MattdewT/KE3/Grafik Abschätzung Gweichtskraft.jpg

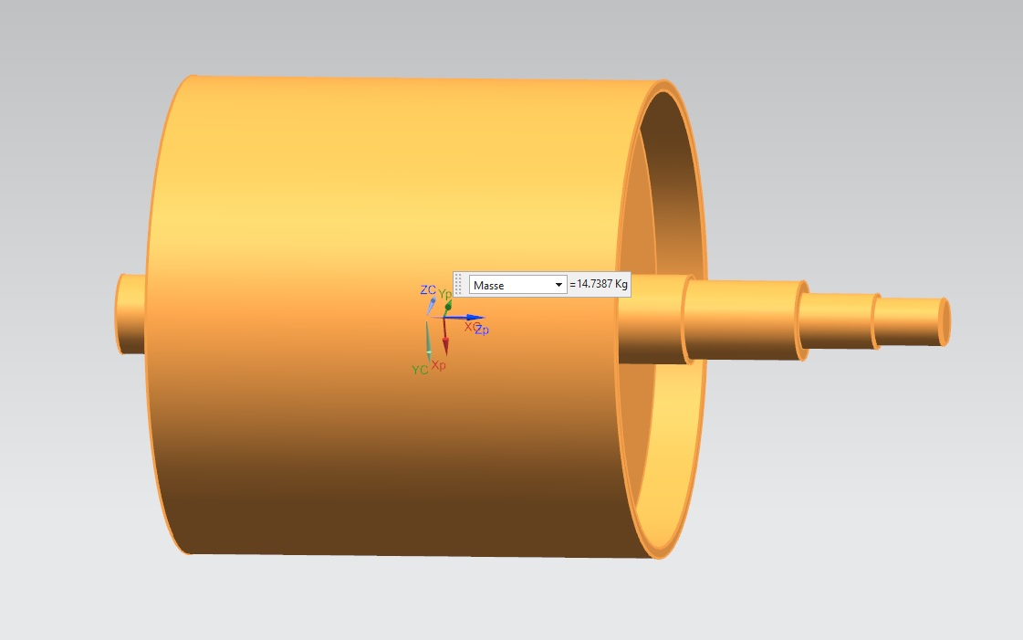
Grafik Abschätzung Gweichtskraft.jpg
