MattdewT/KE3/IMG_20191128_125835.jpg

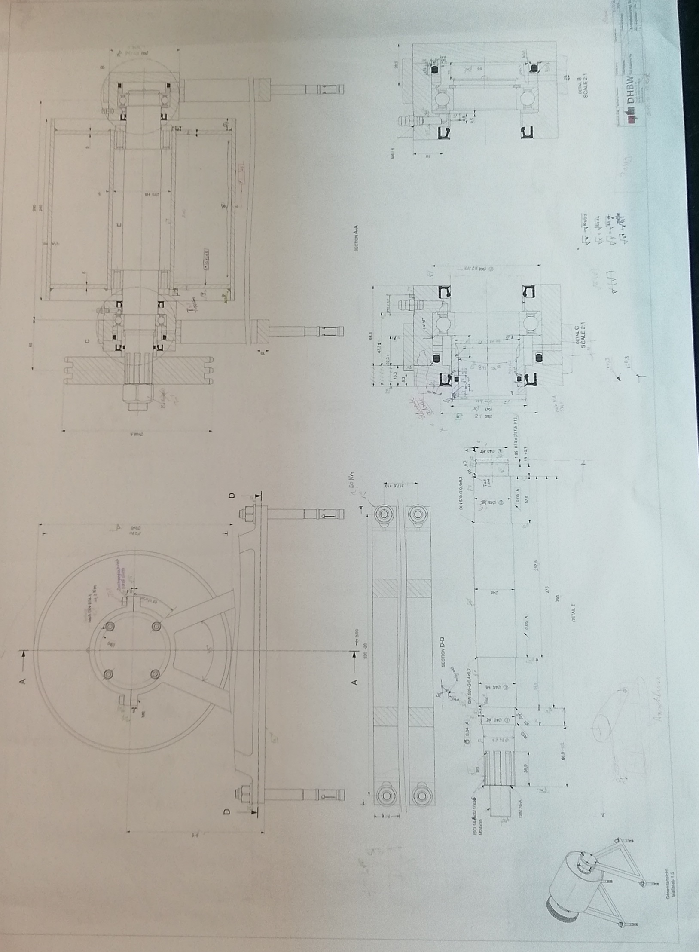
IMG_20191128_125835.jpg
