MattdewT/KE3/Datenblatt.docx

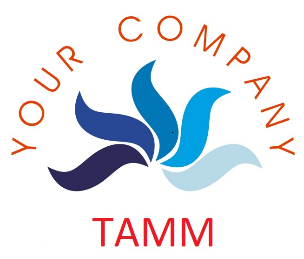
[picture p33: figure]

Antriebsrolle für Förderbänder

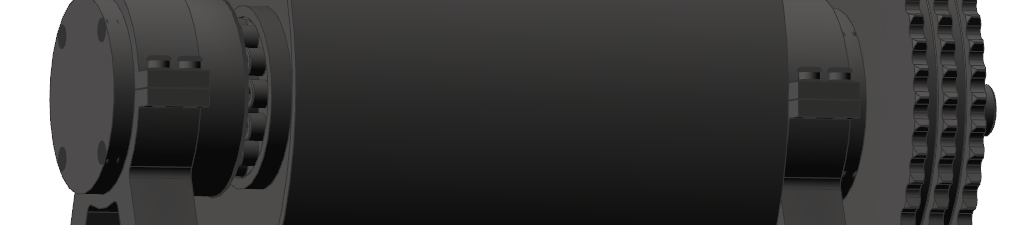
[picture p34: figure]

Kompakt. Leicht. Preiswert.

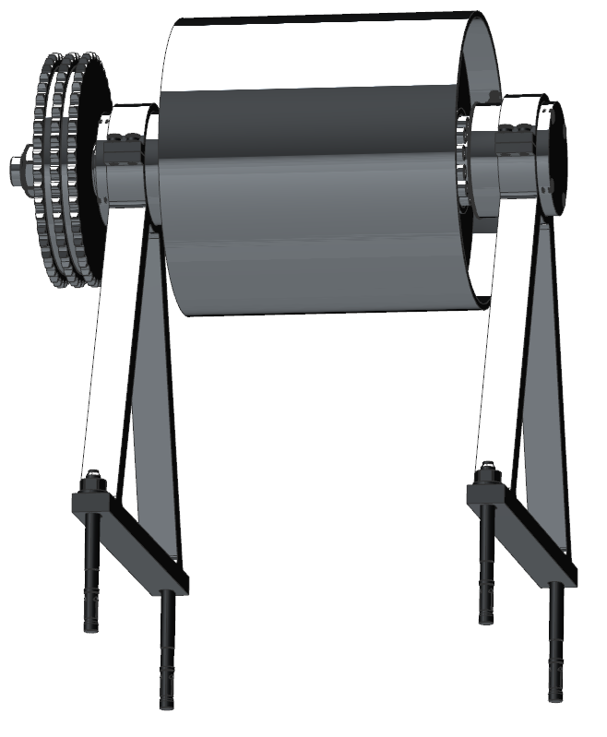
[picture p35: figure]

Antriebsrolle

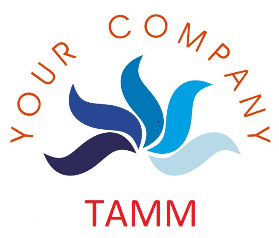
[picture p36: figure]

Eigenschaften

Die Antriebsrolle ist als Variante verfügbar, bei welcher die Verbindung zwischen Welle und Trommel geschweißt ist an und als Variante, bei der die Verbindung zwischen Welle und Trommel über einen Spannpressverband realisiert wird.

Der Antrieb erfolgt durch einen Getriebemotor und die Übersetzung auf die Antriebswelle erfolgt über einen Dreifach-Kettentrieb.

Explosionsansicht

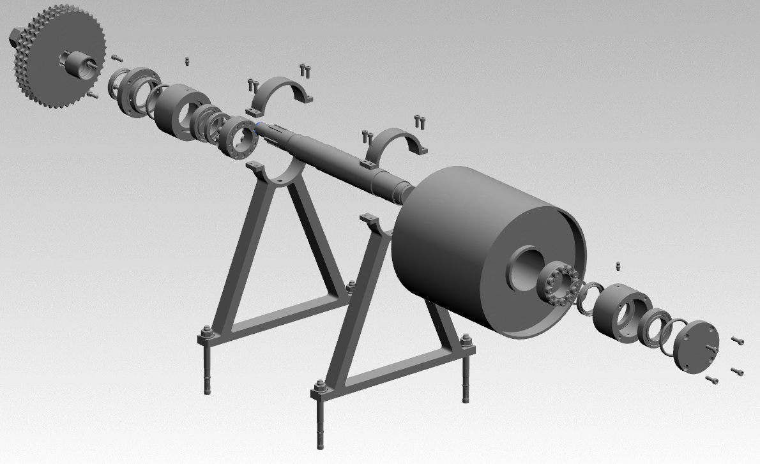
[picture p37: figure]

Technische Daten
Fördererbreite B | 240 mm
Höhe der Antriebstrommel | Mindestens 300mm
Antrieb | Drehstrom
| Drehzahl n=80 1/min
| Dreifach-Kettentrieb
Stromverbrauch | 4kWh | Netzbetrieb
Schmierung | Fett | Kompletter Fettwechsel möglich
Lebensdauer | Mind. 30000h
Motorausrichtung | 45°-Winkel zum Band | Standardmäßig außen, auf Wunsch auch innen
Produkt Gewicht | M = 37,736kg für Spannpressverband, M = 34,738kg für Schweißkonstruktion
Motor | Stufenloser Getriebemotor

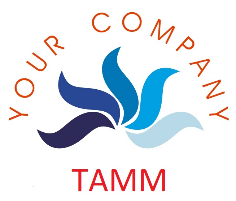
[picture p38: figure]

Marienstraße 20
89518 Heidenheim

www.TAMM-group.com

info@TAMM-group.com
