MattdewT/KE3/Grafiken.pptx

## Slide 2

LI=65

LII=160

LIII=65

LIV=65

FAY

FBY

FKY

y

x

FZUG1

FZUG2

## Slide 3

FS1

R = 120

FK

r = 92

z

y

FS2

## Slide 4

LI=65

LII=160

LIII=65

LIV=65

Z

x

FAZ

FG

FG

FBZ

FKZ

## Slide 5

LI=65

T1=0Nm

LII=160

T2=120Nm

LIII=65

LIV=65

T3=T4=
240Nm

## Slide 6

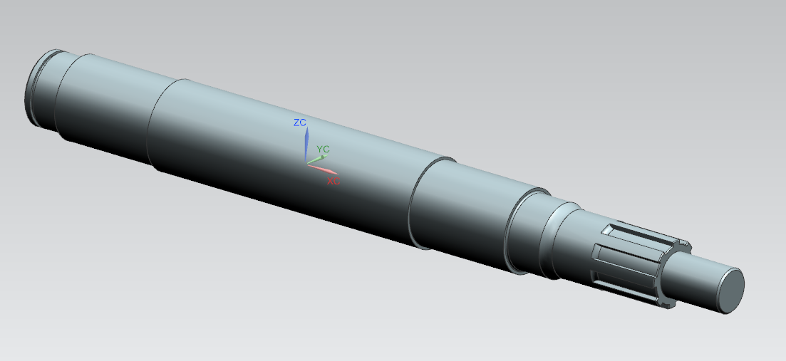
[picture p39: figure]

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
## Slide 7

80mm

φ

0,15mm

## Slide 8

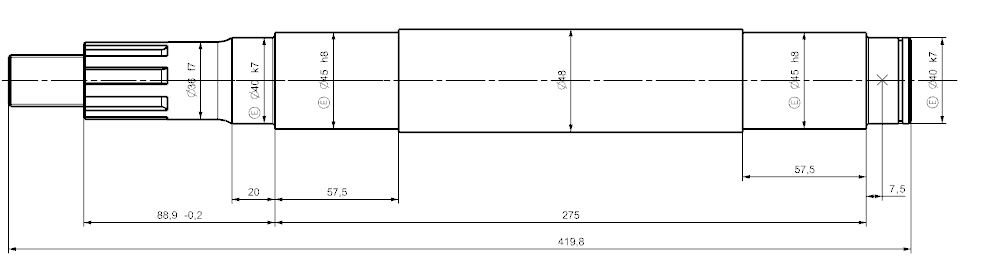
[picture p40: figure]

A

## Slide 9

LI=65

LII=160

LIII=65

LIV=65

III

IV

I

II

## Slide 10

LI=65

LII=160

LIII=65

LIV=65

I

II

III

IV

## Slide 11

Motorwelle
Passfeder
Motorkettenrad
Dreifachrollenkette
Wellenkettenrad
Keilwelle
Welle
Schweißverbindung
Spannpressverband
äußere Schweißnaht
Trommel
