MattdewT/KE3/Kerbzahlberechnung.docx

Kerbzahlberechnung

Kerbstelle 1 (links von A), Sicherungsringnut (DIN 471 - 40 x 1,75),

s=-7,5

d=37,5mm

D=40mm

s_(Sicherungsring) =1,75mm

t=(D-d)/2=1,25mm

ϱ≈0,1s=0,175mm

Formzahl α_(k,b) für Biegung nach Decker Tab. 15.3

α_(k,b) =1,14+1,08√((10t)/(s_(Sicherungsring)))=1,14+1,08√((10∙1,25mm)/(1,75mm))

α_(k,b) =4,03

Formzahl α_(k,t) für Torsion nach Decker Tab. 15.3

α_(k,t) =1,48+0,45√((10t)/(s_(Sicherungsring)))=1,48+0,45√((10∙1,25mm)/(1,75mm))

α_(k,t) =2,68

Bezogenes Spannungsgefälle in Strängen mit Biegebeanspruchung (Decker Formel 15.12)

Bei Scharfkantige Kerben wird χ=0,25 gewählt.

χ=4/(D+d)+2/ϱ

=4/(40+37,5)+2/(0,25)

χ=8,05

Stützziffer η_χ nach Siebel mit Re=650N/(mm^2) (Decker Bild 15.12)

⇒ η_(χBiegung) =1,24

Bezogenes Spannungsgefälle in Strängen mit Torsionsbeanspruchung (Decker Formel 15.13)

χ=4/(D+d)+1/ϱ

=4/(40+37,5)+1/(0,25)

χ= 4,05

Stützziffer η_χ nach Siebel mit Re=650N/(mm^2) (Decker Bild 15.12)

⇒ η_(χTorsion) = 1,19

Kerbwirkungszahl βk,b nach Decker Formel 15.14

β_(k,b) =(α_(k,b))/(η_(χBiegung))=(4,03)/(1,24)

β_(k,b) =3,25

Kerbwirkungszahl βk,t nach Decker Formel 15.14

β_(k,t) =(α_(k,t))/(η_(χTorsion))=(2,68)/(1,19)

β_(k,t) =2,25

Kerbstelle 2 (Übergang Lager A)

s=7,5mm

r=0,8

d=40mm

D=45mm

t=(D-d)/2=2,5mm

Formzahl α_(k,b) für Biegung nach Decker Tab. 1.13

α_(k,b) =(1+1)/(√(0,62r/t+11,6r/d(1+2r/d)^2 +0,2(r/t)^3 d/D))

α_(k,b) =(1+1)/(√(0,62(0,8)/(2,5)+11,6(0,8)/40(1+2(0,8)/40)^2 +0,2((0,8)/(2,5))^3 40/45))

α_(k,b) = 2,96

Formzahl α_(k,t) für Biegung nach Decker Tab. 1.13

α_(k,t) =(1+1)/(√(3,4r/t+38r/d(1+2r/d)^2 +1,0(r/t)^2 d/D))

α_(k,t) =(1+1)/(√(3,4(0,8)/(2,5)+38(0,8)/40(1+2(0,8)/40)^2 +1,0((0,8)/(2,5))^2 40/45))

α_(k,t) = 1,89

Bezogenes Spannungsgefälle in Strängen mit Biegebeanspruchung (Decker Formel 15.12)

χ=4/(D+d)+2/ϱ

=4/(45+40)+2/(0,8)

χ=2,55

Stützziffer η_χ nach Siebel mit Re=650N/(mm^2) (Decker Bild 15.12)

⇒ η_(χBiegung) =1,15

Bezogenes Spannungsgefälle in Strängen mit Torsionsbeanspruchung (Decker Formel 15.13)

χ=4/(D+d)+2/ϱ

=4/(45+40)+1/(0,8)

χ=1,30

Stützziffer η_χ nach Siebel mit Re=650N/(mm^2) (Decker Bild 15.12)

⇒ η_(χTorsion) =1,10

Kerbwirkungszahl βk,b nach Decker Formel 15.14

β_(k,b) =(α_(k,b))/(η_(χBiegung))=(2,96)/(1,15)

β_(k,b) =2,57

Kerbwirkungszahl βk,t nach Decker Formel 15.14

β_(k,t) =(α_(k,t))/(η_(χTorsion))=(1,89)/(1,30)

β_(k,t) =1,45

Kritischer Querschnitt 3 (Absatz als Anlagefläche der Seitenwand ) Freistich

Wegen Spannsatz wird Freistichform G gewählt.

r = 0,4

f = 0,9

d=45mm

D=48mm

s=65mm

Formzahlen aus Decker Tab.15.3 Nr.7

α_(kb) =1,7

α_(kt) =1,4

Bezogenes Spannungsgefälle in Strängen mit Biegebeanspruchung (Decker Formel 15.12)

χ=4/(D+d)+2/ϱ

=4/(48+45)+2/(0,4)

χ=5,04

Stützziffer η_χ nach Siebel mit Re=650N/(mm^2) (Decker Bild 15.12)

⇒ η_(χBiegung) =1,21

Bezogenes Spannungsgefälle in Strängen mit Torsionsbeanspruchung (Decker Formel 15.13)

χ=4/(D+d)+2/ϱ

=4/(48+45)+1/(0,4)

χ=2,54

Stützziffer η_χ nach Siebel mit Re=650N/(mm^2) (Decker Bild 15.12)

⇒ η_(χTorsion) =1,15

Kerbwirkungszahl βk,b nach Decker Formel 15.14

β_(k,b) =(α_(k,b))/(η_(χBiegung))=(1,7)/(1,21)

β_(k,b) =1,40

Kerbwirkungszahl βk,t nach Decker Formel 15.14

β_(k,t) =(α_(k,t))/(η_(χTorsion))=(1,4)/(1,15)

β_(k,t) =1,21

Kritischer Querschnitt 4 (Mitte zwischen den beiden Lagern)

s=145mm

d=48mm

Keine Kerbwirkung, da glatte Welle

α_(k,b) =α_(k,t) =β_(k,b) =β_(k,t) =1

Kritischer Querschnitt 5 (Absatz als Anlagefläche der Seitenwand)

s=225mm

d=45mm

Kerbzahlen entsprechen denen des Kritischen Querschnitt 3, da dieselbe Geometrie vorliegt

α_(k,b) =1,7

α_(k,t) =1,4

β_(k,b) =1,40

β_(k,t) =1,21

Kritischer Querschnitt 6 (Übergang Lager B)

s=282,5mm

Kerbzahlen entsprechen denen des Kritischen Querschnitt 2, da dieselbe Geometrie vorliegt

α_(k,b) =2,96

α_(k,t) =1,89

β_(k,b) =2,57

β_(k,t) =1,45

Kritischer Querschnitt 7 (Übergang Keilwelle)

s=302,5mm

d=34mm

D=40mm

ϱ=3mm

t=(D-d)/2=3mm

Formzahl α_(k,b) für Biegung nach Decker Tab. 1.13

α_(k,b) =(1+1)/(√(0,62r/t+11,6r/d(1+2r/d)^2 +0,2(r/t)^3 d/D))

α_(k,b) =(1+1)/(√(0,623/3+11,63/34(1+23/34)^2 +0,2(3/3)^3 34/40))

α_(k,b) = 1,35

Formzahl α_(k,t) für Biegung nach Decker Tab. 1.13

α_(k,t) =(1+1)/(√(3,4r/t+38r/d(1+2r/d)^2 +1,0(r/t)^2 d/D))

α_(k,t) =(1+1)/(√(3,43/3+383/34(1+23/34)^2 +1,0(3/3)^2 34/40))

α_(k,t) =0,67

Bezogenes Spannungsgefälle in Strängen mit Biegebeanspruchung (Decker Formel 15.12)

χ=4/(D+d)+2/ϱ

=4/(40mm+34mm)+2/(12mm)

χ=0,22

Stützziffer η_χ nach Siebel mit Re=650N/(mm^2) (Decker Bild 15.12)

⇒ η_(χBiegung) =1,05

Bezogenes Spannungsgefälle in Strängen mit Torsionsbeanspruchung (Decker Formel 15.13)

χ=4/(D+d)+1/ϱ

=4/(40mm+34mm)+1/(12mm)

χ= 0,14

Stützziffer η_χ nach Siebel mit Re=650N/(mm^2) (Decker Bild 15.12)

⇒ η_(χTorsion) =1,02

Kerbwirkungszahl βk,b nach Decker Formel 15.14

β_(k,b) =(α_(k,b))/(η_(χBiegung))=(1,35)/(1,05)

β_(k,b) =4

Kerbwirkungszahl βk,t nach Decker Formel 15.14

β_(k,t) =(α_(k,t))/(η_(χTorsion))=()/(1,02)

β_(k,t) =3,53

Kritischer Querschnitt 8 (Keilwellen Beginn)

Nach Decker, Tab. 15.3 gelten für eine Keilwelle folgende Formzahlen:

s=322,5mm

α_(k,b) =4,2

α_(k,t) =3,6

d=28mm

D=34mm

ϱ=0,25mm

Bezogenes Spannungsgefälle in Strängen mit Biegebeanspruchung (Decker Formel 15.12)

χ=4/(D+d)+2/ϱ

=4/(34mm+28mm)+2/(0,25mm)

χ=8,06

Stützziffer η_χ nach Siebel mit Re=650N/(mm^2) (Decker Bild 15.12)

⇒ η_(χBiegung) =1,24

Bezogenes Spannungsgefälle in Strängen mit Torsionsbeanspruchung (Decker Formel 15.13)

χ=4/(D+d)+1/ϱ

=4/(34mm+28mm)+1/(0,25mm)

χ= 4,06

Stützziffer η_χ nach Siebel mit Re=650N/(mm^2) (Decker Bild 15.12)

⇒ η_(χTorsion) =1,19

Kerbwirkungszahl βk,b nach Decker Formel 15.14

β_(k,b) =(α_(k,b))/(η_(χBiegung))=(4,2)/(1,24)

β_(k,b) =3,39

Kerbwirkungszahl βk,t nach Decker Formel 15.14

β_(k,t) =(α_(k,t))/(η_(χTorsion))=(3,6)/(1,19)

β_(k,t) =3,03

→Wahl einer anderen Keilwelle mit größerem tragendem Querschnitt!!!

DIN ISO 14 Leichte Reihe, 8x32x36, Wahl eines anderen Werkstoffes mit höherer Festigkeit, Beginn des Keilwellenabschnitts weiter von Lager A entfernt

Nach Decker, Tab. 15.3 gelten für eine Keilwelle folgende Formzahlen:

s=332,5mm

α_(k,b) =4,2

α_(k,t) =3,6

d=32mm

D=36mm

ϱ=0,25mm

Bezogenes Spannungsgefälle in Strängen mit Biegebeanspruchung (Decker Formel 15.12)

χ=4/(D+d)+2/ϱ

=4/(36mm+32mm)+2/(0,25mm)

χ=8,06

Stützziffer η_χ nach Siebel mit Re=960N/(mm^2) (Decker Bild 15.12)

⇒ η_(χBiegung) =1,09

Bezogenes Spannungsgefälle in Strängen mit Torsionsbeanspruchung (Decker Formel 15.13)

χ=4/(D+d)+1/ϱ

=4/(36mm+32mm)+1/(0,25mm)

χ= 4,06

Stützziffer η_χ nach Siebel mit Re=960N/(mm^2) (Decker Bild 15.12)

⇒ η_(χTorsion) =1,08

Kerbwirkungszahl βk,b nach Decker Formel 15.14

β_(k,b) =(α_(k,b))/(η_(χBiegung))=(4,2)/(1,09)

β_(k,b) =3,85

Kerbwirkungszahl βk,t nach Decker Formel 15.14

β_(k,t) =(α_(k,t))/(η_(χTorsion))=(3,6)/(1,08)

β_(k,t) =3,33

Kerbstelle 9 (Keilwelle-Gewinde)

Keine Torsion und keine Biegung vorhanden. Deshalb wird Kerbstelle 8 nicht berücksichtigt.
