MattdewT/KE3/Wellen Berechnung.docx

## Wellen Berechnung

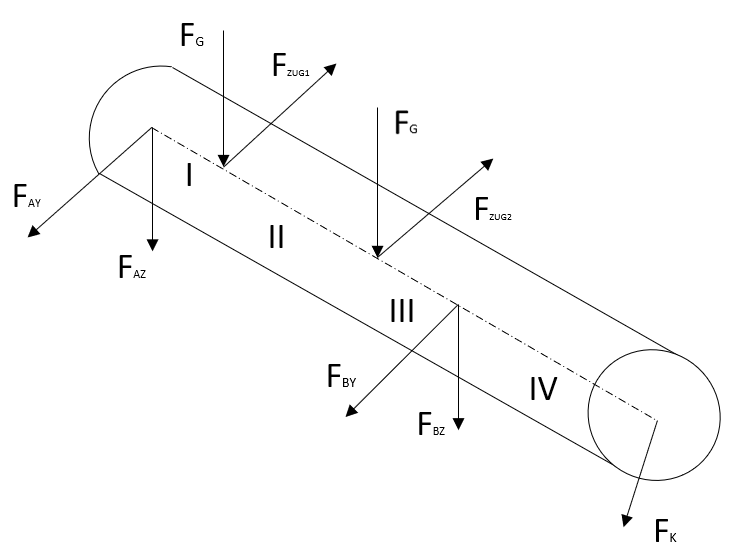
[picture p41: figure]

Berechnung der Kräfte von der Trommel:

F_(ZUG1/2) =(F_(S1) -F_(S2))/2

F_(ZUG1/2) =(3500N-1500N)/2=2500N

Berechnung der Kettenkräfte in Y- und Z-Richtung:

F_(KY) =sinα*F_K

F_(KY) =sin45°*2608,7N=1844,6N

Da α=45° ist, ist F_(KY) =F_(KZ) =1844,6N .

Berechnungen in der X-Y-Ebene

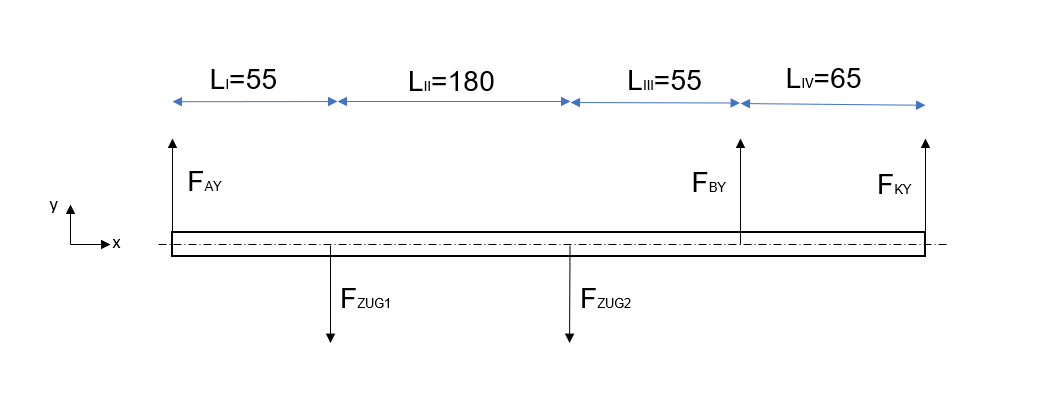
[picture p42: figure]

Berechnung von F_(BY) über Momenten Gleichung:

∑ M=0

Es wird nach links um das Lager A gedreht:

A: F_(ZUG1) *l_I +F_(ZUG2) *l_(I+II) -(F_(BY) *l_(I+II+III) )-(F_(KY) *l_(I+II+III+IV) )=0

F_(BY) =(F_(ZUG1) *55mm+F_(ZUG2) *230mm-(F_(KY) *355))/(290mm)

F_(BY) =(2500N*55mm+2500N*235mm-(1844,6N*355mm))/(290mm)

F_(BY) =242N

Berechnung von F_(AY) über Kräfte Gleichgewicht:

∑ F_Y =0

Kräftegleichgewicht soll nach oben (nach Skizze) wirken:

↑: -F_(AY) +F_(ZUG1) +F_(ZUG2) -F_(BY) -F_K =0

F_(AY) =F_(ZUG1) +F_(ZUG2) -F_(BY) -F_(KY)

F_(AY) =2500N+2500N-242N-1844,6N

F_(AY) =2913,4N

Biegemomente in der x-y-Ebene

Bereich I: 0 ≤ s1 ≤ 55mm

M_(b1) =F_(AY) ∙s_1

M_(b1) (0)=0Nm

M_(b1) (55mm)=2913,4N∙55mm=160,24Nm

Bereich II: 0 ≤ s2 ≤ 180mm

M_(b2) =F_(AY) ∙(l_I +s_2 )-F_(ZUG1) ∙s_2

M_(b2) (0)=2913,4N∙(55mm+0mm)=160,24Nm

M_(b2) (180mm)=2913,4N∙(55mm+180mm)-2500N∙180mm=234,65N

Bereich III (von rechts): 0 ≤ s3 ≤ 65mm

M_(b3) =-F_(KY) ∙s_3

M_(b3) (65mm)=-1844,6N∙65mm=-119,9Nm

Bereich IV: 0 ≤ s4 ≤ 55mm

M_(b4) =-F_(BY) ∙s-F_(KY) ∙(l_(IV) +s_4 )

M_(b4) (0)=0Nm

M_(b4) (55mm)=-242N∙120mm-1844,6N∙(65mm+120mm)=-234,7Nm

# Torsion

Das durch das Kettenrad eingeleitete Torsionsmoment von 240Nm wird an den Berührungsstellen zwischen Welle und Seitenwänden der Trommel jeweils zu gleichen Teilen wieder abgeleitet. Das auftretende Torisonsmoment ist somit im Bereich IV mit dem vollen Betrag des eingeleiteten Torisonsmomentes anzunehmen (T3=T4=240Nm). Im Bereich zwischen den beiden Seitenwänden beträgt das Torsionsmoment nur noch T3/2=T2=120Nm. Der Bereich zwischen Lager A und der Seitenwand ist torsionsfrei (T1=0).

Torsionsmomentenverlauf:

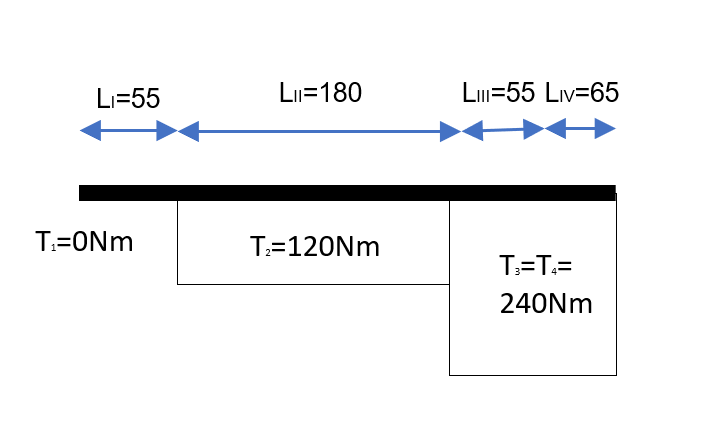
[picture p43: figure]

M_(bmax) =427N M_T =240Nm

Kerbstellen in x-y-Richtung → größte Beanspruchung bei Lager B

M_(bXY) =F_(BY) *10mm+F_(KY) *(l_(IV) +10mm)

M_(bXY) =242N*10mm+1844,6N*(65mm+10mm)=140,8Nm

M_(bXZ) =F_(BZ) *10mm-F_(KZ) *(l_(IV) +10mm)

M_(bXZ) =2258N-1844,6N*(65mm+10mm)

M_(bXZ) =-115,8Nm

M_(bges) =√(M_(bXY)^2 +M_(bXZ)^2)

M_(bges) =√((140,8Nm)^2 +(115,8Nm)^2)=182,23Nm

Vergleichsspannung:

M_V =√(M_(bges)^2 +1/2*M_t) M_t =T∙k_A aus Tabelle

M_V =√((182,2Nm)^2 +1/2*(240Nm∙1,25)^2)=249,01Nm

Festigkeitsnachweis der Kerbwirkung am Lager:

α=1,6 ηK=1,6 σzul=100N/mm² d=40

σ_(max) ≤σ_(zul)

(M_V *32)/(π*d^3)*[(α_K -1)*η_k +1]≤σ_(zul)

77,7N/(mm^2)≤100N/(mm^2)
