MattdewT/KE3/Berechnungen-Anika.docx

Kraft- und Momentenberechnung

( F_(s1) - F_(s2) )∙120mm= F_K ∙92mm

F_K = ((3500N-1500N)∙120mm)/(92mm)

F_K ≈2608,7N

F_(Ky) = F_(Kz) =(F_K)/(√2)=(2608,7N)/(√2)

F_(Ky) = F_(Kz) ≈1844,6 N

M_T =(F_(s1) - F_(s2) )∙120mm= F_K ∙92mm

M_T ≈240,0Nm

Lagerkräfte ohne Berücksichtigung der Gewichtskraft

x-y-Ebene

Moment um Lager A im Uhrzeigersinn: (F_(s1) + F_(s2) )∙145mm- F_(By) ∙290mm-F_(Ky) ∙355mm=0

5000N∙145mm- F_(By) ∙290mm-1844,6N∙355mm=0

F_(By) ≈242,0N

↑ F_(Ay) +F_(By) +F_(Ky) -F_(s1) -F_(s2) =0

F_(Ay) +242,0N+1844,6N-3500N-1500N=0

F_(Ay) ≈2913,4N

x-z-Ebene

Moment um Lager A im Uhrzeigersinn: F_(Bz) ∙290mm-F_(Kz) ∙355mm=0

F_(Bz) ∙290mm-1844,6N∙355mm=0

F_(Bz) ≈ -2258,0N

↑ F_(Az) +F_(Bz) +F_(Kz) =0

F_(Az) +2258,0N+1844,6N=0

F_(Az) ≈413,4N

Zusammenfassung der Lagerkräfte

F_A = √(F_(Ay) ^2 +F_(Az) ^2)=√((2913,4N)^2 +(413,4N)^2)

F_A ≈2942,6N

F_B = √(F_(By) ^2 +F_(Bz) ^2)=√((242,0N)^2 +(-2258,0N)^2)

F_B ≈2270,9N

Schnittgrößen mit Kisssoft

M_(bmax) ≈428Nm

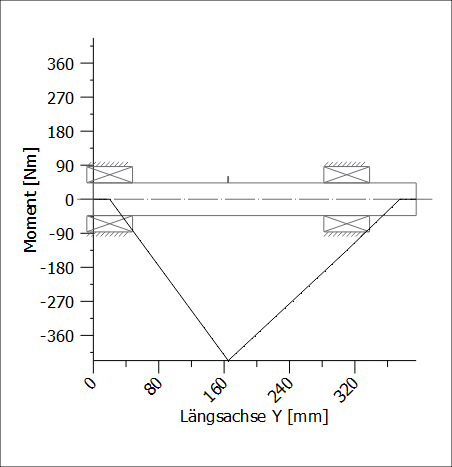
[picture p44: figure]

Keilwellenberechnung

Die Keilwellenberechnung wird nach Decker, Formel 12.3, berechnet.

p…Flankenpressung

F_u …Umfangskraft an der Welle

T…Torsionsmoment

i…Anzahl der Keile am Umfang

h…Keilhöhe

l_T …Traglänge der Verbindung

k…Tragfaktor

Gewählt: DIN ISO 14, mittlere Reihe, 6x28x34, Innenzentrierung, Traglänge 25mm

Flankenpressung

p=(F_u)/(h ∙l_T ∙i ∙k) (Decker, Formel 12.3)

Mit F_u =T/(0,25 (d_1 +d_2 ))=(240Nm)/(0,25 (28mm+34mm))=15,48kN

Mit h=0,5 (d_1 -d_2 )=0,5(34mm-28mm)=3mm

p=(15,48kN)/(3mm ∙25mm ∙6 ∙0,75)

p≈45,9N/(mm^2)

Bei einseitigen starken Stößen und Stahl als Wellenwerkstoff (nach Decker Tab. 12.1):

p_(zul) =0,6p_0 =0,6 ∙150N/(mm^2)=90N/(mm^2)

S=(p_(zul))/p≈2
