MattdewT/KE3/Durchmesser_Berechnung.docx

# Vorauswahl Wellenberechnung

a) Nur Drehmoment/Torsion:

d≥³√(16/π*(T*K_A)/(τ_(tzul)))=31,3mm

b) Mit Biegung

σ_v =√(σ_(bmax)^2 +2*τ_(bmax)^2) mit σ_b =(32*M_b)/(π*d^3)

d≥³√(32/π*(M_V)/(σ_(Vzul))) mit M_V =√(M_(bmax)^2 +0,5*T_(max)^2)

d≥29,95mm

→Anfangswelle Ø40mm Sicherheit ̴ 2
