MattdewT/KE3/Finale/CD/0Projektbericht.pdf

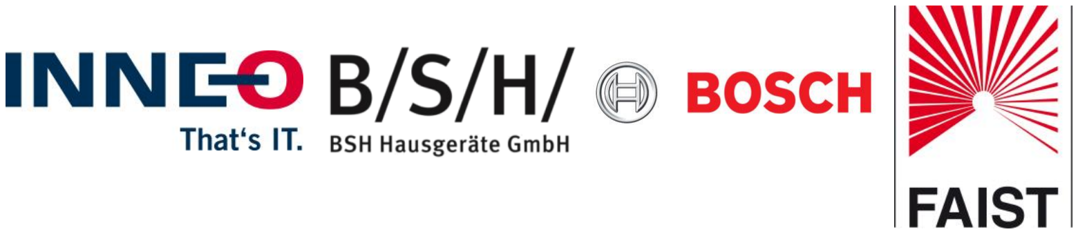
[picture p45: figure]

## Antriebstrommellagerung eines Bandförderers

Konstruktionsentwurf im Fach Konstruktionslehre 3

des Studienganges Maschinenbau

an der Dualen Hochschule Baden-Württemberg Heidenheim an der Brenz

von

Hofmann, Tanja

Hopf, Marie

Langohr, Anika

Tiroch, Matthias

Abgabe: 28. November 2019

Bearbeitungszeitraum | 9 Wochen
Matrikelnummern | 5620331, 3225750, 1790705, 9269794
Kurs | TM 2018 KM
Ausbildungsfirma | INNEO Solutions, BSH, Bosch AS,
| Faist Anlagenbau

Studienbereich Technik
Studiengang Maschinenbau

Name, Vorname
Hofmann, Tanja

Name, Vorname
Hopf, Marie

Name, Vorname
Langohr, Anika

Name, Vorname
Tiroch, Matthias

### Erklärung

gemäß § 5 (3) der „Studien- und Prüfungsordnung DHBW Technik“ vom 01.10.2015.

Ich habe die vorliegende Arbeit selbstständig verfasst und keine anderen als die angegebenen Quellen und Hilfsmittel verwendet.

Ort, Datum | Unterschrift
Ort, Datum | Unterschrift
Ort, Datum | Unterschrift
Ort, Datum | Unterschrift

## Inhaltsverzeichnis

5.4 Nachrechnung der Passfederverbindung zwischen Kettenrad und Motorwelle.......69

## Anhang

1. Aufgabenstellung
2. Handzeichnungen und Skizzen auf Millimeterpapier
3. Projektzeitplan
4. Checkliste
5. Datenblatt
6. Stückliste
7. Gesamtzeichnung
8. Kaufteildokumentation

8.1 cog - Das O-Ring 1x1

8.2 fischer - Betonanker

8.3 Mädler - Kettenrad

8.4 Mädler - Spannsatz

8.5 Mädler - Tropföler

8.6 NORD - Motor

8.7 norelem - Schmiernippel

8.8 Würth - Gewindestift

8.9 Würth - Sicherheitsmutter

9. Schnittgrößenberechnung mit Excel

10.Ergebnisse der Wellenberechnung mit Excel

11.Smith-Diagramme für 42CrMo4, 16NiCrS4 und E295

12.Wellendurchbiegung mit Decker-Programm

## 1 Einleitung

Bandförderer, umgangssprachlich auch Förderbänder genannt, übernehmen in

Produktionsprozessen eine wichtige Rolle. Stetigförderer sorgen dafür, dass Roh- oder

Fertigteile auch über weite Distanzen und in hoher Stückzahl zum nächsten

Bearbeitungsschritt transportiert werden können. Eine zentrale Rolle nimmt die

Antriebstrommel ein. Deshalb soll in der folgenden Arbeit eine Antriebstrommel mit

Lagerung entwickelt werden, die speziell an die vorgegebenen Bedürfnisse angepasst

ist (siehe Anforderungsliste).

Die Antriebstrommellagerung des Bandförderers wird auf der Basis exakter

Auslegungsrechnungen konstruiert und mit gängigen Referenzwerten auf die

Haltbarkeit | bei | dynamischer | Belastung | geprüft. | Die | Visualisierung | der

Antriebstrommellagerung ist einer ausführlichen CAD-Datei mit passender Stückliste

zu entnehmen.

Im Anhang sind außerdem die ausgedruckten Excel-Berechnungen zu finden. Die auf

der CD gespeicherten Excel-Dateien sind interaktiv angelegt und können vom

kritischen Betrachter nochmals mithilfe der Buttons durchgerechnet werden.

### 1.1 Anforderungsliste

In der folgenden Anforderungsliste werden alle Forderungen und Wünsche an die

Antriebstrommel aufgeführt. Diese Zusammenstellung dient dazu, eine übersichtliche

Darstellung der geforderten Randbedingungen zu bekommen.

Hauptmerkmal | Anforderung / Spezifikation
(Zahlen, Daten, Fakten) | von wem | Klassifizierung
Trommelaußendurchmesser | DT=240mm | Frau Hopf | Forderung
Lagerabstände | l1=l2=145mm, l3=65mm | Frau Hopf | Forderung
Winkel des Kettentriebes | α=45° | Frau Langohr | Forderung
Höhe der Antriebstrommel über dem Boden | mindestens 300mm zwischen Boden und Untertrum | Frau Hofmann | Forderung
Position des Motors | in einer Flucht mit der Bandrichtung, nicht höher als Bandhöhe | Herr Tiroch | Forderung
Kompaktheit | Kettenlänge <1000mm | Frau Langohr | Wunsch
Antriebsenergiequelle | Drehstrom | Frau Langohr | Forderung
Drehzahl der Antriebstrommel | n=80 1/min | Frau Hofmann | Forderung
Kettentrieb | Dreifach-Kettentrieb | Frau Langohr | Forderung
Lagerart | ideal: Magnetlager; sonst Wälzlager, sollen Fluchtungs- und Montagefehler ausgleichen; keine überdimesionierte Lebensdauer (nicht > 60000h) | Frau Hopf | Wunsch/Forderung
Lagerböcke | Ausbrennteile | Herr Tiroch | Forderung
Schmierung der Lager | keine Lebenszeitschmierung, aber Abdichtung der Lagergehäuse | Herr Tiroch | Forderung
Motor | maximal 10kg | Frau Langohr | Wunsch
Antriebstrommel + Welle | maximal 5kg | Frau Hopf | Wunsch
Fett | gleicher Typ wie in allen Anlagen von diesem Hersteller, die bisher ausgeliefert wurden | Herr Tiroch | Forderung
Kompletter Fettwechsel möglich | kein Fettsammelraum auf Lebenszeit | Frau Hopf | Forderung
Geringer Stromverbrauch | <4kWh | Frau Langohr | Wunsch

Lagerung der Welle

Gewicht

Geometrie

Antrieb

Betriebsmittel

Staubige Umgebung | Keine Behinderung der Ketten oder sonstiger Teile durch Staub in der Umgebungsluft | Frau Hopf | Forderung
Keine Tropfenbildung durch Schmierfett | | Frau Hopf | Forderung
Geräuscharm | <70dB | Frau Hofmann | Wunsch
Rostfrei | durch entsprechenden Werkstoff oder Beschichtung | | Wunsch
Außenbetrieb möglich | | Frau Hofmann | Wunsch
Netzbetrieb des Motors | ohne Trafo | Frau Langohr | Wunsch
Temperaturbereich | -10°C bis +40°C | Frau Hofmann | Wunsch
möglichst viele gleichartige Teile verwenden | | Frau Hopf | Wunsch
Aufstellen ohne Wartezeit | kein Einbetonieren der Stützen | Frau Hofmann | Wunsch
Flexibilität | Anlage soll räumlich umbaubar sein, falls nötig | Frau Hopf | Forderung
Transportmaße | max. 800mmx800mmx800mm ohne Motor | Frau Langohr | Wunsch
ohne Motor | maximal 300€ | Frau Hopf | Wunsch
Motor | maximal 800€ | Frau Langohr | Wunsch
nominelle Lebensdauer | L10h=30000h | Herr Tiroch | Forderung
keine extreme Überschreitung der Lebensdauer | L10h>100000h nicht zulässig | Herr Tiroch | Wunsch
Sicherung gegen herunterfallende Teile | Frau Hopf | Forderung
Selbstzentrierendes Band | Herr Tiroch | Wunsch
Sicherung gegen Hineinziehen von Gliedmaßen oder Gegenständen | Frau Hofmann | Forderung

Sicherheit

Lebensdauer

Kosten

Montage

Umgebung und Betriebsbedingungen

### 1.2 Morphologischer Kasten

Da | es | eine | Vielzahl | an | einzelnen | Teilfunktionen | und | anschließenden

Gesamtlösungsprinzipien gibt, wurde ein morphologischer Kasten erstellt. Ziel der

Gegenüberstellung ist, die optimale Kombination der verschiedenen Varianten zu

finden. Die ausgewählte Variante wurde gelb markiert.

Einschalten mit Einhandschalter | Frau Langohr | Forderung
Nothalt mit Fußpedal | Herr Tiroch | Wunsch
Vorstellung erster Entwürfe und Berechnungen | 22.10.2019 | alle | Forderung
Vorstellung der vollständigen Berechnungen und CAD-Zeichnungen | 12.11.2019 | alle | Forderung
Abgabe der vollständigen Dokumentation in Papierform und auf CD | 28.11.2019 | alle | Forderung

Termine

Bedienung

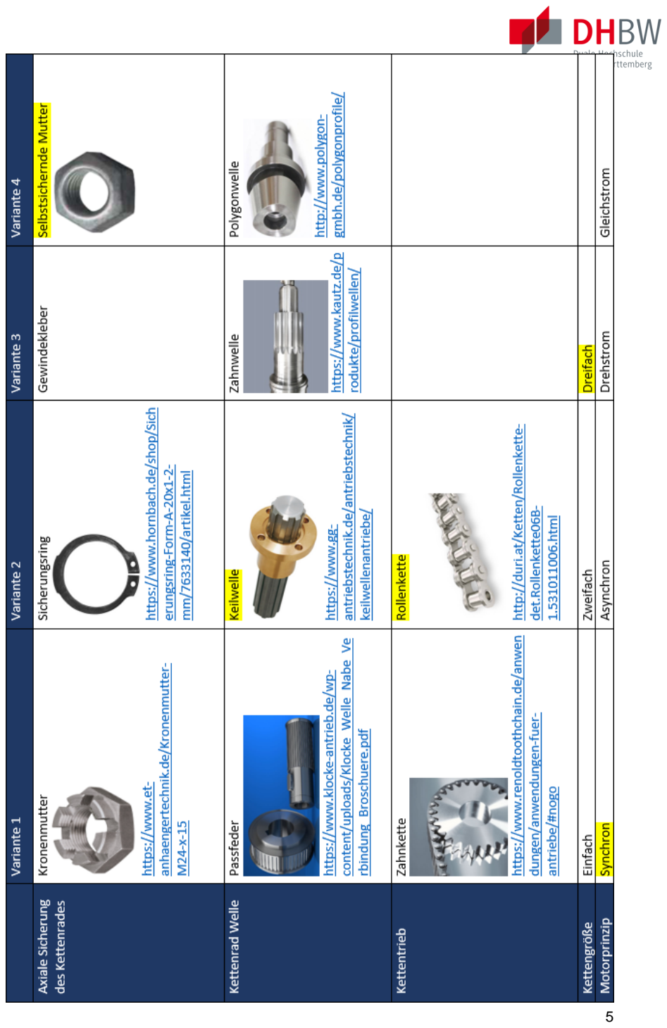
[picture p46: page 9]
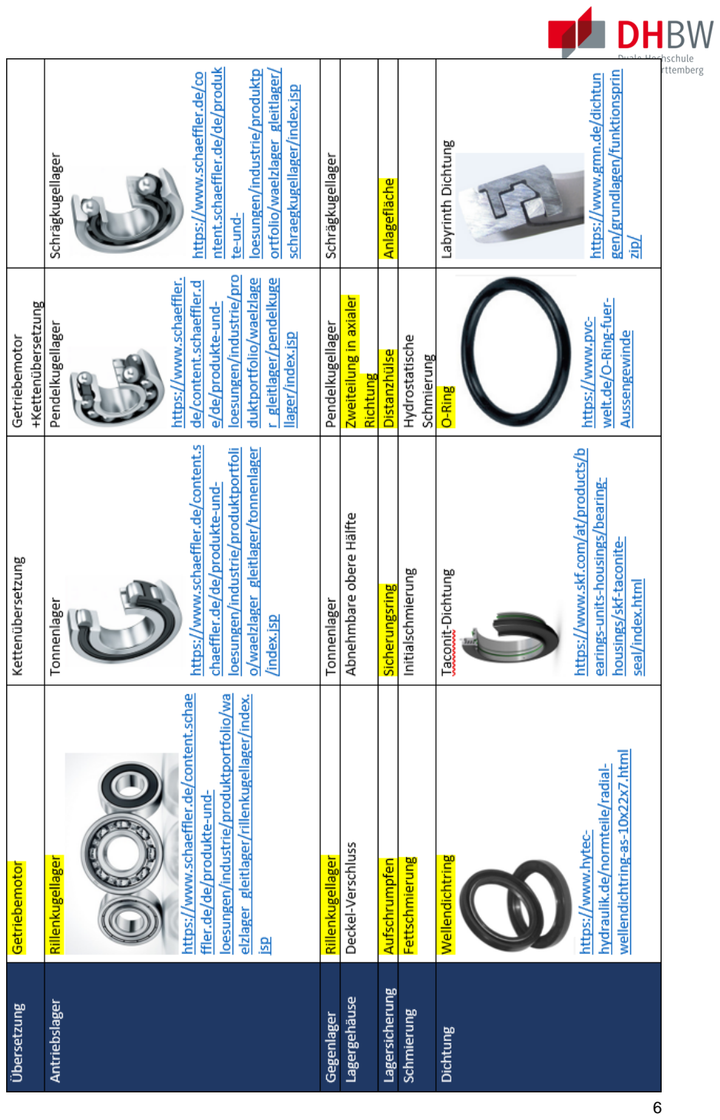
[picture p47: page 10]
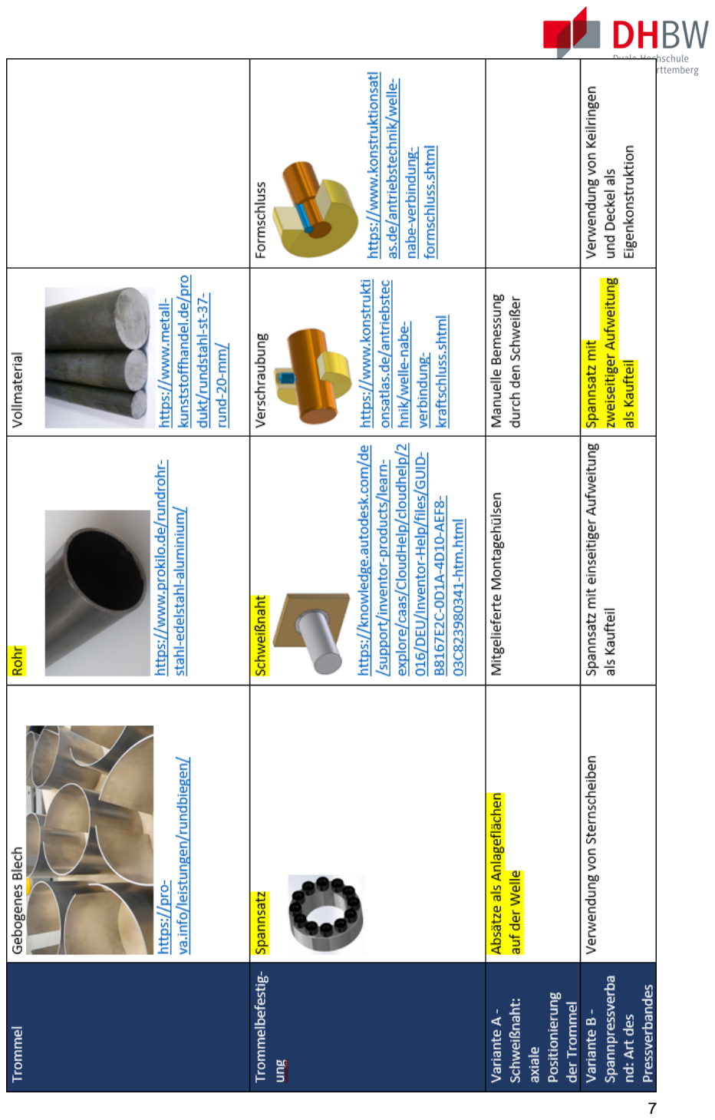
[picture p48: page 11]

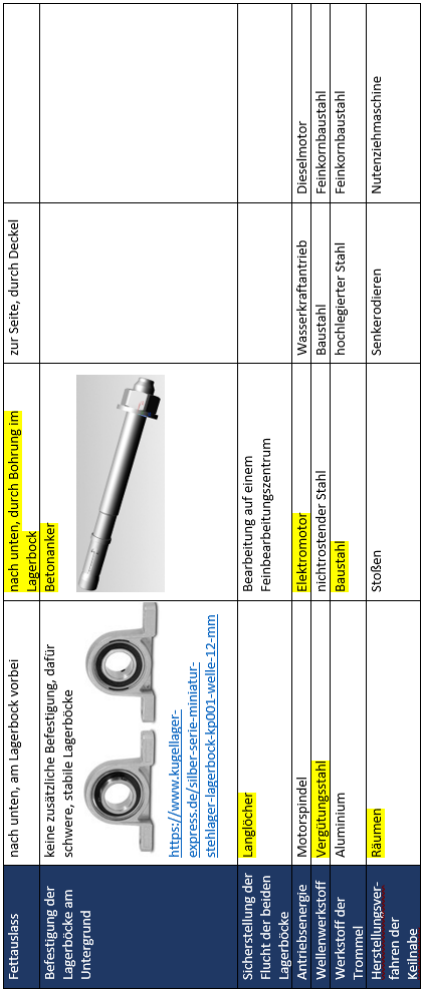
[picture p49: figure]

## 2 Welle

Aus Planungs-, Fertigungs- und Berechnungsgründen sind die Wellen für Variante A und

Variante B geometrisch identisch. Sie sind auch identischen äußeren Kräften ausgesetzt, es

unterscheidet sich lediglich die Stelle, an der der Spannsatz bzw. die Schweißnaht sitzt, durch

die Art der Krafteinleitung.

Die theoretischen Kräfte und die Schnittgrößen der Welle werden von Hand berechnet. Als

Kontrolle dient die in VBA programmierte Exceldatei, welche auf den Formeln nach Decker [2]

basiert.

### 2.1 Kräfte und Momente auf die Welle

Die Kettenkraft kann ermittelt werden durch die Aufstellung eines Momentengleichgewichts in

der Y-Z-Ebene:

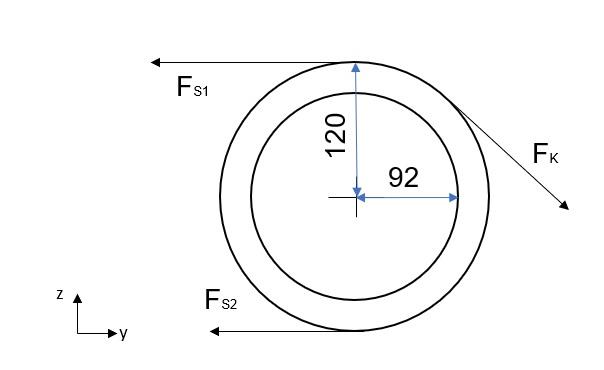
[picture p50: figure]

(Fs1 − Fs2) ∙ 120mm = FK ∙ 92mm

FK =

(3500N − 1500N) ∙ 120mm
92mm

FK ≈ 2608,7N

Das idealisierte Drehmoment beträgt:

MT = (Fs1 − Fs2

) ∙ 120mm = FK ∙ 92mm

MT ≈ 240,0Nm

Mit dem Kettenwinkel von 45° ergibt sich mit dem Satz des Pythagoras:

FKy = FKz =

FK
√2

=

2608,7N
√2
FKy | = | FKz | ≈ 1844,6 N

Die Zugkraft der Kette wird als Punktlast auf die Welle an den beiden Stellen der Seitenwände

angenommen. Dabei addieren sich FS1 und FS2, da sie in die gleiche Richtung zeigen.

FZUG1 = FZUG2 =

FS1 + FS2
2

=

3500N + 1500N
2
FZUG1 | = FZUG2 | = 2500N

Die Gewichtskraft wurde nach der Grobkonstruktion der Welle mit der aufgesetzten Trommel

und den Seitenwänden im CAD-Programm abgeschätzt, indem mit der Analyse-Funktion das

Gesamtgewicht dieser Unterbaugruppe bestimmt wurde. Dies gilt zwar nur für die

Schweißbaugruppe, ist aber eine gute Näherung. Man liegt damit näher an den realen

Bedingungen als mit vollständiger Vernachlässigung der Gewichtskraft.

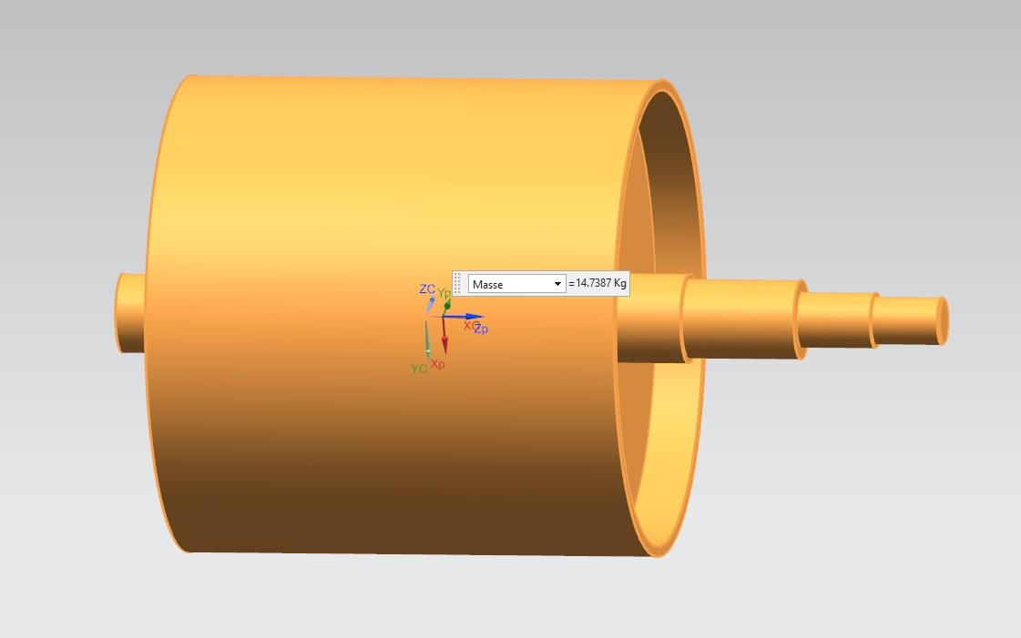
[picture p51: figure]

Daraus ergibt sich eine Gewichtskraft von

FGges = m ∙ g = 14,7387kg ∙ 9,81

m
s

2 = 144,59N

FGges ≈ 146N (wegen der Scℎweißnaℎt, die nocℎ dazukommt)

Die Gewichtskraft teilt sich auf die zwei Angriffspunkte gleichmäßig auf.

FG1 | = FG2 | =

FGges
2

= FG = 73N

### 2.2 Lageplan und Schnittgrößenverlauf der Kräfte

Das Biegemoment wurde von Hand gerechnet und mit dem in VBA programmierten Excel-

Programm überprüft. Der Schnittmomentenverlauf stammt aus diesem Programm. Die

vollständigen Ergebnisse der Excel-Berechnung sind im Anhang zu finden und stimmen mit

den Ergebnissen in den nachfolgenden Abschnitten überein.

### 2.2.1 Querkraftverlauf

Die Lagerkräfte beziehen sich auf die Rechnungen aus 4.1. Die Gewichtskraft wurde im

vorherigen Punkt ermittelt.

x-y-Ebene

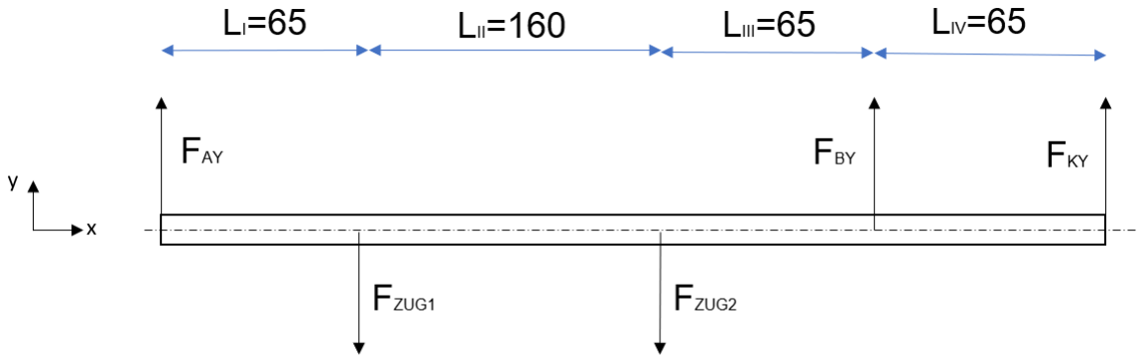
[picture p52: figure]

Bereich I: 0 ≤ s1 ≤ 65mm

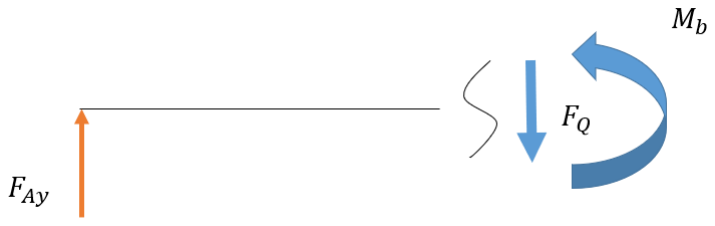
[picture p53: figure]

FQI = FAy

FQI = 2913,4N

Bereich II: 0 ≤ s2 ≤ 160mm


FQII = FAy − Fzug1

FQII = 2913,5N − 2500N

FQII = 413N

Bereich IV: 0 ≤ s4 ≤ 65mm

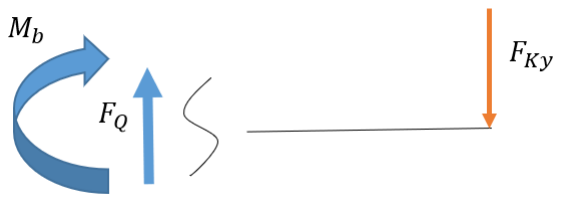
[picture p54: figure]

FQIV = −FKy

FQIV = −1844,6N

Bereich III: 0 ≤ s2 ≤ 65mm


FQIII = FKy + FBy

FQIII = −1844,63N − 242,0N

FQIII = −2086,63N

Der Querkraftverlauf sieht folgendermaßen aus:


z-x-Ebene

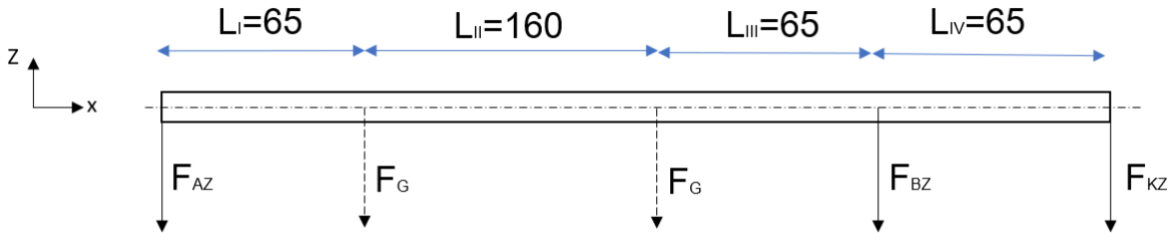
[picture p55: figure]

Bereich I: 0 ≤ s1 ≤ 65mm

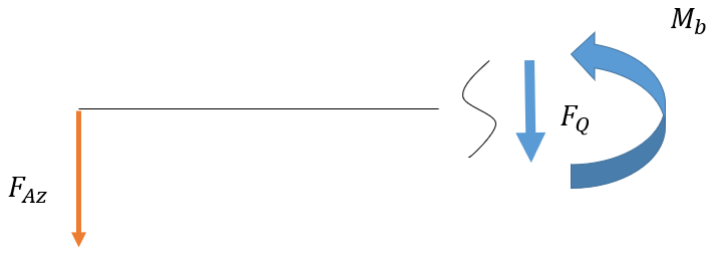
[picture p56: figure]

FQI = −FAz

FQI = −340,4N

Bereich II: 0 ≤ s2 ≤ 160mm

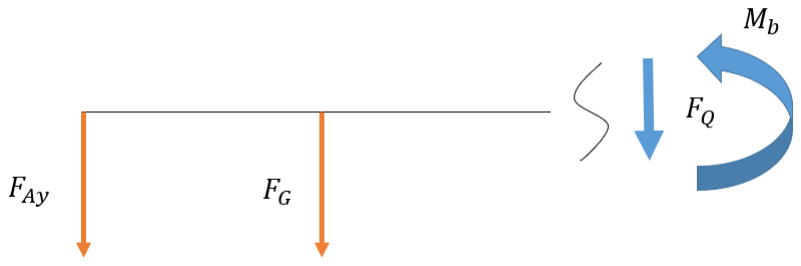
[picture p57: figure]

FQII = −FAz − FG

FQII = −340,4N − 73N

FQII = −413,4N

Bereich IV (von rechts): 0 ≤ s3 ≤ 65mm

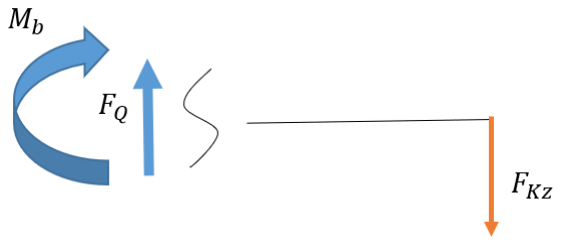
[picture p58: figure]

FQIV = FKz

FQIV = 1844,6N

Bereich III: 0 ≤ s4 ≤ 65mm

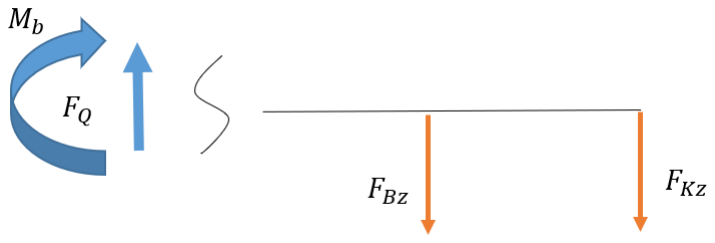
[picture p59: figure]

FQIII = FBz + FKz

FQIII = −2231,0N + 1844,6N

FQIII = −386,4N

Der Querkraftverlauf sieht folgendermaßen aus:

### 2.2.2 Momentenverlauf


Der Momentenverlauf ermittelt den Verlauf der Biegemomente in den einzelnen Abschnitten

und somit an den in 2.3 betrachteten Kerbstellen.

x-y-Ebene

Bereich I: 0 ≤ s1 ≤ 65mm

## Mb1 = FAY ∙ s1

Mb1

(0) = 0Nm

Mb1

## (55mm) = 2913,4N ∙ 65mm = 189,4Nm

Bereich II: 0 ≤ s2 ≤ 160mm

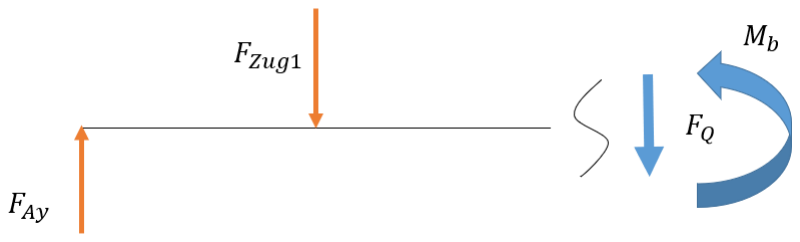
[picture p60: figure]

## Mb2 = FAY ∙ (lI + s2

) − FZUG1 ∙ s2

Mb2

## (0) = 2913,4N ∙ (55mm + 0mm) = 160,24Nm

Mb2

## (180mm) = 2913,4N ∙ (55mm + 160mm) − 2500N ∙ 180mm

= 176,4N

Bereich IV (von rechts): 0 ≤ s3 ≤ 65mm


## Mb3 = −FKY ∙ s3

Mb3

## (65mm) = −1844,6N ∙ 65mm = −119,9Nm

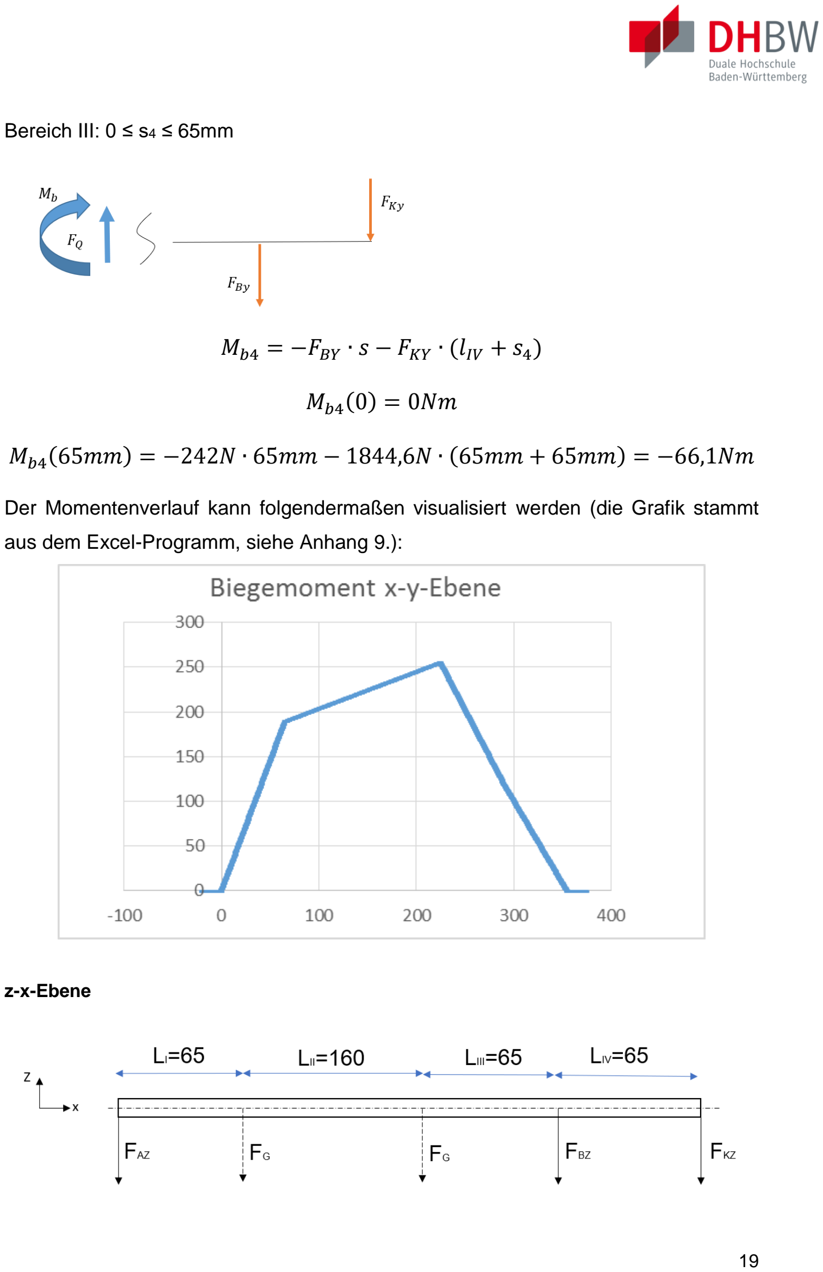
[picture p61: page 23]

Bereich III: 0 ≤ s4 ≤ 65mm

## Mb4 = −FBY ∙ s − FKY ∙ (lIV + s4)

Mb4

(0) = 0Nm

Mb4

## (65mm) = −242N ∙ 65mm − 1844,6N ∙ (65mm + 65mm) = −66,1Nm

Der Momentenverlauf kann folgendermaßen visualisiert werden (die Grafik stammt

aus dem Excel-Programm, siehe Anhang 9.):

z-x-Ebene

Bereich I: 0 ≤ s1 ≤ 65mm

## Mb1 = −FAz ∙ s1

## Mb1 = −340,4N ∙ s1

Mb1

(0) = 0Nm

Mb1

## (65mm) = −22,1Nm

Bereich II: 0 ≤ s2 ≤ 160mm

## Mb2 = −FG ∙ s2 + FAz ∙ (lI + s2

)

Mb2

## (0) = −340,4N ∙ (65mm + 0mm) = −22,1Nm

Mb2

## (160mm) = −73N ∙ 160mm − 315,3N ∙ (65mm + 160mm)

= −82,6Nm

Bereich IV: 0 ≤ s4 ≤ 65mm

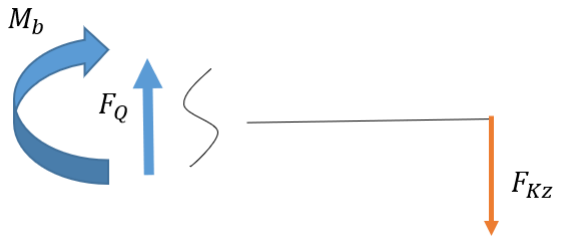
[picture p62: figure]

## Mb4 = −FKz ∙ s4

## Mb4(0) = 0Nm

Mb4

## (65mm) = −1844,6Nm ∙ 65mm = −119,9Nm

Bereich III: 0 ≤ s3 ≤ 65mm

## Mb3 = −FBz ∙ s3 − FKz ∙ (s3 + 65mm)

Mb3

## (o) = −119,9Nm

Mb3

## (55mm) = −94,5Nm

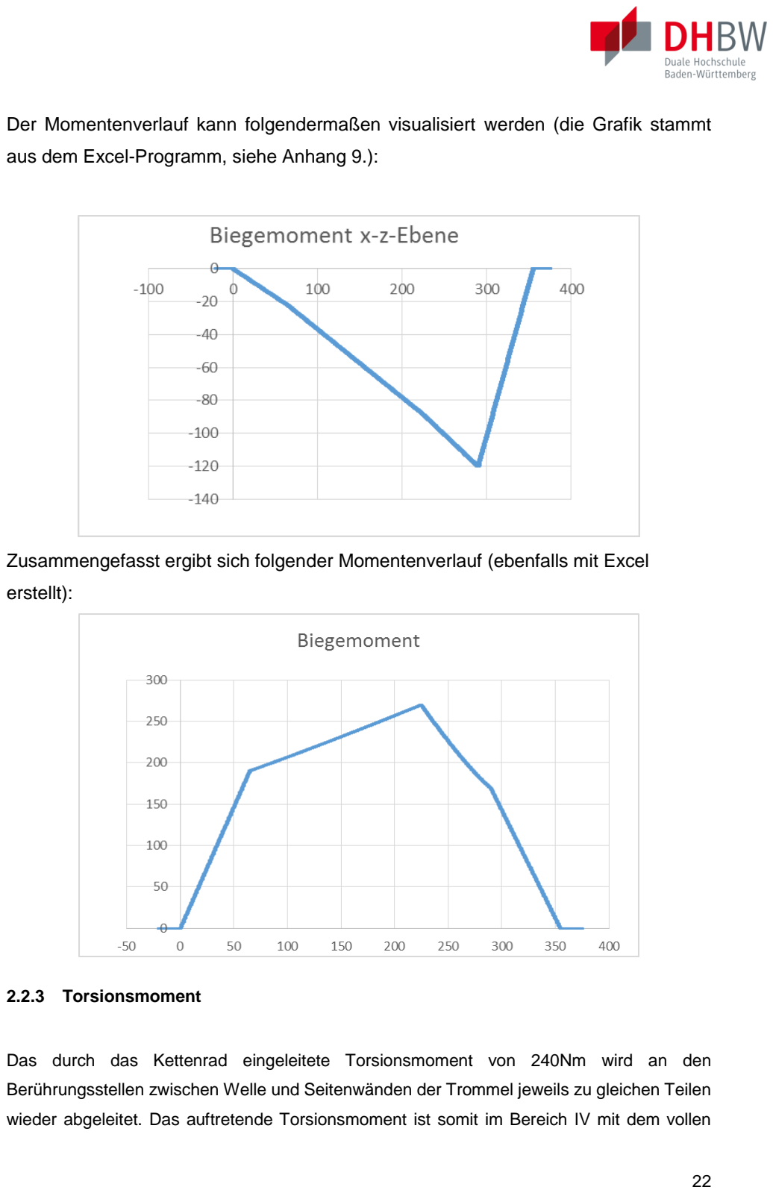
[picture p63: page 26]

Der Momentenverlauf kann folgendermaßen visualisiert werden (die Grafik stammt

aus dem Excel-Programm, siehe Anhang 9.):

Zusammengefasst ergibt sich folgender Momentenverlauf (ebenfalls mit Excel

erstellt):

### 2.2.3 Torsionsmoment

Das durch das Kettenrad eingeleitete Torsionsmoment von 240Nm wird an den

Berührungsstellen zwischen Welle und Seitenwänden der Trommel jeweils zu gleichen Teilen

wieder abgeleitet. Das auftretende Torsionsmoment ist somit im Bereich IV mit dem vollen

Betrag des eingeleiteten Torsionsmomentes anzunehmen (T3=T4=240Nm). Im Bereich

zwischen den beiden Seitenwänden beträgt das Torsionsmoment nur noch T3/2=T2=120Nm.

Der Bereich zwischen Lager A und der Seitenwand ist torsionsfrei (T1=0).

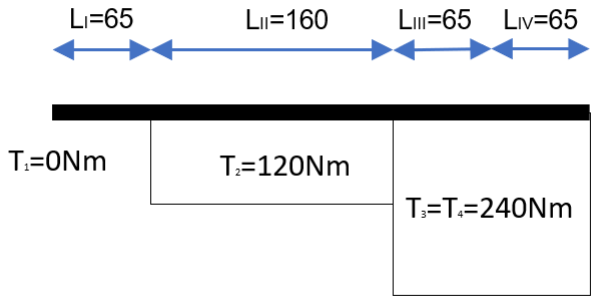
[picture p64: figure]

### 2.3 Überschlagsberechnung und Auswahl des Werkstoffes

Um einen Anhaltspunkt für weitere Berechnungen zu haben, wird der ungefähre Durchmesser der Welle durch Überschlagsrechnung ermittelt. Verwendet wurden die Formeln nach

Steinhilper [5] 4.3 und 4.6. Als Anwendungsfaktor KA ist der Wert 1,25 gewählt, der eigentlich

für Maschinen mit leichten Stößen ausgelegt ist und der deshalb zusätzliche Sicherheit bringt.

Da vorauszusehen ist, dass der vorgeschlagene Werkstoff E295 den Belastungen nicht

standhalten wird, erfolgt die Auslegung sofort mit einem anderen Stahl. Gewählt wird zunächst

ein typischer Wellenwerkstoff, 42CrMo4. Da dieser nicht (oder nur sehr schwer) schweißbar

ist, muss für Variante A auf einen anderen Werkstoff zurückgegriffen werden. Dieser ist

16NiCrS4. Er weist sogar geringfügig höhere Festigkeitswerte auf als 42CrMo4. Es wird die

Variante mit Schwefel gewählt, da sie eine bessere Zerspanbarkeit aufweist. Die

Werkstoffdaten von 16NiCrS4 stammen aus [1], die Wechselfestigkeit wurde mit der

Faustregel σW = 0,45 ∙ Rm berechnet.

Durch das Brünieren der Werkstoffe wird eine schwache Korrosionsbeständigkeit

bereitgestellt. Man kann diese durch darauffolgendes Beölen erhöhen. Durch dieses Verfahren

wird eine hohe Maßhaltigkeit bereitgestellt, da das Brünieren erst nach dem Zusammenbau

erfolgt.

Der Werkstoff ist 42CrMo4, die Werkstoffdaten dafür stammen aus Decker Tabelle 1.8 [3].

a) Nur Drehmoment/Torsion

d ≥ √
16
π

∙

T ∙ KA

τtzul

3
mit τtzul =

τtW
10 =

315
10

N
mm² = 31,5

N
mm²

d ≥ √
16
π

∙

240Nm ∙ 1,25

31,5

N
mm²

3

derf ≥ 36,4mm

b) Mit Biegung

σv = √σbmax
2 | + 2 ∙ τbmax
2 | mit σb =

32∙Mbmax
π∙d³ mit τt =

16 T
π ∙d³

d ≥ √
32
π

∙

MV

σVzul

3

mit MV = √Mbmax
2 | + 0,5 ∙ Tmax
2 | = √(427Nm)
2 + 0,5 ∙ (240Nm)

2 = 459,5Nm

mit σVzul =

σbW
4

=

525
4

N
mm² = 131,25

N
mm²

d ≥ √
32
π

∙

459,5Nm
131,25 N
mm²

3

derf ≥ 32,92mm

→Anfangswelle Ø40mm

### 2.4 Berechnung der kritischen Wellenquerschnitte

Das verwendete Verfahren ist ein vereinfachtes Verfahren nach Decker [2], das aber laut

Beschreibung für die Praxis hinreichend genau ist.

Die Vergleichsspannungen und Sicherheiten wurden mithilfe einer in VBA programmierten

Excel-Tabelle berechnet. Im Folgenden werden die benötigten Form- und Kerbwirkungszahlen

an den Querschnitten 1 bis 9 ermittelt:

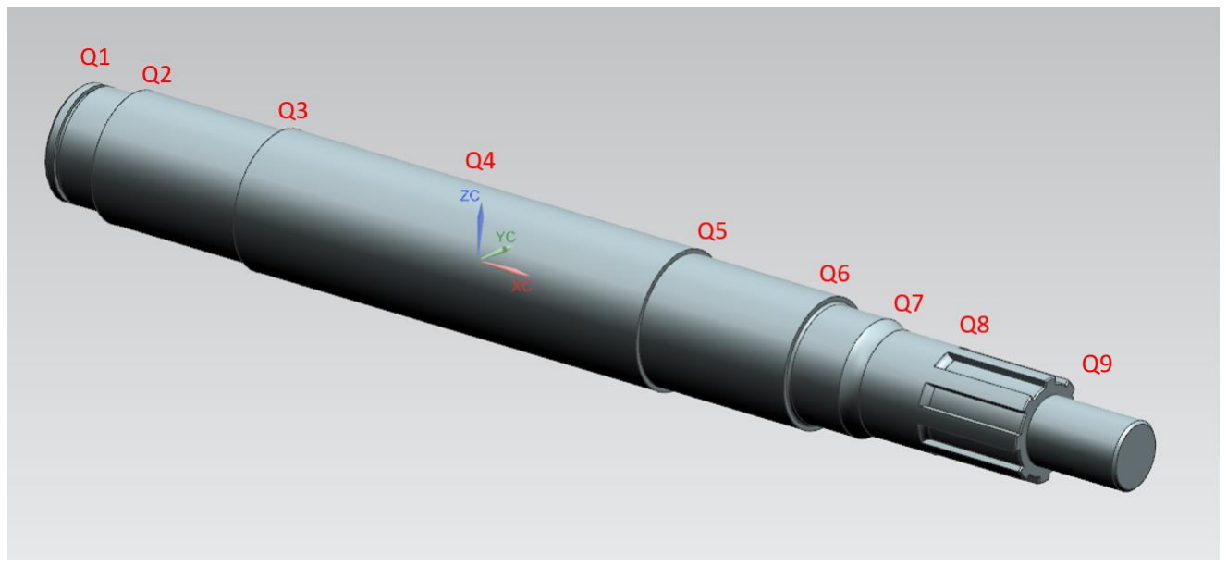
[picture p65: figure]

s bezeichnet jeweils den Abstand der Kerbstelle vom Mittelpunkt des Lagers A nach rechts

laut obiger Ausrichtung.

### 2.4.1 Kerbzahlberechnung nach Decker [2], [3], [4]

χ in [

1
mm

]

Kerbstelle Querschnitt 1 (links von A), Sicherungsringnut (DIN 471 - 40 x 1,75)

Kerbstelle 1 ist als Nut für einen Sicherungsring vorgesehen. Der Sicherungsring drückt von außen auf das Lager und sichert es dadurch.

s = −7,5mm

d = 37,5mm

D = 40mm

sSicℎerungsring = 1,75mm

t =

D − d
2

= 1,25mm

ρ ≈ 0,1s = 0,175mm

Formzahl αk,b für Biegung nach Decker Tab. 15.3

αk,b = 1,14 + 1,08√
10t

sSicℎerungsring

= 1,14 + 1,08√
10 ∙ 1,25mm
1,75mm

αk,b = 4,03

Formzahl αk,t
für Torsion nach Decker Tab. 15.3

αk,t = 1,48 + 0,45√
10t

sSicℎerungsring

= 1,48 + 0,45√
10 ∙ 1,25mm
1,75mm

αk,t = 2,68

Bezogenes Spannungsgefälle in Strängen mit Biegebeanspruchung (Decker Formel 15.12)

Bei scharfkantigen Kerben wird laut Tabelle χ = 0,25 gewählt.

χ = | 4 D + d +

2
ρ
= | 4
40 + 37,5

+

2
0,25

χ = 8,05

Stützziffer ηχ nach Siebel mit Re = 650 N
mm²

für 42CrMo4, Re = 735 N
mm²

für 16NiCrS4 und

Re = 275 N
| mm²

für E295 (Decker Bild 15.12), Kerbwirkungszahl βkB nach Decker Formel 15.14

42CrMo4 ⇒ ηχBiegung = 1,24 ⇒ βk,b =

αk,b

ηχBiegung

=

4,03
1,24

= 3,25

16NiCrS4 ⇒ ηχBiegung = 1,18 ⇒ βk,b =

αk,b

ηχBiegung

=

4,03
1,18

= 3,42

E295 ⇒ ηχBiegung = 1,55 ⇒ βk,b =

αk,b

ηχBiegung

=

4,03
1,55

= 2,60

Bezogenes Spannungsgefälle in Strängen mit Torsionsbeanspruchung (Decker Formel 15.13)

χ =

4
D + d

+

1
ρ

=

4
40 + 37,5

+

1
0,25

χ =4,05

Stützziffer ηχ nach Siebel mit Re = 650 N
mm²

für 42CrMo4, Re = 735 N
mm²

für 16NiCrS4 und

Re = 275 N
mm²

für E295 (Decker Bild 15.12), Kerbwirkungszahl βk,t nach Decker Formel 15.14

42CrMo4 ⇒ ηχTorsion =1,19 ⇒ βk,t =

αk,t

ηχTorsion

=

2,68
1,19

= 2,25

16NiCrS4 ⇒ ηχTorsion = 1,15 ⇒ βk,t =

αk,t

ηχTorsion

=

2,68
1,15

= 2,33

E295 ⇒ ηχTorsion = 1,40 ⇒ βk,t =

αk,t

ηχTorsion

=

2,68
1,40

= 1,91

Kerbstelle Querschnitt 2 (Übergang Lager A)

Der maximal zulässige Radius für die Kugellager laut Hersteller beträgt 1mm. Mit der Toleranz

-0,2mm ergibt sich ein minimaler Radius von 0,8mm. Da dies den schlechtesten Fall für die

Kerbwirkung der Welle darstellt, wird mit ihm gerechnet.

s = 7,5mm

ρ = 0,8mm

d = 40mm

D = 45mm

t =

D − d
2

= 2,5mm

Formzahl αk,b für Biegung nach Decker Tab. 15.4 a)

d
D

=

40
45 ≈ 0,89

ρ
t

=

0,8
2,5

= 0,32

αk,b = 2,65

Formzahl αk,t
für Biegung nach Decker Tab. 15.4 b)

αk,t = 2,2

Bezogenes Spannungsgefälle in Strängen mit Biegebeanspruchung (Decker Formel 15.12)

χ =

4
D + d

+

2
ρ

=

4
45 + 40 +

2
0,8

χ = 2,55

Stützziffer ηχ nach Siebel mit Re = 650 N
mm²

für 42CrMo4, Re = 735 N
mm²

für 16NiCrS4 und

Re = 275 N
mm²

für E295 (Decker Bild 15.12), Kerbwirkungszahl βk,b nach Decker Formel 15.14

42CrMo4 ⇒ ηχBiegung = 1,15 ⇒ βk,b =

αk,b

ηχBiegung

=

2,65
1,15

= 2,30

16NiCrS4 ⇒ ηχBiegung = 1,13 ⇒ βk,b =

αk,b

ηχBiegung

=

2,65
1,13

= 2,35

E295 ⇒ ηχBiegung = 1,31 ⇒ βk,b =

αk,b

ηχBiegung

=

2,65
1,31

= 2,02

Bezogenes Spannungsgefälle in Strängen mit Torsionsbeanspruchung (Decker Formel 15.13)

χ =

4
D + d

+

2
ρ

=

4
45 + 40 +

1
0,8

χ = 1,30

Stützziffer ηχ nach Siebel mit Re = 650 N
mm²

für 42CrMo4, Re = 735 N
mm²

für 16NiCrS5 und

Re = 275 N
mm²

für E295 (Decker Bild 15.12), Kerbwirkungszahl βk,t nach Decker Formel 15.14

42CrMo4 ⇒ ηχTorsion = 1,10 ⇒ βk,t =

αk,t

ηχTorsion

=

2,2
1,10

= 2,20

16NiCrS4 ⇒ ηχTorsion = 1,08 ⇒ βk,t =

αk,t

ηχTorsion

=

2,2
1,08

= 2,04

E295 ⇒ ηχTorsion = 1,24 ⇒ βk,t =

αk,t

ηχTorsion

=

2,2
1,24

= 1,77

Kritischer Querschnitt 3 (Freistich am Absatz als Anlagefläche der Seitenwand)

An Querschnitt 3 liegt der Spannsatz an. Wegen der Pressfläche des Spannsatzes wird

Freistichform G gewählt.

s = 65mm

r = 0,4mm

f = 0,9mm

d = 45mm

D = 48mm

t =

D − d
2

= 1,5mm

Formzahl für Biegung αkb aus Decker Tab.15.4 a) für Freistiche

d
D

=

45
48 ≈ 0,94

ρ
t

=

0,4
1,5

= 0,27

αkb = 3,6

Formzahl für Torsion αkt aus Decker Tab.15.4 b) für Freistiche

αkt = 2,25

Bezogenes Spannungsgefälle in Strängen mit Biegebeanspruchung (Decker Formel 15.12)

χ = | 4 D + d
+

2
ρ
= | 4
48 + 45 +

2
0,4

χ = 5,04

Stützziffer ηχ nach Siebel mit Re = 650 N
mm²

für 42CrMo4, Re = 735 N
mm²

für 16NiCrS5 und

Re = 275 N
| mm²

für E295 (Decker Bild 15.12), Kerbwirkungszahl βk,b nach Decker Formel 15.14

42CrMo4 ⇒ ηχBiegung = 1,21 ⇒ βk,b =

αk,b

ηχBiegung

=

3,6
1,21

= 2,98

16NiCrS4 ⇒ ηχBiegung = 1,15 ⇒ βk,b =

αk,b

ηχBiegung

=

3,6
1,15

= 3,13

E295 ⇒ ηχBiegung = 1,44 ⇒ βk,b =

αk,b

ηχBiegung

=

3,6
1,44

= 2,50

Bezogenes Spannungsgefälle in Strängen mit Torsionsbeanspruchung (Decker Formel 15.13)

χ =

4
D + d

+

2
ρ

=

4
48 + 45 +

1
0,4

χ = 2,54

Stützziffer ηχ nach Siebel mit Re = 650 N
mm²

für 42CrMo4, Re = 735 N
mm²

für 16NiCrS4 und

Re = 275 N
mm²

für E295 (Decker Bild 15.12), Kerbwirkungszahl βk,t nach Decker Formel 15.14

42CrMo4 ⇒ ηχTorsion = 1,15 ⇒ βk,t =

αk,t

ηχTorsion

=

2,25
1,15

= 1,96

16NiCrS4 ⇒ ηχTorsion = 1,12 ⇒ βk,t =

αk,t

ηχTorsion

=

2,25
1,12 = 2,01

E295 ⇒ ηχTorsion = 1,32 ⇒ βk,t =

αk,t

ηχTorsion

=

2,25
1,32

= 1,70

Kritischer Querschnitt 4 (Mitte zwischen den beiden Lagern)

s = 145mm

d = 48mm

Keine Kerbwirkung, da die Welle an dieser Stelle glatt ist.

αk,b | = αk,t | = βk,b | = βk,t | = 1

Kritischer Querschnitt 5 (Freistich am Absatz als Anlagefläche der Seitenwand)

Bei der Schweißkonstruktion liegt bei Querschnitt 5 die Seitenwand an.
s = 225mm

d = 45mm

D = 48mm

Kerbzahlen entsprechen denen des Kritischen Querschnitt 3, da dieselbe Geometrie vorliegt.

αk,b | = 3,6
αk,t | = 2,25
42CrMo4 | ⇒ βk,b | = 2,98
16NiCrS4⇒ βk,b | = 3,13
E295 ⇒ βk,b | = 2,50
42CrMo4 | ⇒ βk,t | = 1,96
16NiCrS4 | ⇒ βk,t | = 2,01
E295 ⇒ βk,t | = 1,70

Kritischer Querschnitt 6 (Übergang Lager B)

Die Kerbzahlen entsprechen denen des Kritischen Querschnitt 2, da dieselbe Geometrie

vorliegt.

αk,b | = 2,65
αk,t | = 2,2
42CrMo4 ⇒ βk,b | = 2,3
16NiCrS4 | ⇒ βk,b | = 2,35
E295 ⇒ βk,b | = 2,02
42CrMo4 | βk,t | = 2,20
16NiCrS4 | ⇒ βk,t | = 2,04
E295 ⇒ βk,t | = 1,77

Kritischer Querschnitt 7 (Übergang Lager-Keilwelle)

Der Übergang soll einen möglichst großen Radius haben, um einen möglichst gleichmäßigen

Kraftfluss zu gewährleisten. Gerechnet wird jedoch mit dem Radius 4mm=2t, da dies der

größte Radius mit vorliegenden Kerbwerten ist. Noch besser als ein großer Radius wäre die

Verwendung mehrerer überlappender Radien (vgl. Claus Mattheck). Für die Einzelteilfertigung ist ein solcher Übergang jedoch schwierig zu realisieren und wird deshalb nicht gewählt.

s = 302,5mm

d = 36m

D = 40mm

ρ = 4mm

t =

D − d
2

= 2mm

Formzahl αk,b für Biegung nach Decker Tab. 15.4 a)

d
D

=

36
40 = 0,9

ρ
t

=

4
2

= 2

αk,b = 1,55

Formzahl αk,t
für Biegung nach Decker Tab. 1.13

αk,t = 1,1

Bezogenes Spannungsgefälle in Strängen mit Biegebeanspruchung (Decker Formel 15.12)

χ = | 4 D + d +

2
ρ
= | 4
40mm + 36mm

+

2
4mm

χ = 0,55

Stützziffer ηχ nach Siebel mit Re = 650 N
mm²

für 42CrMo4, Re = 735 N
mm²

für 16NiCrS5 und

Re = 275 N
| mm²

für E295 (Decker Bild 15.12), Kerbwirkungszahl βk,b nach Decker Formel 15.14

42CrMo4 ⇒ ηχBiegung = 1,06 ⇒ βk,b =

αk,b

ηχBiegung

=

1,55
1,06

= 1,46

16NiCrS4 ⇒ ηχBiegung = 1,04 ⇒ βk,b =

αk,b

ηχBiegung

=

1,55
1,04

= 1,49

E295 ⇒ ηχBiegung = 1,12 ⇒ βk,b =

αk,b

ηχBiegung

=

1,55
1,12

= 1,38

Bezogenes Spannungsgefälle in Strängen mit Torsionsbeanspruchung (Decker Formel 15.13)

χ =

4
D + d

+

1
ρ

=

4
40mm + 36mm

+

1
4mm

χ = 0,30

1
mm

Stützziffer ηχ nach Siebel mit Re = 650 N
mm²

für 42CrMo4, Re = 735 N
mm²

für 16NiCrS4und

Re = 275 N
mm²

für E295 (Decker Bild 15.12), Kerbwirkungszahl βk,t nach Decker Formel 15.14

42CrMo4 ⇒ ηχTorsion = 1,05 ⇒ βk,t =

αk,t

ηχTorsion

=

1,1
1,05

= 1,05

16NiCrS4 ⇒ ηχTorsion = 1,04 ⇒ βk,t =

αk,t

ηχTorsion

=

1,1
1,04

= 1,06

E295 ⇒ ηχTorsion = 1,09 ⇒ βk,t =

αk,t

ηχTorsion

=

1,1
1,09

= 1,01

Kritischer Querschnitt 8 (Keilwellenbeginn)

Nach Decker, Tab. 15.3 gelten für eine Keilwelle folgende Formzahlen:

s = 322,5mm

αk,b = 4,2

αk,t = 3,6

d = 28mm

D = 34mm

ρ = 0,25mm

Bezogenes Spannungsgefälle in Strängen mit Biegebeanspruchung (Decker Formel 15.12)

χ =

4
D + d

+

2
ρ

=

4
34mm + 28mm

+

2
0,25mm

χ = 8,06

Stützziffer ηχ nach Siebel mit Re = 650 N
mm²

für 42CrMo4, Re = 735 N
mm²

für 16NiCrS4und

Re = 275 N
mm²

für E295 (Decker Bild 15.12), Kerbwirkungszahl βk,b nach Decker Formel 15.14

42CrMo4 ⇒ ηχBiegung = 1,24 ⇒ βk,b =

αk,b

ηχBiegung

=

4,2
1,24 = 3,39

16NiCrS4 ⇒ ηχBiegung = 1,18 ⇒ βk,b =

αk,b

ηχBiegung

=

4,2
1,18 = 3,56

E295 ⇒ ηχBiegung = 1,54 ⇒ βk,b =

αk,b

ηχBiegung

=

4,2
1,54 = 2,73

Bezogenes Spannungsgefälle in Strängen mit Torsionsbeanspruchung (Decker Formel 15.13)

χ =

4
D + d

+

1
ρ

=

4
34mm + 28mm

+

1
0,25mm

χ =4,06

Stützziffer ηχ nach Siebel mit Re = 650 N
mm²

für 42CrMo4, Re = 735 N
mm²

für 16NiCrS5 und

Re = 275 N
mm²

für E295 (Decker Bild 15.12), Kerbwirkungszahl βk,t nach Decker Formel 15.14

42CrMo4 ⇒ ηχTorsion = 1,19 ⇒ βk,t =

αk,t

ηχTorsion

=

3,6
1,19 = 3,03

16NiCrS4 ⇒ ηχTorsion = 1,15 ⇒ βk,t =

αk,t

ηχTorsion

=

3,6
1,15 = 3,13

E295 ⇒ ηχTorsion = 1,39 ⇒ βk,t =

αk,t

ηχTorsion

=

3,6
1,39 = 2,59

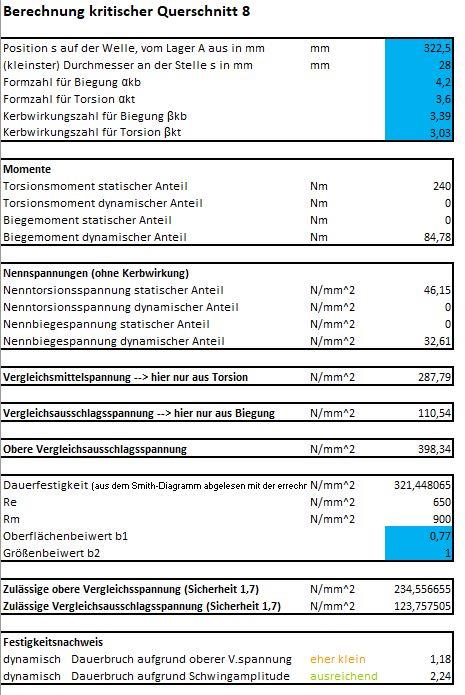
[picture p66: figure]

→Wahl einer anderen Keilwelle mit größerem tragendem Querschnitt

(DIN ISO 14 Leichte Reihe, 8x32x36),

Beginn des Keilwellenabschnitts weiter von Lager A entfernt, da dort das Biegemoment

abnimmt

Oberflächenangabe von Rz16 auf Rz4

Iteratives Vorgehen:

Nach Decker, Tab. 15.3 gelten für eine Keilwelle folgende Formzahlen:

s = 332,5mm

αk,b | = 4,2
αk,t | = 3,6

d = 32mm

D = 36mm

ρ = 0,25mm

Bezogenes Spannungsgefälle in Strängen mit Biegebeanspruchung (Decker Formel 15.12)

χ = | 4 D + d
+

2
ρ
= | 4
36mm + 32mm

+

2
0,25mm

χ = 8,06

Stützziffer ηχ nach Siebel mit Re = 650 N
mm²

für 42CrMo4, Re = 735 N
mm²

für 16NiCrS4und

Re = 275 N
| mm²

für E295 (Decker Bild 15.12), Kerbwirkungszahl βk,b nach Decker Formel 15.14

42CrMo4 ⇒ ηχBiegung = 1,24 ⇒ βk,b =

αk,b

ηχBiegung

=

4,2
1,24 = 3,39

16NiCrS4 ⇒ ηχBiegung = 1,18 ⇒ βk,b =

αk,b

ηχBiegung

=

4,2
1,18 = 3,56

E295 ⇒ ηχBiegung = 1,54 ⇒ βk,b =

αk,b

ηχBiegung

=

4,2
1,54 = 2,72

Bezogenes Spannungsgefälle in Strängen mit Torsionsbeanspruchung (Decker Formel 15.13)

χ =

4
D + d

+

1
ρ

=

4
36mm + 32mm

+

1
0,25mm

χ =4,06

Stützziffer ηχ nach Siebel mit Re = 650 N
mm²

für 42CrMo4, Re = 735 N
mm²

für 16NiCrS4 und

Re = 275 N
mm²

für E295 (Decker Bild 15.12), Kerbwirkungszahl βk,t nach Decker Formel 15.14

42CrMo4 ⇒ ηχTorsion = 1,19 ⇒ βk,t =

αk,t

ηχTorsion

=

3,6
1,19 = 3,03

16NiCrS4 ⇒ ηχTorsion = 1,15 ⇒ βk,t =

αk,t

ηχTorsion

=

3,6
1,15 = 3,13

E295 ⇒ ηχTorsion = 1,39 ⇒ βk,t =

αk,t

ηχTorsion

=

3,6
1,39 = 2,59

Kerbstelle 9 (Keilwelle-Gewinde)

Keine Torsion und keine Biegung vorhanden. Deshalb wird Kerbstelle 9 nicht berücksichtigt.

### 2.4.2 Berechnung der kritischen Querschnitte mit Excel

Das in VBA programmierte Excel-Programm wendet die Formeln zur Wellenberechnung nach

Decker [2] 15.5 bis 15.19 an. Die Grundlage bildet die Schnittgrößenberechnung in 0,5mm-

Schritten auf die gesamte Wellenlänge hinweg. Für diese müssen die wirkenden Kräfte und

Momente sowie die Abstände dieser bekannt sein.

Für jeden einzelnen zu berechnenden Querschnitt wird ein Auswertungsblatt erstellt.

Eingabegrößen sind für jeden Querschnitt der Ort auf der Welle vom Lager A aus (siehe

Skizze), bezeichnet mit s.

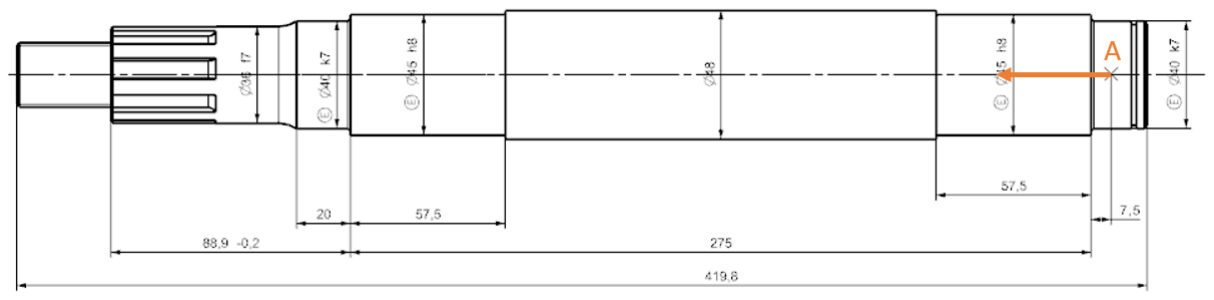
[picture p67: figure]

Daraus wird das jeweilige Vergleichsmoment an dieser Stelle berechnet.

Außerdem wird der kleinste Durchmesser an der Stelle s zur Berechnung der Nennspannung

benötigt. Mit den in 2.4.1 berechneten Kerbzahlen ergibt sich ein Vergleichsmoment und eine

obere Vergleichsausschlagsspannung.

Aus den hergeleiteten Formeln für das Smith-Diagramm werden mithilfe der vorher

eingegebenen Stoffwerte des gewählten Stahls die zulässige Schwingungsamplitude und die

zulässige obere Vergleichsausschlagsspannung berechnet, alternativ könnten sie aus dem

Smith-Diagramm abgelesen werden, was jedoch Ungenauigkeiten mit sich bringen würde.

Aus den zulässigen Werten und den vorhandenen Spannungen erhält man nach Eingabe

eines Oberflächenbeiwertes b1 und eines Größenbeiwertes b2, falls im Smith-Diagramm noch

nicht die Werte für den passenden Durchmesser verwendet wurden, die vorhanden

Sicherheiten. Die geforderte Sicherheit beträgt 1,7.

Das Programm zur Erstellung der Smith-Diagramme sowie zur Wellenberechnung befindet

sich auf der beiliegenden CD. Die Ergebnisse für die einzelnen Querschnitte sind im Anhang

10 zu finden. Alle erfüllen die Sicherheit von 1,7 gegen Dauerbruch.

### 2.5 Wellendurchbiegung und Biegewinkel in den Lagerstellen

Die Wellendurchbiegung und damit auch der Biegewinkel wird unter Vernachlässigung der

Versteifungswirkung der Trommel, aber unter Einbeziehung der verschiedenen Wellenabsätze

berechnet. Als Berechnungswerkzeug dient das Excel-Berechnungsprogramm von Decker zur

Berechnung von Durchbiegungen und Biegewinkeln.

Die Ergebnisse sind im Folgenden aufgeführt, die Eingabedateien können auf beiliegender CD

eingesehen werden (Anhang 11)

Für die gewählten Rillenkugellager sind laut Lagerhersteller Schaeffler folgende Biegewinkel

zulässig:

Gesamtneigungswinkel im Lager A | bLA (10⁻³ rad) | 0,6180
Gesamtneigungswinkel im Lager B | bLB (10⁻³ rad) | 0,9378
Gesamtdurchbiegung | f (10⁻³ cm) | 6,32
| f (mm) | 63,2

Der Gesamtneigungswinkel des Zapfens im Lager A ist zulässig.

Der Gesamtneigungswinkel des Zapfens im Lager B ist zulässig.

Die Gesamtdurchbiegung der Welle bleibt unterhalb des zulässigen Wertes.

Bei niedriger Belastung: 2‘ bis 6‘ und

bei hoher Belastung: 5‘ bis 10‘.

Bei einem Bandförderer handelt es sich um eine niedrige Belastung. Die oben errechneten

Gesamtneigungswinkel betragen für Lager A 2‘ 7‘‘ und für Lager B 3‘ 13‘‘. Damit liegen sie im

Toleranzbereich des Herstellers.

Die Gesamtdurchbiegung von 63,2 Mikrometer ist ebenfalls in der gängigen zulässigen

Größenordnung.

## 3 Trommel

### 3.1 Auslegung der Verbindung Welle – Trommel

Der Anspruch ist, dass die Welle für beide Konstruktionen so weit als möglich identisch bleibt,

um in der Auslieferung der verschiedenen Varianten flexibel zu sein.

Soll eine Selbstzentrierung des Bandes sichergestellt werden, so ist eine konkave Wölbung

der Trommel vorzusehen.

### 3.1.1 Variante A – Schweißkonstruktion

Die Trommel besteht bei Variante A (Schweißkonstruktion) aus einem Trommelrohr und zwei

Seitenwänden.

Die Seitenwände werden dabei in einem Abstand von 160 mm an die Welle geschweißt und

das Trommelrohr anschließend an die Seitenwände. Das Trommelrohr hat einen

Außendurchmesser von 240 mm. Die Dicke des Rohres ist 5 mm und die Länge 240 mm. Die

Seitenwände haben ebenso eine Dicke von 5 mm. Außendurchmesser der Seitenwände ist

230 mm. Die Bohrung in der Mitte der Seitenwände hat einen Durchmesser von 45 mm.

Damit die Seitenwände einfacher auf die Welle geschweißt werden können und der Abstand

von 160 mm besser eingehalten werden kann, hat die Welle an diesen Stellen einen Absatz

1,5 mm.

Berechnung der vorliegenden Spannungen (=reine Torsion)

Zur Berechnung der vorhandenen Torsionsspannung wurde die untenstehende Formel aus

dem Manuskript „Konstruktionslehre II“ von Prof. Dr.-Ing. Hansgeorg Binz (Stuttgart, 2010)

entnommen. Die Formeln finden sich auf den Seiten 8-13 und 8-15.

τvorℎ =

MT
WT

=

MT
π
16 ∙

(da + 2 ∙ a)

4 − da

4
da + 2 ∙ a

=

240000Nmm
π
16 ∙

(45mm + 2 ∙ 5mm)

4 − (45mm)

4
45mm + 2 ∙ 5mm

τvorℎ ≈ 13,31

N
mm²

Um einen Wert für die zulässige Torsionsspannung zu erhalten wurde die Tabelle 4.4 aus

„Maschinenelemente Decker“ [2] herangezogen. Um den „worst case“ anzunehmen, wurde

als Werkstoff S235 gewählt und die Bewertungsgruppe D.

τzul = 60

N
mm²

Verwendet wird der Werkstoff 42CrMo4. Für ihn sind noch höhere Spannungen zulässig. Dies

wird beim Vergleich der beiden Streckgrenzen deutlich:

S235: Re = 215

N
mm²

42CrMo4: Re = 650

N
mm²

Spannungsnachweis

τvorℎ ≤ τzul

13,31

N
mm² ≤ 60

N
mm²

→ Die Schweißverbindung hält den vorhandenen Belastungen stand.

Die außenliegende Schweißnaht wird nicht separat berechnet. Die Spannungen sind dort ein

Bruchteil der ohnehin kleinen Spannungen der inneren Naht. Dies liegt an der größeren Fläche

der Naht bei gleichem Durchmesser.

### 3.1.2 Variante B – Spannpressverband

Bei Variante B (Spannpressverband) besteht die Trommel aus demselben Trommelrohr, zwei

veränderten Seitenwänden und einem weiteren Rohr, das die Verbindung zwischen

Seitenwänden und Spannpressverband darstellt.

Ein Spannpressverband ist eine lösbare Verbindung, mithilfe der ein Torsionsmoment

reibschlüssig übertragen wird. In Frage kommen Spannschrauben, Sternscheiben,

Keilverbindungen oder Spannsätze. Aufgrund der relativ einfachen Montage wurde ein

Spannsatz der Firma Mädler gewählt, der sich beim Anziehen der Schrauben nach innen und außen konzentrisch aufweitet (zwei Spannsätze COM-4 von der Firma Mädler (Artikel-Nr.: 615

545 00)).

Damit sich der Druck der Spannsätze gleichmäßig verteilt und die Montage der Trommel

vereinfacht wird, ist beim Spannpressverband zusätzlich ein Rohr vorgesehen, das zwischen

dem Spannsatz und der Seitenwand angebracht ist und durch die gesamte Trommel reicht.

Die Verbindung zwischen diesem Rohr und den Seitenwänden erfolgt mithilfe einer weiteren

Schweißnaht. Diese Schweißnaht muss nicht gesondert berechnet werden, da auf sie das

gleiche Torsionsmoment wie bei Variante A wirkt, allerdings eine größere Schweißnahtfläche

vorliegt.

Die Seitenwände werden von beiden Seiten mit einem Abstand von 180 mm auf die Welle

gesteckt und das Zusatzrohr darüber gestülpt. Anschließend wird der Spannsatz durch

Anziehen der Schrauben gespannt. Auf das Zusatzrohr werden die Seitenwände im Abstand

von 180 mm geschweißt. Am Ende kommt das Trommelrohr über die Konstruktion und mit den

Seitenwänden verschweißt.

Die Seitenwände haben wie bei Variante A einen Außendurchmesser von 230 mm und eine

Dicke von 5 mm. Die Bohrung in der Mitte dieser Scheibe ist hier größer, nämlich 85 mm.

Die Welle und das Trommelrohr sind bei Variante A und B dieselben. Dies hat den Vorteil,

dass die Produktion günstiger, schneller und einfacher ist.

Beim Trommelrohr sollte darauf geachtet werden, dass die Außenfläche eine ausreichende

Rauheit vorweist, da so das Förderband besser haftet.

Der Innendurchmesser des Spannsatzes ist durch die Welle auf 45mm festgelegt. Der

gewählte Spannsatz hat die folgenden geometrischen Daten:

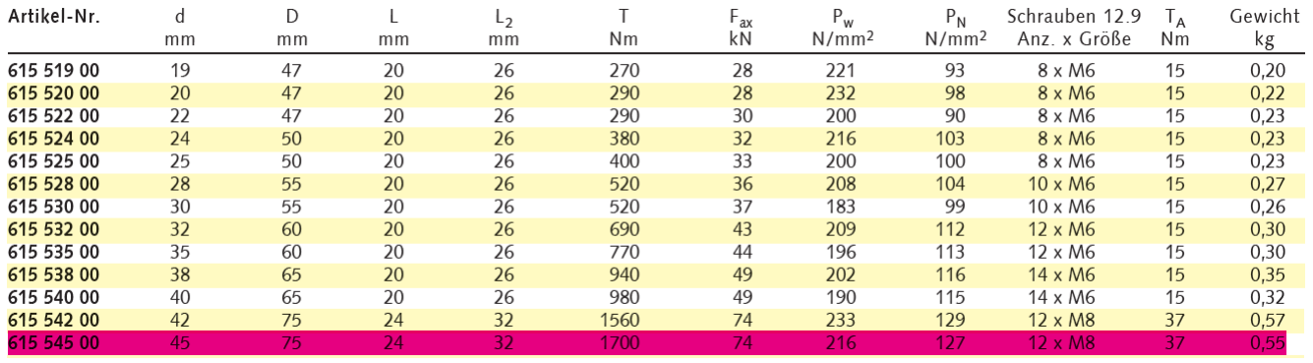
[picture p68: figure]

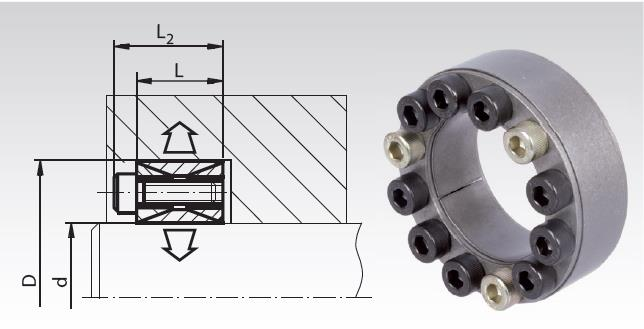
[picture p69: figure]

## 4 Lager

Die Lagerkonstruktion hängt stark von dem Verwendungszweck und Belastungsfall ab. Der

erste Gedanke stützt sich darauf, in welche Richtungen die äußeren Kräfte ansetzen. Da bei

der Antriebstrommel die Kräfte nicht axial wirken, werden keine speziellen Kugellager, die die

Axialkraft auffangen könnten, benötigt. Als nächster Schritt ist die Einbaurichtlinie der zwei

Lager als Fest- und als Loslager ausgewählt worden.

### 4.1 Berechnung der Lagerkräfte

Die Lagerkräfte werden mit einer Gewichtskraft von insgesamt 146N nach der Abschätzung

aus Abschnitt 2.1 berechnet, um einen ungefähren Richtwert für die Lagerberechnung zu

haben.

x-y-Ebene

Moment um Lager A im Uhrzeigersinn:

FZUG1 ∙ 65mm + FZUG2 ∙ 225mm − FBy ∙ 290mm − FKy ∙ 355mm = 0

2500N ∙ 65mm + 2500N ∙ 225mm − FBy ∙ 290mm − 1844,6N ∙ 355mm = 0

FBy ≈ 242,0N

Kräftegleichgewicht nach unten:

−FAy − FBy − FKy + FZUG1 + FZUG2 = 0

−FAy − 242,0N − 1844,6N + 2500N + 2500N = 0

FAy ≈ 2913,4N

x-z-Ebene

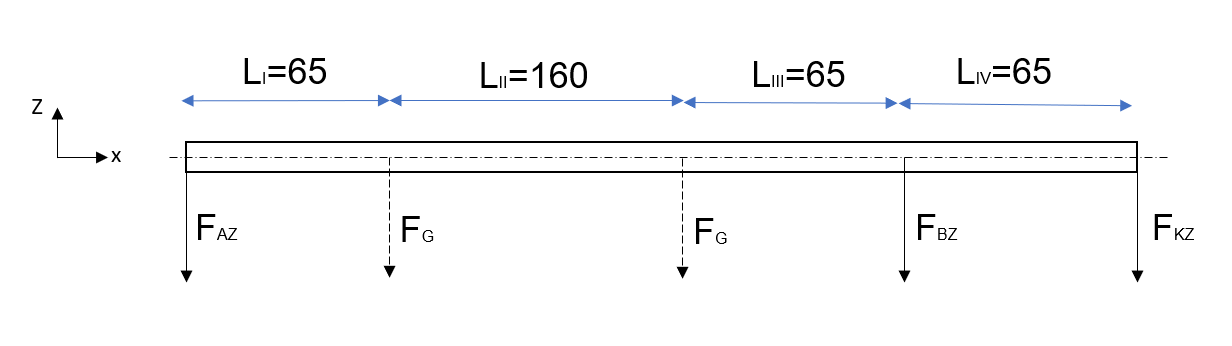
[picture p70: figure]

Moment um Lager A im Uhrzeigersinn:

FG1 ∙ 65mm + FG2 ∙ 225mm + FBz ∙ 290mm + FKz ∙ 355mm = 0

73N ∙ 65mm + 73N ∙ 225mm + FBz ∙ 290mm + 1844,6N ∙ 355mm = 0

FBz | ≈ | −2231,0N

Kräftegleichgewicht nach unten (nach Skizze):

FAz + FG1 + FG2 + FBz + FKz = 0

FAz + 73N + 73N − 2231,0N + 1844,6N = 0

FAz ≈ 340,4N

Zusammenfassung der Lagerkräfte:

FA = √FAy
2 + FAz

2 = √(2913,4N)
2 + (340,4N)

2

FA ≈ 2933,2N

FB = √FBy
2 + FBz

2 = √(242,0N)
2 + (−2331,0N)

2

FB ≈ 2343,5N

Das selbst programmierte Excel-Programm (Anhang 9) liefert dieselben Ergebnisse.

### 4.2 Auswahl der Lager

Die Lagerdimensionierung wurde vor allem durch den benötigten Wellenquerschnitt

beeinflusst. So ist als erste fixe Größe der Innendurchmesser der Lager mit d=40mm

festgelegt. Alle weiteren Größen sind abhängig von der Lebensdauer und Bauart des Lagers.

Grundlegend für die Lagerbauart ist der benötigte Winkelausgleich der Lager. Für hohe

Winkelfehler sind Pendellager empfohlen, die bis zu 4° tolerieren können, und für geringe

Winkelfehler normale Rillenkugellager, die eine Kostenersparnis bedeuten. Da die Lagerböcke

Lagefehler in gewissem Maße durch ihre Konstruktion ausgleichen, ergeben sich kaum

Winkelfehler. Deswegen kann auf Pendelkugellager verzichtet werden.

Da Tonnenlager eine zu hohe, stark überdimensionierte Lebensdauer für den vorliegenden

Anwendungsfall haben, sind Rillenkugellager ausgewählt worden. Hier ergab sich dann durch

die Tragzahl des Lagers ein Außendurchmesser von d=68 mm und eine Breite von b=15 mm.

### 4.3 Dynamische Tragzahlen und Lagerlebensdauer

Die theoretische dynamische Tragzahl und die zugehörigen Lagerlebensdauern werden von

Hand berechnet. Der Anwendungsfaktor KA kann hier im Gegensatz zur Wellenberechnung

vernachlässigt werden.

Mithilfe der Formeln 18.2 und 18.3 nach Decker kann die notwendige dynamische Tragzahl

Cdyn für die geforderte Lagerlebensdauer von 30000h berechnet werden. Als Ausgangswerte

dienen die maximal auftretende Lagerkraft, in vorliegendem Fall in Lager A (FA=2942,6N) und

die Soll-Drehzahl von 80 1/min. Dadurch wird für das geringer belastete Lager B natürlich eine

höhere Lebensdauer erreicht. Aus Symmetrie- und Montagegründen werden jedoch trotzdem

2 identische Lager verwendet.

Nominelle Lebensdauer (Formel 18.2)

L10 = (

C
P

)

p
- 10⁶

Nominelle Lebensdauer (Formel 18.3)

L10ℎ =

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
Mit p=3 für die Verwendung von Kugellagern, n = 80 1/min und P = FA = 2933,2N

Umstellen nach C=Cdyn:
C = √
FA

3
- n
10⁶

3
- L10ℎ,erf

Cerf ≥

√
(2933,2N)

3 ∙ 80 60
ℎ
10⁶

∙

3
30000ℎ

Cerf ≥ 15,4kN

Die nächstgrößere dynamische Tragzahl für ein Kugellager mit dem Innendurchmesser 40mm,

wie er von der Welle vorgegeben wird, beträgt 17kN (Rillenkugellager DIN 625-6008, nach

Decker). Damit ergeben sich für die beiden Lager folgende nominelle Lebensdauern:

LA,10ℎ =

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
17kN
2343,6N

)

3
∙

10⁶
80 ∙ 60 1
ℎ

LA,10ℎ ≈ 79516ℎ

LB,10ℎ =

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
17kN
2933,26N

)

3
∙

10⁶
80 ∙ 60 1
ℎ

LB,10ℎ ≈ 40556ℎ

Beide Lebensdauern liegen deutlich über der geforderten Lebensdauer von 30000h, allerdings

noch unter der in der Anforderungsliste definierten Grenze von 100000h. Da bisher noch keine endgültigen Gewichtskräfte eingerechnet werden und die finale Drehzahl durch den

verwendeten Motor leicht abweichen kann, ergeben sich in der Endrechnung geringere Werte.

Unter der Bedingung, dass zwei gleiche Lager verwendet werden sollen, ist die Wahl eines

Rillenkugellagers mit einer geringeren dynamischen Tragzahl aufgrund des Marktangebots

nicht möglich.

### 4.4 Schmierung der Lager und Abdichtung

Die Rillenkugellager benötigen eine Fettschmierung, um übermäßigen Verschleiß zu

vermeiden. Hierfür wird ein Schmierfett nach Klasse KP empfohlen, das den Verschleiß im

Mischreibungsgebiet herabsetzt und die Belastbarkeit erhöht [2].

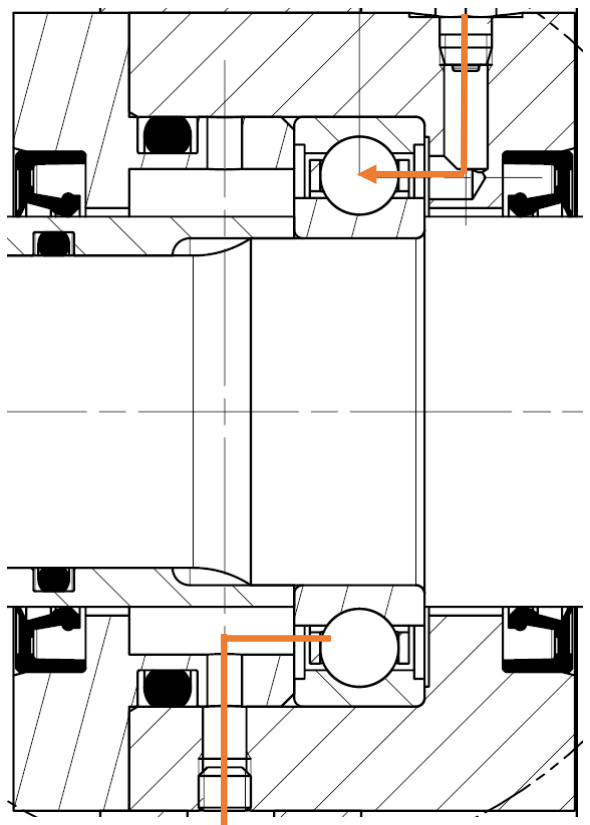
[picture p71: figure]

In orange ist der Weg des Schmierfettes eingezeichnet. Durch die Beschaffenheit des

Fetteinlasses wird das Fett direkt in den das Kugellager eingespeist. Alles überflüssige Fett

wird in den Hohlraum um die Distanzhülse geleitet und kann von dort über das Auslassloch

abgenommen werden.

Zur Abdichtung werden Radialwellendichtringe verwendet, die das Fett im Gehäuse halten und

verhindern, dass Schmutzpartikel in das Lagergehäuse eindringen. Aus diesem Grund wurde

Form AS statt form A gewählt. Damit das Fett nicht zwischen den gepressten Flächen, wie zum Beispiel zwischen der Distanzhülse und der Welle, nach außen dringen kann, wurden

zusätzlich O-Ringe als statische Dichtung eingefügt.

### 4.5 Deckel

Allgemein gilt hier, dass so viele Teile wie möglich identisch gestaltet werden sollen. Da aber

eines der Lager ein Fest- und eines ein Loslager sein muss, ist eine komplette Identität nicht

möglich. Die einzige Möglichkeit wäre, bei zwei gleichen Deckeln einen Distanzring

einzusetzen, der eine Klemmung des einen Kugellagerrings gewährleisten würde. Solche

Ringe gibt es aber nicht als Normteile, weswegen eine Eigenfertigung erforderlich wäre. So

lange solche Teile nicht standardmäßig im Produktportfolio zu finden sind, wie es hier bei einer

Einzelteilfertigung so gut wie nie der Fall ist, ist es wirtschaftlicher, weniger Einzelteile zu

fertigen. Anstatt zwei gleichen Deckeln und einem Distanzring werden zwei geringfügig

unterschiedliche Deckel vorgesehen. Insgesamt werden drei Deckel mit Durchgangsloch und

ein Deckel ohne Durchgangsloch benötigt.

Der Deckel mit Durchgangsbohrung muss das Lager klemmen, dazu ist eine

Mindestklemmlänge h nach [1] erforderlich. Für Rillenkugellager 6008 gilt hmin=2,3mm, dieses

ist mit hreal=2,5mm erfüllt.

### 4.5.1 Schraubenberechnung des Deckels

Als Schraubenausgangsgröße wurde M6 gewählt, da auch der Schmiernippel ein M6-Gewinde

erfordert. Damit wird nur ein Werkzeug zum Schneiden dieser Gewinde benötigt, was

fertigungstechnisch günstiger ist. Die Schrauben müssen nicht gesondert berechnet werden,

da sie, einmal angezogen, keinen Einfluss mehr auf die Abdichtung des Gehäuses haben. Es

wird nur das Anzugsmoment MA aus [3] Tab. 10.8 abgelesen. Es beträgt MAzul= 11,2 Nm.

Der O-Ring zur statischen Abdichtung befindet sich nicht „in“ der Pressfläche, sondern axial zur Welle und damit auch zur Einführrichtung des Deckels. Allein durch ihr Übermaß und die

daraus resultierende Verpressung wird eine Dichtwirkung erreicht.

Die Bohrungen vor der statischen Dichtung ermöglichen einen Fettauslauf. Damit

Montageaufwand gespart werden kann, sind die Auslauflöcher in allen möglichen

montierbaren Positionen angebracht werden, sodass der Fettablauf immer garantiert ist. Die

nicht benötigten Löcher werden durch das Gehäuse verschlossen und durch den O-Ring

abgedichtet.

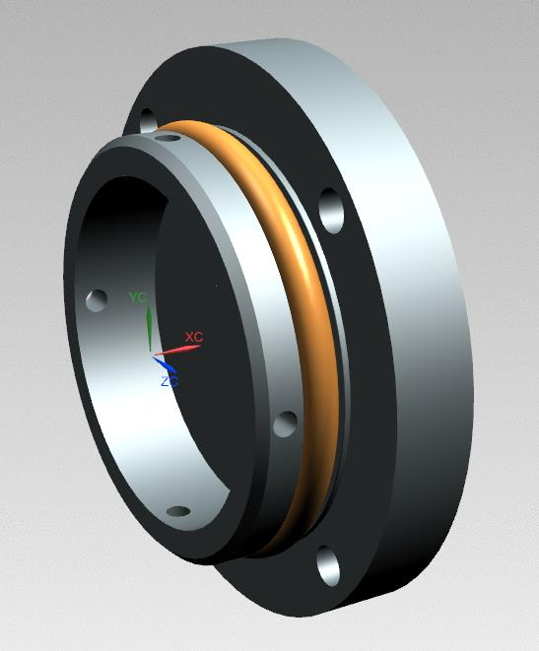
[picture p72: figure]

Einschraubtiefen
Die Einschraubtiefe für 8.8-Schrauben in Werkstoffe mit Rm = 400 … 600 N
mm²

beträgt nach [1]

1,2d = 7,2mm. Der Gewindeüberstand x ist der dreifache Wert der Gewindesteigung, hier also

3mm. Der Gewindeüberstand beträgt nach DIN 76 5,1 mm. Die theoretische Gewindetiefe

ergibt sich damit zu 10,2mm, die Gesamtlochtiefe 15,3mm. Der Deckel ist 13,3mm hoch und

erhält für eine M6-Zylinderkopf-Innensechskant-Schraube eine Senkung von | ∅6,6x6,4 (nach
DIN 974-1). Die gewählte Schraube ist 20mm lang. Von dieser Länge müssen | 13,3mm −
6,4mm = 6,9mm | abgezogen werden, die nicht als Einschraubtiefe zur Verfügung stehen. Die

verbleibende Schraubenlänge beträgt 13,1mm, damit muss auch die Gewindetiefe angepasst

werden: | Neue | Gewindetiefe | = 13,1mm + 3mm = 16,1mm. | Die | neue | Lochtiefe

beträgt 16,1mm + 5,1mm = 21,2mm.

Die Toleranz der Winkel der Deckelbohrungen und der zugehörigen Bohrungen im Gehäuse

wurde wie folgt ermittelt:

dScℎraube = 6mm

DDurcℎgangslocℎ = 6,6mm

∆d = 0,6mm

Das bedeutet, dass die Schraube im Idealfall zu jeder Seite 0,3mm Luft hat. Diese 0,3mm

können im schlechtesten Fall auf 0mm sinken, ohne dass ein Klemmen entsteht. Für Gewinde

wie Durchgangsbohrung steht ein Toleranzrahmen von +- 0,15mm zur Verfügung, der sich im

schlechtesten Fall zu den oben erläuterten 0,3mm addiert. Der Lochkreis hat einen

Durchmesser von 80mm.

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

0,15mm = φ ∙ 40mm

φ =

3
800 ≈ 0,215°

Dies entspricht 12‘ 53‘‘. Die Winkel dürfen zur 45°-Line also gerundet jeweils um ±10‘

abweichen.

### 4.6 Lagerböcke


Die Lagerböcke bilden die Schnittstelle zwischen der Antriebstrommel und der

Anschlusskonsole oder dem Boden. Zu den Aufgaben gehören die Kraftaufnahme, das

Anheben des Fließbandes vom Boden und das Ausgleichen von Unebenheits- sowie

Positionsfehlern in der Anschlussstelle.

Um eine Ausrichtung der beiden Lager ermöglichen zu können, müssen die Lagerböcke in

drei Achsen einstellbar sein. Dies ist umsetzbar durch Langlöcher an der Anschlussstelle (y-

Richtung), Unterbauung mit Beilegscheiben (z-Richtung) und Reibverbindung der

Lagergehäuse mit dem Lagerbock (x-Richtung). Durch letzteres kann das Gehäuse noch

seitlich verschoben werden, um genügend Lagerluft zu ermöglichen.

Als Fertigungsverfahren empfiehlt sich eine Schweißbaugruppe oder ein Ausbrennteil.

Anschließend werden die Kontaktflächen der Reibverbindung sowie die Kontaktflächen zur

Anschlussstelle spanend nachbearbeitet. Danach werden die Bohrungen für Gewinde und

Langlöcher gebohrt und die Gewinde zum Festspannen der Lagergehäuse geschnitten.

### 4.6.1 Auslegung der Betonanker

Die Antriebstrommel wird später mithilfe von Bolzenankern im Hallenboden oder auf einer

vorgefertigte Konsole aus Beton befestigt. Durch die Montagehöhe des Fließbandes wirken

große Hebel auf die Verankerungen im Boden.

Um die Bolzenabstände zu bestimmen, wurde ein statisches Gleichgewicht aufgestellt. Als

Lagerkräfte wurden dann die Maximalwerte der Bolzenanker aus dem Datenblatt

angenommen [6]. Damit kann ein Momentengleichgewicht um Lagerpunkt A aufgestellt

werden und nach den Mindestabstand c aufgelöst werden. Dieser stellt dann den minimalen

Abstand der Bolzenanker bezüglich des Achsmittelpunkts, bei denen die Verbindung gerade

noch hält, dar.


Fy ∙ 315mm + Fz

- c − Bz
- c = 0

Bz = Fzug−max = 9,5kN

Fy = 3kN

Fz = 2,5kN

→ |cmin| = 112,5 mm

## 5 Antrieb

Die zu erzielende Bewegung ist zunächst ein Umlauf des Förderbandes. Diese wird erzeugt

über eine Drehbewegung der zu konstruierenden Antriebstrommel. Da es sich um eine

kontinuierliche rotatorische Bewegung handelt, ist ein elektrischer Antrieb die erste Wahl.

Dabei wären zwei Varianten denkbar: entweder ein externer Elektro- oder Getriebemotor, der

direkt oder über eine Antriebskette die Welle antreibt, oder aber ein Direktantrieb mithilfe einer

Art Motorspindel. Da letztere Variante aber zu einer völlig anderen Konstruktion führen würde,

wird sie hier nur erwähnt, in der restlichen Konstruktion aber nicht berücksichtigt. In der

Anforderungsliste ist außerdem definiert, dass ein Dreifachkettentrieb verwendet werden soll.

Die Momentenübertragung vom Motor bis zur Trommel erfolgt über folgenden Weg:

Entsprechend müssen diese identifizierten Verbindungen kritisch hinterfragt und eventuell

berechnet werden. In diesem Kapitel soll es um die Auswahl des Elektromotors und die direkt

damit | einhergehenden | Auslegungsrechnungen | des | Kettentriebes | und | der

Keilwellenverbindung gehen.

### 5.1 Auswahl des Elektromotors

Beim Antrieb besteht die Möglichkeit, direkt einen Getriebemotor zu verwenden, oder alternativ die Übersetzung selbst zu konstruieren. Der Vorteil eines Getriebemotors ist die

Zuverlässigkeit und Störungsfreiheit, mit der die gewünschte Drehzahl geliefert wird. Alle Übersetzungsvorgänge finden hinter geschlossenem Gehäuse statt. Allerdings spricht der

Motorwelle | Passfeder | Motorkettenrad | Dreifachrollenkette
Welle | Keilwelle | Wellenkettenrad Schweißverbindung
Spannpressverband
äußere Schweißnaht | Trommel

geringere Preis (Drehstrommotor ohne Übersetzung ca. 300-500€, mit Übersetzung ca. 700€)

für die Verwendung einer selbst konstruierten Übersetzung. Die Herausforderung dabei ist die

Übersetzung von der minimalen Drehzahl eines nicht getriebeübersetzten Elektromotors

(750U/min) über nur eine einzige Übersetzungsstufe auf 80 U/min. Geht man von einer

minimalen Zähnezahl von 16 Zähnen aus, um ein Rundlaufen des Kettentriebs zu

gewährleisten, müsste das komplementäre Zahnrad
750 U/min
80 U/min
- 16 Zäℎne = 150 Zäℎne

haben. Diese Zähnezahl ist für ein Dreifachkettenrad jedoch nicht auf dem Markt erhältlich. Die Entscheidung fiel aufgrund der unnötigen Verkomplizierung durch eine Übersetzung über

zwei Stufen auf den Getriebemotor von NORD Getriebebau, 85 U/min, 247Nm. Die

geringfügige Abweichung der Drehzahl zur gewünschten Betriebsdrehzahl von 80 U/min ist

jedoch laut Anforderungsliste zulässig.

### 5.2 Auslegung des Dreifach-Kettentriebes

Im Folgenden werden drei Optionen dargestellt. Der geforderte Teilkreisdurchmesser von ca.

184 mm führt zu dem Schluss, dass eine 08B- oder 10B-Kette verwendet werden soll, da nur

für diese Kettenräder mit ähnlichen Teilkreisdurchmessern erhältlich sind. Den großen

Sicherheiten nach zu schließen wäre aber auch eine 06B-Kette denkbar.

Option 1 übersetzt die etwas zu hohe Drehzahl eines Getriebemotors auf die geforderte

Drehzahl und das geforderte Drehmoment. Option 2 verwendet einen Motor mit fast exakt der geforderten Drehzahl und hat daher keine Übersetzung nötig. Option 3 geht von einer 10B-

Kette aus. Nach Berechnung der drei Möglichkeiten werden Vor- und Nachteile dargelegt, die

die Entscheidungsgrundlage für eine Option bilden.

Option 1 - mit Übersetzung mit 08B-Kette

Motor von SEW, 89 U/min, 230Nm

Kettengröße nach DIN 8187: 08B

Berechnung nach Decker Gleichungen 25.13 bis 25.26 [2]

Übersetzung

i =

na
nb

=

zb
za

=

89 1/min
80 1/min

= 1,1125

i =

45
40 = 1,125

→z1=40, z2=45 Mit dem Index „1“ wird das kleinere Rad gekennzeichnet, in diesem Fall das treibende Rad auf der Motorenwelle. Die Übersetzung wird nicht exakt die Drehzahl n=80

1/min an der Welle liefern. Die Drehzahl ist laut Anforderungsliste leicht variierbar.

n2 real =

n1
i

=

89 1/min
1,125
n2 | = 79, 1̅ 1/min | →hinreichend nahe an der gewünschten Drehzahl von 80 1/min

(Abweichung 1,1%)

Auswahl der Dreifach-Kettenräder

Antriebskettenrad: z1 = 40 ; d1 = 166,7mm

Abtriebskettenrad: z2 = 45 ; d2 = 188,6mm

Korrigierte Leistung

Mit f1 … Betriebsfaktor zur Berücksichtigung ungleichförmigen Betriebes nach Tab. 25.4,

gewählt: f1=1,0, da gleichförmig stoßfreier Lauf für treibende und angetriebene Maschine

gegeben ist

Mit f2 | … Zähnezahlfaktor, der die Auswirkungen der Zähnezahl z1 | des Kleinrades

berücksichtigt nach Tab. 25.7, gewählt: f2=0,45 da z1=40
PC = P ∙ f1 ∙ f2

= 2,2kW ∙ 1,0 ∙ 0,45

PC | = | 0,99kW

Kettengeschwindigkeit
v = z1 ∙ p ∙ n1

= 40 ∙ 12,7mm ∙ 89

1
min

v ≈ 0,85

m
s

Gliederzahlfaktor

f3 = (
| |z2 − z1
2π

)

2

= (
|45 − 40|
2π

)

2

f3 ≈ 0,633

Gliederzahl

Mit a0 …vorläufig gewählter Achsabstand, gewählt: a0=500mm

X0 = 2

a0
p

+

z1 + z2
2

+

f3 ∙ p
a0

= 2

500mm
12,7mm

+

40 + 45
2

+

0,633 ∙ 12,7mm
500mm
X0 = 121,26 → X = 121

Übersetzungsfaktor

fÜ = |

X − z1
z2 − z1

= |

121 − 40
45 − 40 |

fÜ = 1,8

Achsabstand

Mit f4 … Achsabstandsfaktor nach Tabelle 25.8, gewählt: f4=0,24222 da fÜ=1,8 a = f4 ∙ p ∙ [2X − (z1 + z2

)]

= 0,24222 ∙ 12,7mm ∙ [2 ∙ 121 − (40 + 45)]

a = 482,96mm ≈ 483mm

Günstige Achsabstände erfüllen die Gleichung a = (30 … 50)p. Bei vorliegenden Bedingungen

ergibt sich: a = (38)p, entsprechend ist diese Vorgabe erfüllt.

Tragfähigkeitsberechnung der Kette

Statische Zugkraft in der Kette

F =

P
v

=

2,2kW
0,85 m
s
F = 2,588kN

Dynamische Zugkraft in der Kette

Für Auswahl von f1 siehe Berechnung der korrigierten Leistung. Fd = F ∙ f1

= F ∙ 1,0

Fd = 2,588kN

Fliehkraftzug

Mit q … Längengewicht der Kette nach Tabelle 25.2, für Dreifachketten 08B ergibt sich q=2,0

kg/m
Ft = q ∙ v

2

= 2,0

kg
m
- (0,85

m
s

)

2

Ft = 1,445N → vernacℎlässigbar klein

Gesamtzugkraft
Fg = Fd + Ft

= 2588N + 1,445N
Fg ≈ 2590N

Statische Bruchsicherheit

Mit FB … Bruchraft der Kette nach Tabelle 25.2, für Dreifach-Rollenkette 08B: FB=47,5kN

SB =

FB
F

≥ 7

=

47,5kN
2,588kN
SB | ≈ 18,3 | ≥ 7 → ausreicℎende Sicℎerℎeit

Dynamische Bruchsicherheit

SB =

FB
Fg

≥ 5

=

47,5kN
2,590kN
SB ≈ 18,3 ≥ 5 → ausreicℎende Sicℎerℎeit

Gelenkpressung
Mit A … gepresste Gelenkfläche nach Tabelle 25.2, A = 1,51cm² für Dreifachkette 08B

pg =

Fg
A

=

2590N
1,51cm²

pg ≈ 1715,2

N
cm²

Zulässige Gelenkpressung nach Tabelle 25.9

Wert gilt für v=0,8 m/s, i=1, X=100, Dreifach-Kette. Für die exakten Abmaße des Kettentriebs

gelten leicht höhere Werte.

pzul ≥ 2007,4

N
cm²

Lebensdauernachweis

pzul
pg

=

2007,4
1715,2

= 1,17

Für pzul
pg

= 1,0 gilt Lℎ ≈ 15000ℎ, für pzul
pg

= 1,2 gilt bereits Lℎ ≈ 50000ℎ. Da der berechnete Wert

mit 1,17 näher an 1,2 liegt, ist davon auszugehen, dass die Lebensdauer die erforderliche

Lebensdauer von 30000h des Gesamtsystems in jedem Fall überschreiten wird.

Option 2 - ohne Übersetzung mit 08B-Kette

Motor von NORD Getriebebau, 85 U/min, 247Nm

Kettengröße nach DIN 8187: 08B

Berechnung nach Decker Gleichungen 25.13 bis 25.26 [1]

Übersetzung

i =

na
nb

=

zb
za

=

85 1/min
85 1/min

= 1

i =

45
45 = 1

→z1=45, z2=45

Die Drehzahl wird nicht genau n=80 1/min an der Welle betragen, ist allerdings laut

Anforderungsliste leicht variierbar. Abweichung: 6,25%

Auswahl der Dreifach-Kettenräder

Antriebskettenrad: z1 = 45 ; d1 = 188,6mm

Abtriebskettenrad: z2 = 45 ; d2 = 188,6mm

Korrigierte Leistung

Mit f1 … Betriebsfaktor zur Berücksichtigung ungleichförmigen Betriebes nach Tab. 25.4,

gewählt: f1=1,0, da gleichförmig stoßfreier Lauf für treibende und angetriebene Maschine

gegeben ist

Mit f2 | … Zähnezahlfaktor, der die Auswirkungen der Zähnezahl z1 | des Kleinrades

berücksichtigt nach Tab. 25.7, gewählt: f2=0,39 da z1=45
PC = P ∙ f1 ∙ f2

= 2,2kW ∙ 1,0 ∙ 0,39

PC | = | 0,858kW

Kettengeschwindigkeit
v = z1 ∙ p ∙ n1

= 45 ∙ 12,7mm ∙ 85

1
min

v ≈ 0,81

m
s
Gliederzahlfaktor

f3 = (
| |z2 − z1
2π

)

2

f3 = 0

Gliederzahl

Mit a0 …vorläufig gewählter Achsabstand, gewählt: a0=500mm

X0 = 2

a0
p

+

z1 + z2
2

+

f3 ∙ p
a0

= 2

500mm
12,7mm

+

45 + 45
2

+

0 ∙ 12,7mm
500mm
X0 = 123,74 → X = 124

Achsabstand

a = p ∙ (

X − z
2

)

= 12,7mm ∙ (

124 − 45
2

)

a = 501,65mm ≈ 502mm

Günstige Achsabstände erfüllen die Gleichung a = (30 … 50)p. Bei vorliegenden Bedingungen

ergibt sich: a = (39,5)p, entsprechend ist diese Vorgabe erfüllt.

Tragfähigkeitsberechnung der Kette

Statische Zugkraft in der Kette

F =

P
v

=

2,2kW
0,81 m
s
F = 2,716kN

Dynamische Zugkraft in der Kette

Für Auswahl von f1 siehe Berechnung der korrigierten Leistung. Fd = F ∙ f1

= F ∙ 1,0

Fd = 2,716kN

Fliehkraftzug

Mit q … Längengewicht der Kette nach Tabelle 25.2, für Dreifachketten 10B ergibt sich q=2,8

kg/m
Ft = q ∙ v

2

= 2,0

kg
m
- (0,81

m
s

)

2

Ft = 1,312N → vernacℎlässigbar klein

Gesamtzugkraft
Fg = Fd + Ft

= 2716N + 1,312N
Fg ≈ 2717N

Statische Bruchsicherheit

Mit FB … Bruchraft der Kette nach Tabelle 25.2, für Dreifach-Rollenkette 08B: FB=47,5kN

SB =

FB
F

≥ 7

=

47,5kN
2,716kN
SB | ≈ 18 | ≥ 7 → ausreicℎende Sicℎerℎeit

Dynamische Bruchsicherheit

SB =

FB
Fg

≥ 5

=

47,5kN
2,717kN
SB ≈ 18 ≥ 5 → ausreicℎende Sicℎerℎeit

Gelenkpressung
Mit A … gepresste Gelenkfläche nach Tabelle 25.2, A = 1,51cm² für Dreifachkette 08B

pg =

Fg
A

=

2717N
1,51cm²

pg ≈ 1799,3

N
cm²

Zulässige Gelenkpressung nach Tabelle 25.9

Wert gilt für v=0,8 m/s, i=1, X=100, Dreifach-Kette. Für die exakten Abmaße des Kettentriebs

gelten leicht höhere Werte.

pzul ≥ 2007,4

N
cm²

Lebensdauernachweis

pzul
pg

=

2007,4
1799,3

= 1,11

Für pzul
pg

= 1,0 gilt Lℎ ≈ 15000ℎ, für pzul
pg

= 1,2 gilt bereits Lℎ ≈ 50000ℎ. Genauere Angaben sind

in der gewählten Literatur nicht auffindbar.

Option 3 - ohne Übersetzung mit 10B-Kette

Motor von NORD Getriebebau, 85 U/min, 247Nm

Kettengröße nach DIN 8187: 10B

Berechnung nach Decker Gleichungen 25.13 bis 25.26 [1]

Übersetzung

i =

na
nb

=

zb
za

=

85 1/min
85 1/min

= 1

i =

35
35 = 1

→z1=35, z2=35

Die Drehzahl wird nicht genau n=80 1/min an der Welle betragen, ist allerdings laut

Anforderungsliste leicht variierbar. Abweichung: 6,25%

Auswahl der Dreifach-Kettenräder

Antriebskettenrad: z1 = 35 ; d1 = 184mm

Abtriebskettenrad: z2 = 35 ; d2 = 184mm

Korrigierte Leistung

Mit f1 … Betriebsfaktor zur Berücksichtigung ungleichförmigen Betriebes nach Tab. 25.4,

gewählt: f1=1,0, da gleichförmig stoßfreier Lauf für treibende und angetriebene Maschine

gegeben ist

Mit f2 | … Zähnezahlfaktor, der die Auswirkungen der Zähnezahl z1 | des Kleinrades

berücksichtigt nach Tab. 25.7, gewählt: f2=0,52 da z1=35
PC = P ∙ f1 ∙ f2

= 2,2kW ∙ 1,0 ∙ 0,52

PC | = | 1,144kW

Kettengeschwindigkeit
v = z1 ∙ p ∙ n1

= 35 ∙ 15,875mm ∙ 85

1
min

v ≈ 0,787

m
s

Gliederzahlfaktor

f3 = (
| |z2 − z1
| 2π

)

2

f3 = 0

Gliederzahl

Mit a0 …vorläufig gewählter Achsabstand, gewählt: a0=500mm

X0 = 2

a0
p

+

z1 + z2
2

+

f3 ∙ p
a0

= 2

500mm
15,875mm

+

35 + 35
2

+

0 ∙ 15,875mm
500mm
X0 = 97,99 → X = 98

Achsabstand

a = p ∙ (

X − z
2

)

= 15,875mm ∙ (

98 − 35
2

)

a = 500,0625mm ≈ 500mm

Günstige Achsabstände erfüllen die Gleichung a = (30 … 50)p. Bei vorliegenden Bedingungen

ergibt sich: a = (31,5)p, entsprechend ist diese Vorgabe erfüllt.

Tragfähigkeitsberechnung der Kette

Statische Zugkraft in der Kette

F =

P
v

=

2,2kW
0,787 m
s
F = 2,795kN

Dynamische Zugkraft in der Kette

Für Auswahl von f1 siehe Berechnung der korrigierten Leistung. Fd = F ∙ f1

= F ∙ 1,0

Fd = 2,795kN

Fliehkraftzug

Mit q … Längengewicht der Kette nach Tabelle 25.2, für Dreifachketten 10B ergibt sich q=2,8

kg/m
Ft = q ∙ v

2

= 2,8

kg
m
- (0,787

m
s

)

2

Ft = 1,734N → vernacℎlässigbar klein

Gesamtzugkraft
Fg = Fd + Ft

= 2795N + 1,734N
Fg ≈ 2797N

Statische Bruchsicherheit

Mit FB … Bruchraft der Kette nach Tabelle 25.2, für Dreifach-Rollenkette 10B: FB=66,7kN

SB =

FB
F

≥ 7

=

66,7kN
2,795kN
SB | ≈ 24 | ≥ 7 → ausreicℎende Sicℎerℎeit

Dynamische Bruchsicherheit

SB =

FB
Fg

≥ 5

=

66,7kN
2,797kN
SB ≈ 24 ≥ 5 → ausreicℎende Sicℎerℎeit

Gelenkpressung
Mit A … gepresste Gelenkfläche nach Tabelle 25.2, A = 2,02cm² für Dreifachkette 10B

pg =

Fg
A

=

2797N
2,02cm²

pg ≈ 1384,6

N
cm²

Zulässige Gelenkpressung nach Tabelle 25.9

Wert gilt für v=0,8 m/s, i=1, X=50, Dreifach-Kette. Für die exakten Abmaße des Kettentriebs

gelten leicht höhere Werte.

pzul ≥ 1713,6

N
cm²

Lebensdauernachweis

pzul
pg

=

1713,6
1384,6

= 1,24

Für pzul
pg

= 1,0 gilt Lℎ ≈ 15000ℎ, für pzul
pg

= 1,2 gilt bereits Lℎ ≈ 50000ℎ. Da der berechnete Wert

mit 1,24 über 1,2 liegt, wird die geforderte Lebensdauer von 30000h sogar überschritten.

### Vergleich der drei Optionen

Die Abtriebskettenräder mit ihren Zähnezahlen mussten aufgrund ihres Durchmessers von ca.

184mm laut Anforderungsliste gewählt werden. Ist dieser Durchmesser einbautechnisch bedingt, ist die Wahl von Option 3 (ohne Übersetzung und mit 10B-Kette) mit d1=184mm

unumgänglich. Andererseits ist die relativ grobe 10B-Kette überdimensioniert und deshalb rein

kräftetechnisch nicht notwendig. Spielt die Drehzahlabweichung um 6,25% vom gewünschten Wert 80 1/min keine Rolle, so kann Option 2 (ohne Übersetzung mit 08B-Kette) angewendet

werden. Ein Vorteil ist auch, dass durch zwei gleiche Kettenräder eine Zukaufteilvariante

weniger bestellt werden muss. Aus Montagegründen ist dies zu befürworten. Option 1 mit Übersetzung verkompliziert den Einkauf nur unnötig, sie wäre lediglich im Falle eines

signifikanten Preisunterschiedes zwischen den beiden Getriebemotoren erwägenswert.
Für die Konstruktion des Bandförderers wird wegen den oben ausgeführten Überlegungen

Option 2 gewählt.

Wahl der Schmierung

Die angegebene Lebensdauer der Kette kann nur im Falle ausreichender Schmierung

gewährleistet werden. Ausfälle der Kette würden lange Stillstandszeiten verursachen, die mit

erheblichem Kostenaufwand verbunden wären. In Frage kommen eine manuelle Schmierung mit Pinsel oder Ölkanne, Tropfschmierung oder Tauchschmierung. Nach Decker [3],

Diagramm 25.3, wird für Ketten des Typs 08 bei einer Kettengeschwindigkeit über 0,6 m/s eine

Tropfschmierung empfohlen. Der Tropföler ist ein Zukaufteil, das dem Kunden empfohlen wird

(siehe Ausschnitt unten und Datenblatt im Anhang).
Die Menge des Öls ergibt sich nach [2] aus der Formel Tropfen
min =

v
p

mit v=

Kettengeschwindigkeit in m/s und p=Kettenteilung in cm.

Tropfen
min =

0,81
1,27

= 0,64 = 38 Tropfen
Stunde

. 20 Tropfen entsprechen 1ml. Es kann mit einer ungefähren

Ölmenge von 2ml/Betriebsstunde gerechnet werden. Mit einem Tropföler von 200ml Inhalt

müsste alle 100 Betriebsstunden nachgefüllt werden, was durchaus realisierbar ist. Da der

Tropföler jedoch mit weiterem Kostenaufwand verbunden ist, kann andernfalls auch mit Pinsel und Ölkanne geschmiert werden.

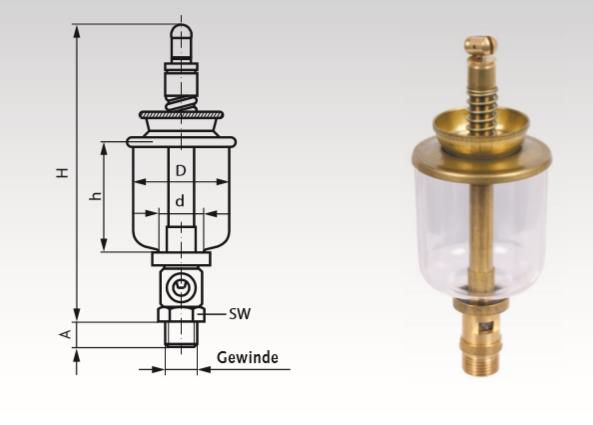
[picture p73: figure]
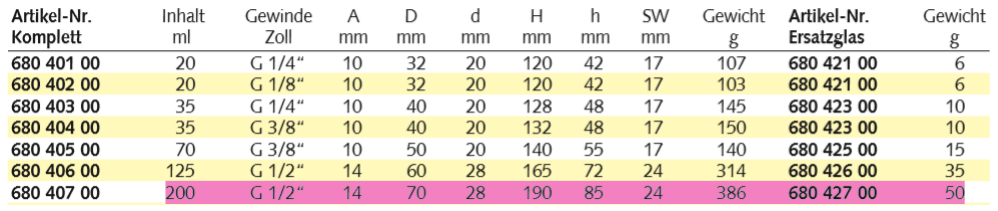
[picture p74: figure]

### 5.3 Auslegung der Keilwellenverbindung zwischen Welle und Kettenrad

Die Keilwelle wird nach Decker [2], Formel 12.3, berechnet.

p … Flankenpressung

Fu … Umfangskraft an der Welle

T … Torsionsmoment

i … Anzaℎl der Keile am Umfang

ℎ … Keilℎöℎe
lT … Traglänge der Verbindung

k … Tragfaktor

Gewählt: DIN ISO 14, mittlere Reihe, 6x28x34, Innenzentrierung, Traglänge 25mm

Flankenpressung

p =

Fu
ℎ ∙ lT ∙ i ∙ k

(Decker, Formel 12.3)

Mit Fu =

T
0,25 (d1+d2)

=

240Nm
0,25 (28mm+34mm)

= 15,48kN

Mit ℎ = 0,5 (d1 − d2

) = 0,5(34mm − 28mm) = 3mm

p =

15,48kN
3mm ∙ 25mm ∙ 6 ∙ 0,75

p ≈ 45,9

N
mm²

Bei einseitigen starken Stößen und Stahl als Wellenwerkstoff (nach Decker Tab. 12.1):

pzul = 0,6p0 = 0,6 ∙ 150

N
mm² = 90

N
mm²

S =

pzul
p

≈ 2

Das Dreifach-Kettenrad ist 34,9mm breit, das heißt, seine Traglänge ist größer als 25mm und

die Sicherheit somit auch noch höher.

Iteratives Vorgehen:

Mit dieser Keilwelle ist die Kerbspannung zu hoch, die Welle würde der Dauerbelastung an

der Kerbstelle nicht standhalten (siehe Abschnitt 2.3). Es wird ein größerer Nenndurchmesser

benötigt, der Außendurchmesser der Keilwelle darf allerdings nicht über 39mm ansteigen,

damit die Kugellager noch aufgepresst werden können. Neue Wahl:

DIN ISO 14, leichte Reihe, 8x32x36, Innenzentrierung, Traglänge 25mm

Flankenpressung

p =

Fu
ℎ ∙ lT ∙ i ∙ k

(Decker, Formel 12.3)

Mit Fu =

T
0,25 (d1+d2)

=

240Nm
0,25 (32mm+36mm)

= 14,12kN

Mit ℎ = 0,5 (d1 − d2

) = 0,5(36mm − 32mm) = 2mm

p =

14,12kN
2mm ∙ 25mm ∙ 8 ∙ 0,75

p ≈ 47,07

N
mm²

Bei einseitigen starken Stößen und Stahl als Wellenwerkstoff (nach Decker Tab. 12.1):

pzul = 0,6p0 = 0,6 ∙ 150

N
mm² = 90

N
mm²

47,07

N
mm² = p < pzul = 90

N
mm²

→ die Keilwellenverbindung kann das Drehmoment sicher übertragen

Das Dreifach-Kettenrad ist 34,9mm breit, das heißt, seine Traglänge ist größer als 25mm und

die Sicherheit somit auch noch höher.

Das Kettenrad ist ab Werk mit einer Nabenbohrung von 25mm vorgebohrt. Die Keilverzahnung

wird durch Räumen oder Stoßen hergestellt.

### 5.4 Nachrechnung der Passfederverbindung zwischen Kettenrad und

### Motorwelle

Die Passfeder auf der Motorwelle ist vom Hersteller vorgegeben. Im Folgenden soll

nachgerechnet werden, dass die dabei auftretende Flächenpressung zu keinerlei plastischen

Verformungen führt.

Die Berechnung erfolge nach Decker [2], [3], [4].

Passfeder DIN 6885 - A - 10 x 8 x 60
p … Flankenpressung

Fu … Umfangskraft an der Welle

T … Torsionsmoment
i … Anzaℎl der Passfedern am Umfang

ℎ … Keilℎöℎe
lT … Traglänge der Verbindung

Flankenpressung

p =

Fu
(ℎ − t1) ∙ lT ∙ i

(Decker, Formel 12.2)

mit Fu =

2T
d

=

2 ∙ 240Nm
35mm

= 13,71kN

p =

13,71kN
(8mm − 5mm) ∙ 60mm ∙ 1

p ≈ 76,19

N
mm²

Bei einseitigen starken Stößen und Stahl als Wellenwerkstoff (nach Decker Tab. 12.1):

pzul = 0,6p0 = 0,6 ∙ 150

N
mm² = 90

N
mm²

76,19

N
mm² = p < pzul = 90

N
mm²

→ die Passfederverbindung kann das Drehmoment sicher übertragen

Das Kettenrad ist ab Werk mit einer Nabenbohrung von 25mm vorgebohrt. Die Passfedernut

wird durch Räumen oder Stoßen hergestellt.

### 5.5 Axiale Fixierung des Kettenrades

Die axiale Fixierung des Kettenrades erfolgt mit einer Sicherungsmutter. Sicherungsmuttern

sind im Gewinde polygonförmig, sodass beim Anziehen plastische Verformung auftritt und die

Mutter somit vor Verlieren gesichert ist. Die Sicherungsmutter ist ein Einwegteil, kann also bei

einer Demontage nicht wiederverwendet werden. Da es sich jedoch um ein Standardteil

handelt, stellt dies kein Problem dar. Die Alternative wäre eine Kronenmutter. Der Nachteil

dieser ist jedoch, dass die zur Fixierung notwendige Querbohrung exakt so ausgerichtet sein

muss, dass die optimale Klemmwirkung erreicht wird und die Mutter dann auch in dieser

Position bleibt. Aufgrund dieser Flexibilität fiel die Wahl auf die Sicherungsmuttern.

Der Werkstoff 42CrMo4 mit einer Streckgrenze von Re=650N/mm^2 entspricht in etwa einer

Schraube mit der Festigkeitsklasse 8.8, die nach [1] eine Streckgrenze von 640N/mm^2

besitzt. Somit kann das Gewinde am Wellenende mit einer 8.8-Schraube verglichen werden.

Ebenfalls nach [1] sind für 8.8-Schrauben Muttern der Festigkeitsklassen 8 bis 12 zulässig.

Aus Kostengründen und weil die Mutter keine Klemmwirkung, sondern nur eine

Fixierungswirkung hat, wird eine Mutter der Festigkeitsklasse 8 gewählt.
Das Anzugsmoment ergibt sich aus folgenden Überlegungen: Nach Decker [3] Tab. 10.8 mit

einem Reibwert von 0,16 ist das Anziehmoment MAzul = 800Nm. Dadurch kommt eine hohe

Belastung auf die Distanzhülse. Die Belastungsfälle sind Knicken und Flächenpressung.

Knicken kann aufgrund der Versteifung durch die innenliegende Welle ausgeschlossen

werden. Für die Flächenpressung auf die Distanzhülse ergibt sich:

p =

F
A

=

FMzul
A

=

161000N
π
4

(45² − 40²)mm²

= 482,3

N
mm²

pzul = 900

N
mm²

nacℎ Decker [3] Tab. 10.12 für 42CrMo4

Die Sicherheit beträgt somit 1,9 und ist ausreichend.

## 6 Alternative Bauform mit gedrehtem Antrieb

Es soll eine alternative Bauform mit um 90° gedrehtem Antrieb angeboten werden. Der Motor

befände sich damit unterhalb des Bands. Daraus ergeben sich geänderte Lagerkräfte, die eventuell eine Änderung in der Lagerauswahl erfordern. Außerdem muss gewährleistet sein,

dass der Motor unter dem Band Platz findet. Der Aufbau kann folgendermaßen visualisiert

werden:

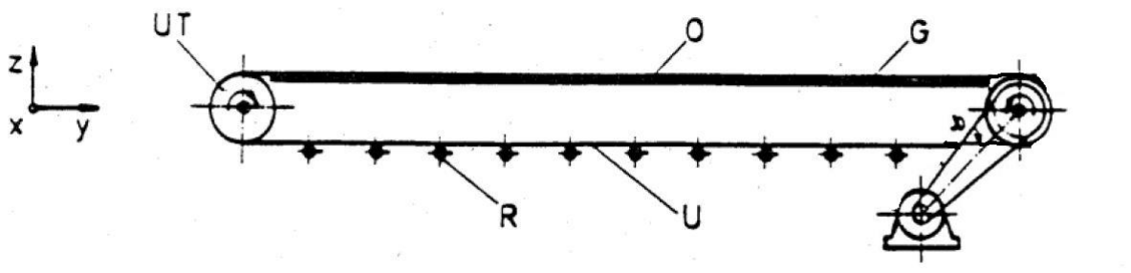
[picture p75: figure]

### 6.1 Berechnung der Lagerkräfte

Die Lagerkräfte in der X-Z-Ebene bleiben identisch zur Version mit Antrieb in die andere

Richtung (vgl. Abschnitt 4.1 Berechnung der Lagerkräfte).

FBz | ≈ | −2231,0N
FAz | ≈ 340,4N

In der X-Y-Ebene wird die Richtung der Kettenkraft invertiert, die restlichen Kräfte behalten

ihre Richtung bei.

Moment um Lager A im Uhrzeigersinn:

FZUG1 ∙ 65mm + FZUG2 ∙ 225mm − FBy ∙ 290mm + FKy ∙ 355mm = 0

2500N ∙ 65mm + 2500N ∙ 225mm − FBy ∙ 290mm + 1844,6N ∙ 355mm = 0

FBy ≈ 4759,1N

Kräftegleichgewicht nach unten:

−FAy − FBy + FKy + FZUG1 + FZUG2 = 0

−FAy − 3896,0N + 1844,6N + 2500N + 2500N = 0

FAy ≈ 2086,6N

Zusammenfassung der Lagerkräfte:

FA = √FAy
2 + FAz

2 = √(2086,6N)
2 + (340,4N)

2

FA ≈ 2114,2N

FB = √FBy
2 + FBz

2 = √(4759,1N)
2 + (−2331,0N)

2

FB ≈ 5298,4N

### 6.2 Änderungen bzgl. der Lagerauswahl

Die Lagerlebensdauern mit den für die erste Bauform gewählten Lagern werden mit den neuen

Lagerkräften überprüft:

LA,10ℎ,gedreℎt,6008 =

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
17kN
2114,2N

)

3
∙

10⁶
80 ∙ 60 1
ℎ

LA,10ℎ,gedreℎt,6008 ≈ 108309ℎ

LB,10ℎ,gedreℎt,6008 =

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
17kN
5298,4N

)

3
∙

10⁶
80 ∙ 60 1
ℎ

LB,10ℎ,gedreℎt,6008 ≈ 6881ℎ

Am Lager B würde die geforderte Lebensdauer von 30000h deutlich unterschritten werden.

Das Lager mit der nächstgrößeren dynamischen Tragzahl Cdyn wird gewählt, der

Innendurchmesser d=40mm wird beibehalten. Nach Decker Tab 18.3 ist dies das

Rillenkugellager nach DIN 625 6208 mit Cdyn=29kN. Es ist geringfügig breiter (B=18mm statt

B=15mm) und hat einen größeren Außendurchmesser (D=80mm statt D=68mm). Damit würden konstruktive Änderungen am Lagergehäuse und an der Welle nötig, auf die an dieser

Stelle nicht weiter eingegangen werden soll.

Die neuen Lebensdauern der Lager betragen:

LA,10ℎ,gedreℎt,6208 =

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
29kN
2114,2N

)

3
∙

10⁶
80 ∙ 60 1
ℎ

LA,10ℎ,gedreℎt,6208 ≈ 537668ℎ

LB,10ℎ,gedreℎt,6208 =

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
29kN
5298,4N

)

3
∙

10⁶
80 ∙ 60 1
ℎ

LB,10ℎ,gedreℎt,6208 ≈ 34160ℎ

### 6.3 Auswirkungen auf die Welle

Aufgrund der breiteren Lager müssten die Längen der Wellenabsätze angepasst

werden. Die Lagersitze müssten verbreitert werden. Um den Lagermittenabstand

konstant zu halten, würden andere Wellenabschnitte verkürzt. Die Welle würde den

Spannungen trotz der höheren Lagerkräfte standhalten. Das maximale Biegemoment

würde auf weniger als 170Nm fallen. Die genaue Querschnittsberechnung, allerdings ohne konstruktive Änderungen der Welle, sind im Anhang zu finden.

## 7 Montage- und Demontageanleitung

### 7.1 Montageanleitung- Variante B (Spannpressverband)

1. Überprüfen Sie den Lieferumfang mit Hilfe der Stückliste. 2. Schweißen Sie mit einer umlaufenden Kehlnaht (einseitig, von außen, a = 5 mm) die beiden Seitenwände auf das Rohr mit Außendurchmesser 85 mm. Die äußeren Kanten der Seitenwände sollen einen Abstand von 190 mm haben. Es ist auf die Rechtwinkligkeit von Rohr und Seitenwänden zu achten.

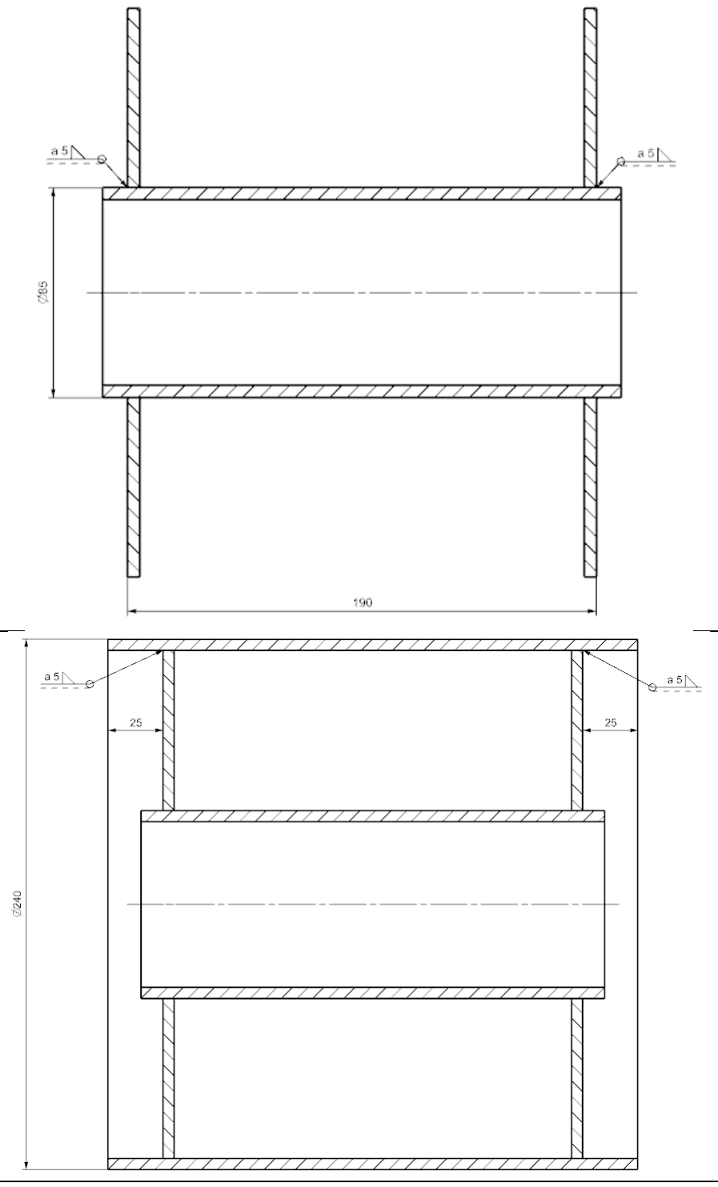
[picture p76: figure]

3. Verschweißen Sie das Rohr mit Außendurchmesser 240 mm mit den in der in Schritt 2 hergestellten Baugruppe. Dabei ist darauf zu achten, dass auf beiden Seiten der gleiche Abstand 25 mm von Rohrende zu Seitenwand eingehalten wird. Anschließend brünieren sie die Welle und die komplette Schweißbaugruppe.
4. Stecken Sie die Spannpressverbände auf beiden Seiten auf die Welle und schieben Sie sie bis zum Anschlag. Anschließend führen Sie das eben verschweißten Teil über die Spannpressverbände und richten es mittig aus.

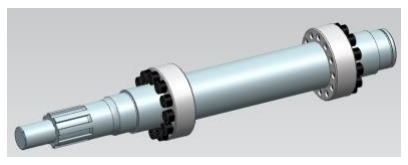
[picture p77: figure]

5. Ziehen Sie die Schrauben der Spannsätze mit 37 Nm an.

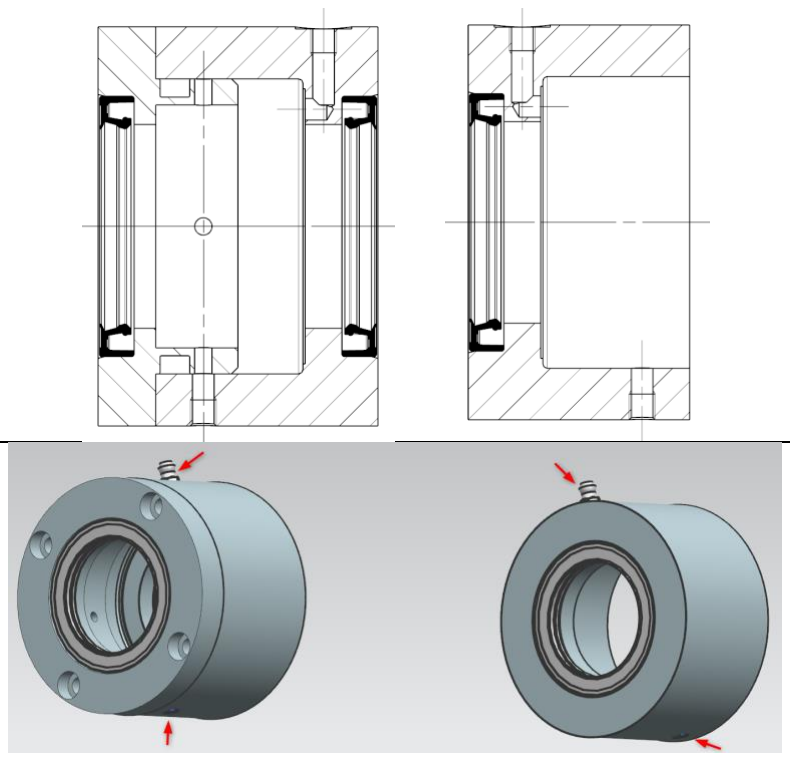
[picture p78: figure]

6. Montieren Sie die Radialwellendichtringe in die beiden Gehäuse und in den Deckel mit Durchgangsloch. Achten Sie darauf, die Ringe nicht zu beschädigen. Für die richtige Orientierung beachten Sie das nebenstehende Bild.
7. Schrauben Sie in beide Gehäuse den Schmiernippel in die dafür vorgesehenen Bohrungen. Montieren Sie auf der gegenüberliegenden Seite in die beiden Gehäuse die Stopfen.

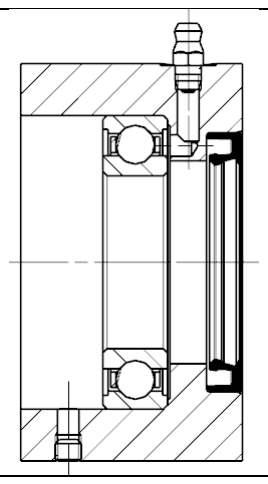
[picture p79: figure]
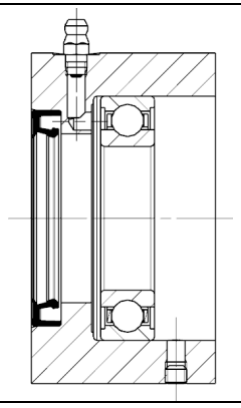
[picture p80: figure]

8. Platzieren Sie die beiden Kugellager mit Hilfe einer geeigneten Vorrichtung in den Gehäusen.

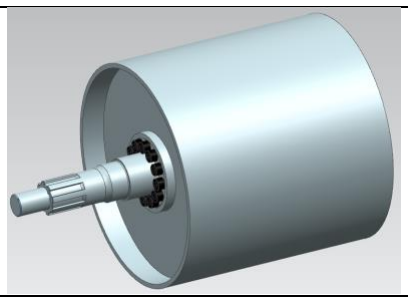
[picture p81: figure]

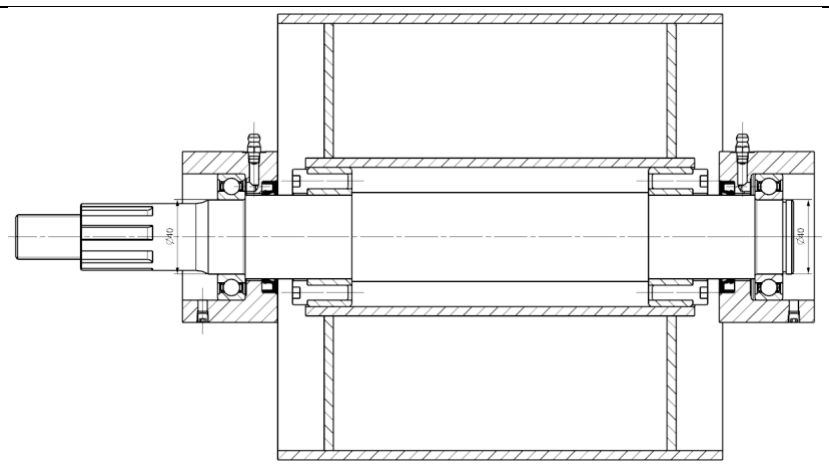
[picture p82: figure]

9. Stecken Sie die beiden Gehäuse mit Radialwellendichtring, Schmiernippel, Stopfen und Kugellager auf beide Seiten der Welle. Pressen Sie dabei das Kugellager auf den Wellendurchmesser 40 mm.

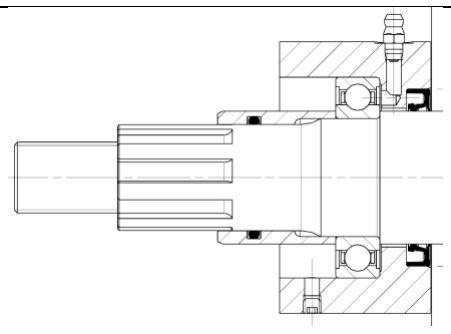
[picture p83: figure]

10. Führen Sie die Distanzhülse mit dem O -Ring (Ø 33,1 x 3,53) auf das Wellenende mit der Keilwelle mit der Seite des größeren Innendurchmessers zuerst.
11. Montieren Sie die großen O-Ringe (Ø 62,9 x 5,33) in die Deckelnuten.

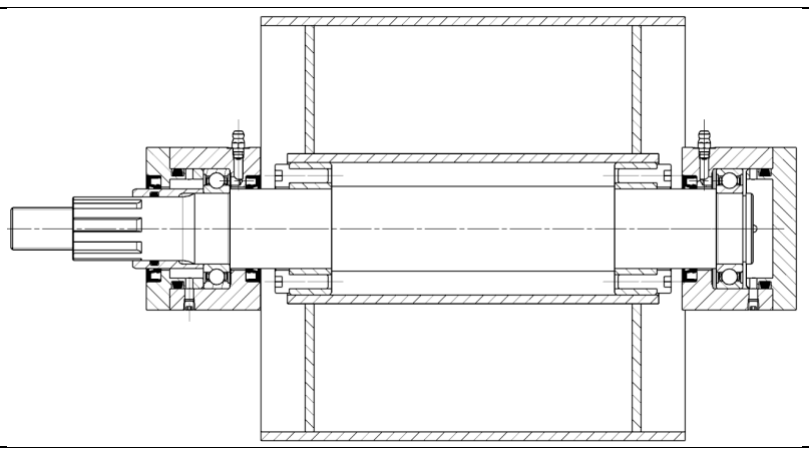
[picture p84: figure]

12. Stecken Sie die Deckel auf die beiden Enden der Welle und schrauben Sie diesen mit einem Anziehmoment von 11,2 Nm fest.

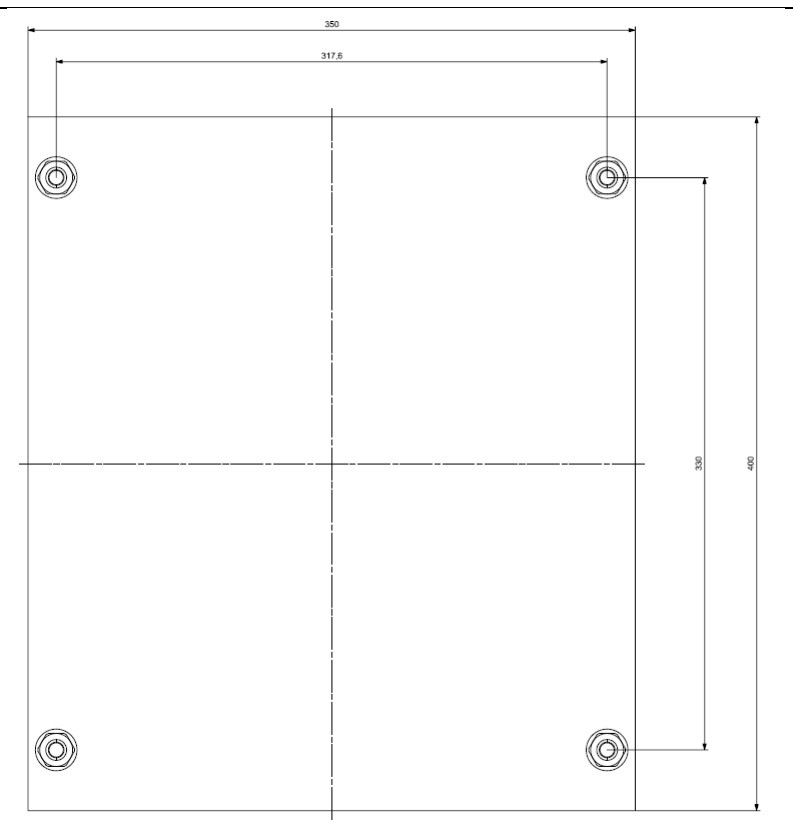
[picture p85: figure]

13. Bohren Sie in den
Betonklotz vier Löcher (Ø
12 mm, Tiefe: 105 mm)
für die Bolzenanker nach
nebenstehender Skizze.
14. Reinigen Sie die
Bohrlöcher.

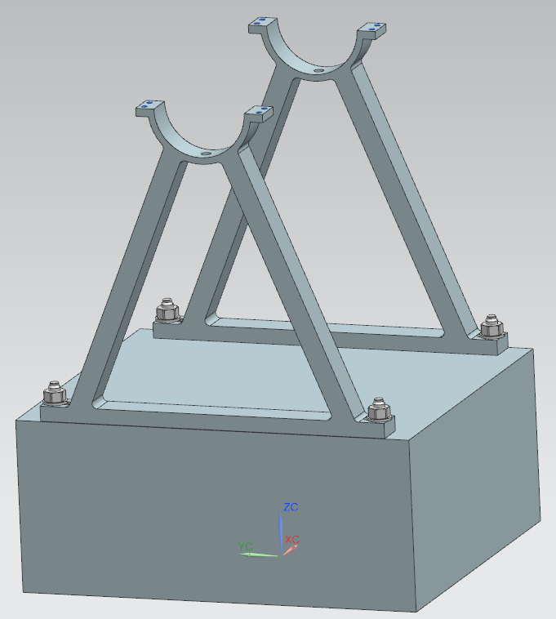
[picture p86: figure]

15. Positionieren Sie die
Unterteile der Lagerböcke
wie im nebenstehenden
Bild auf dem Betonklotz.
16. Nehmen Sie die
Bolzenanker und
schlagen Sie die Anker
mit Hilfe eines Hammers
in die Löcher ein.
17. Ziehen Sie die
Bolzenanker so fest an,
sodass die Lagerböcke im
Bereich der Langlöcher
noch verschoben werden
können.
18. Achten Sie auf die
Parallelität der
Lagerböcke.

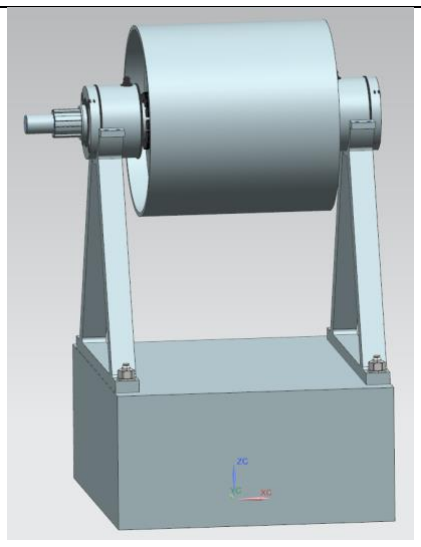
[picture p87: figure]

19. Legen Sie die vormontierte Wellen-Baugruppe in die Lagerböcke. Achten Sie darauf, dass die axiale Ausrichtung zu keinerlei Kollisionen führt.

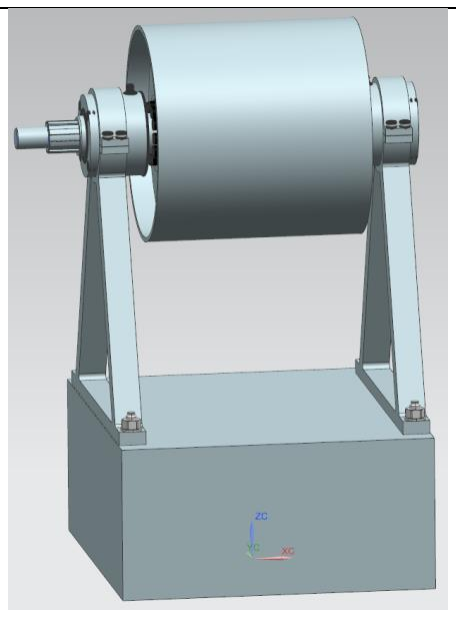
[picture p88: figure]

20. Setzen Sie die Oberteile der Lagerböcke auf die Lager. 21. Verschrauben Sie die Oberteile der Lagerböcke mit den Unterteilen der Lagerböcke mit acht Innensechskantschrauben (M6 x 16) 22. Ziehen Sie die Schrauben mit einem Anziehmoment von T=11,2Nm an.
23. Ziehen Sie die Bolzenanker nach genauem Ausrichten der Baugruppe mit einem Anziehmoment von 60 Nm an.

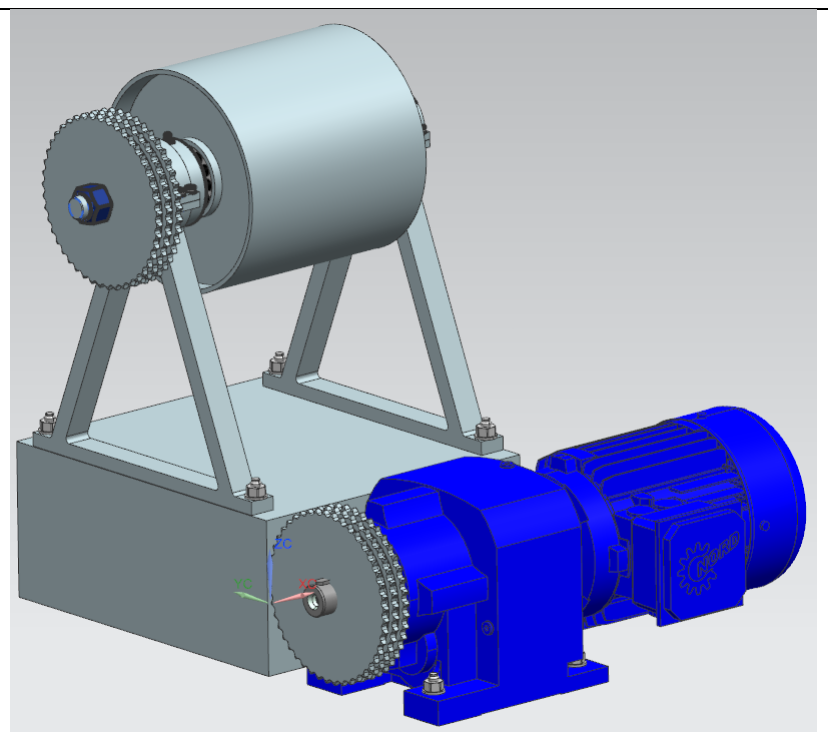
[picture p89: figure]

24. Stecken Sie das
Kettenrad mit
Keilfedernabe auf den
Wellenabschnitt mit der
Keilwelle.
25. Positionieren Sie den
Motor wie im
nebenstehenden Bild und
befestigen Sie ihn ebenso
mit vier Betonankern.
26. Stecken Sie das
Kettenrad mit
Passfedernabe auf die
Antriebswelle des Motors.

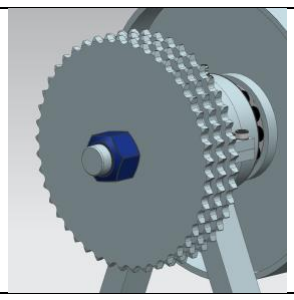
[picture p90: figure]

27. Montieren Sie Sechskantmutter mit Klemmteil (M24) auf die Welle der Antriebstrommel und ziehen Sie diese mit einem Anziehmoment von 800 Nm fest.
28. Montieren Sie die Dreifachrollenkette auf die beiden Kettenräder und schließen Sie diese mit dem Verschlussglied.

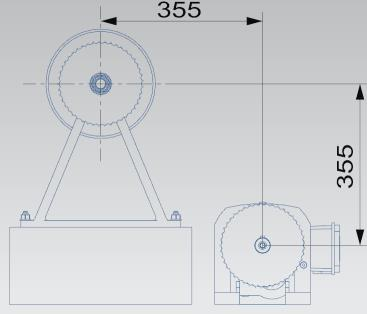
[picture p91: figure]

### 7.2 Montageanleitung- Variante A (Schweißkonstruktion)

Die Montageanleitung für die Variante A weicht von der der Variante B nur in wenigen Punkten ab, die nachfolgend erläutert werden.

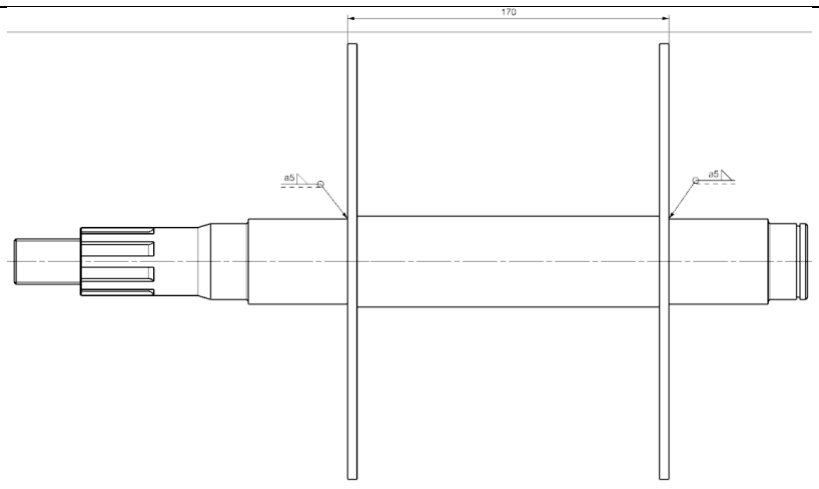
[picture p92: figure]

1. Überprüfen Sie den Lieferumfang mit Hilfe der Stückliste. 2. Schweißen Sie mit einer umlaufenden Kehlnaht (einseitig, von außen, a = 5 mm) die beiden Seitenwände auf die Welle. Die äußeren Kanten der Seitenwände sollen einen Abstand von 170 mm haben. Es ist auf die Rechtwinkligkeit von Welle und Seitenwänden zu achten.
3. Schieben Sie die Trommel über die Seitenwände. 4. Schweißen Sie mit einer umlaufenden Kehlnaht (einseitig, von außen, a = 5 mm) die Trommel auf die Seitenwände. Es ist auf die Rechtwinkligkeit von Seitenwänden und Trommel zu achten.

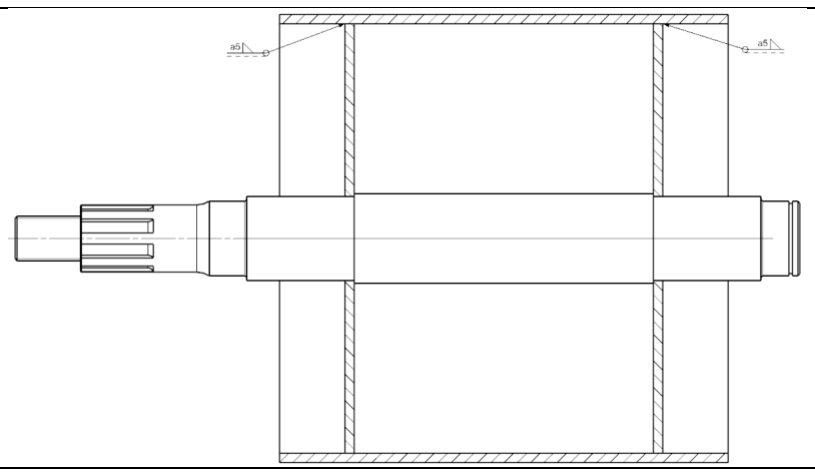
[picture p93: figure]

Die weitere Montage erfolgt wie bei der Spannpressverband-Variante (ab Punkt 6).

### 7.3 Demontage

Die Demontage erfolgt in umgekehrter Reihenfolge zur Montageanleitung. Verwenden

Sie zur Demontage der Kugellager eine geeignete Demontagevorrichtung.

## 8 Visualisierung

### 8.1 Gesamtansicht

Die Antriebstrommel wurde mithilfe eines CAD- Systems wie folgt visualisiert.

Im nachfolgenden Bild sieht man die Antriebstrommel der Variante B (Spann-

pressverband) in einer trimetrischen Ansicht, ohne den Betonklotz, ohne Kette und

ohne Motor. Es werden einige Bauteile transparent angezeigt, um das Innenleben

besser sichtbar zu machen.

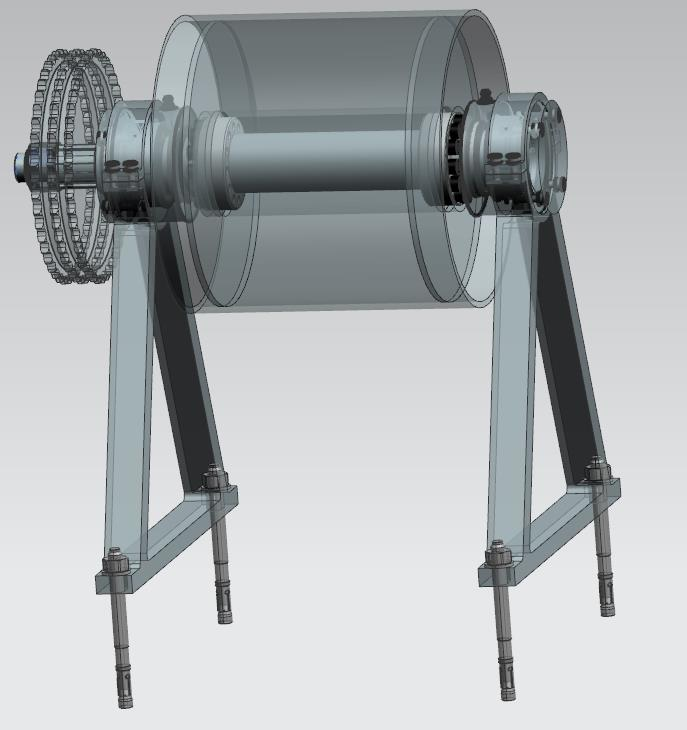
[picture p94: figure]

Dieses Bild zeigt die Antriebstrommel von der Seite.


### 8.2 Explosionsansicht

In der Explosionsansicht sind alle Komponenten zu sehen. Auch hier handelt es sich

um die Variante B (Spannpressverband).

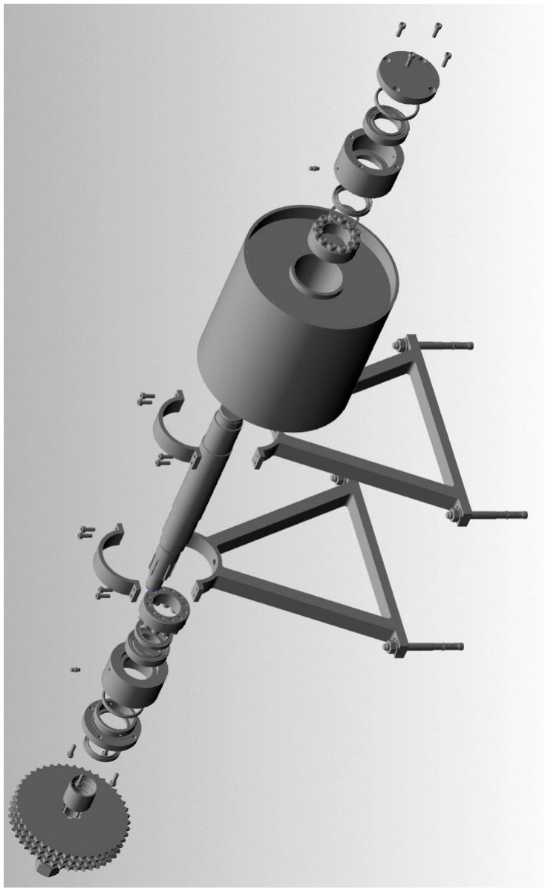
[picture p95: figure]

## 9 Literaturverzeichnis

[1] Gomeringer, Roland u. a.: Tabellenbuch Metall, 47. Auflage, Haan-Gruiten

2017

[2] Decker, Karl-Heinz: Decker Maschinenelemente: Funktion, Gestaltung und

Berechnung, 20. Auflage, München 2018

[3] Decker, Karl-Heinz: Tabellen und Diagramme, 19. Auflage, München, 2014
[4] Decker, Karl-Heinz: Formeln, 7. Auflage, München, 2014
[5] Steinhilper, Waldemar u.a.: Maschinen- und Konstruktionselemente 1,

4.Auflage, Berlin 1994

[6] SFS unimarket AG: fischer Bolzenanker FAZ II, Heerbrugg 2017
