MattdewT/KE3/Projektbericht-mögliche-Gliederung.docx

Antriebstrommellagerung eines Bandförderers

Konstruktionsentwurf im Fach Konstruktionslehre 3

des Studienganges Maschinenbau

an der Dualen Hochschule Baden-Württemberg Heidenheim an der Brenz

von

Hofmann, Tanja

Hopf, Marie

Langohr, Anika

Tiroch, Matthias

Abgabe: 28. November 2019

Bearbeitungszeitraum 9 Wochen

Matrikelnummern 3662013, 1790705, 3225750

Kurs TM 2018 KM

Ausbildungsfirma BSH, Bosch AS,

Anhang

1. Norelem, Technischer Hinweis für O-Ringe, S.5
2. COG, Das O-Ring 1x1 - Alles rund um die O-Ring-Dichtung S.13-25
3. COG, Elastomerdichtungen für höchste Anforderungen, S. 20
4. igus, Der Allround-Klassiker - Iglidur® G, S. 1-6
5. Kaiser & Waltermann, Rohrabschnitte, S.1-2
6. Spannkraftverlauf 5 bar
7. Prinzipskizze
8. Zusammenbauzeichnung
9. Einzelteilzeichnungen (Kolbenstange, Deckel, Finger, Führungsstange, Gehäuse, Gelenkteil, Kolben)
10. Stückliste
11. Montage- und Demontageanleitung
12. Datenblatt
13. Projektzeitplan
14. Aufgabenstellung
15. Team- Checkliste
16. Eigenständigkeitserklärung

# 1 Einleitung

Bandförderer, umgangssprachlich auch Förderbänder genannt, übernehmen in Produktionsprozessen eine wichtige Rolle. Stetigförderer sorgen dafür, dass Roh- oder Fertigteile auch über weite Distanzen und in hoher Stückzahl zum nächsten Bearbeitungsschritt transportiert werden können. Eine zentrale Rolle nimmt die Antriebstrommel ein. Deshalb soll in der folgenden Arbeit eine Antriebstrommel mit Lagerung entwickelt werden, die speziell an die vorgegebenen Bedürfnisse angepasst ist.

Die Antriebstrommellagerung des Bandförderers wird auf der Basis exakter Auslegungsrechnungen konstruiert und mit gängigen Referenzwerten auf die Haltbarkeit bei dynamischer Belastung geprüft. Die Visualisierung der Antriebstrommellagerung ist einer ausführlichen CAD- Datei mit passender Stückliste zu entnehmen.

## 1.1 Vorgehen

Nach dem folgenden Schema wurden die notwendigen Berechnungen sortiert und organisiert.

## 1.2 Terminplan

## 1.3 Anforderungsliste

In der folgenden Anforderungsliste werden alle Forderungen und Wünsche an den Parallelgreifer zusammengestellt. Diese Zusammenstellung dient dazu, eine übersichtliche Darstellung der geforderten Randbedingungen zu bekommen.

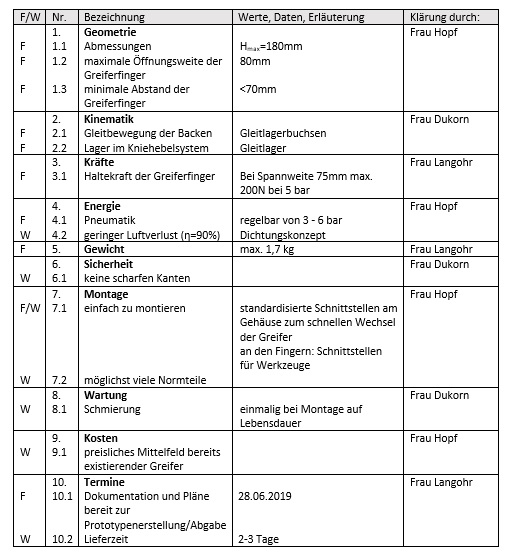
[picture p102: figure]

## 1.4 Morphologischer Kasten

Da es eine Vielzahl an einzelnen Teilfunktionen und anschließenden Gesamtlösungsprinzipien gibt, wurde ein morphologischer Kasten erstellt. Ziel der Gegenüberstellung ist, die optimale Kombination der verschiedenen Varianten zu finden.

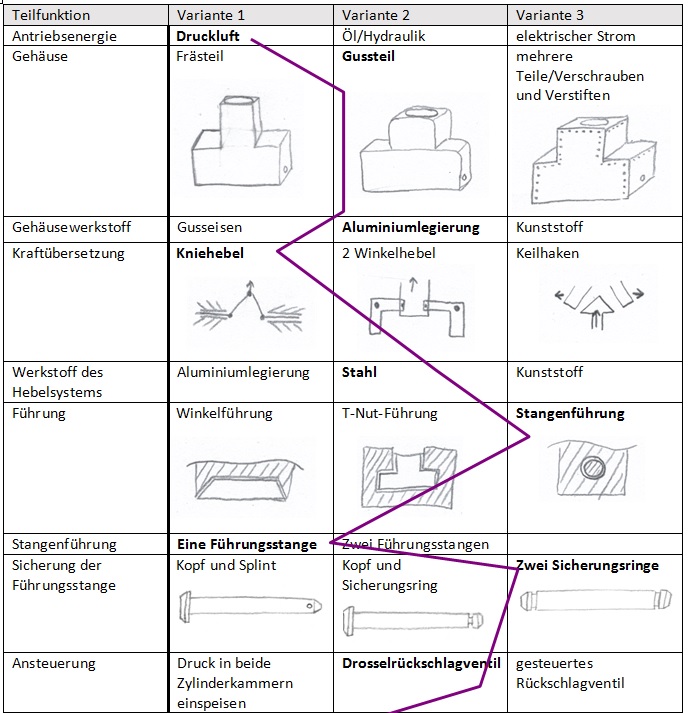
[picture p103: figure]
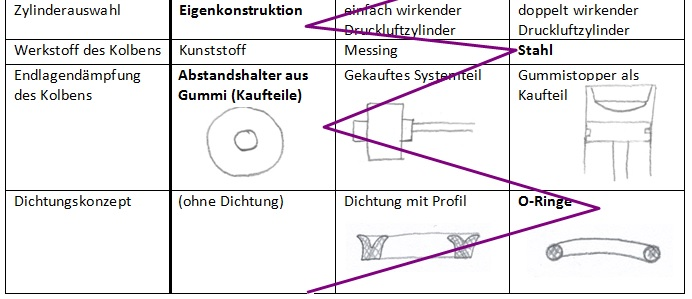
[picture p104: figure]
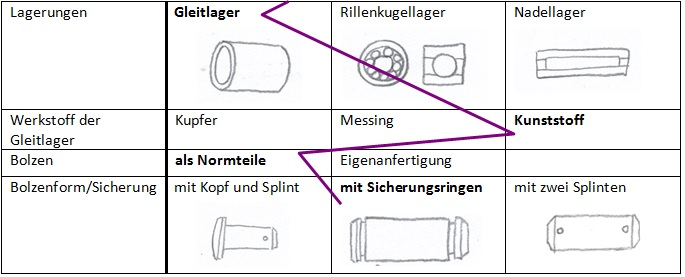
[picture p105: figure]

# 2 Welle

## 2.1 Lageplan und Schnittgrößenverlauf der Kräfte

## 2.2 Berechnung der Wellenquerschnitte und Auswahl des Werkstoffes

### 2.2.1 Variante A - Schweißkonstruktion

### 2.2.2 Variante B - Spannpressverband

## 2.3 Wellendurchbiegung und Biegewinkel in den Lagerstellen

## 2.4 Bewertung der Haltbarkeit unter statischer Belastung

## 2.5 Bewertung der Haltbarkeit unter dynamischer Belastung

Smith-Diagramm

### 2.5.1 Variante A - Schweißkonstruktion

### 2.5.2 Variante B - Spannpressverband

# 3 Trommel

## 3.1 Auslegung der Verbindung Welle - Trommel

### 3.1.1 Variante A - Schweißkonstruktion

### 3.1.2 Variante B – Spannpressverband

## 3.2 Abgewickelte Länge der Trommel

# 4 Lager

## 4.1 Berechnung der Lagerkräfte

## 4.2 Auswahl der Lager

## 4.3 Dynamische Tragzahlen und Lagerlebensdauer

## 4.4 Schmierung der Lager und Abdichtung

## 4.5 Kaufteildokumentation der Lager

## 4.6 Schraubenberechnung des Deckels

## 4.7 Lagerböcke

### 4.7.1 Schraubenberechnung

# 5 Antrieb

## 5.1 Auswahl des Elektromotors

## 5.2 Auslegung des Dreifach-Kettentriebes

## 5.3 Auslegung der Keilwellenverbindung zwischen Welle und Kettenrad

## 5.4 Axiale Fixierung des Kettenrades

# 6 Alternative Bauform mit gedrehtem Antrieb

## 6.1 Berechnung der Lagerkräfte

## 6.2 Änderungen bzgl. der Lagerauswahl

# 7 Montage- und Demontageanleitung

# 8 Visualisierung

## 8.1 Gesamtansicht

Der Parallelgreifer wurde mithilfe eines CAD- Systems wie folgt animiert:

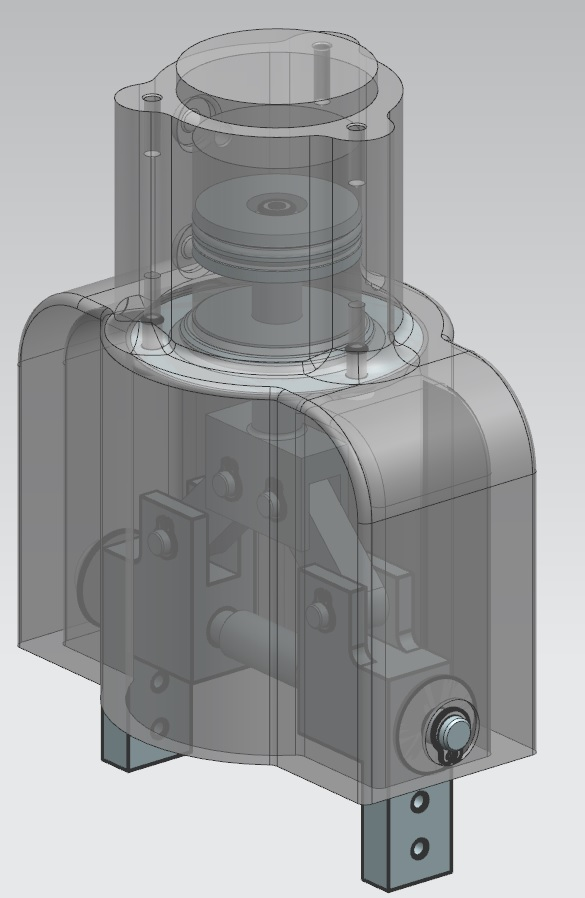
[picture p106: figure]

## 8.2 Explosionsansicht

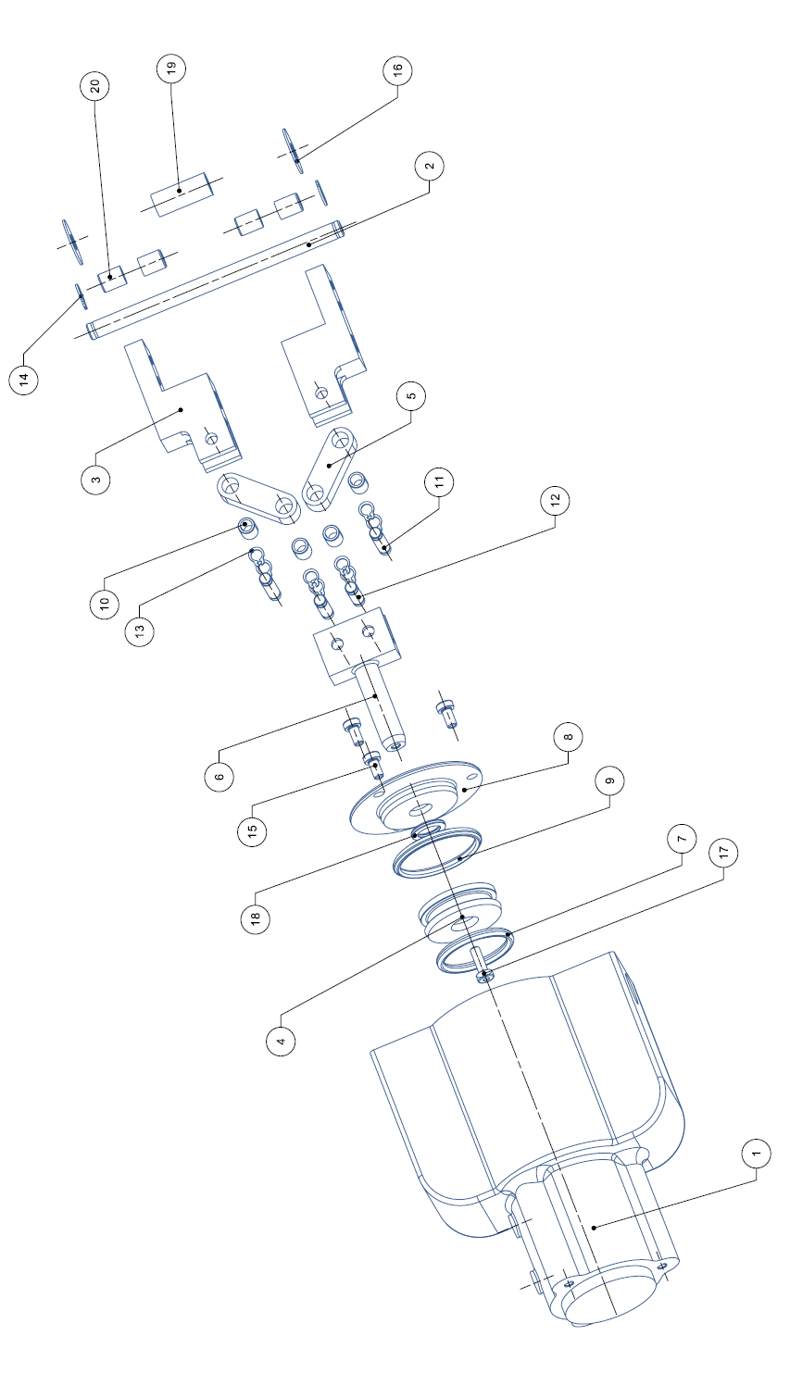
[picture p107: figure]

# 10 Literaturverzeichnis

Ggf. Logo der Ausbildungs- firma
