MattdewT/KE3/RB-Blessing/Pareto-Diagramm.docx

Risikobewertung, TM2018KM, Matrikelnummern 5620331, 3225750, 1790705, 9269794
