MattdewT/KE3/RB-Blessing/Warnsymbole.docx

# Maßnahmen: Warn-, Gebots- und Verbotszeichen und Gefahrensymbole verwenden

Zuordnung zu den FFU-Ketten in der FMEA-Tabelle

Nr. 14: Warnzeichen „Warnung vor elektrischer Spannung“

Nr. 15: Warnzeichen „Warnung vor elektrischer Spannung“

Nr. 16: Warnzeichen „Warnung vor elektrischer Spannung“

Nr. 17: Warnzeichen „Warnung vor elektrischer Spannung“

Nr. 34: Gebotszeichen „Gehörschutz benutzen“

Nr. 39: Warnzeichen „Warnung vor herabfallenden Gegenständen“

Warnzeichen „Warnung vor Hindernissen am Boden“

Nr. 43: Verbotszeichen „Benutzen von Handschuhen verboten“

Verbotszeichen „Hineinfassen verboten“

Verbotszeichen „Zutritt für Unbefugte verboten“

Warnzeichen „Warnung vor automatischen Anlauf“

Warnzeichen „Warnung vor Handverletzungen“

Nr. 51: Warnzeichen „Warnung vor herabfallenden Gegenständen“

Nr. 58: Gefahrensymbol „Umweltgefährlich“

Warnzeichen „Warnung vor feuergefährlichen Stoffen“

Nr. 59: Gefahrensymbol „Umweltgefährlich“

Warnzeichen „Warnung vor feuergefährlichen Stoffen“

Nr. 61: Gefahrensymbol „Umweltgefährlich“

Warnzeichen „Warnung vor feuergefährlichen Stoffen“

## Zusätzliche, sinnvolle Verbotszeichen:

- Verbotszeichen: „Sitzen verboten“
- Verbotszeichen: „Aufsteigen verboten“
- Verbotszeichen: „Betreten der Fläche verboten“

## Zusammenfassung:

Warnzeichen:

- Warnung vor elektrischer Spannung
- Warnung vor herabfallenden Gegenständen
- Warnung vor Hindernissen am Boden
- Warnung vor automatischen Anlauf
- Warnung vor Handverletzungen
- Warnung vor feuergefährlichen Stoffen

Gebotszeichen:

- Gehörschutz benutzen

Verbotszeichen:

- Benutzen von Handschuhen verboten
- Hineinfassen verboten
- Zutritt für Unbefugte verboten
- (Sitzen verboten)
- (Aufsteigen verboten)
- (Betreten der Fläche verboten)

Gefahrensymbol:

- Umweltgefährlich

Risikobewertung, TM2018KM, Matrikelnummern 5620331, 3225750, 1790705, 9269794
