MattdewT/KE3/RB-Blessing/Drucken/Strukturanalyse.docx

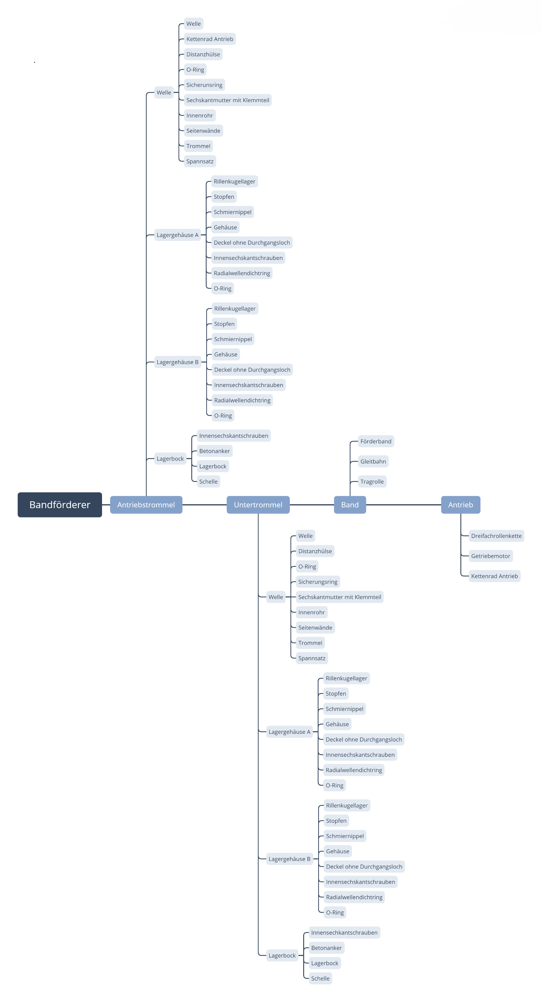
[picture p134: figure]

Strukturanalyse

Struktur-, Funktions- und Fehleranalyse

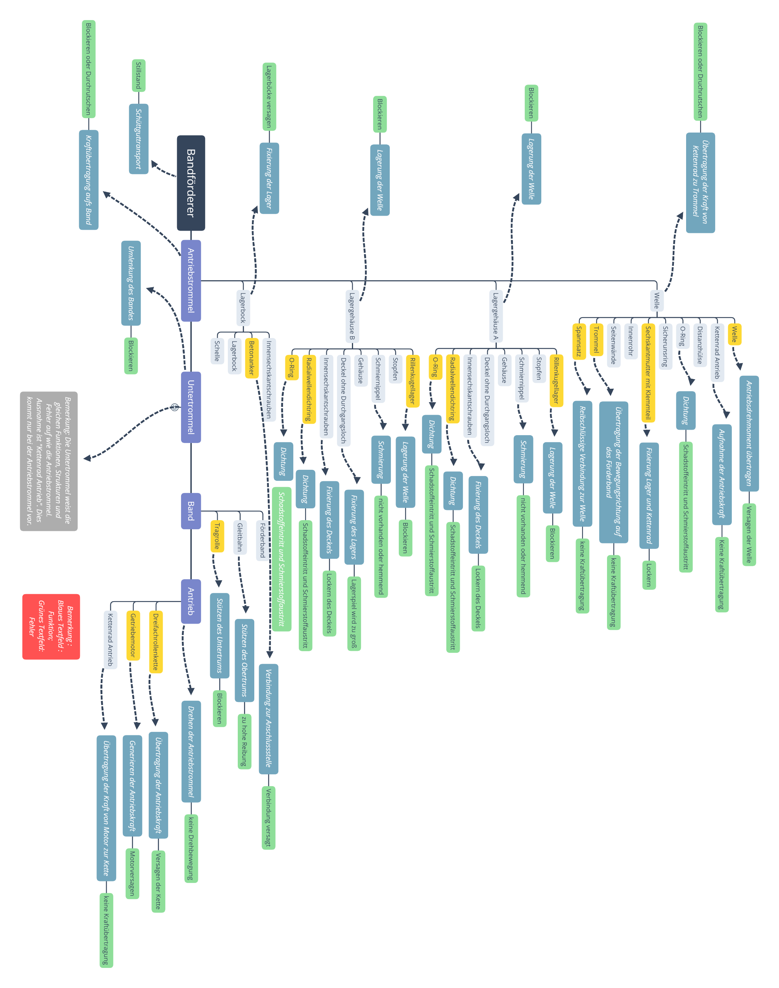
[picture p135: figure]
