MattdewT/KE3/KissSoft-Wellenberechnung-2.pdf

KISSsoft Release 2019 A

KISSsoft Hochschullizenz Duale Hochschule Baden-Wuerttemberg Heidenheim Datei

Name | : | Welle-Test
Geändert von: | langohra.tmb18am: 22.10.2019 | um: 09:52:43

Wichtiger Hinweis: Bei der Berechnung sind Warnungen aufgetreten: 1-> Welle 'Welle 1': Die Summe der Drehmomente ist ungleich null. ΔT = 239.936 Nm Berechnung von Wellen, Achsen und Trägern

Eingabedaten Koordinatensystem Welle: | siehe Bild W-002
Bezeichnung | | Welle 1

Zeichnung
Startposition (mm) | 0.000
Länge (mm) | 395.000
Drehzahl (1/min) | 80.00
Drehrichtung: | im Uhrzeigersinn Werkstoff | 42 CrMo 4 (1)
Elastizitätsmodul (N/mm²) | 206000.000
Poissonzahl nu | 0.300
Dichte (kg/m³) | 7830.000
Wärmeausdehnungskoeffizient (10^-6/K) | 11.500
Temperatur (°C) | 20.000
Gewicht der Welle (kg) | 3.887
Hinweis: Gewicht gilt für die Welle ohne Berücksichtigung der Zahnräder Gewicht der Welle, inklusive Zusatzmassen (kg) | 3.887
Massenträgheitsmoment (kg*mm²) | 777.318
Schwungmoment GD2 (Nm²) | 0.031

Die Gewichtskraft wird nicht berücksichtigt
Zahnräder mit Steifigkeit nach ISO

Schubverformungen werden berücksichtigt

Schubkorrekturfaktor | 1.100

Der Druckwinkel von Wälzlagern wird berücksichtigt

Toleranzlage: | Mittelwert
Referenztemperatur (°C) | 20.000

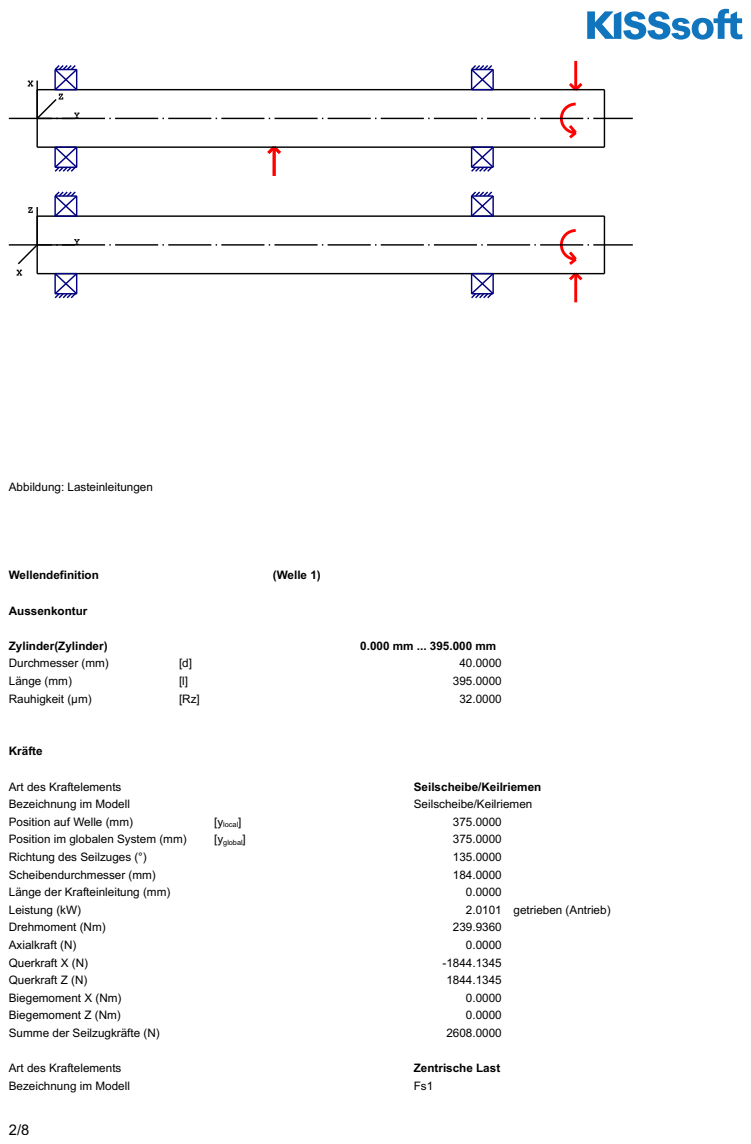
[picture p136: page 2]
Abbildung: Lasteinleitungen Wellendefinition; (Welle 1); Aussenkontur Zylinder(Zylinder); Durchmesser (mm); Länge (mm); Rauhigkeit (µm); Kräfte Art des Kraftelements; Seilscheibe/Keilriemen Bezeichnung im Modell; Seilscheibe/Keilriemen Position auf Welle (mm); [ylocal]; Position im globalen System (mm); [yglobal]; Richtung des Seilzuges (°); Scheibendurchmesser (mm); Länge der Krafteinleitung (mm); Leistung (kW); 2.0101 getrieben (Antrieb); Drehmoment (Nm); Axialkraft (N); Querkraft X (N)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

Position auf Welle (mm) | [ylocal] | 165.0000
Position im globalen System (mm) | [yglobal] | 165.0000
Länge der Krafteinleitung (mm) | | 0.0000
Leistung (kW) | | 0.0000
Drehmoment (Nm) | | -0.0000
Axialkraft (N) | | 0.0000
Querkraft X (N) | | 3500.0000
Querkraft Z (N) | | 0.0000
Biegemoment X (Nm) | | 0.0000
Biegemoment Z (Nm) | | 0.0000
Art des Kraftelements | | Zentrische Last
Bezeichnung im Modell | Fs2
Position auf Welle (mm) | [ylocal] | 165.0000
Position im globalen System (mm) | [yglobal] | 165.0000
Länge der Krafteinleitung (mm) | | 0.0000
Leistung (kW) | | 0.0000
Drehmoment (Nm) | | -0.0000
Axialkraft (N) | | 0.0000
Querkraft X (N) | | 1500.0000
Querkraft Z (N) | | 0.0000
Biegemoment X (Nm) | | 0.0000
Biegemoment Z (Nm) | | 0.0000

Lager

---------------------------------------------------------------------------------------------------------------------------- Bezeichnung im Modell | WälzlagerA
Lager Typ | FAG 6008-2Z
Lager Bauform | | Rillenkugellager (einreihig)
Lager Position (mm) | [ylokal] | 20.000
Lager Position (mm) | [yglobal] | 20.000
Befestigung Aussenring | Loslager
Innendurchmesser (mm) | [d] | 40.000
Aussendurchmesser (mm) | [D] | 68.000
Breite (mm) | [b] | 15.000
Eckradius (mm) | [r] | 0.000
Statische Tragzahl (kN) | [C0] | 11.500
Dynamische Tragzahl (kN) | [C] | 17.800
Tragzahl Ermüdung (kN) | [Cu] | 0.580
Werte für die approximierte Geometrie: Dynamische Tragzahl (kN) | [Ctheo] | 0.000
Statische Tragzahl (kN) | [C0theo] | 0.000
Korrekturfaktor Dynamische Tragzahl | [fC] | 1.000
Korrekturfaktor Statische Tragzahl | [fC0] | 1.000
---------------------------------------------------------------------------------------------------------------------------- Bezeichnung im Modell | WälzlagerB
Lager Typ | FAG 6008-2Z
Lager Bauform | | Rillenkugellager (einreihig)
Lager Position (mm) | [ylokal] | 310.000
Lager Position (mm) | [yglobal] | 310.000
Befestigung Aussenring | Loslager
Innendurchmesser (mm) | [d] | 40.000
Aussendurchmesser (mm) | [D] | 68.000
Breite (mm) | [b] | 15.000

Eckradius (mm) | [r] | 0.000
Statische Tragzahl (kN) | [C0] | 11.500
Dynamische Tragzahl (kN) | [C] | 17.800
Tragzahl Ermüdung (kN) | [Cu] | 0.580
Werte für die approximierte Geometrie: Dynamische Tragzahl (kN) | [Ctheo] | 0.000
Statische Tragzahl (kN) | [C0theo] | 0.000
Korrekturfaktor Dynamische Tragzahl | [fC] | 1.000
Korrekturfaktor Statische Tragzahl | [fC0] | 1.000
Resultate Welle Maximale Durchbiegung (μm) | 152.703
Position des Maximums (mm) | 395.000
Massenschwerpunkt (mm) | 197.500
Summe der axialen Belastung (N) | 0.000
Verdrehung unter Drehmoment (°) | 0.259
Lager Ausfallwahrscheinlichkeit | [n] | 10.00 | %
Axialspiel | [uA] | 10.00 | µm
Schmierstoff | Öl: ISO-VG 220
Schmierstoff - Betriebstemperatur | [TB] | 20.00 | °C

Wälzlager klassisch (Druckwinkel berücksichtigen)

Welle 'Welle 1' Wälzlager 'WälzlagerA' Position (Y-Koordinate) | [y] | 20.00 | mm
Dynamisch äquivalente Belastung | [P] | 2.94 | kN
Äquivalente Belastung | [P0] | 2.94 | kN
Faktor für Ausfallwahrscheinlichkeit | [a1] | 1.000
Ergebnisse nach ISO 281: Lastverhältnis | [C/P] | 6.049
Betriebsviskosität | [ν] | 912.866 | mm²/s Bezugsviskosität | [ν1] | 0.000 | mm²/s Viskositätsverhältnis | [κ] | 0.000
Verunreinigungsbeiwert | [eC] | 0.500
Nominelle Lagerlebensdauer | [Lnh] | 46121.62 | h
Statischer Sicherheitsfaktor | [S0] | 3.91
Lagerreaktionskraft | [Fx] | -2.913 | kN
Lagerreaktionskraft | [Fy] | 0.000 | kN
Lagerreaktionskraft | [Fz] | 0.413 | kN
Lagerreaktionskraft | [Fr] | 2.942 | kN (171.92°)
Ölstand | [H] | 0.000 | mm
Rollreibungsmoment | [Mrr] | 0.059 | Nm
Gleitreibungsmoment | [Msl] | 0.040 | Nm
Reibungsmoment Dichtungen | [Mseal] | 0.000 | Nm

Reibungsmoment Dichtungen nach SKF-Hauptkatalog 17000/1 EN:2018 bestimmt

Reibungsmoment Strömungsverluste | [Mdrag] | 0.000 | Nm
Reibungsmoment | [Mloss] | 0.099 | Nm
Verlustleistung | [Ploss] | 0.831 | W
Das Reibungsmoment wird nach Angaben aus dem SKF-Katalog 2018 berechnet. Es wird immer mit einem Beiwert für Zusätze im Schmierstoff μbl=0.15 gerechnet. Lagerverschiebung | [ux] | 11.862 | µm
Lagerverschiebung | [uy] | 0.000 | µm
Lagerverschiebung | [uz] | -1.816 | µm
Lagerverschiebung | [ur] | 12.000 | µm (-8.71°)
Lagerneigung | [rx] | -0.172 | mrad (-0.59')
Lagerneigung | [ry] | 0.241 | mrad (0.83')
Lagerneigung | [rz] | -1.196 | mrad (-4.11')
Lagerneigung | [rr] | 1.208 | mrad (4.15')
Welle 'Welle 1' Wälzlager 'WälzlagerB' Position (Y-Koordinate) | [y] | 310.00 | mm
Dynamisch äquivalente Belastung | [P] | 2.27 | kN
Äquivalente Belastung | [P0] | 2.27 | kN
Faktor für Ausfallwahrscheinlichkeit | [a1] | 1.000
Ergebnisse nach ISO 281: Lastverhältnis | [C/P] | 7.840
Betriebsviskosität | [ν] | 912.866 | mm²/s Bezugsviskosität | [ν1] | 0.000 | mm²/s Viskositätsverhältnis | [κ] | 0.000
Verunreinigungsbeiwert | [eC] | 0.500
Nominelle Lagerlebensdauer | [Lnh] | 100386.23 | h
Statischer Sicherheitsfaktor | [S0] | 5.07
Lagerreaktionskraft | [Fx] | -0.242 | kN
Lagerreaktionskraft | [Fy] | 0.000 | kN
Lagerreaktionskraft | [Fz] | -2.257 | kN
Lagerreaktionskraft | [Fr] | 2.270 | kN (-96.13°)
Ölstand | [H] | 0.000 | mm
Rollreibungsmoment | [Mrr] | 0.051 | Nm
Gleitreibungsmoment | [Msl] | 0.026 | Nm
Reibungsmoment Dichtungen | [Mseal] | 0.000 | Nm

Reibungsmoment Dichtungen nach SKF-Hauptkatalog 17000/1 EN:2018 bestimmt

Reibungsmoment Strömungsverluste | [Mdrag] | 0.000 | Nm
Reibungsmoment | [Mloss] | 0.077 | Nm
Verlustleistung | [Ploss] | 0.649 | W
Das Reibungsmoment wird nach Angaben aus dem SKF-Katalog 2018 berechnet. Es wird immer mit einem Beiwert für Zusätze im Schmierstoff μbl=0.15 gerechnet. Lagerverschiebung | [ux] | 0.793 | µm
Lagerverschiebung | [uy] | -0.000 | µm
Lagerverschiebung | [uz] | 11.974 | µm
Lagerverschiebung | [ur] | 12.000 | µm (86.21°)
Lagerneigung | [rx] | 0.500 | mrad (1.72')
Lagerneigung | [ry] | 3.735 | mrad (12.84')
Lagerneigung | [rz] | 1.506 | mrad (5.18')
Lagerneigung | [rr] | 1.586 | mrad (5.45')
Schädigung (%), bezogen auf die Soll-Lebensdauer | [Lreq] ( 20000.000 | )
Lastfall | B1 | B2
1 | 43.36 | 19.92

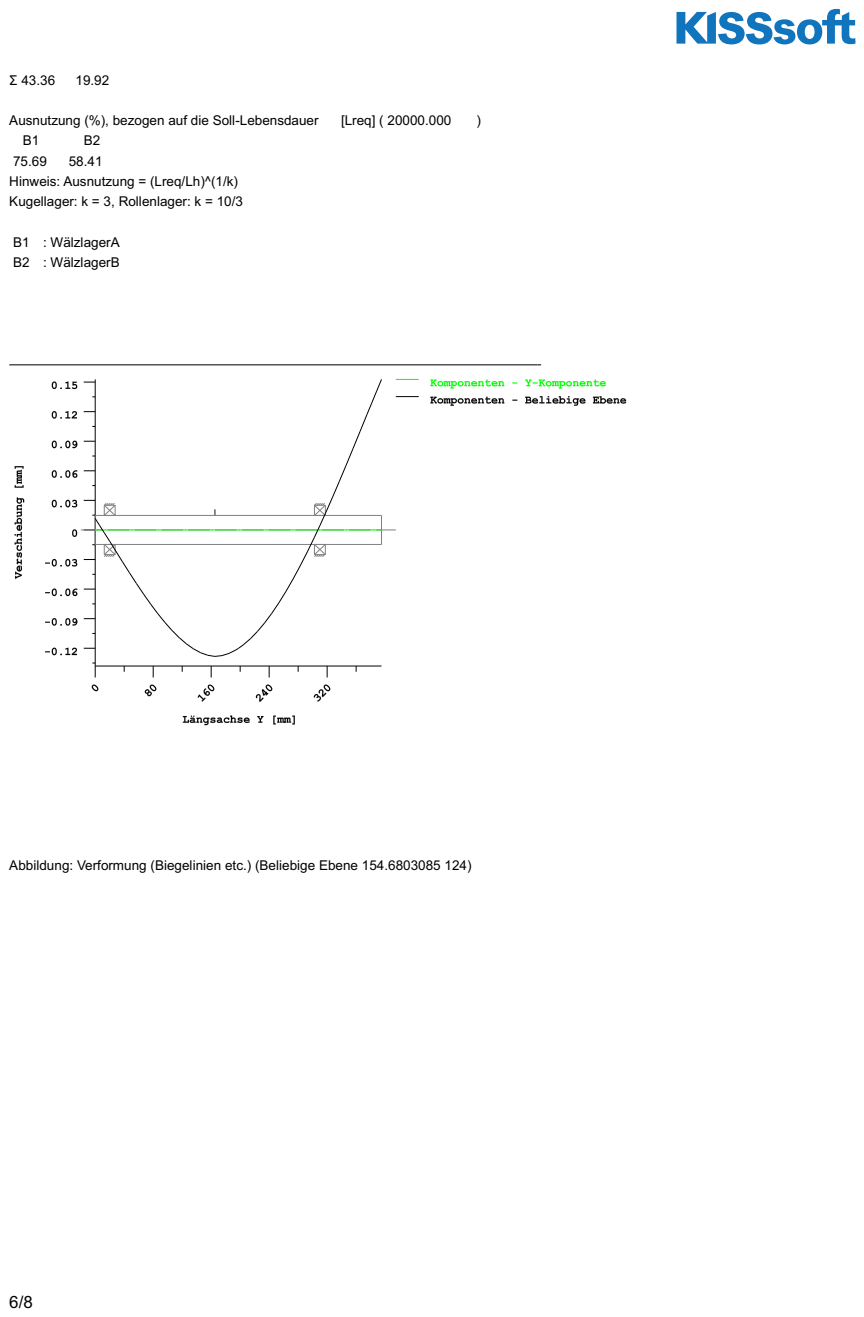
[picture p137: page 6]
Ausnutzung (%), bezogen auf die Soll-Lebensdauer; [Lreq] ( 20000.000; B1 : WälzlagerA; B2 : WälzlagerB

Hinweis: Ausnutzung = (Lreq/Lh)^(1/k)
Kugellager: k = 3, Rollenlager: k = 10/3

Abbildung: Verformung (Biegelinien etc.) (Beliebige Ebene 154.6803085 124)

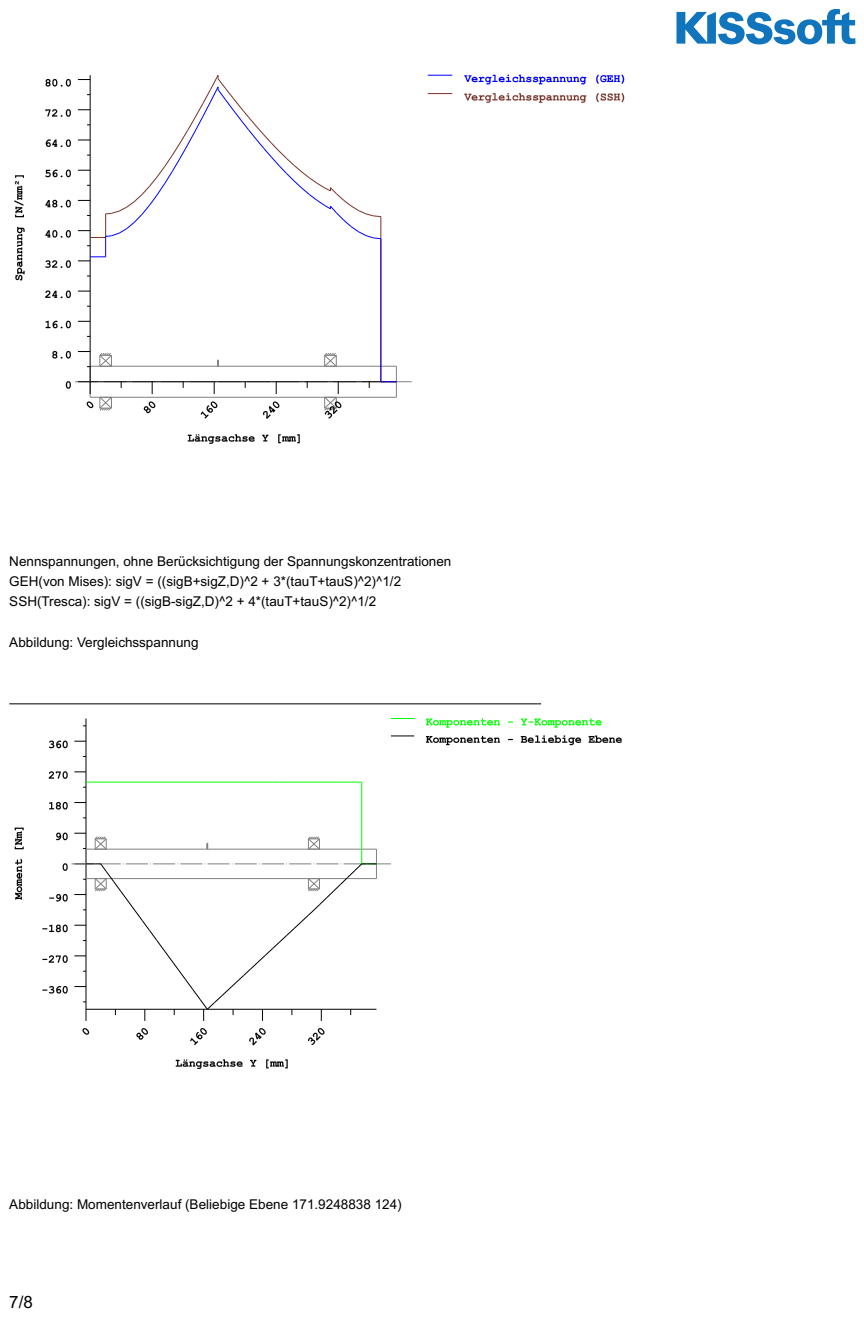
[picture p138: page 7]
Abbildung: Vergleichsspannung

Nennspannungen, ohne Berücksichtigung der Spannungskonzentrationen GEH(von Mises): sigV = ((sigB+sigZ,D)^2 + 3*(tauT+tauS)^2)^1/2

SSH(Tresca): sigV = ((sigB-sigZ,D)^2 + 4*(tauT+tauS)^2)^1/2

Abbildung: Momentenverlauf (Beliebige Ebene 171.9248838 124)

Ende Protokoll | Zeilen: | 273
