MattdewT/KE3/RB-Blessing/CE-Beurteilung-Aufgaben und Tätigkeiten.pdf

# Aufgaben in der Lebensphase

Lfd. Nr.Lebensphase | Aufgaben
1 | Produktion / Montage (beim Hersteller, innerbetrieblich) | Fertigen einzelner Bauteile
2 | | Transport von Kaufteilen zum Hersteller
3 | | Zusammenbau zu einzelnen Baugruppen
4 | Transport (innerbetrieblich) | Transportieren der Bauteile von Maschine / Lager zur Montage
5 | | Transportieren von zusammengebauten Baugruppen ins Lager
6 | Transport (zum Kunde) | Transportieren vom Lager zur Verpackungsstation
7 | | Verpacken der Bauteile / Baugruppe
8 | | Transportieren
9 | | Entladen beim Kunde
10 | | Auspacken
11 | Transport (beim Kunde | Transportieren der Bauteile / Baugruppen zur Montagestation
12 | Inbetriebnahme (Zusammenbau, | Vorbereitungen für die Installation (Anschlussstelle für Betonanker vorbereiten; Fundament)
13 | | Zusammenbau der Maschine nach der Montageanleitung
14 | | Einstellungen an der Maschine und deren Bauteile (axiale Ausrichtung)
15 | | Anschluss an die Stromversorgung für den Elektromotor
16 | | Einbringen von Hilfsflüssigkeiten (Schmierstoff)
17 | | Anbringen von Schutzeinrichtung
18 | | Vorführung / Betrieb der Maschine ohne Last
19 | | Prüfung
20 | | Versuche unter Höchstlast (Gesamtgewicht aller Teile auf dem Band max. 300 kg)
21 | Einrichten | Einstellen und Einrichten bzw. Überprüfen der funktionalen Parameter der Maschine (Geschwindigkeit, Abstand zwischen Untertommel und Antriebstrommel, Höhe gegenüber dem Boden)
22 | | Funktionsprüfung / Versuche
23 | | Funktionsprüfung des Motors (Nothalt)
24 | Betrieb | Antreiben der Maschine
25 | | Befördern der Stückgüter
26 | | Beladen / Entladen des Bandförderers
27 | | Geringfügige Einstellungs- und Einrichtungsvorgänge bei den Funktionsparamteren der Maschine
28 | | Überwachen (Regelmäßiges Nachziehen der Betonanker, Schmierung)
29 | | Geringfügige Eingriffe während des Betriebs (z.B. Beseitigung von Blockierungen, lokale Reinigung)
30 | | Neustarten der Maschine nach Stillsetzen / Unterbrechung
31 | Reinigung | Demontage / Ausbau von Teilen, Bauteilen, Einrichtungen der Maschine
32 | | Energietrennung
33 | | Schmieren
34 | Instandhaltung / Wartung | Nachstellen funktionaler Parameter der Maschine (Geschwindigkeit, Abstand zwischen Untertommel und Antriebstrommel, Höhe gegenüber dem Boden)
35 | | Austausch von Verschleißteilen
36 | | Demontage / Ausbau von Teilen, Bauteilen, Einrichtungen der Maschine
37 | | Energietrennung
38 | | Überprüfen / Erneuern von Hilfsflüssigkeiten (Schmierstoff)
39 | | Überprüfen von Teilen und Bauteilen der Maschine
40 | Fehlerfall | Demontage / Ausbau von Teilen, Bauteilen, Einrichtungen der Maschine
41 | | Fehlersuche
42 | | Energietrennung
43 | | Wiederanlauf nach Ausfall der Steuerungseinrichtungen und Schutzeinrichtungen
44 | | Wiederanlauf nach Blockierung
45 | | Reparaturen
46 | | Ersatz von Teilen, Bauteilen und Einrichtungen der Maschine

### Risikobewertung, TM2018KM, Matrikelnummern 5620331, 3225750, 1790705, 9269794 CE-Beurteilung, Lebensphasen S.1

Lfd. Nr.Lebensphase | Aufgaben
47 | | Erneutes Einrichten
48 | | Überprüfen von Teilen und Bauteilen der Maschine
49 | Außbetriebnahme / | Abtrennen von der Energieversorgung
50 | | Demontage nach der Demontageanleitung
51 | | Verpacken der Bauteile / Baugruppe
52 | | Tranportieren
53 | | Entladen beim Kunde
54 | | Entsorgung

### Risikobewertung, TM2018KM, Matrikelnummern 5620331, 3225750, 1790705, 9269794 CE-Beurteilung, Lebensphasen S.2
