MattdewT/KE3/RB-Blessing/CE-Beurteilung-Grenzen der Maschine.pdf

Lebensphasen*
Produktion / Montage (beim Hersteller, innerbetrieblich) | x
Transport (innerbetrieblich) | x | x
Transport (zum Kunden) | x
Transport (beim Kunden innerbetrieblich) | x
Inbetriebnahme (Zusammenbau, Installation) | x
Einrichten | x
Betrieb | x
Reinigung | x
Instandhaltung / Wartung | x | x
Fehlerfall | x | x | x
Außerbetriebnahme / Demontage | x | x

### Räumliche Grenzen (Wandabstand)

Die Höhe der Antriebstrommel über dem Boden beläuft sich auf mindestens 300mm bzgl. des Untertrums. Für den Elektromotor sollte sich ein ein Netzanschluss in nächster Nähe befinden.

### Personenkreise, die mit der Maschine / dem Produkt in Berührung kommen

Personenkreise

MA = Mitarbeiter
* s. Tabellenblatt Lebensphasen

Wartungspersonal

Kundendienst-MA

Schrotthändler + MA

MA der
Logisitk

MA Fertigung/
Montage

MA Lager/
Materialfluss | Händler + MA | Kunde

Im Standardbetrieb läuft das Band kontinuierlich mit einer Geschwindigkeit von ca. 2 m/s um.

Der Bandförderer kann sowohl in einer Halle als auch draußen genutzt werden. Dafür ist eine Überdachung über die gesamte Bandlänge zwingend erforderlich. Der Elektromotor darf nicht dauerhaft der Witterung ausgesetzt sein, sondern benötigt dann eine Abschirmung.
Mit einer Bandbreite von 240 mm kann eine Vielzahl von Gütern transportiert werden.

### Einsatzbereich:

Durch die stufenlose Regelung der Geschwindigkeit und den damit verbundenen leistungsstarken Elektromotor kann das Förderband auch individuell an den Betrieb angepasst werden.

Zur Einrichtung und zum Aufziehen des Bandes kann ein langsamer Betriebsmodus ausgewählt werden.

Im Falle einer Störung kann das Band in langsamer Geschwindigkeit invertiert betrieben werden. Diese Betriebsstufe darf nur kurzfristig gewählt werden.

## Grenzen eines Bandförderers

### Bestimmungsgemäße Nutzung

Der Bandförderer dient dem Transport von leichten bis mittelschweren Stückgütern (Gesamtgewicht aller Teile auf dem Band max. 300 kg) auf waagerechtem oder leicht steigendem Untergrund. Die Güter werden auf das sich bewegende Band gelegt und vom Bandanfang bis Bandende transportiert. Das Band wird von einer Antriebsrolle angetrieben und von einer Gegenrolle umgelenkt. Die Bandrolle wird von einem Elektromotor angetrieben.

### Betriebsarten:

CE-Beurteilung, Grenzen der Maschine, S.1 | Risikobewertung, TM2018KM, Matrikelnummern 5620331, 3225750, 1790705, 9269794

Steigung bis zu 3%
Bandbreite 240mm

Die Lebensdauer beträgt 30000h, bedingt vor allem durch die Kugellager.

Verwendungstemperaturen: -10°C bis 40°C

### Zeitliche Grenzen

### Weitere Grenzen

Sollte das Förderband durch den Betrieb verschmutzt worden sein, sollten keine chemikalischen Reinigungsmittel verwendet werden, da das Material des Förderbandes, der Elekromotor oder andere Teile des Bandförderers dadurch beschädigt werden könnten. Bei der Reinigung mit Wasser ist zu beachten, dass keine Wasserrücktände in den Ritzen verbleiben sollten. Sollte bei der Reinigung der Anlage eine Demontage einzelner Bestandteile notwendig sein, ist die Demontage- und anschließend die Montageanleitung zu beachten. Bei Nichtbeachten kann die Funktion der Maschine nicht mehr gewährleistet werden.
Bei der Instandhaltung und Wartung ist darauf zu achten, dass dies durch qualifiziertes Personal erfolgt.
Tritt ein Fehlerfall ein, bei dem ein Austausch von Teilen notwendig ist, ist darauf zu achten, dass Ersatzteile verwendet werden, die den Vorgaben des Herstellers entsprechen.
Wird das Produkt außer Betrieb genommen oder demontiert, muss die Demontageanleitung beachtet werden.

Während der ersten Lebensphase, der Produktion / Montage des Bandförderers, sind Mitarbeiter der Fertigung und Montage in direktem Kontakt mit dem Produkt. Eigenangefertige Teile können fehlerhaft produziert werden. Zukaufteile können ebenso fehlerhaft produziert, bestellt oder beim Transport beschädigt worden sein. Die Richtigkeit der Teile ist deshalb zu überprüfen.

Definition (vernünftigerweise vorhersehbare Fehlanwendungen):
Tätigkeiten die mit der Maschine / dem Produkt innerhalb der gesamten Lebensdauer durch den in der Lebensphase jeweils definierten Personenkreis (z.B. Nutzer, Bedien- oder Fachpersonal) fälschlicherweise, vorsätzlich oder fahrlässig außerhalb der Grenzen der Maschine / des Produktes durchgeführt werden.

Auch Mitarbeiter des Lagers und der Logistik können die Produkte beim Transport beschädigen.

Der Kunde kann beim Einrichten des Produktes durch einen falschen Netzanschluss den Elektromotor beschädigen.
Während des Betriebes ist vom Kunden darauf zu achten, dass die Umgebungstemperaturen die angegebenen Extremwerte von -10°C bis +40°C nicht über- bzw. unterschreiten. Außerdem sollte der Bandförderer nur von befugtem Personal betrieben werden.

Bei der Inbetriebnahme des Bandförderers kann die Montageanleitung nicht ausreichend genau gelesen werden und dadurch das Produkt fehlerhaft zusammengebaut werden.

### Vernünftigerweise vorhersehbare Fehlanwendungen:

Ebenso der Transport zum Kunden stellt ein hohes Risiko für Transportschäden dar. Das Produkt kann unter Umständen nicht fristgerecht geliefert werden oder Bestandteile davon könnten

Das Personal sollte neben den grundsätzlichen Verhaltensweisen an Förderanlagen vor allem mit folgenden Hinweisen vertraut gemacht werden: Weite Kleidung oder offene Hare dürfen sich nicht im Einzugbereich der Trommel, der Welle oder des Bandes befinden. Das Band ist nicht als Personentransport oder zum Transport anderer Teile als denen des Stückgutes vorgesehen. Das Band sollte im laufenden Betrieb nicht mit der bloßen Hand berührt werden.

CE-Beurteilung, Grenzen der Maschine, S.2 | Risikobewertung, TM2018KM, Matrikelnummern 5620331, 3225750, 1790705, 9269794
