MattdewT/KE3/RB-Blessing/Datenblatt_MMEngenieering.pdf

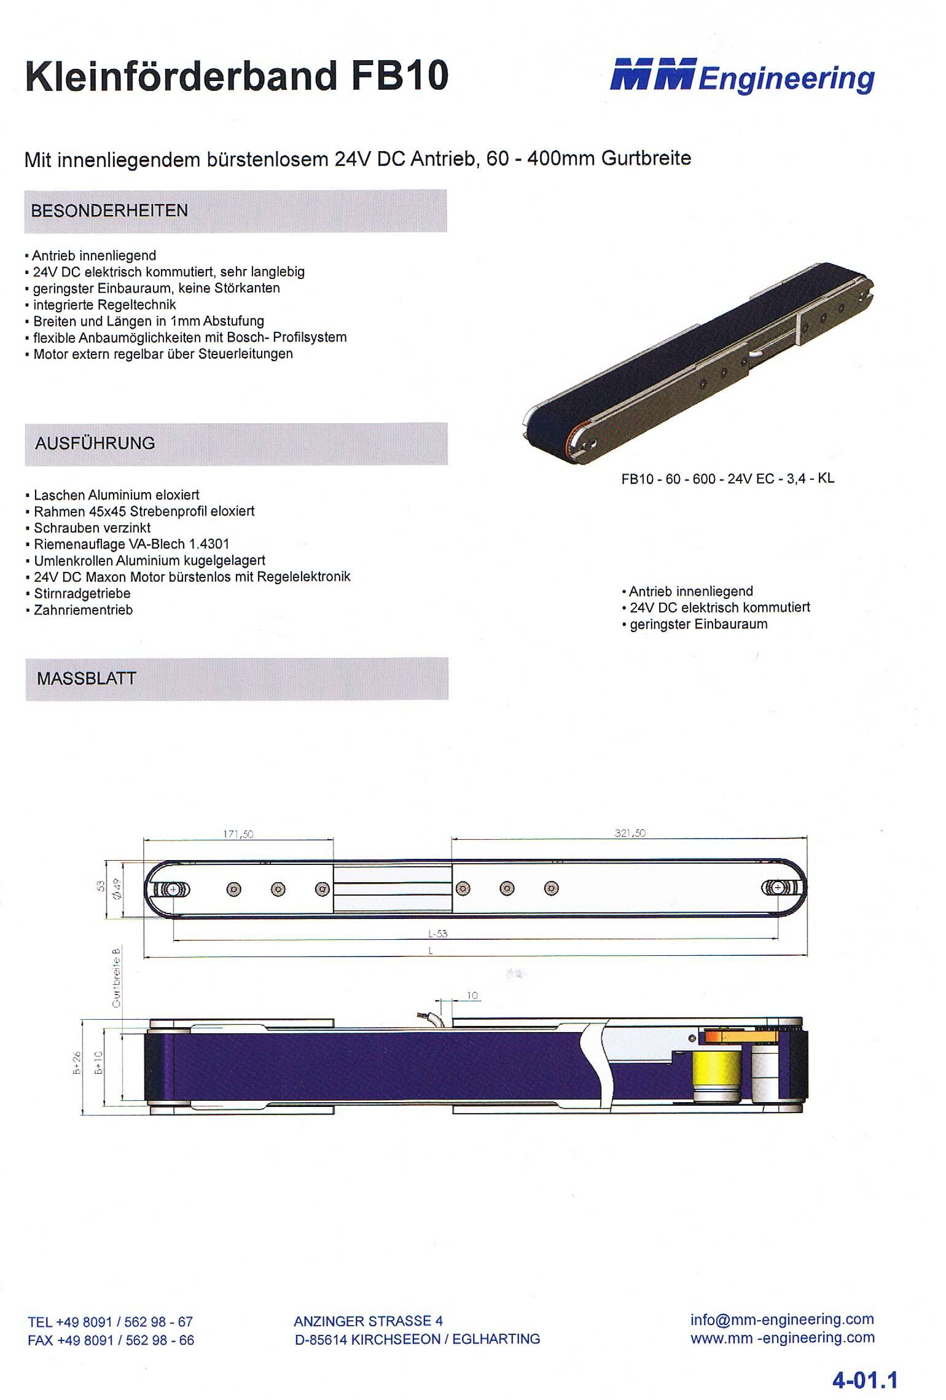
[picture p142: page 1]
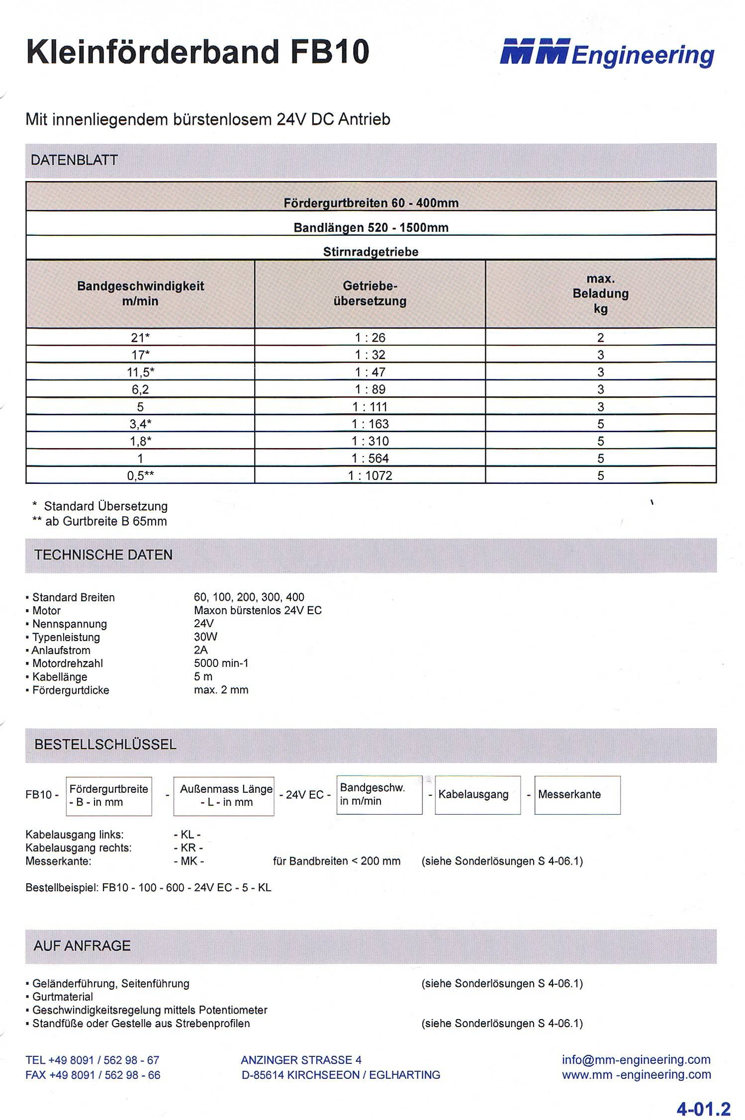
[picture p143: page 2]
