MattdewT/KE3/RB-Blessing/Drucken/Strukturanalysedrucken.pdf

Strukturanalyse

Struktur-, Funktions- und Fehleranalyse

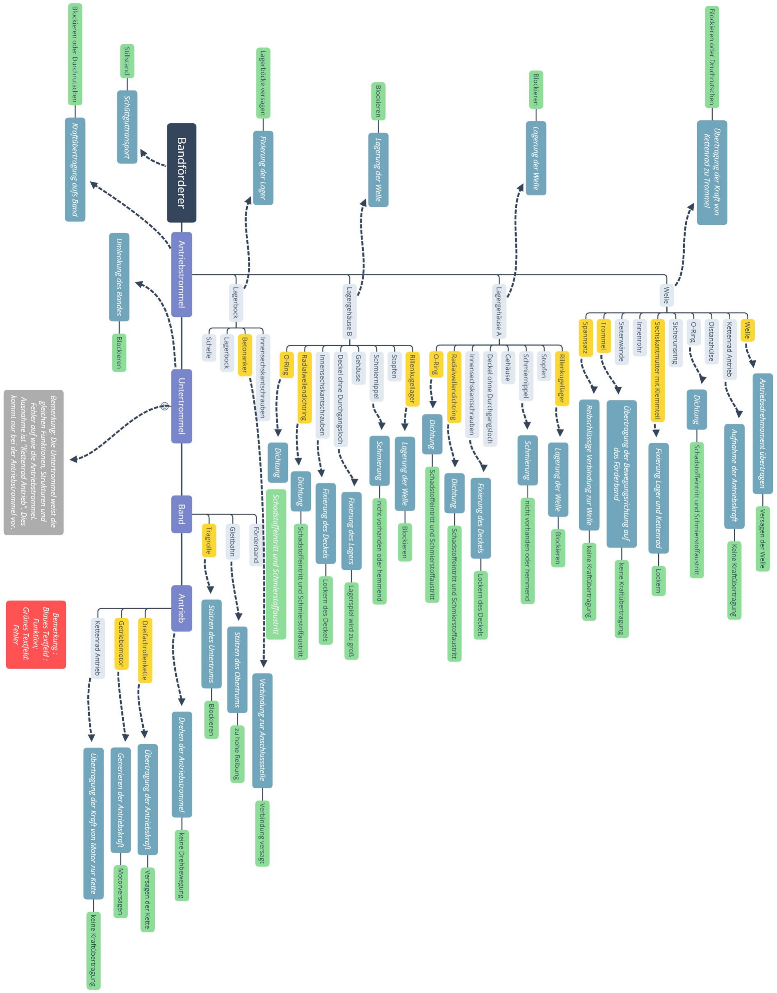
[picture p144: figure]
