MattdewT/KE3/Explusion.png

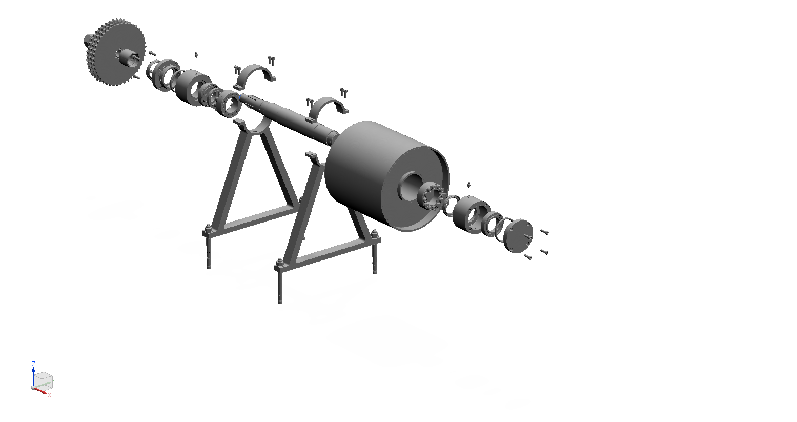
Explusion.png
