MattdewT/KE3/Kantenbruch_ohne_zahlen.png

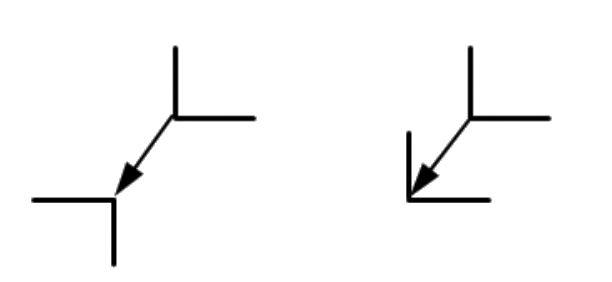
Kantenbruch_ohne_zahlen.png
