MattdewT/KE3/Trommel-Welle_BGR_Variante B (neu).png

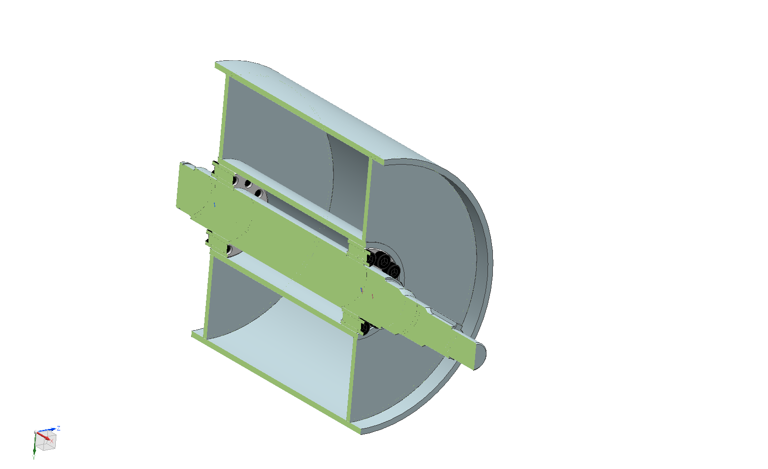
Trommel-Welle_BGR_Variante B (neu).png
