MattdewT/KE3/Finale/CD/12Durchbiegung mit Decker-Blatt.xlsm

Sheet: Welle 60
INFO |  | Datum: | 2019-11-17
Quelle: | Decker, Maschinenelemente, 20. Auflage
Kapitel: | 15 - Achsen und Wellen
Thema: | Durchbiegung
Problem: | Neigungswinkel und Durchbiegung
gegeben: | zulässiger Gesamtneigungswinkel der Zapfen | bLAzul (10-3 rad) | 2
 | in den Lagern | bLBzul (10-3 rad) | 2
 | zulässige Gesamtdurchbiegung | fzul (mm) | 120
 | Elastizitätsmodul | E (105 N/mm2) | 2.1
gesucht: | Neigungswinkel der Zapfen in den Lagern und
 | Durchbiegung der Welle
Lösung:
 | Bitte betätigen Sie die Start-Taste, um vorherige
 | Werte der Kräfte zu löschen.
 | Wichtiger Hinweis:
 | Auswahl der Belastungsfälle
 | - Lagerseite A, Y-Ebene
 | Belastungsfälle :
 | - Lagerseite B, Y-Ebene
 | Belastungsfälle :
 | -Lagerseite A, X-Ebene
 | Belastungsfälle :
 | - Lagerseite B, X-Ebene
 | Belastungsfälle :
 | Lagerseite A, Y- Ebene
Belastungs- | Neigungswinkel | bAAy (10-3 rad) | 0.5832
fall 1 | Durchbiegung | fAAy (10-3 cm) | 5.4532
Belastungs- | Neigungswinkel | bAiy (10-3 rad) | -0.1435
fall 2 | Durchbiegung | fAiy (10-3 cm) | -1.6984
Belastungs- | Neigungswinkel | bAiy (10-3 rad) | 0.0000
fall 3 | Durchbiegung | fAiy (10-3 cm) | 0.0000
Belastungs- | Neigungswinkel | bAiy (10-3 rad) | 0.0000
fall 4 | Durchbiegung | fAiy (10-3 cm) | 0.0000
Belastungs- | Neigungswinkel | bAiy (10-3 rad) | 0.0000
fall 5 | Durchbiegung | fAiy (10-3 cm) | 0.0000
 | Zusammenfassung Fall 1 bis 5
 | Neigungswinkel der Lagerseite A, Y -Ebene | bAy (10-3 rad) | 0.4396
 | Durchbiegung der Lagerseite A, Y- Ebene | fAy (10-3 cm) | 3.7548
 | Lagerseite B, Y- Ebene
Belastungs- | Neigungswinkel | bBBy (10-3 rad) | 0.4843
fall 1 | Durchbiegung | fBBy (10-3 cm) | 4.5289
Belastungs- | Neigungswinkel | bBiy (10-3 rad) | -0.1435
fall 2 | Durchbiegung | fBiy (10-3 cm) | -1.6984
Belastungs- | Neigungswinkel | bBiy (10-3 rad) | 0.7349
fall 3 | Durchbiegung | fBiy (10-3 cm) | 5.8525
Belastungs- | Neigungswinkel | bBiy (10-3 rad) | 0.0000
fall 4 | Durchbiegung | fBiy (10-3 cm) | 0.0000
Belastungs- | Neigungswinkel | bBiy (10-3 rad) | 0.0000
fall 5 | Durchbiegung | fBiy (10-3 cm) | 0.0000
 | Zusammenfassung Fall 1 bis 5
 | Neigungswinkel der Lagerseite B, Y -Ebene | bBy (10-3 rad) | 1.0757
 | Durchbiegung der Lagerseite B, Y- Ebene | fBy (10-3 cm) | 8.6830
 | Y-Ebene:
 | Neigungswinkel der Tangente | ay (10-3 rad) | -0.1699
 | Neigungswinkel des Zapfens im Lager A | bLAy (10-3 rad) | 0.6096
 | Neigungswinkel des Zapfens im Lager B | bLBy (10-3 rad) | 0.9057
 | Durchbiegung der Welle in der Y- Ebene | fy (10-3 cm) | 6.2189
 | Lagerseite A, X- Ebene
Belastungs- | Neigungswinkel | bAAx (10-3 rad) | -0.0681
fall 1 | Durchbiegung | fAAx (10-3 cm) | -0.6372
Belastungs- | Neigungswinkel | bAix (10-3 rad) | -0.0042
fall 2 | Durchbiegung | fAix (10-3 cm) | -0.0496
Belastungs- | Neigungswinkel | bAix (10-3 rad) | 0.0000
fall 3 | Durchbiegung | fAix (10-3 cm) | 0.0000
Belastungs- | Neigungswinkel | bAix (10-3 rad) | 0.0000
fall 4 | Durchbiegung | fAix (10-3 cm) | 0.0000
Belastungs- | Neigungswinkel | bAix (10-3 rad) | 0.0000
fall 5 | Durchbiegung | fAix (10-3 cm) | 0.0000
 | Zusammenfassung Fall 1 bis 5
 | Neigungswinkel der Lagerseite A, X -Ebene | bAx (10-3 rad) | -0.0723
 | Durchbiegung der Lagerseite A, X- Ebene | fAx (10-3 cm) | -0.6868
 | Lagerseite B, X- Ebene
Belastungs- | Neigungswinkel | bBBx (10-3 rad) | 0.4666
fall 1 | Durchbiegung | fBBx (10-3 cm) | 4.3631
Belastungs- | Neigungswinkel | bBix (10-3 rad) | -0.0042
fall 2 | Durchbiegung | fBix (10-3 cm) | -0.0496
Belastungs- | Neigungswinkel | bBix (10-3 rad) | -0.7349
fall 3 | Durchbiegung | fBix (10-3 cm) | -5.8525
Belastungs- | Neigungswinkel | bBix (10-3 rad) | 0.0000
fall 4 | Durchbiegung | fBix (10-3 cm) | 0.0000
Belastungs- | Neigungswinkel | bBix (10-3 rad) | 0.0000
fall 5 | Durchbiegung | fBix (10-3 cm) | 0.0000
 | Zusammenfassung Fall 1 bis 5
 | Neigungswinkel der Lagerseite B, X -Ebene | bBx (10-3 rad) | -0.2725
 | Durchbiegung der Lagerseite B, X- Ebene | fBx (10-3 cm) | -1.5390
 | X-Ebene:
 | Neigungswinkel der Tangente | ax (10-3 rad) | 0.0294
 | Neigungswinkel des Zapfens im Lager A | bLAx (10-3 rad) | -0.1017
 | Neigungswinkel des Zapfens im Lager B | bLBx (10-3 rad) | -0.2431
 | Durchbiegung der Welle in der X- Ebene | fx (10-3 cm) | -1.1129
 | Gesamtneigungswinkel im Lager A | bLA (10-3 rad) | 0.6180
 | Gesamtneigungswinkel im Lager B | bLB (10-3 rad) | 0.9378
 | Gesamtdurchbiegung | f (10-3 cm) | 6.32
 |  | f (mm) | 63.2
 | Der Gesamtneigungswinkel des Zapfens im Lager A ist zulässig.
 | Der Gesamtneigungswinkel des Zapfens im Lager B ist zulässig.
 | Die Gesamtdurchbiegung der Welle bleibt unterhalb des zulässigen Wertes.

Sheet: Y- Ebene
 | Belastungsfall 1, Lagerseite A, Y- Ebene
gegeben: | Längenmaße | l1 (mm) | 7.5
 | Wichtiger Hinweis: | l2 (mm) | 65
 |  | l3=lA (mm) | 145
 | Durchmesser | d1 (mm) | 40
 |  | d2 (mm) | 45
 |  | d3 (mm) | 48
 | Kraft | FA (kN) | 2.91344
 | Tritt ein weiterer Fall auf der Lagerseite A, Y- Ebene auf?
gegeben: | Belastungsfall 2, Lagerseite A, Y- Ebene
 | Längenmaße | l2 (mm) | 0
 |  | l3 (mm) | 80
 |  | li (mm) | 65
 |  | lA (mm) | 145
 | Durchmesser
 |  | d2 (mm) | 45
 |  | d3 (mm) | 48
 | Kraft | Fi (kN) | -2.5
 | Tritt ein weiterer Fall auf der Lagerseite A, Y- Ebene auf?
 | Belastungsfall 3, Lagerseite A, Y- Ebene
gegeben: | Längenmaße | l1 (mm) | 1
 |  | l2 (mm) | 2
 |  | l3 (mm) | 3
 |  | li (mm) | 4
 |  | lA (mm) | 145
 | Durchmesser | d1 (mm) | 1
 |  | d2 (mm) | 2
 |  | d3 (mm) | 3
 | Kraft | Fi (kN) | 0
 | Tritt ein weiterer Fall auf der Lagerseite A, Y- Ebene auf?
 | Belastungsfall 4, Lagerseite A, Y- Ebene
gegeben: | Längenmaße | l2 (mm) | 1
 |  | l3 (mm) | 2
 |  | li (mm) | 3
 |  | lA (mm) | 145
 | Radius | r (mm) | 1
 | Durchmesser
 |  | d2 (mm) | 1
 |  | d3 (mm) | 2
 | Kraft | Fi (kN) | 0
 | Tritt ein weiterer Fall auf der Lagerseite A, Y- Ebene auf?
 | Belastungsfall 5, Lagerseite A, Y- Ebene
gegeben: | Längenmaße | l1 (mm) | 1
 |  | l2 (mm) | 2
 |  | l3 (mm) | 3
 |  | li (mm) | 4
 |  | lA (mm) | 145
 | Radius | r (mm) | 1
 | Durchmesser | d1 (mm) | 2
 |  | d2 (mm) | 3
 |  | d3 (mm) | 4
 | Kraft | Fi (kN) | 0
 | Tritt ein weiterer Fall auf der Lagerseite A, Y- Ebene auf?
 | Belastungsfall 1, Lagerseite B, Y- Ebene
gegeben: | Längenmaße | l1 (mm) | 7.5
 | Wichtiger Hinweis: | l2 (mm) | 65
 |  | l3=lB (mm) | 145
 | Durchmesser | d1 (mm) | 40
 |  | d2 (mm) | 45
 |  | d3 (mm) | 48
 | Kraft | FB (kN) | 2.4196
 | Tritt ein weiterer Fall auf der Lagerseite B, Y- Ebene auf?
 |  |  | 0
gegeben: | Belastungsfall 2, Lagerseite B, Y- Ebene
 | Längenmaße | l2 (mm) | 0
 |  | l3 (mm) | 80
 |  | li (mm) | 65
 |  | lB (mm) | 145
 | Durchmesser
 |  | d2 (mm) | 45
 |  | d3 (mm) | 48
 | Kraft | Fi (kN) | -2.5
 | Tritt ein weiterer Fall auf der Lagerseite B, Y- Ebene auf?
 | Belastungsfall 3, Lagerseite B, Y- Ebene
gegeben: | Längenmaße | l1 (mm) | 72.5
 |  | l2 (mm) | 130
 |  | l3 (mm) | 210
 |  | li (mm) | 65
 |  | lB (mm) | 145
 | Durchmesser | d1 (mm) | 40
 |  | d2 (mm) | 45
 |  | d3 (mm) | 48
 | Kraft | Fi (kN) | 1.8446
 | Tritt ein weiterer Fall auf der Lagerseite B, Y- Ebene auf?
 | Belastungsfall 4, Lagerseite B, Y- Ebene
gegeben: | Längenmaße | l2 (mm) | 30
 |  | l3 (mm) | 290
 |  | li (mm) | 130
 |  | lB (mm) | 145
 | Radius | r (mm) | 335
 | Durchmesser
 |  | d2 (mm) | 60
 |  | d3 (mm) | 70
 | Kraft | Fi (kN) | 0
 | Tritt ein weiterer Fall auf der Lagerseite B, Y- Ebene auf?
 | Belastungsfall 5, Lagerseite B, Y- Ebene
gegeben: | Längenmaße | l1 (mm) | 60
 |  | l2 (mm) | 90
 |  | l3 (mm) | 90
 |  | li (mm) | 40
 |  | lB (mm) | 145
 | Radius | r (mm) | 100
 | Durchmesser | d1 (mm) | 45
 |  | d2 (mm) | 55
 |  | d3 (mm) | 60
 | Kraft | Fi (kN) | 0
 | Tritt ein weiterer Fall auf der Lagerseite B, Y- Ebene auf?

Sheet: X- Ebene
 | Belastungsfall 1, Lagerseite A, X- Ebene
gegeben: | Längenmaße | l1 (mm) | 7.5
 | Wichtiger Hinweis: | l2 (mm) | 65
 |  | l3=lA (mm) | 145
 | Durchmesser | d1 (mm) | 40
 |  | d2 (mm) | 45
 |  | d3 (mm) | 48
 | Kraft | FA (kN) | -0.34044
 | Tritt ein weiterer Fall auf der Lagerseite A, X- Ebene auf?
 | Belastungsfall 2, Lagerseite A, X- Ebene
gegeben: | Längenmaße | l2 (mm) | 0
 |  | l3 (mm) | 80
 |  | li (mm) | 65
 |  | lA (mm) | 145
 | Durchmesser
 |  | d2 (mm) | 45
 |  | d3 (mm) | 48
 | Kraft | Fi (kN) | -0.073
 | Tritt ein weiterer Fall auf der Lagerseite A, X- Ebene auf? |  | 0
 | Belastungsfall 3, Lagerseite A, X- Ebene
gegeben: | Längenmaße | l1 (mm) | 1
 |  | l2 (mm) | 2
 |  | l3 (mm) | 3
 |  | li (mm) | 4
 |  | lA (mm) | 145
 | Durchmesser | d1 (mm) | 1
 |  | d2 (mm) | 2
 |  | d3 (mm) | 3
 | Kraft | Fi (kN) | 0
 | Tritt ein weiterer Fall auf der Lagerseite A, X- Ebene auf?
 | Belastungsfall 4, Lagerseite A, X- Ebene
gegeben: | Längenmaße | l2 (mm) | 1
 |  | l3 (mm) | 2
 |  | li (mm) | 3
 |  | lA (mm) | 145
 | Radius | r (mm) | 1
 | Durchmesser
 |  | d2 (mm) | 2
 |  | d3 (mm) | 3
 | Kraft | Fi (kN) | 0
 | Tritt ein weiterer Fall auf der Lagerseite A, X- Ebene auf?
 | Belastungsfall 5, Lagerseite A, X- Ebene
gegeben: | Längenmaße | l1 (mm) | 1
 |  | l2 (mm) | 2
 |  | l3 (mm) | 3
 |  | li (mm) | 4
 |  | lA (mm) | 145
 | Radius | r (mm) | 1
 | Durchmesser | d1 (mm) | 2
 |  | d2 (mm) | 3
 |  | d3 (mm) | 4
 | Kraft | Fi (kN) | 0
 | Tritt ein weiterer Fall auf der Lagerseite A, X- Ebene auf?
 | Belastungsfall 1, Lagerseite B, X- Ebene
gegeben: | Längenmaße | l1 (mm) | 7.5
 | Wichtiger Hinweis: | l2 (mm) | 65
 |  | l3=lB (mm) | 145
 | Durchmesser | d1 (mm) | 40
 |  | d2 (mm) | 45
 |  | d3 (mm) | 48
 | Kraft | FB (kN) | 2.33104
 | Tritt ein weiterer Fall auf der Lagerseite B, X- Ebene auf?
 | Belastungsfall 2, Lagerseite B, X- Ebene
gegeben: | Längenmaße | l2 (mm) | 0
 |  | l3 (mm) | 80
 |  | li (mm) | 65
 |  | lB (mm) | 145
 | Durchmesser
 |  | d2 (mm) | 45
 |  | d3 (mm) | 48
 | Kraft | Fi (kN) | -0.073
 | Tritt ein weiterer Fall auf der Lagerseite B, X- Ebene auf?
 | Belastungsfall 3, Lagerseite B, X- Ebene
gegeben: | Längenmaße | l1 (mm) | 72.5
 |  | l2 (mm) | 130
 |  | l3 (mm) | 210
 |  | li (mm) | 65
 |  | lB (mm) | 145
 | Durchmesser | d1 (mm) | 40
 |  | d2 (mm) | 45
 |  | d3 (mm) | 48
 | Kraft | Fi (kN) | -1.8446
 | Tritt ein weiterer Fall auf der Lagerseite B, X- Ebene auf?
 | Belastungsfall 4, Lagerseite B, X- Ebene
gegeben: | Längenmaße | l2 (mm) | 1
 |  | l3 (mm) | 2
 |  | li (mm) | 3
 |  | lB (mm) | 145
 | Radius | r (mm) | 1
 | Durchmesser
 |  | d2 (mm) | 1
 |  | d3 (mm) | 2
 | Kraft | Fi (kN) | 0
 | Tritt ein weiterer Fall auf der Lagerseite B, X- Ebene auf?
 | Belastungsfall 5, Lagerseite B, X- Ebene
gegeben: | Längenmaße | l1 (mm) | 1
 |  | l2 (mm) | 2
 |  | l3 (mm) | 3
 |  | li (mm) | 4
 |  | lB (mm) | 145
 | Radius | r (mm) | 1
 | Durchmesser | d1 (mm) | 2
 |  | d2 (mm) | 3
 |  | d3 (mm) | 4
 | Kraft | Fi (kN) | 0
 | Tritt ein weiterer Fall auf der Lagerseite B, Y- Ebene auf?
