MattdewT/KE3/Finale/CD/6Stückliste Spannpressverband.pdf

1 | 2 | 3 | 4 | 5 | 6
Pos. | Menge | Einheit | Benennung | Sachnummer/Norm - Kurzbezeichnung | Bemerkung
1 | 1 | Stk. | Welle | Rund EN 20278 50 x 430 | 42CrMo4
2 | 2 | Stk. | Gehäuse | Rund EN 20278 100 x 80 | E295
3 | 1 | Stk. | Deckel mit Durchgangsloch | Rund EN 20278 100 x 45 | E295
4 | 1 | Stk. | Deckel ohne Durchgangsloch | Rund EN 20278 100 x 40 | E295
5 | 1 | Stk. | Trommel | DIN EN 10305-1 240 x 5 | E295
6 | 2 | Stk. | Seitenwände | Blech EN 10025 - 5,0 x 300 x 300 | E295
7 | 1 | Stk. | Innenrohr | DIN EN 10305-1 85 x 5 | E295
8 | 2 | Stk. | Lagerbock | Brennteil | E295
9 | 2 | Stk. | Schelle | Brennteil | E295
10 | 1 | Stk. | Distanzhülse | Rund EN 20278 48 x 55 | 42CrMo4
11 | 2 | Stk. | Rillenkugellager | DIN 625 - 6008
12 | 2 | Stk. | Spannsatz | COM-A, 45mm
13 | 1 | Stk. | Kettenrad Antrieb | ohne Nabe, ISO 08 B-3, mit Passfedernabe nach DIN 6885 - 10 x 8 x 34,9
14 | 1 | Stk. | Kettenrad Abtrieb | ohne Nabe, ISO 08 B-3, mit Keilwellennabe nach DIN ISO 14 - 8 x 32 x 36
15 | 1 | Stk. | Sechskantmutter mit Klemmteil | DIN EN ISO 7042 - M24 - 8.8
16 | 1 | Stk. | Sicherungsring | DIN 471 - 40 x 1,75
17 | 2 | Stk. | Radialwellendichtring | DIN 3760- AS45 x 60 x 8
18 | 2 | Stk. | O-Ring | 69,1 x 5,33
19 | 1 | Stk. | O-Ring | 42,3 x 3,53
20 | 2 | Stk. | Schmiernippel | M6 | von norelem
21 | 2 | Stk. | Stopfen | M6x5 | von Würth
22 | 8 | Stk. | Innensechskantschraube | M6 x 16
23 | 8 | Stk. | Innensechskantschraube | M6 x 20
24 | 1 | Stk. | Dreifachrollenkette | DIN ISO 606 - 08 B-3; 123 Glieder + 1 Verschlussglied
25 | 4 | Stk. | Betonanker | M12 x 81 | von Fischer
26 | 1 | Stk. | Getriebemotor | 2,2kW/ 85U/min/ 247Nm | von NORD

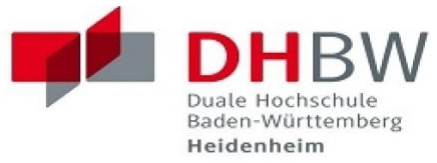
[picture p150: figure]

| Datum | Name
| | | | Bearb. | 14.11.2019 | Anika Langohr
| | | | Gepr. | 14.11.2019 | Marie Hopf
| | | | Norm. | 14.11.2019 | Tanja Hofmann
