MattdewT/KE3/RB-Blessing/Vorlagen_Uebungen/RAB/01_Vorlage_FMEA-Risikoanalyse.xlsx

Sheet: Requirements - criteria list
N° | main feature | requirement / specification (numbers, data, facts) | requested by (Rieter/Customer) | requested on | classification (W/D ; KANO: B; Q/P; E)
1
2
3
4
5
6
7
8
9
10
11

Sheet: Pairwise Comparison
 | Pairwise Comparison of (customer-) requirements
N° | 0 | 0 | 0 | 0 | 0 | 0 | 0 | 0 | 0 | 0 | 0 | 0 | 0 | 0 | 0 | 0 | sum | factor, integer, normalized to 10 | Percentage, normalized
1 |  |  |  |  |  |  |  |  |  |  |  |  |  |  |  |  | 0 | #DIV/0! | #DIV/0!
2 | 2 |  |  |  |  |  |  |  |  |  |  |  |  |  |  |  | 0 | #DIV/0! | #DIV/0!
3 | 2 | 2 |  |  |  |  |  |  |  |  |  |  |  |  |  |  | 0 | #DIV/0! | #DIV/0!
4 | 2 | 2 | 2 |  |  |  |  |  |  |  |  |  |  |  |  |  | 0 | #DIV/0! | #DIV/0!
5 | 2 | 2 | 2 | 2 |  |  |  |  |  |  |  |  |  |  |  |  | 0 | #DIV/0! | #DIV/0!
6 | 2 | 2 | 2 | 2 | 2 |  |  |  |  |  |  |  |  |  |  |  | 0 | #DIV/0! | #DIV/0!
7 | 2 | 2 | 2 | 2 | 2 | 2 |  |  |  |  |  |  |  |  |  |  | 0 | #DIV/0! | #DIV/0!
8 | 2 | 2 | 2 | 2 | 2 | 2 | 2 |  |  |  |  |  |  |  |  |  | 0 | #DIV/0! | #DIV/0!
9 | 2 | 2 | 2 | 2 | 2 | 2 | 2 | 2 |  |  |  |  |  |  |  |  | 0 | #DIV/0! | #DIV/0!
10 | 2 | 2 | 2 | 2 | 2 | 2 | 2 | 2 | 2 |  |  |  |  |  |  |  | 0 | #DIV/0! | #DIV/0!
11 | 2 | 2 | 2 | 2 | 2 | 2 | 2 | 2 | 2 | 2 |  |  |  |  |  |  | 0 | #DIV/0! | #DIV/0!
12 | 2 | 2 | 2 | 2 | 2 | 2 | 2 | 2 | 2 | 2 | 2 |  |  |  |  |  | 0 | #DIV/0! | #DIV/0!
13 | 2 | 2 | 2 | 2 | 2 | 2 | 2 | 2 | 2 | 2 | 2 | 2 |  |  |  |  | 0 | #DIV/0! | #DIV/0!
14 | 2 | 2 | 2 | 2 | 2 | 2 | 2 | 2 | 2 | 2 | 2 | 2 | 2 |  |  |  | 0 | #DIV/0! | #DIV/0!
15 | 2 | 2 | 2 | 2 | 2 | 2 | 2 | 2 | 2 | 2 | 2 | 2 | 2 | 2 |  |  | 0 | #DIV/0! | #DIV/0!
16 | 2 | 2 | 2 | 2 | 2 | 2 | 2 | 2 | 2 | 2 | 2 | 2 | 2 | 2 | 2 |  | 0 | #DIV/0! | #DIV/0!
 |  |  |  |  |  |  |  |  |  |  |  |  |  |  |  |  | 0 |  | #DIV/0!
 |  | 0 | Less important |  |  |  |  |  |  |  |  |  |  |  |  |  | 0 |  | #DIV/0!
 |  | 1 | same importance
 |  | 2 | more important

Sheet: KANO
KANO model
The professor Noriaki Kano classified 5 unique categories of customer requirements, 3 of which you want to end up in your offering, and the other 2 should be taken out. The 5 categories of customer requirements are classified depending on their ability to create customer satisfaction or cause dissatisfaction. Knowing what category customer requirements fall into and the importance of each requirement can help prioritize development activities and determine what to include in your offering and where to spend resources improving these requirements.
The model describes these 5 categories on a set of axis. The y-axis is degree of satisfaction of the requirement; the x-axis is the level of fulfillment or execution of the requirement by the company. All 5 categories of requirements can be mapped on the axis: Performance Simply stated, these are the requirements the customers are able to articulate and are at the top of their minds when evaluating options. They are the most visible of the model’s requirements and the better they are performed, the more satisfaction they bring, conversely, the worse they are performed, the more dissatisfaction they bring. The Professor originally called these “One-Dimensional” because the better you execute these the more satisfaction from the customer you get. Basic Simply stated, these are the requirements that the customers expect and are taken for granted. When done well, customers are just neutral, but when done poorly, customers are very dissatisfied. Kano originally called these “Must-be’s” because they are the requirements that must be included and are the price of entry into a market. Excitement Simply stated, these are the requirements that are unexpected and pleasant surprises or delights. These are the innovations you bring into your offering. They delight the customer when there, but do not cause any dissatisfaction when missing because the customer never expected them in the first place. Kano originally called these “Attractive or Delighters” because that’s exactly what they d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

Sheet: T-Table
 | specifications / requirements (VOC) |  |  |  |  |  |  |  |  |  |  |  |  |  | parts (3rd level from structural analysis)
 |  |  |  |  |  |  |  |  |  |  |  | functions / product features
weighting (from Pairwise Comparison) | 10 | 10 | 10 | 10 | 10 | 7 | 6 | 10 | 10 | 10 | 10 | weighted sum | normalized to 10 | name of function / product feature |  |  |  |  |  |  |  |  |  |  |  | sum
Interaction between specification and function [3=very strong, 2=strong, 1=weak; 0=no] |  |  |  |  |  |  |  |  |  |  |  | 0 | #DIV/0! |  |  |  |  |  |  |  |  |  |  |  |  | 0 | Interaction between function and work-package [3=very strong, 2=strong, 1=weak; 0=no]
 |  |  |  |  |  |  |  |  |  |  |  | 0 | #DIV/0! |  |  |  |  |  |  |  |  |  |  |  |  | 0
 |  |  |  |  |  |  |  |  |  |  |  | 0 | #DIV/0! |  |  |  |  |  |  |  |  |  |  |  |  | 0
 |  |  |  |  |  |  |  |  |  |  |  | 0 | #DIV/0! |  |  |  |  |  |  |  |  |  |  |  |  | 0
 |  |  |  |  |  |  |  |  |  |  |  | 0 | #DIV/0! |  |  |  |  |  |  |  |  |  |  |  |  | 0
 |  |  |  |  |  |  |  |  |  |  |  | 0 | #DIV/0! |  |  |  |  |  |  |  |  |  |  |  |  | 0
 |  |  |  |  |  |  |  |  |  |  |  | 0 | #DIV/0! |  |  |  |  |  |  |  |  |  |  |  |  | 0
 |  |  |  |  |  |  |  |  |  |  |  | 0 | #DIV/0! |  |  |  |  |  |  |  |  |  |  |  |  | 0
 |  |  |  |  |  |  |  |  |  |  |  | 0 | #DIV/0! |  |  |  |  |  |  |  |  |  |  |  |  | 0
 |  |  |  |  |  |  |  |  |  |  |  | 0 | #DIV/0! |  |  |  |  |  |  |  |  |  |  |  |  | 0
sum | 0 | 0 | 0 | 0 | 0 | 0 | 0 | 0 | 0 | 0 | 0 |  |  |  | 0 | 0 | 0 | 0 | 0 | 0 | 0 | 0 | 0 | 0 | 0 |  | sum

Sheet: Structural analysis
Step 2: Structural Analysis
Determine the structure of the product (derivation from part list if necessary), e.g. Product> Assembly> Sub-Assembly> Components
Remark: Complex structures can be broken down into several structures (work packages) or different levels (block diagrams) and analyzed separately for organizational reasons or for deeper insights
Visualisation of the scope of analysis, e.g. Structure tree, block/demarcation diagrams, 3D models, scatches, etc.
Analysis of relationships, interfaces and interactions between defined system elements
Pre-selection of requirements/ functions/ components, use e.g. KANO, Pairwise comparison, QFD,..
1st level | 2nd level | 3rd level | 4th level

Sheet: Functional analysis
Step 3: Function analysis
Assignment of functions to the relevant system elements
Overview of the functionality of the product
Description of the individual functions in detail
Assignment of requirements / characteristics to individual functions
Visualization of a functional network, a functional structure, a function tree or a function matrix, etc.
Break down the customer functions (external and internal) to the corresponding requirements for the intended use
The functional analysis serves as a basis to examine each system element later on the error sources and the associated risks.
For this purpose, extensive knowledge of the system, operating conditions and the environmental conditions affecting the system
are required, for example heat, cold, dust, splash, salt, ice, vibration, electrical faults, etc.

Sheet: Failure analysis
Step 4: Failure analysis
Assign malfunctions to the system structure
Build failure network / error chains (failure - effects - causes)

Sheet: Risk assessment - DFMEA
 |  |  | D-FMEA Name: |  | Team: | D-FMEA Design Failure Mode and Effects Analysis |  |  |  |  |  |  |  |  |  |  |  |  |  |  |  |  |  |  | 1 | H | Y | open
 |  |  |  |  |  |  |  |  |  |  |  |  |  |  |  |  |  |  |  |  |  |  |  |  | 2 | L | N | ongoing
 |  |  |  |  |  |  |  |  |  |  |  |  |  |  |  |  |  |  |  |  |  |  |  |  | 3 | M |  | done
 |  |  | Date: | 2019-10-29 |  |  |  |  |  |  |  |  |  |  |  |  |  |  |  |  |  |  |  |  | 4
 |  |  |  |  |  |  |  |  |  |  |  |  |  |  |  |  |  |  |  |  |  |  |  |  | 5
 |  |  |  |  |  |  |  |  |  |  |  |  |  |  |  |  |  |  |  |  |  |  |  |  | 6
 |  |  | Possible Effect (Function not fullfilled) | Potential Failure Mode(s)/ Potential risk What worries us? (item/subsystems failure contribution to effect/ 1st level cause) | Possible causes (root cause of failure) | Current detection measures P - standard preventive controls to lower occurrence probability C - standard checks/ inspection measures | Bedeutung | Auftrittswahrscheinlichkeit | Entdeckungswahrscheinlichkeit | Risk priority number | Task Priority | Additional measures | S new | O new | D new | RPN new | TP new | technical complexity | cost | time | Carry out Y/N | resp. person | due date | Status | 7
 |  |  |  |  |  |  | S | O | D | RPN SxOxD | TP |  |  |  |  |  |  |  |  |  |  |  |  |  | 8
Rank |  |  |  |  |  |  |  |  |  |  |  |  |  |  |  |  |  |  |  |  |  |  |  |  | 9
23 | 80 | 1 | Zu kalt, zu warmes persönliches Empfinden | Loch in der Decke | unstabiles Material | P: stabileres Material, Langzeitmaterialtests C: visuelle Kontrolle | 10 | 4 | 2 | 80 |  |  |  |  |  | 0 |  |  |  |  |  |  |  |  | 10
19 | 140 | 2 | Zu kalt, zu warmes persönliches Empfinden | Loch in der Decke | Spitze Unterlage | P: C: ***** | 10 | 7 | 2 | 140 |  |  |  |  |  | 0
18 | 140 | 3 | Zu kalt, zu warmes persönliches Empfinden | Loch in der Decke | Spitze Gegenstände im Rucksack | P: ***** C: ***** | 10 | 7 | 2 | 140 |  |  |  |  |  | 0
16 | 160 | 4 | Zu kalt, zu warmes persönliches Empfinden | Loch in der Decke | Bettdecke lag auf dem Boden | P: ***** C: ***** | 10 | 8 | 2 | 160 |  |  |  |  |  | 0
15 | 160 | 5 | Zu kalt, zu warmes persönliches Empfinden | Loch in der Decke | zu viel Belastung | P: C: ***** | 10 | 8 | 2 | 160 |  |  |  |  |  | 0
8 | 350 | 6 | Zu kalt, zu warmes persönliches Empfinden | Sommer/Winterdecke vertauscht | falsche/fehlende Informationen | P: farblich Kennzeichnen, beschriften C: - | 10 | 5 | 7 | 350 | H |  |  |  |  | 0
7 | 350 | 7 | Zu kalt, zu warmes persönliches Empfinden | Sommer/Winterdecke vertauscht | fehlende Kennzeichung | P: ***** C: ***** | 10 | 5 | 7 | 350 | H |  |  |  |  | 0
27 | 30.00000001 | 8 | Zu kalt, zu warmes persönliches Empfinden | zu kleine Decke | Eingelaufen beim Waschen-->Falsches Material | P: Materialwaschtest C: sich an die Reinigungsanleitung halten | 10 | 3 | 1 | 30 | L |  |  |  |  | 0
14 | 180 | 9 | Zu kalt, zu warmes persönliches Empfinden | kaputtes Klimamodul | zu starker Umwelteinfluss-->Elektronik fällt aus | P: Wetterfeste Kapselung (Lebenszeitfest) C: nur in vorgegebenen Umgebung benutzen | 10 | 2 | 9 | 180 |  |  |  |  |  | 0
1 | 900 | 10 | Zu kalt, zu warmes persönliches Empfinden | kaputtes Klimamodul | Kurzschluss-->ungenügende Abschirmung gegen Flüssigkeit-->Knickbelastung beim Falten | P: ***** C: ***** | 10 | 9 | 10 | 900 |  |  |  |  |  | 0
12 | 200 | 11 | Zu kalt, zu warmes persönliches Empfinden | kaputtes Klimamodul | ausfallende Energieversorgung-->zu lange Verwendung o. Kurzschluss (s.o.) | P: Dauertest der Elektronik C: Regelmässige Kontrolltermine | 10 | 2 | 10 | 200 |  |  |  |  |  | 0
22 | 100 | 12 | Zu kalt, zu warmes persönliches Empfinden | kaputtes Klimamodul | Versagen der Steuerung-->Alterung der Elektronik | P: ***** C: ***** | 10 | 1 | 10 | 100 | H |  |  |  |  | 0
26 | 40.00000001 | 13 | Zusammenfaltung in den Rucksack nicht möglich | Verkantung | Ungenügende Faltanleitung | P: genügend Toleranzen einplanen C: Faltanleitung beachten | 10 | 1 | 4 | 40 |  |  |  |  |  | 0
9 | 240 | 14 | Zusammenfaltung in den Rucksack nicht möglich | Verkantung | Thermische Schwankungen setzen dem Material zu | P: ***** C: ***** | 10 | 3 | 8 | 240 |  |  |  |  |  | 0
4 | 540 | 15 | Zusammenfaltung in den Rucksack nicht möglich | Verkantung | Unebener Untergrund | P: ***** C: ***** | 10 | 9 | 6 | 540 |  |  |  |  |  | 0
3 | 560 | 16 | Zusammenfaltung in den Rucksack nicht möglich | Verkantung | Zu starke Krafteinflüsse | P: ***** C: ***** | 10 | 8 | 7 | 560 |  |  |  |  |  | 0
2 | 800 | 17 | Zusammenfaltung in den Rucksack nicht möglich | Verkantung | Hektik, zu schnelles Abbauen-->zu komplexer Abbau | P: ***** C: ***** | 10 | 10 | 8 | 800 |  |  |  |  |  | 0
29 | 20.00000002 | 18 | Zusammenfaltung in den Rucksack nicht möglich | Komprimierbarkeit nicht vorhanden | Konstruktion fehlgeschlagen | P: Test unter Realbedingungen C: Faltanleitung beachten | 10 | 2 | 1 | 20 |  |  |  |  |  | 0
10 | 210 |  | Zusammenfaltung in den Rucksack nicht möglich | Komprimierbarkeit nicht vorhanden | Benutzer zu schwach | P: ***** C: ***** | 10 | 3 | 7 | 210 | H |  |  |  |  | 0
11 | 200 |  | Unerwünschte Geruchsentwicklung | Material nimmt zu viel Feuchtigkeit auf und gibt sie nicht mehr ab | falsches Material | P: Materialtest unter Realbedingungen C: Gebrauchsanweisung lesen | 10 | 4 | 5 | 200 |  |  |  |  |  | 0
6 | 480 |  | Unerwünschte Geruchsentwicklung | Material nimmt zu viel Feuchtigkeit auf und gibt sie nicht mehr ab | zu viel Feuchtigkeit bei zu geringer Austrocknungszeit | P: ***** C: ***** | 10 | 8 | 6 | 480 |  |  |  |  |  | 0
5 | 500 |  | Unerwünschte Geruchsentwicklung | Material nimmt zu viel Feuchtigkeit auf und gibt sie nicht mehr ab | menschliche Transpiration | P: ***** C: ***** | 10 | 10 | 5 | 500 | H |  |  |  |  | 0
24 | 60.00000002 |  | Unerwünschte Geruchsentwicklung | Eigengeruch des Materials | Billige Materialien verwendet | P: Materialeigengeruch unterdrücken C: regelmässig lüften | 10 | 2 | 3 | 60 |  |  |  |  |  | 0
17 | 150 |  | Unerwünschte Geruchsentwicklung | Eigengeruch des Materials | High-Tech-Material | P: ***** C: ***** | 10 | 5 | 3 | 150 | M |  |  |  |  | 0
13 | 180 |  | Schmuddeliges Aussehen | Schmutzanziehendes Material (z.B. fusselnd) | Faserbruch-->durch Waschen | P: Materialtest unter Realbedingungen C: visuelle Kontrolle | 10 | 6 | 3 | 180 |  |  |  |  |  | 0
28 | 20.00000003 |  | Schmuddeliges Aussehen | Elektrostatische Aufladung | Plastikartiges Material verwendet | P: Materialtest unter Realbedingungen C: statisch entladen | 10 | 1 | 2 | 20 |  |  |  |  |  | 0
21 | 100 |  | Nicht tragbar | zu schwer | falsche Materialen | P: Testen, leichte Materialien verwenden C: Probetragen | 10 | 5 | 2 | 100 |  |  |  |  |  | 0
20 | 100 |  | Nicht tragbar | zu schwer | falsche Konstruktion | P: ***** C: ***** | 10 | 5 | 2 | 100 |  |  |  |  |  | 0
25 | 50.00000003 |  | Nicht tragbar | zu unhandlich | zu große Konstruktion | P: Testen, Kompakte Konstruktion C: Probetragen | 10 | 5 | 1 | 50 | M |  |  |  |  | 0
 | 3e-08 |  |  |  |  | P: ***** C: ***** |  |  |  | 0 |  |  |  |  |  | 0
 | 3.1e-08 |  |  |  |  | P: ***** C: ***** |  |  |  | 0 |  |  |  |  |  | 0
 | 3.2e-08 |  |  |  |  | P: ***** C: ***** |  |  |  | 0 |  |  |  |  |  | 0
 | 3.3e-08 |  |  |  |  | P: ***** C: ***** |  |  |  | 0 |  |  |  |  |  | 0
 | 3.4e-08 |  |  |  |  | P: ***** C: ***** |  |  |  | 0 |  |  |  |  |  | 0
 | 3.5e-08 |  |  |  |  | P: ***** C: ***** |  |  |  | 0 |  |  |  |  |  | 0
 | 3.6e-08 |  |  |  |  | P: ***** C: ***** |  |  |  | 0 |  |  |  |  |  | 0
 | 3.7e-08 |  |  |  |  | P: ***** C: ***** |  |  |  | 0 |  |  |  |  |  | 0
 | 3.8e-08 |  |  |  |  | P: ***** C: ***** |  |  |  | 0 |  |  |  |  |  | 0
 | 3.9e-08 |  |  |  |  | P: ***** C: ***** |  |  |  | 0 |  |  |  |  |  | 0
 | 4e-08 |  |  |  |  | P: ***** C: ***** |  |  |  | 0 |  |  |  |  |  | 0
 | 4.1e-08 |  |  |  |  | P: ***** C: ***** |  |  |  | 0 |  |  |  |  |  | 0
 | 4.2e-08 |  |  |  |  | P: ***** C: ***** |  |  |  | 0 |  |  |  |  |  | 0
 | 4.3e-08 |  |  |  |  | P: ***** C: ***** |  |  |  | 0 |  |  |  |  |  | 0
 | 4.4e-08 |  |  |  |  | P: ***** C: ***** |  |  |  | 0 |  |  |  |  |  | 0
 | 4.5e-08 |  |  |  |  | P: ***** C: ***** |  |  |  | 0 |  |  |  |  |  | 0
 | 4.6e-08 |  |  |  |  | P: ***** C: ***** |  |  |  | 0 |  |  |  |  |  | 0
 | 4.7e-08 |  |  |  |  | P: ***** C: ***** |  |  |  | 0 |  |  |  |  |  | 0
 | 4.8e-08 |  |  |  |  | P: ***** C: ***** |  |  |  | 0 |  |  |  |  |  | 0
 | 4.9e-08 |  |  |  |  | P: ***** C: ***** |  |  |  | 0 |  |  |  |  |  | 0
 | 5e-08 |  |  |  |  | P: ***** C: ***** |  |  |  | 0 |  |  |  |  |  | 0
 | 5.1e-08 |  |  |  |  | P: ***** C: ***** |  |  |  | 0 |  |  |  |  |  | 0
 | 5.2e-08 |  |  |  |  | P: ***** C: ***** |  |  |  | 0 |  |  |  |  |  | 0
 | 5.3e-08 |  |  |  |  | P: ***** C: ***** |  |  |  | 0 |  |  |  |  |  | 0
 | 5.4e-08 |  |  |  |  | P: ***** C: ***** |  |  |  | 0 |  |  |  |  |  | 0
 | 5.5e-08 |  |  |  |  | P: ***** C: ***** |  |  |  | 0 |  |  |  |  |  | 0
 | 5.6e-08 |  |  |  |  | P: ***** C: ***** |  |  |  | 0 |  |  |  |  |  | 0
 | 5.7e-08 |  |  |  |  | P: ***** C: ***** |  |  |  | 0 |  |  |  |  |  | 0
 | 5.8e-08 |  |  |  |  | P: ***** C: ***** |  |  |  | 0 |  |  |  |  |  | 0
 | 5.9e-08 |  |  |  |  | P: ***** C: ***** |  |  |  | 0 |  |  |  |  |  | 0
 | 6e-08 |  |  |  |  | P: ***** C: ***** |  |  |  | 0 |  |  |  |  |  | 0
 | 6.1e-08 |  |  |  |  | P: ***** C: ***** |  |  |  | 0 |  |  |  |  |  | 0
 | 6.2e-08 |  |  |  |  | P: ***** C: ***** |  |  |  | 0 |  |  |  |  |  | 0
 | 6.3e-08 |  |  |  |  | P: ***** C: ***** |  |  |  | 0 |  |  |  |  |  | 0
 | 6.4e-08 |  |  |  |  | P: ***** C: ***** |  |  |  | 0 |  |  |  |  |  | 0
 | 6.5e-08 |  |  |  |  | P: ***** C: ***** |  |  |  | 0 |  |  |  |  |  | 0
 | 6.6e-08 |  |  |  |  | P: ***** C: ***** |  |  |  | 0 |  |  |  |  |  | 0
 | 6.7e-08 |  |  |  |  | P: ***** C: ***** |  |  |  | 0 |  |  |  |  |  | 0
 | 6.8e-08 |  |  |  |  | P: ***** C: ***** |  |  |  | 0 |  |  |  |  |  | 0
 | 6.9e-08 |  |  |  |  | P: ***** C: ***** |  |  |  | 0 |  |  |  |  |  | 0
 | 7e-08 |  |  |  |  | P: ***** C: ***** |  |  |  | 0 |  |  |  |  |  | 0
 | 7.1e-08 |  |  |  |  | P: ***** C: ***** |  |  |  | 0 |  |  |  |  |  | 0
 | 7.2e-08 |  |  |  |  | P: ***** C: ***** |  |  |  | 0 |  |  |  |  |  | 0
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
 | 1.51e-07 |  |  |  |  | P: ***** C: ***** |  |  |  | 0 |  |  |  |  |  | 0
 | 1.52e-07 |  |  |  |  | P: ***** C: ***** |  |  |  | 0 |  |  |  |  |  | 0
 | 1.53e-07 |  |  |  |  | P: ***** C: ***** |  |  |  | 0 |  |  |  |  |  | 0

Sheet: Pareto
 |  |  |  |  |  |  | 0
 |  |  |  |  |  | date | 2018-04-13
 |  |  |  |  |  |  | team
0 | Nr. | RPZ | RPZ kum | RPZ New | % | % kum
1 | 10 | 900 | 900 |  | 12.78409091% | 12.78409091%
2 | 17 | 800 | 1700 |  | 11.36363636% | 24.14772727%
3 | 16 | 560 | 2260 |  | 7.954545455% | 32.10227273%
4 | 15 | 540 | 2800 |  | 7.670454545% | 39.77272727%
5 |  | 500 | 3300 |  | 7.102272727% | 46.875%
6 |  | 480 | 3780 |  | 6.818181818% | 53.69318182%
7 | 7 | 350 | 4130 |  | 4.971590909% | 58.66477273%
8 | 6 | 350 | 4480 |  | 4.971590909% | 63.63636364%
9 | 14 | 240 | 4720 |  | 3.409090909% | 67.04545455%
10 |  | 210 | 4930 |  | 2.982954545% | 70.02840909%
11 |  | 200 | 5130 |  | 2.840909091% | 72.86931818%
12 | 11 | 200 | 5330 |  | 2.840909091% | 75.71022727%
13 |  | 180 | 5510 |  | 2.556818182% | 78.26704545%
14 | 9 | 180 | 5690 |  | 2.556818182% | 80.82386364%
15 | 5 | 160 | 5850 |  | 2.272727273% | 83.09659091%
16 | 4 | 160 | 6010 |  | 2.272727273% | 85.36931818%
17 |  | 150 | 6160 |  | 2.130681818% | 87.5%
18 | 3 | 140 | 6300 |  | 1.988636364% | 89.48863636%
19 | 2 | 140 | 6440 |  | 1.988636364% | 91.47727273%
20 |  | 100 | 6540 |  | 1.420454545% | 92.89772727%
21 |  | 100 | 6640 |  | 1.420454545% | 94.31818182%
22 | 12 | 100 | 6740 |  | 1.420454545% | 95.73863636%
23 | 1 | 80 | 6820 |  | 1.136363636% | 96.875%
24 |  | 60 | 6880 |  | 0.8522727273% | 97.72727273%
25 |  | 50 | 6930 |  | 0.7102272727% | 98.4375%
26 | 13 | 40 | 6970 |  | 0.5681818182% | 99.00568182%
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
922
923
924
925
926
927
928
929
930
931
932
933
934
935
936
937
938
939
940
941
942
943
944
945
946
947
948
949
950
951
952
953
954
955
956
957
958
959
960
961
962
963
964
965
966
967
968
969
970
971
972
973
974
975
976
977
978
979
980
981
982
983
984
985
986
987
988
989
990
991
992
993
994
995

Sheet: DFMEA Ranking
 | Severity (S)
Rating | Effect on customer | Characteristic: Effect of failure and its severity
1 | None | Insignificant failure. Function restriction is only recognizable by qualified personnel. Unimportant claim in comparison with the other claims.
3 | Minor | Annoyance or squeak and rattle; visual defects which do not affect function Failure to perform a function is not necessarily relevant to the success of the product.
5 | Discontent | Failure to perform this function may result in customer acceptance restrictions, which may limit the success of the product.
7 | Upset | Functionality of the product restricted; Necessary functions used by the customer are not fulfilled. Significant restrictions on customer acceptance are to be expected.
10 | Existential | Regulatory and / or Safety implications/ company risk Product is only limited for the intended use operational, the acceptance of the customers will suffer, the success of the product is severely limited.
 | Probability of Occurrence (O)
Rating | Probability of occurrence | Product experience (novelty of design, application or use cases) | Prevention measures
1 | Remote (Unlikely) | Identical, robust design. Same application, service life and conditions of use. Test or field experience under comparable environmental conditions. Long, error-free experience in series production under comparable conditions of use | Design has been proven to meet the standards and best practices of Lessons Learned, which effectively avoids the occurrence of the error. Analyzes are capable of detecting defects with high certainty, so that the error in the series production can not occur.
3 | Small (Isolated failure) | Small changes in detail with known design, same application, minor changes in application or New design with positive completed test results | Design is expected to conform to standards and experience, taking into account experience from previous designs. Analyzes are able to detect defects in the system / component related to the cause of the failure and predict the conformity of the production design.
5 | Moderate (Occasional failures) | Similar to previous design, using existing technologies and materials. Similar application with change in service life or conditions of use. Test results or field experience are available. | Design takes into account experience from predecessor design. Best practices have been re-evaluated for this design, but have not yet been proven. Analyzes are capable of detecting deficiencies in the system / component relative to the error sequence and reflect conditionally behavior.
7 | High (frequent failure) | New design based on similar technology or similar material. New application or change in service life or terms of use. Not validated yet | Standards and design specifications are present but insufficient to ensure that the error will not occur. Analyzes show a little ability to prevent the cause of the error.
10 | Very high (constant failure) | First use of the design with technical innovations or new material, First time application of a new technology with no application experience | Standards are not available and best practices have not yet been established or a few new standards and best practices exist, but not directly applicable to the new design or first use of new standards without experience
 | Detection (D)
Rating | Ability to detect the failure | Characteristic: Probability that we can still recognize the error with the cause AND CORRECT IT
10 | Unlikely | Detection controls have a weak detection capability (The error or cause is difficult to detect in the development phase and / or it is very difficult to implement a solution)
7 | Low | Low probability that currenct controls will detect failure (The error or the cause is recognized only AFTER DEVELOPMENT PHASE or solutions are DIFFICULT TO IMPLEMENT or EXPENSIVE.
5 | Moderate | Medium probability that current controls will detect failure (The error or the cause is only partially recognized and necessary solutions will probably be above the given budget)
3 | High | High probability that current controls will detect failure (It is likely that the error or cause will be detected in time and solutions will be found. The solution will be within budget)
1 | Almost certain | current controls are almost certain to detect this failure (If the error or the cause should appear, it will certainly be detected in the development phase and it can be found in any case, a cost-neutral solution)

Sheet: Task Priority (TP)
S | O | D | TP | DFMEA Task Priority (TP) Logic
9-10 | 6-10 | 1-10 | H | High priority due to safety relevance or legal / regulatory requirements, which has a high or very high occurrence rating
9-10 | 4-5 | 7-10 | H | High priority due to safety relevance or legal / regulatory requirements, which has a moderate occurrence rating and a high detection score
9-10 | 4-5 | 5-6 | H | High priority due to safety relevance or legal / regulatory requirements, which has a moderate occurrence score and a moderate detection score
9-10 | 4-5 | 1-4 | M | Medium priority due to safety relevance or legal / regulatory requirements, which has a moderate occurrence score and a low detection score
9-10 | 1-3 | 7-10 | H | High priority due to safety relevance or legal / regulatory requirements, which has a low occurrence score and a high detection score
9-10 | 1-3 | 5-6 | M | Medium priority due to safety relevance or legal / regulatory requirements, which has a low occurrence score and a moderate detection score
9-10 | 1-3 | 1-4 | L | Low priority due to safety relevance or legal / regulatory requirements, which has a low occurrence score and a low detection score
5-8 | 8-10 | 2-10 | H | High priority due to loss or degradation of the main or assistance function of the vehicle, which has a very high occurrence rating
5-8 | 6-7 | 7-10 | H | High priority due to loss or degradation of the vehicle's main or assistance function, which has a high occurrence score and a high detection score
5-8 | 6-7 | 5-6 | H | High priority due to loss or degradation of the vehicle's main or assistance function, which has a high occurrence score and a moderate detection score
5-8 | 6-7 | 1-4 | M | Medium priority due to loss or degradation of the vehicle's main or assistance function, which has a high occurrence score and a low detection score
5-8 | 4-5 | 7-10 | H | High priority due to loss or degradation of the vehicle's main or assistance function, which has a moderate occurrence score and a high detection score
5-8 | 4-5 | 5-6 | H | High priority due to loss or degradation of the vehicle's main or assistance function, which has a moderate occurrence score and a moderate detection score
5-8 | 4-5 | 1-4 | M | Medium priority due to loss or degradation of the main or assistive function of the vehicle, which has a moderate occurrence score and a low detection score
5-8 | 1-3 | 7-10 | M | Medium priority due to loss or degradation of the vehicle's main or assistance function, which has a low occurrence score and a high detection score
5-8 | 1-3 | 5-6 | M | Medium priority due to loss or degradation of the main or assistive function of the vehicle, which has a low occurrence score and a moderate detection score
5-8 | 1-3 | 1-4 | L | Low priority due to loss or degradation of the vehicle's main or assistance function, which has a low occurrence score and a low detection score
2-4 | 8-10 | 1-10 | H | High priority due to the perceived quality (appearance, sound, feel) with a very high appearance rating
2-4 | 6-7 | 7-10 | H | High priority due to the perceived quality (appearance, sound, feel) with a high occurrence rating and a high Discovery rating
2-4 | 6-7 | 5-6 | H | High priority due to the perceived quality (appearance, sound, feel) with a high occurrence rating and a moderate detection score
2-4 | 6-7 | 1-4 | M | Medium priority due to the perceived quality (appearance, sound, feel) with a high occurrence rating and a low detection score
2-4 | 4-5 | 7-10 | H | High priority due to the perceived quality (appearance, sound, feel) with a moderate occurrence rating and a high detection score
2-4 | 4-5 | 5-6 | M | Medium priority due to the perceived quality (appearance, sound, feel) with a moderate occurrence rating and a moderate detection score
2-4 | 4-5 | 1-4 | L | Low priority due to the perceived quality (appearance, sound, feel) with a moderate occurrence rating and a low detection score
2-4 | 1-3 | 7-10 | M | Medium priority due to the perceived quality (appearance, sound, feel) with a low occurrence rating and a high detection score
2-4 | 1-3 | 5-6 | L | Low priority due to the perceived quality (appearance, sound, feel) with a low occurrence score and a moderate detection score
2-4 | 1-3 | 1-4 | L | Low priority due to the perceived quality (appearance, sound, feel) with a low occurrence rating and a low detection score
1 | 1-10 | 1-10 | L | Low priority due to an imperceptible impact
