MattdewT/KE3/Lagerkraft und Biegemoment-Version2.xlsm

Sheet: Tabelle1
Berechnung des Biegemomentenverlaufes |  |  |  |  | für 4 Abschnitte
Eingabewerte: |  |  | Vorzeichenrichtig nach Skizze!!!
l0= | 20 | mm | Im Angriffspunkt A | FAy | 2913.44 | N | FAz | -340.44 | N
l1= | 65 | mm | Im Angriffspunkt B | FBy | 241.96 | N | FBz | 2331.04 | N
l2= | 160 | mm | Im Angriffspunkt C | 471.0483871 | -2500 | N | FZug1z bzw. FG1 | -73 | N
l3= | 65 | mm | Im Angriffspunkt D | 631.0483871 | -2500 | N | FZug1z bzw. FG2 | -73 | N
l4= | 65 | mm | Im Angriffspunkt E | FKy | 1844.6 | N | FKz | -1844.6 | N
l5= | 20 | mm | In E eingeleitetes Torsionsmoment |  | 240 | Nm
 |  |  |  | 0
 |  |  |  | 0
 |  |  |  | 0
 |  |  |  | 0
Ergebnisse:
Maximales Biegemoment |  |  |  | Mbmax | 270.34 | Nm
Lagerkraft in Lager A |  |  |  | FA | 2933.26 | N
Lagerkraft in Lager B |  |  |  | FB | 2343.56 | N

Sheet: Tabelle2
Biegemomente |  |  | DYNAMISCH | STATISCH | DYNAMISCH | STATISCH
s in mm von Lager A aus | Mb x-y-Ebene in Nm | Mb x-z-Ebene in Nm | Gesamt-Biegemoment in Nm | Gesamt-Biegemoment in Nm | Torsionsmoment in Nm | Torsionsmoment in Nm
-20 | 0 | 0 | 0 | 0 | 0 | 0
-19.5 | 0 | 0 | 0 | 0 | 0 | 0
-19 | 0 | 0 | 0 | 0 | 0 | 0
-18.5 | 0 | 0 | 0 | 0 | 0 | 0
-18 | 0 | 0 | 0 | 0 | 0 | 0
-17.5 | 0 | 0 | 0 | 0 | 0 | 0
-17 | 0 | 0 | 0 | 0 | 0 | 0
-16.5 | 0 | 0 | 0 | 0 | 0 | 0
-16 | 0 | 0 | 0 | 0 | 0 | 0
-15.5 | 0 | 0 | 0 | 0 | 0 | 0
-15 | 0 | 0 | 0 | 0 | 0 | 0
-14.5 | 0 | 0 | 0 | 0 | 0 | 0
-14 | 0 | 0 | 0 | 0 | 0 | 0
-13.5 | 0 | 0 | 0 | 0 | 0 | 0
-13 | 0 | 0 | 0 | 0 | 0 | 0
-12.5 | 0 | 0 | 0 | 0 | 0 | 0
-12 | 0 | 0 | 0 | 0 | 0 | 0
-11.5 | 0 | 0 | 0 | 0 | 0 | 0
-11 | 0 | 0 | 0 | 0 | 0 | 0
-10.5 | 0 | 0 | 0 | 0 | 0 | 0
-10 | 0 | 0 | 0 | 0 | 0 | 0
-9.5 | 0 | 0 | 0 | 0 | 0 | 0
-9 | 0 | 0 | 0 | 0 | 0 | 0
-8.5 | 0 | 0 | 0 | 0 | 0 | 0
-8 | 0 | 0 | 0 | 0 | 0 | 0
-7.5 | 0 | 0 | 0 | 0 | 0 | 0
-7 | 0 | 0 | 0 | 0 | 0 | 0
-6.5 | 0 | 0 | 0 | 0 | 0 | 0
-6 | 0 | 0 | 0 | 0 | 0 | 0
-5.5 | 0 | 0 | 0 | 0 | 0 | 0
-5 | 0 | 0 | 0 | 0 | 0 | 0
-4.5 | 0 | 0 | 0 | 0 | 0 | 0
-4 | 0 | 0 | 0 | 0 | 0 | 0
-3.5 | 0 | 0 | 0 | 0 | 0 | 0
-3 | 0 | 0 | 0 | 0 | 0 | 0
-2.5 | 0 | 0 | 0 | 0 | 0 | 0
-2 | 0 | 0 | 0 | 0 | 0 | 0
-1.5 | 0 | 0 | 0 | 0 | 0 | 0
-1 | 0 | 0 | 0 | 0 | 0 | 0
-0.5 | 0 | 0 | 0 | 0 | 0 | 0
0 | 0 | 0 | 0 | 0 | 0 | 0
0.5 | 1.45672 | -0.17022 | 1.47 | 0 | 0 | 0
1 | 2.91344 | -0.34044 | 2.93 | 0 | 0 | 0
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
1385 |  |  | 0 | 0 |  | 0
1385.5 |  |  | 0 | 0 |  | 0
1386 |  |  | 0 | 0 |  | 0
1386.5 |  |  | 0 | 0 |  | 0
1387 |  |  | 0 | 0 |  | 0
1387.5 |  |  | 0 | 0 |  | 0
1388 |  |  | 0 | 0 |  | 0
1388.5 |  |  | 0 | 0 |  | 0
1389 |  |  | 0 | 0 |  | 0
1389.5 |  |  | 0 | 0 |  | 0
1390 |  |  | 0 | 0 |  | 0
1390.5 |  |  | 0 | 0 |  | 0
1391 |  |  | 0 | 0 |  | 0
1391.5 |  |  | 0 | 0 |  | 0
1392 |  |  | 0 | 0 |  | 0
1392.5 |  |  | 0 | 0 |  | 0
1393 |  |  | 0 | 0 |  | 0
1393.5 |  |  | 0 | 0 |  | 0
1394 | 0 | 0 | 0 | 0 |  | 0
1394.5 | 0 | 0 | 0 | 0 |  | 0
1395 | 0 | 0 | 0 | 0 |  | 0

Sheet: Tabelle3
Berechnung kritischer Querschnitte
Position s auf der Welle, vom Lager A aus in mm |  | mm | 10
(kleinster) Durchmesser an der Stelle s in mm |  | mm | 40
Formzahl für Biegung αkb |  |  | 1.2
Formzahl für Torsion αkt |  |  | 1.2 | Zellen E3 bis E8 ausfüllen und auf "Spannungen berechnen" klicken
Kerbwirkungszahl für Biegung βkb |  |  | 1
Kerbwirkungszahl für Torsion βkt |  |  | 1
Momente
Torsionsmoment statischer Anteil |  | Nm | 0 | aus Tabelle 2
Torsionsmoment dynamischer Anteil |  | Nm | 0 | aus Tabelle 2
Biegemoment statischer Anteil |  | Nm |  | aus Tabelle 2
Biegemoment dynamischer Anteil |  | Nm | 29.33 | aus Tabelle 2
Nennspannungen (ohne Kerbwirkung)
Nenntorsionsspannung statischer Anteil |  | N/mm^2 | 0 | Formel Decker 15.7, mit Anwendungsfaktor KA=1,25
Nenntorsionsspannung dynamischer Anteil |  | N/mm^2 | 0 | Formel Decker 15.7, mit Anwendungsfaktor KA=1,25
Nennbiegespannung statischer Anteil |  | N/mm^2 | 0 | Formel Decker 15.5, mit Anwendungsfaktor KA=1,25
Nennbiegespannung dynamischer Anteil |  | N/mm^2 | 2.92 | Formel Decker 15.5, mit Anwendungsfaktor KA=1,25
Vergleichsmittelspannung --> hier nur aus Torsion |  | N/mm^2 | 0 | Formel Decker 15.16
Vergleichsausschlagsspannung --> hier nur aus Biegung |  | N/mm^2 | 2.92 | Formel Decker 15.16
Obere Vergleichsausschlagsspannung |  | N/mm^2 | 2.92 | Formel Decker 15.17
Dauerfestigkeit (aus dem Smith-Diagramm abgelesen mit der errechneten Vergleichsmittelspannung) |  | N/mm^2 | 300 | Zellen E28 bis E32 ausfüllen (b1 und b2 sind optional) und auf "Festigkeitsnachweis durchführen" klicken
Re |  | N/mm^2 | 650
Rm |  | N/mm^2 | 900
Oberflächenbeiwert b1 |  |  |  | aus Decker Bild 15.14
Größenbeiwert b2 |  |  |  | aus Decker Bild 15.15
Zulässige obere Vergleichsspannung |  | N/mm^2 | 150 | Formel Decker 15.18
Zulässige Vergleichsausschlagsspannung |  | N/mm^2 | 150 | Formel Decker 15.19
Festigkeitsnachweis |  |  |  | Felder bleiben rot, solange der Festigkeitswert nicht zu den obigen Spannungen passt, weil noch nicht aktualisiert wurde
dynamisch | Dauerbruch aufgrund oberer V.spannung | ausreichend | 102.739726 | Formel Decker 15.19, notwendige Sicherheiten nach Decker Kap.15
dynamisch | Dauerbruch aufgrund Schwingamplitude | ausreichend | 308.2191781 | Formel Decker 15.18, notwendige Sicherheiten nach Decker Kap.15

Sheet: Q1
Berechnung kritischer Querschnitt 1
Position s auf der Welle, vom Lager A aus in mm |  | mm | -7.5
(kleinster) Durchmesser an der Stelle s in mm |  | mm | 37.5
Formzahl für Biegung αkb |  |  | 4.03
Formzahl für Torsion αkt |  |  | 2.68 | Zellen E3 bis E8 ausfüllen und auf "Spannungen berechnen" klicken
Kerbwirkungszahl für Biegung βkb |  |  | 3.25
Kerbwirkungszahl für Torsion βkt |  |  | 2.25
Momente
Torsionsmoment statischer Anteil |  | Nm | 0 | aus Tabelle 2
Torsionsmoment dynamischer Anteil |  | Nm | 0 | aus Tabelle 2
Biegemoment statischer Anteil |  | Nm | 0 | aus Tabelle 2
Biegemoment dynamischer Anteil |  | Nm | 0 | aus Tabelle 2
Nennspannungen (ohne Kerbwirkung)
Nenntorsionsspannung statischer Anteil |  | N/mm^2 | 0 | Formel Decker 15.7, mit Anwendungsfaktor KA=1,25
Nenntorsionsspannung dynamischer Anteil |  | N/mm^2 | 0 | Formel Decker 15.7, mit Anwendungsfaktor KA=1,25
Nennbiegespannung statischer Anteil |  | N/mm^2 | 0 | Formel Decker 15.5, mit Anwendungsfaktor KA=1,25
Nennbiegespannung dynamischer Anteil |  | N/mm^2 | 0 | Formel Decker 15.5, mit Anwendungsfaktor KA=1,25
Vergleichsmittelspannung --> hier nur aus Torsion |  | N/mm^2 | 0 | Formel Decker 15.16
Vergleichsausschlagsspannung --> hier nur aus Biegung |  | N/mm^2 | 0 | Formel Decker 15.16
Obere Vergleichsausschlagsspannung |  | N/mm^2 | 0 | Formel Decker 15.17
Dauerfestigkeit (aus dem Smith-Diagramm abgelesen mit der errechneten Vergleichsmittelspannung) |  | N/mm^2 | 405 | Zellen E28 bis E32 ausfüllen (b1 und b2 sind optional) und auf "Festigkeitsnachweis durchführen" klicken
Re |  | N/mm^2 | 650
Rm |  | N/mm^2 | 900
Oberflächenbeiwert b1 |  |  | 0.77 | aus Decker Bild 15.14
Größenbeiwert b2 |  |  | 1 | aus Decker Bild 15.15
Zulässige obere Vergleichsspannung |  | N/mm^2 | 155.925 | Formel Decker 15.18
Zulässige Vergleichsausschlagsspannung |  | N/mm^2 | 155.925 | Formel Decker 15.19
Festigkeitsnachweis |  |  |  | Felder bleiben rot, solange der Festigkeitswert nicht zu den obigen Spannungen passt, weil noch nicht aktualisiert wurde
dynamisch | Dauerbruch aufgrund oberer V.spannung | ausreichend | Divison durch 0 nicht möglich | Formel Decker 15.19, notwendige Sicherheiten nach Decker Kap.15
dynamisch | Dauerbruch aufgrund Schwingamplitude | ausreichend | Division durch 0 nicht möglich | Formel Decker 15.18, notwendige Sicherheiten nach Decker Kap.15
Der Festigkeitsnachweis ist nicht nötig, da keine Kräfte oder Momente auf den Querschnitt wirken.

Sheet: Q2
Berechnung kritischer Querschnitt 2
Position s auf der Welle, vom Lager A aus in mm |  | mm | 7.5
(kleinster) Durchmesser an der Stelle s in mm |  | mm | 40
Formzahl für Biegung αkb |  |  | 2.96
Formzahl für Torsion αkt |  |  | 1.89 | Zellen E3 bis E8 ausfüllen und auf "Spannungen berechnen" klicken
Kerbwirkungszahl für Biegung βkb |  |  | 2.57
Kerbwirkungszahl für Torsion βkt |  |  | 1.45
Momente
Torsionsmoment statischer Anteil |  | Nm | 0 | aus Tabelle 2
Torsionsmoment dynamischer Anteil |  | Nm | 0 | aus Tabelle 2
Biegemoment statischer Anteil |  | Nm | 0 | aus Tabelle 2
Biegemoment dynamischer Anteil |  | Nm | 22 | aus Tabelle 2
Nennspannungen (ohne Kerbwirkung)
Nenntorsionsspannung statischer Anteil |  | N/mm^2 | 0 | Formel Decker 15.7, mit Anwendungsfaktor KA=1,25
Nenntorsionsspannung dynamischer Anteil |  | N/mm^2 | 0 | Formel Decker 15.7, mit Anwendungsfaktor KA=1,25
Nennbiegespannung statischer Anteil |  | N/mm^2 | 0 | Formel Decker 15.5, mit Anwendungsfaktor KA=1,25
Nennbiegespannung dynamischer Anteil |  | N/mm^2 | 4.38 | Formel Decker 15.5, mit Anwendungsfaktor KA=1,25
Vergleichsmittelspannung --> hier nur aus Torsion |  | N/mm^2 | 0 | Formel Decker 15.16
Vergleichsausschlagsspannung --> hier nur aus Biegung |  | N/mm^2 | 11.25 | Formel Decker 15.16
Obere Vergleichsausschlagsspannung |  | N/mm^2 | 11.25 | Formel Decker 15.17
Dauerfestigkeit (aus dem Smith-Diagramm abgelesen mit der errechneten Vergleichsmittelspannung) |  | N/mm^2 | 405 | Zellen E28 bis E32 ausfüllen (b1 und b2 sind optional) und auf "Festigkeitsnachweis durchführen" klicken
Re |  | N/mm^2 | 650
Rm |  | N/mm^2 | 900
Oberflächenbeiwert b1 |  |  | 0.77 | aus Decker Bild 15.14
Größenbeiwert b2 |  |  | 1 | aus Decker Bild 15.15
Zulässige obere Vergleichsspannung |  | N/mm^2 | 155.925 | Formel Decker 15.18
Zulässige Vergleichsausschlagsspannung |  | N/mm^2 | 155.925 | Formel Decker 15.19
Festigkeitsnachweis |  |  |  | Felder bleiben rot, solange der Festigkeitswert nicht zu den obigen Spannungen passt, weil noch nicht aktualisiert wurde
dynamisch | Dauerbruch aufgrund oberer V.spannung | ausreichend | 27.72 | Formel Decker 15.19, notwendige Sicherheiten nach Decker Kap.15
dynamisch | Dauerbruch aufgrund Schwingamplitude | ausreichend | 27.72 | Formel Decker 15.18, notwendige Sicherheiten nach Decker Kap.15

Sheet: Q3
Berechnung kritischer Querschnitt 3
Position s auf der Welle, vom Lager A aus in mm |  | mm | 65
(kleinster) Durchmesser an der Stelle s in mm |  | mm | 45
Formzahl für Biegung αkb |  |  | 1.7
Formzahl für Torsion αkt |  |  | 1.4 | Zellen E3 bis E8 ausfüllen und auf "Spannungen berechnen" klicken
Kerbwirkungszahl für Biegung βkb |  |  | 1.4
Kerbwirkungszahl für Torsion βkt |  |  | 1.21
Momente
Torsionsmoment statischer Anteil |  | Nm | 120 | aus Tabelle 2
Torsionsmoment dynamischer Anteil |  | Nm | 0 | aus Tabelle 2
Biegemoment statischer Anteil |  | Nm | 0 | aus Tabelle 2
Biegemoment dynamischer Anteil |  | Nm | 190.66 | aus Tabelle 2
Nennspannungen (ohne Kerbwirkung)
Nenntorsionsspannung statischer Anteil |  | N/mm^2 | 8.39 | Formel Decker 15.7, mit Anwendungsfaktor KA=1,25
Nenntorsionsspannung dynamischer Anteil |  | N/mm^2 | 0 | Formel Decker 15.7, mit Anwendungsfaktor KA=1,25
Nennbiegespannung statischer Anteil |  | N/mm^2 | 0 | Formel Decker 15.5, mit Anwendungsfaktor KA=1,25
Nennbiegespannung dynamischer Anteil |  | N/mm^2 | 26.65 | Formel Decker 15.5, mit Anwendungsfaktor KA=1,25
Vergleichsmittelspannung --> hier nur aus Torsion |  | N/mm^2 | 20.34 | Formel Decker 15.16
Vergleichsausschlagsspannung --> hier nur aus Biegung |  | N/mm^2 | 37.31 | Formel Decker 15.16
Obere Vergleichsausschlagsspannung |  | N/mm^2 | 57.65 | Formel Decker 15.17
Dauerfestigkeit (aus dem Smith-Diagramm abgelesen mit der errechneten Vergleichsmittelspannung) |  | N/mm^2 | 405 | Zellen E28 bis E32 ausfüllen (b1 und b2 sind optional) und auf "Festigkeitsnachweis durchführen" klicken
Re |  | N/mm^2 | 650
Rm |  | N/mm^2 | 900
Oberflächenbeiwert b1 |  |  | 0.77 | aus Decker Bild 15.14
Größenbeiwert b2 |  |  | 1 | aus Decker Bild 15.15
Zulässige obere Vergleichsspannung |  | N/mm^2 | 163.7559 | Formel Decker 15.18
Zulässige Vergleichsausschlagsspannung |  | N/mm^2 | 155.925 | Formel Decker 15.19
Festigkeitsnachweis |  |  |  | Felder bleiben rot, solange der Festigkeitswert nicht zu den obigen Spannungen passt, weil noch nicht aktualisiert wurde
dynamisch | Dauerbruch aufgrund oberer V.spannung | ausreichend | 5.68 | Formel Decker 15.19, notwendige Sicherheiten nach Decker Kap.15
dynamisch | Dauerbruch aufgrund Schwingamplitude | ausreichend | 8.36 | Formel Decker 15.18, notwendige Sicherheiten nach Decker Kap.15

Sheet: Q4
Berechnung kritischer Querschnitt 4
Position s auf der Welle, vom Lager A aus in mm |  | mm | 145
(kleinster) Durchmesser an der Stelle s in mm |  | mm | 48
Formzahl für Biegung αkb |  |  | 1
Formzahl für Torsion αkt |  |  | 1 | Zellen E3 bis E8 ausfüllen und auf "Spannungen berechnen" klicken
Kerbwirkungszahl für Biegung βkb |  |  | 1
Kerbwirkungszahl für Torsion βkt |  |  | 1
Momente
Torsionsmoment statischer Anteil |  | Nm | 120 | aus Tabelle 2
Torsionsmoment dynamischer Anteil |  | Nm | 0 | aus Tabelle 2
Biegemoment statischer Anteil |  | Nm | 0 | aus Tabelle 2
Biegemoment dynamischer Anteil |  | Nm | 229.2 | aus Tabelle 2
Nennspannungen (ohne Kerbwirkung)
Nenntorsionsspannung statischer Anteil |  | N/mm^2 | 6.91 | Formel Decker 15.7, mit Anwendungsfaktor KA=1,25
Nenntorsionsspannung dynamischer Anteil |  | N/mm^2 | 0 | Formel Decker 15.7, mit Anwendungsfaktor KA=1,25
Nennbiegespannung statischer Anteil |  | N/mm^2 | 0 | Formel Decker 15.5, mit Anwendungsfaktor KA=1,25
Nennbiegespannung dynamischer Anteil |  | N/mm^2 | 26.4 | Formel Decker 15.5, mit Anwendungsfaktor KA=1,25
Vergleichsmittelspannung --> hier nur aus Torsion |  | N/mm^2 | 11.97 | Formel Decker 15.16
Vergleichsausschlagsspannung --> hier nur aus Biegung |  | N/mm^2 | 26.4 | Formel Decker 15.16
Obere Vergleichsausschlagsspannung |  | N/mm^2 | 38.37 | Formel Decker 15.17
Dauerfestigkeit (aus dem Smith-Diagramm abgelesen mit der errechneten Vergleichsmittelspannung) |  | N/mm^2 | 405 | Zellen E28 bis E32 ausfüllen (b1 und b2 sind optional) und auf "Festigkeitsnachweis durchführen" klicken
Re |  | N/mm^2 | 650
Rm |  | N/mm^2 | 900
Oberflächenbeiwert b1 |  |  | 0.77 | aus Decker Bild 15.14
Größenbeiwert b2 |  |  | 1 | aus Decker Bild 15.15
Zulässige obere Vergleichsspannung |  | N/mm^2 | 160.53345 | Formel Decker 15.18
Zulässige Vergleichsausschlagsspannung |  | N/mm^2 | 155.925 | Formel Decker 15.19
Festigkeitsnachweis |  |  |  | Felder bleiben rot, solange der Festigkeitswert nicht zu den obigen Spannungen passt, weil noch nicht aktualisiert wurde
dynamisch | Dauerbruch aufgrund oberer V.spannung | ausreichend | 8.37 | Formel Decker 15.19, notwendige Sicherheiten nach Decker Kap.15
dynamisch | Dauerbruch aufgrund Schwingamplitude | ausreichend | 11.81 | Formel Decker 15.18, notwendige Sicherheiten nach Decker Kap.15

Sheet: Q5
Berechnung kritischer Querschnitt 5
Position s auf der Welle, vom Lager A aus in mm |  | mm | 225
(kleinster) Durchmesser an der Stelle s in mm |  | mm | 45
Formzahl für Biegung αkb |  |  | 1.7
Formzahl für Torsion αkt |  |  | 1.4 | Zellen E3 bis E8 ausfüllen und auf "Spannungen berechnen" klicken
Kerbwirkungszahl für Biegung βkb |  |  | 1.4
Kerbwirkungszahl für Torsion βkt |  |  | 1.21
Momente
Torsionsmoment statischer Anteil |  | Nm | 240 | aus Tabelle 2
Torsionsmoment dynamischer Anteil |  | Nm | 0 | aus Tabelle 2
Biegemoment statischer Anteil |  | Nm | 0 | aus Tabelle 2
Biegemoment dynamischer Anteil |  | Nm | 270.34 | aus Tabelle 2
Nennspannungen (ohne Kerbwirkung)
Nenntorsionsspannung statischer Anteil |  | N/mm^2 | 16.78 | Formel Decker 15.7, mit Anwendungsfaktor KA=1,25
Nenntorsionsspannung dynamischer Anteil |  | N/mm^2 | 0 | Formel Decker 15.7, mit Anwendungsfaktor KA=1,25
Nennbiegespannung statischer Anteil |  | N/mm^2 | 0 | Formel Decker 15.5, mit Anwendungsfaktor KA=1,25
Nennbiegespannung dynamischer Anteil |  | N/mm^2 | 37.79 | Formel Decker 15.5, mit Anwendungsfaktor KA=1,25
Vergleichsmittelspannung --> hier nur aus Torsion |  | N/mm^2 | 40.68 | Formel Decker 15.16
Vergleichsausschlagsspannung --> hier nur aus Biegung |  | N/mm^2 | 52.91 | Formel Decker 15.16
Obere Vergleichsausschlagsspannung |  | N/mm^2 | 93.59 | Formel Decker 15.17
Dauerfestigkeit (aus dem Smith-Diagramm abgelesen mit der errechneten Vergleichsmittelspannung) |  | N/mm^2 | 405 | Zellen E28 bis E32 ausfüllen (b1 und b2 sind optional) und auf "Festigkeitsnachweis durchführen" klicken
Re |  | N/mm^2 | 650
Rm |  | N/mm^2 | 900
Oberflächenbeiwert b1 |  |  | 0.77 | aus Decker Bild 15.14
Größenbeiwert b2 |  |  | 1 | aus Decker Bild 15.15
Zulässige obere Vergleichsspannung |  | N/mm^2 | 171.5868 | Formel Decker 15.18
Zulässige Vergleichsausschlagsspannung |  | N/mm^2 | 155.925 | Formel Decker 15.19
Festigkeitsnachweis |  |  |  | Felder bleiben rot, solange der Festigkeitswert nicht zu den obigen Spannungen passt, weil noch nicht aktualisiert wurde
dynamisch | Dauerbruch aufgrund oberer V.spannung | ausreichend | 3.67 | Formel Decker 15.19, notwendige Sicherheiten nach Decker Kap.15
dynamisch | Dauerbruch aufgrund Schwingamplitude | ausreichend | 5.89 | Formel Decker 15.18, notwendige Sicherheiten nach Decker Kap.15

Sheet: Q6
Berechnung kritischer Querschnitt 6
Position s auf der Welle, vom Lager A aus in mm |  | mm | 282.5
(kleinster) Durchmesser an der Stelle s in mm |  | mm | 40
Formzahl für Biegung αkb |  |  | 2.96
Formzahl für Torsion αkt |  |  | 1.89 | Zellen E3 bis E8 ausfüllen und auf "Spannungen berechnen" klicken
Kerbwirkungszahl für Biegung βkb |  |  | 2.57
Kerbwirkungszahl für Torsion βkt |  |  | 1.45
Momente
Torsionsmoment statischer Anteil |  | Nm | 240 | aus Tabelle 2
Torsionsmoment dynamischer Anteil |  | Nm | 0 | aus Tabelle 2
Biegemoment statischer Anteil |  | Nm | 0 | aus Tabelle 2
Biegemoment dynamischer Anteil |  | Nm | 178.57 | aus Tabelle 2
Nennspannungen (ohne Kerbwirkung)
Nenntorsionsspannung statischer Anteil |  | N/mm^2 | 23.89 | Formel Decker 15.7, mit Anwendungsfaktor KA=1,25
Nenntorsionsspannung dynamischer Anteil |  | N/mm^2 | 0 | Formel Decker 15.7, mit Anwendungsfaktor KA=1,25
Nennbiegespannung statischer Anteil |  | N/mm^2 | 0 | Formel Decker 15.5, mit Anwendungsfaktor KA=1,25
Nennbiegespannung dynamischer Anteil |  | N/mm^2 | 35.54 | Formel Decker 15.5, mit Anwendungsfaktor KA=1,25
Vergleichsmittelspannung --> hier nur aus Torsion |  | N/mm^2 | 78.19 | Formel Decker 15.16
Vergleichsausschlagsspannung --> hier nur aus Biegung |  | N/mm^2 | 91.35 | Formel Decker 15.16
Obere Vergleichsausschlagsspannung |  | N/mm^2 | 169.54 | Formel Decker 15.17
Dauerfestigkeit (aus dem Smith-Diagramm abgelesen mit der errechneten Vergleichsmittelspannung) |  | N/mm^2 | 405 | Zellen E28 bis E32 ausfüllen (b1 und b2 sind optional) und auf "Festigkeitsnachweis durchführen" klicken
Re |  | N/mm^2 | 650
Rm |  | N/mm^2 | 900
Oberflächenbeiwert b1 |  |  | 0.77 | aus Decker Bild 15.14
Größenbeiwert b2 |  |  | 1 | aus Decker Bild 15.15
Zulässige obere Vergleichsspannung |  | N/mm^2 | 186.02815 | Formel Decker 15.18
Zulässige Vergleichsausschlagsspannung |  | N/mm^2 | 155.925 | Formel Decker 15.19
Festigkeitsnachweis |  |  |  | Felder bleiben rot, solange der Festigkeitswert nicht zu den obigen Spannungen passt, weil noch nicht aktualisiert wurde
dynamisch | Dauerbruch aufgrund oberer V.spannung | ausreichend | 2.19 | Formel Decker 15.19, notwendige Sicherheiten nach Decker Kap.15
dynamisch | Dauerbruch aufgrund Schwingamplitude | ausreichend | 3.41 | Formel Decker 15.18, notwendige Sicherheiten nach Decker Kap.15

Sheet: Q7
Berechnung kritischer Querschnitt 7
Position s auf der Welle, vom Lager A aus in mm |  | mm | 302.5
(kleinster) Durchmesser an der Stelle s in mm |  | mm | 37.5
Formzahl für Biegung αkb |  |  | 1.35
Formzahl für Torsion αkt |  |  | 2.68 | Zellen E3 bis E8 ausfüllen und auf "Spannungen berechnen" klicken
Kerbwirkungszahl für Biegung βkb |  |  | 3.25
Kerbwirkungszahl für Torsion βkt |  |  | 2.25
Momente
Torsionsmoment statischer Anteil |  | Nm | 240 | aus Tabelle 2
Torsionsmoment dynamischer Anteil |  | Nm | 0 | aus Tabelle 2
Biegemoment statischer Anteil |  | Nm | 0 | aus Tabelle 2
Biegemoment dynamischer Anteil |  | Nm | 136.95 | aus Tabelle 2
Nennspannungen (ohne Kerbwirkung)
Nenntorsionsspannung statischer Anteil |  | N/mm^2 | 28.99 | Formel Decker 15.7, mit Anwendungsfaktor KA=1,25
Nenntorsionsspannung dynamischer Anteil |  | N/mm^2 | 0 | Formel Decker 15.7, mit Anwendungsfaktor KA=1,25
Nennbiegespannung statischer Anteil |  | N/mm^2 | 0 | Formel Decker 15.5, mit Anwendungsfaktor KA=1,25
Nennbiegespannung dynamischer Anteil |  | N/mm^2 | 33.08 | Formel Decker 15.5, mit Anwendungsfaktor KA=1,25
Vergleichsmittelspannung --> hier nur aus Torsion |  | N/mm^2 | 134.56 | Formel Decker 15.16
Vergleichsausschlagsspannung --> hier nur aus Biegung |  | N/mm^2 | 107.52 | Formel Decker 15.16
Obere Vergleichsausschlagsspannung |  | N/mm^2 | 242.08 | Formel Decker 15.17
Dauerfestigkeit (aus dem Smith-Diagramm abgelesen mit der errechneten Vergleichsmittelspannung) |  | N/mm^2 | 405 | Zellen E28 bis E32 ausfüllen (b1 und b2 sind optional) und auf "Festigkeitsnachweis durchführen" klicken
Re |  | N/mm^2 | 650
Rm |  | N/mm^2 | 900
Oberflächenbeiwert b1 |  |  | 0.77 | aus Decker Bild 15.14
Größenbeiwert b2 |  |  | 1 | aus Decker Bild 15.15
Zulässige obere Vergleichsspannung |  | N/mm^2 | 207.7306 | Formel Decker 15.18
Zulässige Vergleichsausschlagsspannung |  | N/mm^2 | 155.925 | Formel Decker 15.19
Festigkeitsnachweis |  |  |  | Felder bleiben rot, solange der Festigkeitswert nicht zu den obigen Spannungen passt, weil noch nicht aktualisiert wurde
dynamisch | Dauerbruch aufgrund oberer V.spannung | ausreichend | 1.72 | Formel Decker 15.19, notwendige Sicherheiten nach Decker Kap.15
dynamisch | Dauerbruch aufgrund Schwingamplitude | ausreichend | 2.9 | Formel Decker 15.18, notwendige Sicherheiten nach Decker Kap.15
Der Festigkeitsnachweis ist nicht nötig, da keine Kräfte oder Momente auf den Querschnitt wirken

Sheet: Q8
Berechnung kritischer Querschnitt 8
Position s auf der Welle, vom Lager A aus in mm |  | mm | 332.5
(kleinster) Durchmesser an der Stelle s in mm |  | mm | 32 |  |  | 36
Formzahl für Biegung αkb |  |  | 4.2
Formzahl für Torsion αkt |  |  | 3.6 |  | Zellen E3 bis E8 ausfüllen und auf "Spannungen berechnen" klicken
Kerbwirkungszahl für Biegung βkb |  |  | 3.85
Kerbwirkungszahl für Torsion βkt |  |  | 3.33
Momente
Torsionsmoment statischer Anteil |  | Nm | 240 |  | aus Tabelle 2
Torsionsmoment dynamischer Anteil |  | Nm | 0 |  | aus Tabelle 2
Biegemoment statischer Anteil |  | Nm | 0 |  | aus Tabelle 2
Biegemoment dynamischer Anteil |  | Nm | 58.69 |  | aus Tabelle 2
Nennspannungen (ohne Kerbwirkung)
Nenntorsionsspannung statischer Anteil |  | N/mm^2 | 34.98 |  | Formel Decker 15.7, mit Anwendungsfaktor KA=1,1
Nenntorsionsspannung dynamischer Anteil |  | N/mm^2 | 0 |  | Formel Decker 15.7, mit Anwendungsfaktor KA=1,1
Nennbiegespannung statischer Anteil |  | N/mm^2 | 0 |  | Formel Decker 15.5, mit Anwendungsfaktor KA=1,1
Nennbiegespannung dynamischer Anteil |  | N/mm^2 | 17.11 |  | Formel Decker 15.5, mit Anwendungsfaktor KA=1,1
Vergleichsmittelspannung --> hier nur aus Torsion |  | N/mm^2 | 218.14 |  | Formel Decker 15.16
Vergleichsausschlagsspannung --> hier nur aus Biegung |  | N/mm^2 | 65.87 |  | Formel Decker 15.16
Obere Vergleichsausschlagsspannung |  | N/mm^2 | 284.01 |  | Formel Decker 15.17
Dauerfestigkeit (aus dem Smith-Diagramm abgelesen mit der errechneten Vergleichsmittelspannung) |  | N/mm^2 | 341.7 |  | Zellen E28 bis E32 ausfüllen (b1 und b2 sind optional) und auf "Festigkeitsnachweis durchführen" klicken
Re |  | N/mm^2 | 0
Rm |  | N/mm^2 | 0
Oberflächenbeiwert b1 |  |  | 0.88 | Rz4 | aus Decker Bild 15.14
Größenbeiwert b2 |  |  | 1 |  | aus Decker Bild 15.15
Zulässige obere Vergleichsspannung (Sicherheit 1,7) |  | N/mm^2 | 246.3296 |  | Formel Decker 15.18
Zulässige Vergleichsausschlagsspannung (Sicherheit 1,7) |  | N/mm^2 | 150.348 |  | Formel Decker 15.19
Festigkeitsnachweis |  |  |  |  | Felder bleiben rot, solange der Festigkeitswert nicht zu den obigen Spannungen passt, weil noch nicht aktualisiert wurde
dynamisch | Dauerbruch aufgrund oberer V.spannung | ausreichend | 1.73 |  | Formel Decker 15.19, notwendige Sicherheiten nach Decker Kap.15
dynamisch | Dauerbruch aufgrund Schwingamplitude | ausreichend | 4.56 |  | Formel Decker 15.18, notwendige Sicherheiten nach Decker Kap.15

Sheet: Q9
Berechnung kritischer Querschnitt 9
Position s auf der Welle, vom Lager A aus in mm |  | mm | 371.5
(kleinster) Durchmesser an der Stelle s in mm |  | mm | 24
Formzahl für Biegung αkb |  |  | -
Formzahl für Torsion αkt |  |  | - | Zellen E3 bis E8 ausfüllen und auf "Spannungen berechnen" klicken
Kerbwirkungszahl für Biegung βkb |  |  | -
Kerbwirkungszahl für Torsion βkt |  |  | -
Momente
Torsionsmoment statischer Anteil |  | Nm | 0 | aus Tabelle 2
Torsionsmoment dynamischer Anteil |  | Nm | 0 | aus Tabelle 2
Biegemoment statischer Anteil |  | Nm | 0 | aus Tabelle 2
Biegemoment dynamischer Anteil |  | Nm | 0 | aus Tabelle 2
Nennspannungen (ohne Kerbwirkung)
Nenntorsionsspannung statischer Anteil |  | N/mm^2 | 0 | Formel Decker 15.7, mit Anwendungsfaktor KA=1,25
Nenntorsionsspannung dynamischer Anteil |  | N/mm^2 | 0 | Formel Decker 15.7, mit Anwendungsfaktor KA=1,25
Nennbiegespannung statischer Anteil |  | N/mm^2 | 0 | Formel Decker 15.5, mit Anwendungsfaktor KA=1,25
Nennbiegespannung dynamischer Anteil |  | N/mm^2 | 0 | Formel Decker 15.5, mit Anwendungsfaktor KA=1,25
Vergleichsmittelspannung --> hier nur aus Torsion |  | N/mm^2 | 0 | Formel Decker 15.16
Vergleichsausschlagsspannung --> hier nur aus Biegung |  | N/mm^2 | 0 | Formel Decker 15.16
Obere Vergleichsausschlagsspannung |  | N/mm^2 | 0 | Formel Decker 15.17
Dauerfestigkeit (aus dem Smith-Diagramm abgelesen mit der errechneten Vergleichsmittelspannung) |  | N/mm^2 | - | Zellen E28 bis E32 ausfüllen (b1 und b2 sind optional) und auf "Festigkeitsnachweis durchführen" klicken
Re |  | N/mm^2 | -
Rm |  | N/mm^2 | -
Oberflächenbeiwert b1 |  |  | - | aus Decker Bild 15.14
Größenbeiwert b2 |  |  | - | aus Decker Bild 15.15
Zulässige obere Vergleichsspannung |  | N/mm^2 | 175 | Formel Decker 15.18
Zulässige Vergleichsausschlagsspannung |  | N/mm^2 | 175 | Formel Decker 15.19
Festigkeitsnachweis |  |  |  | Felder bleiben rot, solange der Festigkeitswert nicht zu den obigen Spannungen passt, weil noch nicht aktualisiert wurde
dynamisch | Dauerbruch aufgrund oberer V.spannung | ausreichend | Divison durch 0 nicht möglich | Formel Decker 15.19, notwendige Sicherheiten nach Decker Kap.15
dynamisch | Dauerbruch aufgrund Schwingamplitude | ausreichend | Division durch 0 nicht möglich | Formel Decker 15.18, notwendige Sicherheiten nach Decker Kap.15
Der Festigkeitsnachweis ist nicht nötig, da keine Kräfte oder Momente auf den Querschnitt wirken.
