MattdewT/KE3/RB-Blessing/CE-Beurteilung.xlsx

Sheet: Grenzen der Maschine
Grenzen eines Bandförderers
Bestimmungsgemäße Nutzung
Der Bandförderer dient dem Transport von leichten bis mittelschweren Stückgütern (Gesamtgewicht aller Teile auf dem Band max. 300 kg) auf waagerechtem oder leicht steigendem Untergrund. Die Güter werden auf das sich bewegende Band gelegt und vom Bandanfang bis Bandende transportiert. Das Band wird von einer Antriebsrolle angetrieben und von einer Gegenrolle umgelenkt. Die Bandrolle wird von einem Elektromotor angetrieben.
Betriebsarten:
Zur Einrichtung und zum Aufziehen des Bandes kann ein langsamer Betriebsmodus ausgewählt werden.
Im Standardbetrieb läuft das Band kontinuierlich mit einer Geschwindigkeit von ca. 2 m/s um.
Im Falle einer Störung kann das Band in langsamer Geschwindigkeit invertiert betrieben werden. Diese Betriebsstufe darf nur kurzfristig gewählt werden.
Durch die stufenlose Regelung der Geschwindigkeit und den damit verbundenen leistungsstarken Elektromotor kann das Förderband auch individuell an den Betrieb angepasst werden.
Einsatzbereich:
Der Bandförderer kann sowohl in einer Halle als auch draußen genutzt werden. Dafür ist eine Überdachung über die gesamte Bandlänge zwingend erforderlich. Der Elektromotor darf nicht dauerhaft der Witterung ausgesetzt sein, sondern benötigt dann eine Abschirmung.
Mit einer Bandbreite von 240 mm kann eine Vielzahl von Gütern transportiert werden.
Personenkreise, die mit der Maschine / dem Produkt in Berührung kommen
 | Personenkreise
 | MA Fertigung/ Montage | MA Lager/ Materialfluss | MA der Logisitk | Händler + MA | Kunde | Wartungs-personal | Kundendienst-MA | Schrott- händler + MA
Lebensphasen*
Produktion / Montage (beim Hersteller, innerbetrieblich) | x
Transport (innerbetrieblich) |  | x | x
Transport (zum Kunden) |  |  |  | x
Transport (beim Kunden innerbetrieblich) |  |  |  |  | x
Inbetriebnahme (Zusammenbau, Installation) |  |  |  |  | x
Einrichten |  |  |  |  | x
Betrieb |  |  |  |  | x
Reinigung |  |  |  |  | x
Instandhaltung / Wartung |  |  |  |  | x | x
Fehlerfall |  |  |  | x |  | x | x
Außerbetriebnahme / Demontage |  |  |  |  | x |  |  | x
MA = Mitarbeiter
* s. Tabellenblatt Lebensphasen
Räumliche Grenzen (Wandabstand)
Die Höhe der Antriebstrommel über dem Boden beläuft sich auf mindestens 300mm bzgl. des Untertrums.
Für den Elektromotor sollte sich ein ein Netzanschluss in nächster Nähe befinden.
Zeitliche Grenzen
Die Lebensdauer beträgt 30000h, bedingt vor allem durch die Kugellager.
Weitere Grenzen
Verwendungstemperaturen: -10°C bis 40°C
Steigung bis zu 3%
Bandbreite 240mm
Vernünftigerweise vorhersehbare Fehlanwendungen:
Definition (vernünftigerweise vorhersehbare Fehlanwendungen): Tätigkeiten die mit der Maschine / dem Produkt innerhalb der gesamten Lebensdauer durch den in der Lebensphase jeweils definierten Personenkreis (z.B. Nutzer, Bedien- oder Fachpersonal) fälschlicherweise, vorsätzlich oder fahrlässig außerhalb der Grenzen der Maschine / des Produktes durchgeführt werden.
Während der ersten Lebensphase, der Produktion / Montage des Bandförderers, sind Mitarbeiter der Fertigung und Montage in direktem Kontakt mit dem Produkt. Eigenangefertige Teile können fehlerhaft produziert werden. Zukaufteile können ebenso fehlerhaft produziert, bestellt oder beim Transport beschädigt worden sein. Die Richtigkeit der Teile ist deshalb zu überprüfen.
Auch Mitarbeiter des Lagers und der Logistik können die Produkte beim Transport beschädigen.
Ebenso der Transport zum Kunden stellt ein hohes Risiko für Transportschäden dar. Das Produkt kann unter Umständen nicht fristgerecht geliefert werden oder Bestandteile davon könnten fehlen.
Bei der Inbetriebnahme des Bandförderers kann die Montageanleitung nicht ausreichend genau gelesen werden und dadurch das Produkt fehlerhaft zusammengebaut werden.
Der Kunde kann beim Einrichten des Produktes durch einen falschen Netzanschluss den Elektromotor beschädigen.
Während des Betriebes ist vom Kunden darauf zu achten, dass die Umgebungstemperaturen die angegebenen Extremwerte von -10°C bis +40°C nicht über- bzw. unterschreiten. Außerdem sollte der Bandförderer nur von befugtem Personal betrieben werden.
Das Personal sollte neben den grundsätzlichen Verhaltensweisen an Förderanlagen vor allem mit folgenden Hinweisen vertraut gemacht werden: Weite Kleidung oder offene Hare dürfen sich nicht im Einzugbereich der Trommel, der Welle oder des Bandes befinden. Das Band ist nicht als Personentransport oder zum Transport anderer Teile als denen des Stückgutes vorgesehen. Das Band sollte im laufenden Betrieb nicht mit der bloßen Hand berührt werden.
Sollte das Förderband durch den Betrieb verschmutzt worden sein, sollten keine chemikalischen Reinigungsmittel verwendet werden, da das Material des Förderbandes, der Elekromotor oder andere Teile des Bandförderers dadurch beschädigt werden könnten. Bei der Reinigung mit Wasser ist zu beachten, dass keine Wasserrücktände in den Ritzen verbleiben sollten. Sollte bei der Reinigung der Anlage eine Demontage einzelner Bestandteile notwendig sein, ist die Demontage- und anschließend die Montageanleitung zu beachten. Bei Nichtbeachten kann die Funktion der Maschine nicht mehr gewährleistet werden.
Bei der Instandhaltung und Wartung ist darauf zu achten, dass dies durch qualifiziertes Personal erfolgt.
Tritt ein Fehlerfall ein, bei dem ein Austausch von Teilen notwendig ist, ist darauf zu achten, dass Ersatzteile verwendet werden, die den Vorgaben des Herstellers entsprechen.
Wird das Produkt außer Betrieb genommen oder demontiert, muss die Demontageanleitung beachtet werden.

Sheet: Lebensphasen
Lebensphasen für die Risikobeurteilung zur CE-Konformität
Produktion / Montage (beim Hersteller, innerbetrieblich)
Transport (innerbetrieblich)
Transport (zum Kunden)
Transport (beim Kunden innerbetrieblich)
Inbetriebnahme (Zusammenbau, Installation)
Einrichten
Betrieb
Reinigung
Instandhaltung / Wartung
Fehlerfall
Außerbetriebnahme / Demontage

Sheet: Aufgaben+Tätigkeiten
Aufgaben in der Lebensphase
Lfd. Nr. | Lebensphase | Aufgaben
1 | Produktion / Montage (beim Hersteller, innerbetrieblich) | Fertigen einzelner Bauteile
2 |  | Transport von Kaufteilen zum Hersteller
3 |  | Zusammenbau zu einzelnen Baugruppen
4 | Transport (innerbetrieblich) | Transportieren der Bauteile von Maschine / Lager zur Montage
5 |  | Transportieren von zusammengebauten Baugruppen ins Lager
6 | Transport (zum Kunde) | Transportieren vom Lager zur Verpackungsstation
7 |  | Verpacken der Bauteile / Baugruppe
8 |  | Transportieren
9 |  | Entladen beim Kunde
10 |  | Auspacken
11 | Transport (beim Kunde innerbetrieblich) | Transportieren der Bauteile / Baugruppen zur Montagestation
12 | Inbetriebnahme (Zusammenbau, Installation) | Vorbereitungen für die Installation (Anschlussstelle für Betonanker vorbereiten; Fundament)
13 |  | Zusammenbau der Maschine nach der Montageanleitung
14 |  | Einstellungen an der Maschine und deren Bauteile (axiale Ausrichtung)
15 |  | Anschluss an die Stromversorgung für den Elektromotor
16 |  | Einbringen von Hilfsflüssigkeiten (Schmierstoff)
17 |  | Anbringen von Schutzeinrichtung
18 |  | Vorführung / Betrieb der Maschine ohne Last
19 |  | Prüfung
20 |  | Versuche unter Höchstlast (Gesamtgewicht aller Teile auf dem Band max. 300 kg)
21 | Einrichten | Einstellen und Einrichten bzw. Überprüfen der funktionalen Parameter der Maschine (Geschwindigkeit, Abstand zwischen Untertommel und Antriebstrommel, Höhe gegenüber dem Boden)
22 |  | Funktionsprüfung / Versuche
23 |  | Funktionsprüfung des Motors (Nothalt)
24 | Betrieb | Antreiben der Maschine
25 |  | Befördern der Stückgüter
26 |  | Beladen / Entladen des Bandförderers
27 |  | Geringfügige Einstellungs- und Einrichtungsvorgänge bei den Funktionsparamteren der Maschine
28 |  | Überwachen (Regelmäßiges Nachziehen der Betonanker, Schmierung)
29 |  | Geringfügige Eingriffe während des Betriebs (z.B. Beseitigung von Blockierungen, lokale Reinigung)
30 |  | Neustarten der Maschine nach Stillsetzen / Unterbrechung
31 | Reinigung | Demontage / Ausbau von Teilen, Bauteilen, Einrichtungen der Maschine
32 |  | Energietrennung
33 |  | Schmieren
34 | Instandhaltung / Wartung | Nachstellen funktionaler Parameter der Maschine (Geschwindigkeit, Abstand zwischen Untertommel und Antriebstrommel, Höhe gegenüber dem Boden)
35 |  | Austausch von Verschleißteilen
36 |  | Demontage / Ausbau von Teilen, Bauteilen, Einrichtungen der Maschine
37 |  | Energietrennung
38 |  | Überprüfen / Erneuern von Hilfsflüssigkeiten (Schmierstoff)
39 |  | Überprüfen von Teilen und Bauteilen der Maschine
40 | Fehlerfall | Demontage / Ausbau von Teilen, Bauteilen, Einrichtungen der Maschine
41 |  | Fehlersuche
42 |  | Energietrennung
43 |  | Wiederanlauf nach Ausfall der Steuerungseinrichtungen und Schutzeinrichtungen
44 |  | Wiederanlauf nach Blockierung
45 |  | Reparaturen
46 |  | Ersatz von Teilen, Bauteilen und Einrichtungen der Maschine
47 |  | Erneutes Einrichten
48 |  | Überprüfen von Teilen und Bauteilen der Maschine
49 | Außbetriebnahme / Demontage | Abtrennen von der Energieversorgung
50 |  | Demontage nach der Demontageanleitung
51 |  | Verpacken der Bauteile / Baugruppe
52 |  | Tranportieren
53 |  | Entladen beim Kunde
54 |  | Entsorgung

Sheet: Risikobeurteilung
Risikobeurteilung |  |  | Bandförderer |  |  |  |  |  |  |  |  |  |  | Erstellt von: 1790705 | Kürzel:
nach DIN EN ISO 12100:2011 |  |  |  |  |  |  |  |  |  |  |  |  |  | Abteilung: TM2018KM | Datum: 25.11.2019
Risikoanalyse |  |  |  |  |  | Risikobewertung
 |  |  |  |  |  |  |  |  |  |  |  |  |  |  |  |  |  |  |  |  | X
Lfd. Nr. | Lebensphase | Aufgabe/ Tätigkeit | Ursprung der Gefährdung durch Maschine, Umwelt und Mensch | Gefährdungsereignis | Folge der Gefährdung für Mensch | Häufigkeit (F) | Wahrscheinlichkeit (W) | Vermeidung (P) | Schwere (S) | Ergebnis (SIL) | konstruktive Maßnahme/ Verbesserung | Schutzmaßnahmen (technisch: ZUSÄTZLICHE Hard- und Software, Mechanik) | Montageanweisung | Handbuch (Betriebsanleitung) | Häufigkeit (F) | Wahrscheinlichkeit (W) | Vermeidung (P) | Schwere (S) | Ergebnis (SIL) | Warnung vor Restrisiken |  | Lebensphase | Anwendung/Funktion | Aufgabe/ Tätigkeit | Ursprung der Gefährdung durch Maschine, Umwelt und Mensch | Gefährdungsereignis | Folge der Gefährdung für Mensch
1 | Produktion / Montage (beim Hersteller, innerbetrieblich) | Fertigen einzelner Bauteile | U1 Mechanische Gefährdung | Kontakt mit scharfen Kanten und Ecken, vorstehenden Teilen | F1.4 Schneiden oder Abschneiden | 2 | 3 | 3 | 3 | SIL1 |  | PSA, Tätigkeiten nur von ausgebildeten Mitarbeiten durchführen lassen |  |  | 1 | 3 | 1 | 3 | AM |  |  | Produktion / Montage (beim Hersteller, innerbetrieblich) | Test | #REF! | Ursprung | Ausfall von Einrichtungen zum Anhalten von sich bewegenden Teilen | F1 Mechanische Gefährdung
2 | Produktion / Montage (beim Hersteller, innerbetrieblich) | Transport von Kaufteilen zum Hersteller | U4.5 bewegliche Teile | ungesteuerte Bewegungen | F1.11 Ausrutschen, Stolpern oder Stürzen | 2 | 3 | 1 | 1 | - |  | kritische Kauftteile wie Motor nur von Fachpersonal transportieren lassen, geeigente Paletten verwenden, nicht überladen |  |  | 2 | 3 | 1 | 1 |  |  |  | Transport (innerbetrieblich) | #REF! | #REF! | U1 Mechanische Gefährdung | Bruch während des Betriebs | F1.1 überfahren werden
3 | Produktion / Montage (beim Hersteller, innerbetrieblich) | Zusammenbau zu einzelnen Baugruppen | U1.14 scharfe Kanten | Kontakt mit scharfen Kanten und Ecken, vorstehenden Teilen | F1.3 Quetschen | 2 | 3 | 3 | 2 | AM | Entgratung der Einzelteile vorschreiben |  |  |  | 2 | 3 | 3 | 2 | AM |  |  | Transport (zum Kunden) | #REF! | #REF! | U1.1 Beschleunigung/Abbremsung (kinetische Energie) | direkter Kontakt | F1.2 weggeschleudert werden
4 | Transport (innerbetrieblich) | Transportieren der Bauteile von Maschine / Lager zur Montage | U8 Gefährdung durch unergonomische Gestaltung | übermäßige Anstrengung | F8.3 Störungen des Bewegungsapparates | 2 | 2 | 1 | 2 | - |  | Kräne und Gabelstapler zum Transport schwerer Teile verwenden |  |  | 2 | 2 | 1 | 2 |  |  |  | Transport (beim Kunden innerbetrieblich) | #REF! | #REF! | U1.2 spitze Teile | Durchschlag | F1.3 Quetschen
5 | Transport (innerbetrieblich) | Transportieren von zusammengebauten Baugruppen ins Lager | U8.8 Körperhaltung | schmerzhafte und ermüdende Körperhaltungen | F8 Gefährdung durch unergonomische Gestaltung | 2 | 2 | 1 | 2 | - |  | Sammelstelle einrichten, Unterstützung dur Gabelstapler |  |  | 2 | 2 | 1 | 2 | - |  |  | Inbetriebnahme (Zusammenbau, Installation) | #REF! | #REF! | U1.3 Annäherung eines sich bewegenden Teiles | Emission eines Geräuschpegels, der gefährdend sein kann | F1.4 Schneiden oder Abschneiden
6 | Transport (zum Kunde) | Transportieren vom Lager zur Verpackungsstation | U8.9 sich wiederholende Tätigkeiten | sich in hoher Frequenz wiederholende Tätigkeiten | F8.1 Unbehagen | 2 | 2 | 1 | 1 | - |  | Einsatz von Gabelstaplern oder FTS |  |  | 2 | 2 | 1 | 1 |  |  |  | Einrichten | #REF! | #REF! | U1.4 schneidende Teile | Emission eines Geräuschpegels, der zu Störungen der Sprachkommunikation oder zu Störungen akustischer Signale führen kann | F1.5 Einziehen oder Fangen
7 | Transport (zum Kunde) | Verpacken der Bauteile / Baugruppe | U8.1 Zugang | schmerzhafte und ermüdende Körperhaltungen | F8.2 Ermüdung | 2 | 2 | 1 | 2 | - |  | Angenehme Arbeitshöhe für ergonomisches Verpacken schaffen |  |  | 2 | 2 | 1 | 2 | - |  |  | Betrieb | #REF! | #REF! | U1.5 elastische Elemente | Emission eines Schwingungspegels, der gefährdend sein kann | F1.6 Erfassen
8 | Transport (zum Kunde) | Transportieren | U1.1 Beschleunigung/Abbremsung (kinetische Energie) | Ausfall von Einrichtungen zum Anhalten von sich bewegenden Teilen | F1.2 weggeschleudert werden | 2 | 1 | 1 | 3 | - |  |  | Für ausreichende Sicherung beim Transport durch Gurte oder andere Sicherungseinrichtungen sorgen |  | 2 | 1 | 1 | 3 | - |  |  | Reinigung | #REF! | #REF! | U1.6 herabfallende Gegenstände | Emission eines Stoffes, der gefährdend sein kann | F1.7 Reiben oder Abschürfen
9 | Transport (zum Kunde) | Entladen beim Kunde | U1.8 Höhe gegenüber dem Boden | Herabfallen oder Ausstoß von Objekten | F1.3 Quetschen | 1 | 3 | 1 | 3 | AM |  |  | Pakete mit dem Gewicht des Inhalts kennzeichnen |  | 1 | 3 | 1 | 3 | AM |  |  | Instandhaltung / Wartung | #REF! | #REF! | U1.7 Schwerkraft (gespeicherte Energie) | Emission von Strahlungsfeldern, die gefährdend sein können | F1.8 Stoß
10 | Transport (zum Kunde) | Auspacken | U1.4 schneidende Teile | Kontakt mit scharfen Kanten und Ecken, vorstehenden Teilen | F1.7 Reiben oder Abschürfen | 1 | 3 | 3 | 2 | - |  | für ausreichende Polsterung sorgen, sodass nicht beim ersten Öffnen der Verpackung gefährliche Teile zum Voschein kommen |  |  | 1 | 3 | 3 | 2 | - |  |  | Fehlerfall | #REF! | #REF! | U1.8 Höhe gegenüber dem Boden | Feuer | F1.9 Eindringen von unter Druck stehenden Medien
11 | Transport (beim Kunde innerbetrieblich) | Transportieren der Bauteile / Baugruppen zur Montagestation | U8 Gefährdung durch unergonomische Gestaltung | übermäßige Anstrengung | F8.5 alle weiteren (z.B. mechanischen, elektrischen) Probleme als Folge menschlichen Fehlverhaltens | 1 | 2 | 1 | 2 | - |  |  | Gabelstapler oder Kran als Transportmittel definieren |  | 1 | 2 | 1 | 2 | - |  |  | Außerbetriebnahme / Demontage | #REF! | #REF! | U1.9 Hochdruck | Herabfallen oder Ausstoß von Objekten | F1.10 Scheren
12 | Inbetriebnahme (Zusammenbau, Installation) | Vorbereitungen für die Installation (Anschlussstelle für Betonanker vorbereiten; Fundament) | U7.4 Stäube | Verlust der direkten Sichtbarkeit des Arbeitsbereiches | F7.1 Atembeschwerden, Ersticken | 2 | 4 | 1 | 2 | - |  |  | Vor den Gefahren von Betonstäuben warnen |  | 2 | 4 | 1 | 2 | - |  |  |  |  | #REF! | U1.10 Beweglichkeit der Maschine | Herabfallen oder Herausschleudern eines sich bewegenden Maschinenteils oder eines in der Maschine festgeklemmten Werkstückes | F1.11 Ausrutschen, Stolpern oder Stürzen
13 | Inbetriebnahme (Zusammenbau, Installation) | Zusammenbau der Maschine nach der Montageanleitung | U1.12 rotierende Teile | Kontakt mit rotierenden offenen Enden | F1.3 Quetschen | 2 | 2 | 1 | 2 | - |  |  | Kritische Punkte in der Montageanweisung kennzeichnen |  | 2 | 2 | 1 | 2 | - |  |  |  |  | #REF! | U1.11 sich bewegende Teile | Herausspritzen von Flüssigkeiten unter hohem Druck | F1.12 Durchstich oder Einstich
14 | Inbetriebnahme (Zusammenbau, Installation) | Einstellungen an der Maschine und deren Bauteile (axiale Ausrichtung) | U1.15 Standfestigkeit/-sicherheit | direkter Kontakt | F1.3 Quetschen | 2 | 1 | 1 | 2 | - |  |  | Vor dem Umfallen der Lagerböcke vor dem Festziehen der Betonanker warnen |  | 2 | 1 | 1 | 2 | - |  |  |  |  | #REF! | U1.12 rotierende Teile | indirekter Kontakt | F1.13 Ersticken
15 | Inbetriebnahme (Zusammenbau, Installation) | Anschluss an die Stromversorgung für den Elektromotor | U2.4 spannungsführende Teile | Kurzschluss | F2 Elektrische Gefährdungen | 2 | 3 | 1 | 4 | SIL2 |  |  | Elektrischen Anschluss nur durch eine elektrotechnische Fachkraft zulassen |  | 2 | 1 | 1 | 4 | SIL2 | JA, siehe vorne |  |  |  | #REF! | U1.13 raue, rutschige Oberfläche | Kontakt mit Objekten hoher oder geringer Temperatur | ./.
16 | Inbetriebnahme (Zusammenbau, Installation) | Einbringen von Hilfsflüssigkeiten (Schmierstoff) | U7 Gefährdungen durch Materialien und Stoffe | direkter Kontakt | F6.2 Augen- und Hautschädigung | 2 | 3 | 1 | 2 | - |  |  | Schmierstoff nur mit Handschuhen berühren |  | 2 | 3 | 1 | 2 | - |  |  |  |  | #REF! | U1.14 scharfe Kanten | Kontakt mit rauen Oberflächen | ./.
17 | Inbetriebnahme (Zusammenbau, Installation) | Anbringen von Schutzeinrichtung | U1.11 sich bewegende Teile | menschliche Fehler/ menschliches Fehlverhalten (unbeabsichtigt und/oder vorsätzlich durch die Konstruktion hervorgerufen) | F1.5 Einziehen oder Fangen | 2 | 3 | 1 | 3 | AM |  | Anlaufsicherung vor der Bestätigung des Anbringens von Schutzeinrichtungen anbringen |  |  | 2 | 3 | 1 | 3 | AM |  |  |  |  | #REF! | U1.15 Standfestigkeit/-sicherheit | Kontakt mit rotierenden offenen Enden | ./.
18 | Inbetriebnahme (Zusammenbau, Installation) | Vorführung / Betrieb der Maschine ohne Last | U1.10 Beweglichkeit der Maschine | Kontakt mit rauen Oberflächen | F1.5 Einziehen oder Fangen | 2 | 3 | 1 | 3 | AM |  |  |  | Laufende Anlage darf nicht berührt werden | 2 | 3 | 1 | 3 | AM |  |  |  |  | #REF! | U1.16 Vakuum | Kontakt mit scharfen Kanten und Ecken, vorstehenden Teilen | 0
19 | Inbetriebnahme (Zusammenbau, Installation) | Prüfung | U1.12 rotierende Teile | Kontakt mit rotierenden offenen Enden | F1.5 Einziehen oder Fangen | 2 | 3 | 1 | 3 | AM |  |  |  | Zur Prüfung rotierender Teile dürfen keine Handschuhe oder weite Kleidung getragen werden | 2 | 3 | 1 | 3 | AM |  |  |  |  | #REF! | U1.17 Beschleunigung/Abbremsung | Kurzschluss | 0
20 | Inbetriebnahme (Zusammenbau, Installation) | Versuche unter Höchstlast (Gesamtgewicht aller Teile auf dem Band max. 300 kg) | U2.6 Überlast | Bruch während des Betriebs | F1.2 weggeschleudert werden | 2 | 2 | 1 | 3 | AM |  |  |  | Personen aus dem Gefahrenbereich bringen | 2 | 2 | 1 | 3 | AM |  |  |  |  | #REF! | U1.18 Annäherung eines sich bewegenden Teils an ein feststehendes Teil | Lichtbogen | F2 Elektrische Gefährdungen
21 | Einrichten | Einstellen und Einrichten bzw. Überprüfen der funktionalen Parameter der Maschine (Geschwindigkeit, Abstand zwischen Untertommel und Antriebstrommel, Höhe gegenüber dem Boden) | U1.3 Annäherung eines sich bewegenden Teiles | Ausfall von Einrichtungen zum Anhalten von sich bewegenden Teilen | F1.5 Einziehen oder Fangen | 2 | 3 | 1 | 3 | AM | Einrichtungsbetriebsstufe (langamer) vorsehen |  |  |  | 2 | 3 | 1 | 3 | AM |  |  |  |  | #REF! | U2 Elektrische Gefährdungen | Maschinentätigkeit als Ergebnis der Wirkungslosigkeit (Umgehen oder Ausfall) von Schutzeinrichtungen | F2.1 Verbrennung
22 | Einrichten | Funktionsprüfung / Versuche | U1.10 Beweglichkeit der Maschine | menschliche Fehler/ menschliches Fehlverhalten (unbeabsichtigt und/oder vorsätzlich durch die Konstruktion hervorgerufen) | F1.5 Einziehen oder Fangen | 2 | 3 | 1 | 3 | AM |  |  |  | Auf Risiken bei Funktionsüberprüfung der laufenden Anlage hinweisen | 2 | 3 | 1 | 3 | AM |  |  |  |  | #REF! | U2.1 Lichtbogen | menschliche Fehler/ menschliches Fehlverhalten (unbeabsichtigt und/oder vorsätzlich durch die Konstruktion hervorgerufen) | F2.2 chemische Reaktionen
23 | Einrichten | Funktionsprüfung des Motors (Nothalt) | U1.12 rotierende Teile | Maschinentätigkeit als Ergebnis der Wirkungslosigkeit (Umgehen oder Ausfall) von Schutzeinrichtungen | F1 Mechanische Gefährdung | 1 | 1 | 3 | 1 | - | Nothalt redundant auslegen, Reißleine als Nothalt |  |  |  | 1 | 1 | 3 | 1 | - |  |  |  |  | #REF! | U2.2 elektromagnetische Vorgänge | raue Umgebungsbedingungen | F2.3 Auswirkungen auf medizinische Implantate
24 | Betrieb | Antreiben der Maschine | U1.10 Beweglichkeit der Maschine | unbeabsichtigter/unerwarteter Anlauf | F8.5 alle weiteren (z.B. mechanischen, elektrischen) Probleme als Folge menschlichen Fehlverhaltens | 1 | 2 | 3 | 3 | AM | Abschließbarer Hauptschalter |  |  |  | 1 | 2 | 3 | 3 | AM |  |  |  |  | #REF! | U2.3 elektrostatische Vorgänge | schmerzhafte und ermüdende Körperhaltungen | F2.4 tödlilcher Stromschlag
25 | Betrieb | Befördern der Stückgüter | U1.11 sich bewegende Teile | Kontakt mit rotierenden offenen Enden | F1.5 Einziehen oder Fangen | 5 | 3 | 1 | 3 | SIL1 |  | Abschirmung, die nicht überstiegen/überfasst werden kann |  |  | 3 | 3 | 1 | 3 | AM |  |  |  |  | #REF! | U2.4 spannungsführende Teile | sich in hoher Frequenz wiederholende Tätigkeiten | F2.5 Stürzen, weggeschleudert werden
26 | Betrieb | Beladen / Entladen des Bandförderers | U8.3 Gestaltung, Anordnung oder Erkennung | schmerzhafte und ermüdende Körperhaltungen | F8.2 Ermüdung | 5 | 3 | 1 | 2 | AM | Höhenverstellbarkeit des Bandes |  |  |  | 5 | 3 | 1 | 2 | AM |  |  |  |  | #REF! | U2.5 unzureichender Abstand zu unter Hochspannung stehenden Teilen | übermäßige Anstrengung | F2.6 Feuer
27 | Betrieb | Geringfügige Einstellungs- und Einrichtungsvorgänge bei den Funktionsparamteren der Maschine | U1.10 Beweglichkeit der Maschine | ungesteuerte Bewegungen (einschließlich Geschwindigkeitsänderung) | F1.5 Einziehen oder Fangen | 3 | 3 | 1 | 3 | AM | Einrichtungsbetriebsstufe (langamer) vorsehen |  |  |  | 3 | 3 | 1 | 3 | AM |  |  |  |  | #REF! | U2.6 Überlast | unbeabsichtigter/unerwarteter Anlauf | F2.7 Herausschleudern von geschmolzenen Teilen
28 | Betrieb | Überwachen (Regelmäßiges Nachziehen der Betonanker, Schmierung) | U1 Mechanische Gefährdung | direkter Kontakt | F1.3 Quetschen | 3 | 1 | 1 | 1 | - |  |  |  | Auf Quetschgefahr hinweisen | 3 | 1 | 1 | 1 | - |  |  |  |  | #REF! | U2.7 Teile, die im Fehlerzustand spannungsführend geworden sind | ungesteuerte Bewegungen | F2.8 (elektrischer) Schlag
29 | Betrieb | Geringfügige Eingriffe während des Betriebs (z.B. Beseitigung von Blockierungen, lokale Reinigung) | U1.10 Beweglichkeit der Maschine | Zugang zu/Kontakt mit beweglichen Teilen | F1.5 Einziehen oder Fangen | 3 | 2 | 1 | 3 | AM | Öffnen der Schutzeinrichtung nur bei stehender Maschine |  |  |  | 3 | 2 | 1 | 3 | AM |  |  |  |  | #REF! | U2.8 Kurzschluss | ungesteuerte Bewegungen (einschließlich Geschwindigkeitsänderung) | ./.
30 | Betrieb | Neustarten der Maschine nach Stillsetzen / Unterbrechung | U1.11 sich bewegende Teile | ungesteuerte Bewegungen (einschließlich Geschwindigkeitsänderung) | F1.5 Einziehen oder Fangen | 3 | 2 | 1 | 3 | AM | immer zuerst mit langsamem Betriebsmodus beginnen und dann auf Arbeitsgeschwindigkeit |  |  |  | 3 | 2 | 1 | 3 | AM |  |  |  |  | #REF! | U2.9 Wärmestrahlung | Verlust der direkten Sichtbarkeit des Arbeitsbereiches | F3 Thermische Gefährdungen
31 | Reinigung | Demontage / Ausbau von Teilen, Bauteilen, Einrichtungen der Maschine | U1.13 raue, rutschige Oberfläche | Herabfallen oder Ausstoß von Objekten | F1.3 Quetschen | 3 | 2 | 1 | 2 | - | Demontierbarkeit ohne Gewalt/unkontrollierte Kraftanwendung ermöglichen, z.B. durch Nutmuttern |  |  |  | 1 | 2 | 1 | 2 | - |  |  |  |  | #REF! | U3 Thermische Gefährdungen | Verlust der Standfestigkeit/-sicherheit | F3.1 Verbrennung
32 | Reinigung | Energietrennung | U2.4 spannungsführende Teile | Kurzschluss | F2.3 Auswirkungen auf medizinische Implantate | 2 | 2 | 1 | 4 | SIL2 |  |  | Energietrennung nur durch elektrotechnisches Fachpersonal zulassen |  | 2 | 1 | 1 | 4 | SIL2 | Vor elektrischer Gefährdung warnen |  |  |  | #REF! | U3.1 Explosiion | Verschieben sich bewegender Teile | F3.2 Dehydrierung
33 | Reinigung | Schmieren | U7.8 Flüssigkeiten | Emission eines Stoffes, der gefährdend sein kann | F7.2 Krebs | 2 | 2 | 3 | 3 | AM |  | Handschuhe mitliefern |  |  | 2 | 1 | 3 | 3 | AM |  |  |  |  | #REF! | U3.2 Flamme | weitere Gefährdungsereignisse durch Ausfälle oder unzureichende Konstruktion der Steuerung | F3.3 Unbehagen
34 | Instandhaltung / Wartung | Nachstellen funktionaler Parameter der Maschine (Geschwindigkeit, Abstand zwischen Untertommel und Antriebstrommel, Höhe gegenüber dem Boden) | U1.10 Beweglichkeit der Maschine | Maschinentätigkeit als Ergebnis der Wirkungslosigkeit (Umgehen oder Ausfall) von Schutzeinrichtungen | F1.5 Einziehen oder Fangen | 2 | 2 | 1 | 3 | AM | Abschließbarer Hauptschalter |  |  |  | 2 | 2 | 1 | 3 | AM |  |  |  |  | #REF! | U3.3 Objekte oder Materialien hoher oder niedriger Temperatur | Zugang zu/Kontakt mit beweglichen Teilen | F3.4 Erfrierung
35 | Instandhaltung / Wartung | Austausch von Verschleißteilen | U8.1 Zugang | Kontakt mit scharfen Kanten und Ecken, vorstehenden Teilen | F1.4 Schneiden oder Abschneiden | 2 | 3 | 3 | 2 | AM | Verschleißteile so gestalten, dass sich bei Verschleiß keine scharfen Kanten bilden |  |  |  | 2 | 1 | 3 | 2 | - |  |  |  |  | #REF! | U3.4 Strahlung von Wärmequellen |  | F3.5 Verletzungen durch Strahlung von Wärmequellen
36 | Instandhaltung / Wartung | Demontage / Ausbau von Teilen, Bauteilen, Einrichtungen der Maschine | U1.11 sich bewegende Teile | direkter Kontakt | F1.3 Quetschen | 2 | 3 | 3 | 2 | AM |  |  |  |  | 2 | 3 | 3 | 2 | AM | Vor Quetschgefahr warnen |  |  |  | #REF! | ./. |  | F3.6 Verbrühung
37 | Instandhaltung / Wartung | Energietrennung | U2.4 spannungsführende Teile | Kurzschluss | F2.3 Auswirkungen auf medizinische Implantate | 2 | 2 | 1 | 4 | SIL2 |  |  | Energietrennung nur durch elektrotechnisches Fachpersonal zulassen |  | 2 | 2 | 1 | 4 | SIL2 | Vor elektrischer Gefährdung warnen |  |  |  | #REF! | ./. |  | F4 Gefährdung durch Lärm
38 | Instandhaltung / Wartung | Überprüfen / Erneuern von Hilfsflüssigkeiten (Schmierstoff) | U7.8 Flüssigkeiten | Emission eines Stoffes, der gefährdend sein kann | F7.2 Krebs | 2 | 2 | 1 | 3 | AM |  | Handschuhe mitliefern |  |  | 2 | 1 | 1 | 3 | - |  |  |  |  | #REF! | U4 Gefährdung durch Lärm |  | F4.1 Unbehagen
39 | Instandhaltung / Wartung | Überprüfen von Teilen und Bauteilen der Maschine | U1.10 Beweglichkeit der Maschine | Ausfall von Einrichtungen zum Anhalten von sich bewegenden Teilen | F1.5 Einziehen oder Fangen | 3 | 3 | 3 | 3 | SIL1 | Abschließbarer Hauptschalter |  |  |  | 3 | 3 | 1 | 3 | AM |  |  |  |  | #REF! | U4.1 Kavitationsvorgänge |  | F4.2 Bewusstseinsverlust
40 | Fehlerfall | Demontage / Ausbau von Teilen, Bauteilen, Einrichtungen der Maschine | U1.13 raue, rutschige Oberfläche | Herabfallen oder Ausstoß von Objekten | F1.3 Quetschen | 1 | 2 | 1 | 2 | - |  |  | Detaillierte Demontageanweisung |  | 1 | 2 | 1 | 2 | - |  |  |  |  | #REF! | U4.2 Abluftsystem |  | F4.3 Gleichgewichtsstörung
41 | Fehlerfall | Fehlersuche | U1.10 Beweglichkeit der Maschine | unbeabsichtigter/unerwarteter Anlauf | F1.5 Einziehen oder Fangen | 2 | 2 | 3 | 3 | AM | Abschließbarer Hauptschalter |  |  |  | 2 | 2 | 1 | 3 | AM |  |  |  |  | #REF! | U4.3 mit hoher Geschwindigkeit austretendes Gas |  | F4.4 bleibender Gehörverlust
42 | Fehlerfall | Energietrennung | U2.4 spannungsführende Teile | Kurzschluss | F2.3 Auswirkungen auf medizinische Implantate | 2 | 2 | 1 | 4 | SIL2 |  |  | Energietrennung nur durch elektrotechnisches Fachpersonal zulassen |  | 2 | 1 | 1 | 4 | SIL2 | Vor elektrischer Gefährdung warnen |  |  |  | #REF! | U4.4 Herstellungsprozess (Stanzen, Schneiden usw.) |  | F4.5 Stress
43 | Fehlerfall | Wiederanlauf nach Ausfall der Steuerungseinrichtungen und Schutzeinrichtungen | U1.17 Beschleunigung/Abbremsung | ungesteuerte Bewegungen (einschließlich Geschwindigkeitsänderung) | F1.5 Einziehen oder Fangen | 2 | 2 | 1 | 3 | AM |  | Anlaufsicherung vor der Bestätigung des Anbringens von Schutzeinrichtungen anbringen |  |  | 2 | 2 | 1 | 3 | AM |  |  |  |  | #REF! | U4.5 bewegliche Teile |  | F4.6 Tinnitus (Ohrensausen)
44 | Fehlerfall | Wiederanlauf nach Blockierung | U1.12 rotierende Teile | ungesteuerte Bewegungen (einschließlich Geschwindigkeitsänderung) | F1.5 Einziehen oder Fangen | 3 | 2 | 1 | 3 | AM |  | Anlaufsicherung vor der Bestätigung des Anbringens von Schutzeinrichtungen anbringen |  |  | 3 | 2 | 1 | 3 | AM |  |  |  |  | #REF! | U4.6 reibende Flächen |  | F4.7 Ermüdung
45 | Fehlerfall | Reparaturen | U8.1 Zugang | Kontakt mit scharfen Kanten und Ecken, vorstehenden Teilen | F1.4 Schneiden oder Abschneiden | 2 | 3 | 1 | 2 | - | Zugänglichkeit zu kritischen Teilen gewährleisten, ohne dass Verletzungsgefahr auftritt |  |  |  | 2 | 3 | 1 | 2 | - |  |  |  |  | #REF! | U4.7 mit Unwucht rotierende Teile |  | F4.8 alle weiteren (z.B. mechanischen, elektrischen) Probleme als Folge einer Störung der Sprachkommunikation oder einer Störung akustischer Signale
46 | Fehlerfall | Ersatz von Teilen, Bauteilen und Einrichtungen der Maschine | U1.13 raue, rutschige Oberfläche | Herabfallen oder Ausstoß von Objekten | F1.3 Quetschen | 2 | 3 | 3 | 1 | - |  |  |  |  | 2 | 1 | 3 | 1 | - | Warnung vor Quetschgefahr |  |  |  | #REF! | U4.8 pfeifende Pneumatik-Einrichtungen |  | ./.
47 | Fehlerfall | Erneutes Einrichten | U1.3 Annäherung eines sich bewegenden Teiles | Ausfall von Einrichtungen zum Anhalten von sich bewegenden Teilen | F1.5 Einziehen oder Fangen | 2 | 2 | 1 | 3 | AM | Einrichtungsbetriebsstufe (langamer) vorsehen |  |  |  | 2 | 1 | 1 | 3 | - |  |  |  |  | #REF! | U4.9 verschlissene Teile |  | F5 Gefährdung durch Schwingungen
48 | Fehlerfall | Überprüfen von Teilen und Bauteilen der Maschine | U1.3 Annäherung eines sich bewegenden Teiles | Ausfall von Einrichtungen zum Anhalten von sich bewegenden Teilen | F1.5 Einziehen oder Fangen | 2 | 2 | 1 | 3 | AM | Einrichtungsbetriebsstufe (langamer) vorsehen |  |  |  | 2 | 1 | 1 | 3 | - |  |  |  |  | #REF! | U5 Gefährdung durch Schwingungen |  | F5.1 Unbehagen
49 | Außbetriebnahme / Demontage | Abtrennen von der Energieversorgung | U2.4 spannungsführende Teile | Kurzschluss | F2.3 Auswirkungen auf medizinische Implantate | 1 | 2 | 1 | 4 | SIL2 |  |  | Energietrennung nur durch elektrotechnisches Fachpersonal zulassen |  | 1 | 1 | 1 | 4 | SIL2 | Vor elektrischer Gefährdung warnen |  |  |  | #REF! | U5.1 Kavitationsvorgänge |  | F5.2 Erkrankungen der unteren Wirbelsäule
50 | Außbetriebnahme / Demontage | Demontage nach der Demontageanleitung | U1.11 sich bewegende Teile | Herabfallen oder Ausstoß von Objekten | F1.3 Quetschen | 2 | 3 | 3 | 2 | AM |  |  | Detaillierte Demontageanweisung |  | 2 | 1 | 3 | 2 | - |  |  |  |  | #REF! | U5.2 Fehlausrichtung sich bewegender Teile |  | F5.3 neurologische Erkrankung
51 | Außbetriebnahme / Demontage | Verpacken der Bauteile / Baugruppe | U1.15 Standfestigkeit/-sicherheit | Zugang zu/Kontakt mit beweglichen Teilen | F1.3 Quetschen | 2 | 2 | 3 | 2 | - |  |  |  |  | 2 | 2 | 3 | 2 | - |  |  |  |  | #REF! | U5.3 bewegliche Ausrüstung |  | F5.4 Knochengelenkschaden
52 | Außbetriebnahme / Demontage | Tranportieren | U8 Gefährdung durch unergonomische Gestaltung | übermäßige Anstrengung | F8.3 Störungen des Bewegungsapparates | 2 | 2 | 1 | 2 | - |  | Kräne und Gabelstapler zum Transport schwerer Teile verwenden |  |  | 2 | 1 | 1 | 2 | - |  |  |  |  | #REF! | U5.4 reibende Flächen |  | F5.5 Wirbelsäulenverletzung
53 | Außbetriebnahme / Demontage | Entladen beim Kunde | U1.8 Höhe gegenüber dem Boden | Herabfallen oder Ausstoß von Objekten | F1.3 Quetschen | 1 | 3 | 1 | 3 | AM |  |  | Pakete mit dem Gewicht des Inhalts kennzeichnen |  | 1 | 3 | 1 | 3 | AM |  |  |  |  | #REF! | U5.5 mit Unwucht rotierende Teile |  | F5.6 Gefäßerkrankungen
54 | Außbetriebnahme / Demontage | Entsorgung | U1.13 raue, rutschige Oberfläche | direkter Kontakt | F1.7 Reiben oder Abschürfen | 2 | 3 | 1 | 2 | - |  |  | Enstorgung nur durch ein Untersorgungsunternehmen |  | 2 | 1 | 1 | 2 | - |  |  |  |  | #REF! | U5.6 schwingende Ausrüstung |  | ./.
 |  |  |  |  |  |  |  |  |  |  |  |  |  |  |  |  |  |  |  |  |  |  |  | #REF! | U5.7 verschlissene Teile |  | F6 Gefährdung durch Strahlung
 |  |  |  |  |  |  |  |  |  |  |  |  |  |  |  |  |  |  |  |  |  |  |  | #REF! | U6 Gefährdung durch Strahlung |  | F6.1 Verbrennung
 |  |  |  |  |  |  |  |  |  |  |  |  |  |  |  |  |  |  |  |  |  |  |  | #REF! | U6.1 ionisierende Strahlungsquelle |  | F6.2 Augen- und Hautschädigung
 |  |  |  |  |  |  |  |  |  |  |  |  |  |  |  |  |  |  |  |  |  |  |  | #REF! | U6.2 niederfrequente elektromagnetische Strahlung |  | F6.3 Auswirkungen auf die Fortpflanzungsfähigkeit
 |  |  |  |  |  |  |  |  |  |  |  |  |  |  |  |  |  |  |  |  |  |  |  | #REF! | U6.3 optische Strahlung (infrarot, sichtbar und ultraviolett) einschließlich Laserstrahlen |  | F6.4 genetische Veränderung
 |  |  |  |  |  |  |  |  |  |  |  |  |  |  |  |  |  |  |  |  |  |  |  | #REF! | U6.4 hochfrequente elektromagnetische Strahlung |  | F6.5 Kopfschmerzen, Schlaflosigkeit usw.
 |  |  |  |  |  |  |  |  |  |  |  |  |  |  |  |  |  |  |  |  |  |  |  | #REF! | ./. |  | F7 Gefährdungen durch Materialien und Stoffe
 |  |  |  |  |  |  |  |  |  |  |  |  |  |  |  |  |  |  |  |  |  |  |  | #REF! | U7 Gefährdungen durch Materialien und Stoffe |  | F7.1 Atembeschwerden, Ersticken
 |  |  |  |  |  |  |  |  |  |  |  |  |  |  |  |  |  |  |  |  |  |  |  | #REF! | U7.1 Aerosole |  | F7.2 Krebs
 |  |  |  |  |  |  |  |  |  |  |  |  |  |  |  |  |  |  |  |  |  |  |  | #REF! | U7.2 biologische und mikrobiologische (Viren, Bakterien, Pilze) |  | F7.3 Korrosion
 |  |  |  |  |  |  |  |  |  |  |  |  |  |  |  |  |  |  |  |  |  |  |  | #REF! | U7.3 Brennstoffe |  | F7.4 Auswirkungen auf die Fortpflanzungsfähigkeit
 |  |  |  |  |  |  |  |  |  |  |  |  |  |  |  |  |  |  |  |  |  |  |  | #REF! | U7.4 Stäube |  | F7.5 Explosion
 |  |  |  |  |  |  |  |  |  |  |  |  |  |  |  |  |  |  |  |  |  |  |  | #REF! | U7.5 Explosivstoffe |  | F7.6 Feuer
 |  |  |  |  |  |  |  |  |  |  |  |  |  |  |  |  |  |  |  |  |  |  |  | #REF! | U7.6 Fasern |  | F7.7 Infektion
 |  |  |  |  |  |  |  |  |  |  |  |  |  |  |  |  |  |  |  |  |  |  |  | #REF! | U7.7 feuergefährliches Material |  | F7.8 Veränderungen des Erbguts
 |  |  |  |  |  |  |  |  |  |  |  |  |  |  |  |  |  |  |  |  |  |  |  | #REF! | U7.8 Flüssigkeiten |  | F7.9 Vergiftung
 |  |  |  |  |  |  |  |  |  |  |  |  |  |  |  |  |  |  |  |  |  |  |  | #REF! | U7.9 Dämpfe |  | F7.10 Sensibilisierung
 |  |  |  |  |  |  |  |  |  |  |  |  |  |  |  |  |  |  |  |  |  |  |  | #REF! | U7.10 Gase |  | ./.
 |  |  |  |  |  |  |  |  |  |  |  |  |  |  |  |  |  |  |  |  |  |  |  | #REF! | U7.11 Nebel |  | ./.
 |  |  |  |  |  |  |  |  |  |  |  |  |  |  |  |  |  |  |  |  |  |  |  | #REF! | U7.12 Oxidationsmittel |  | F8 Gefährdung durch unergonomische Gestaltung
 |  |  |  |  |  |  |  |  |  |  |  |  |  |  |  |  |  |  |  |  |  |  |  | #REF! | U8 Gefährdung durch unergonomische Gestaltung |  | F8.1 Unbehagen
 |  |  |  |  |  |  |  |  |  |  |  |  |  |  |  |  |  |  |  |  |  |  |  | #REF! | U8.1 Zugang |  | F8.2 Ermüdung
 |  |  |  |  |  |  |  |  |  |  |  |  |  |  |  |  |  |  |  |  |  |  |  | #REF! | U8.2 Gestaltung oder Anordnung von Anzeigen |  | F8.3 Störungen des Bewegungsapparates
 |  |  |  |  |  |  |  |  |  |  |  |  |  |  |  |  |  |  |  |  |  |  |  | #REF! | U8.3 Gestaltung, Anordnung oder Erkennung |  | F8.4 Stress
 |  |  |  |  |  |  |  |  |  |  |  |  |  |  |  |  |  |  |  |  |  |  |  | #REF! | U8.4 Anstrengung |  | F8.5 alle weiteren (z.B. mechanischen, elektrischen) Probleme als Folge menschlichen Fehlverhaltens
 |  |  |  |  |  |  |  |  |  |  |  |  |  |  |  |  |  |  |  |  |  |  |  | #REF! | U8.5 Flackern, Blenden, Schattenbildung und stroboskopische Effekte |  | ./.
 |  |  |  |  |  |  |  |  |  |  |  |  |  |  |  |  |  |  |  |  |  |  |  | #REF! | U8.6 örtliche Beleuchtung |  | ./.
 |  |  |  |  |  |  |  |  |  |  |  |  |  |  |  |  |  |  |  |  |  |  |  | #REF! | U8.7 psychische Überbelastung/Unterforderung |  | ./.
 |  |  |  |  |  |  |  |  |  |  |  |  |  |  |  |  |  |  |  |  |  |  |  | #REF! | U8.8 Körperhaltung |  | ./.
 |  |  |  |  |  |  |  |  |  |  |  |  |  |  |  |  |  |  |  |  |  |  |  | #REF! | U8.9 sich wiederholende Tätigkeiten |  | ./.
 |  |  |  |  |  |  |  |  |  |  |  |  |  |  |  |  |  |  |  |  |  |  |  | #REF! | U8.10 Sichtbarkeit |  | F9 Gefährdungen im Zusammenhang mit der Einsatzumgebung der Maschine
 |  |  |  |  |  |  |  |  |  |  |  |  |  |  |  |  |  |  |  |  |  |  |  | #REF! | U9 Gefährdungen im Zusammenhang mit der Einsatzumgebung der Maschine |  | F9.1 Verbrennungen
 |  |  |  |  |  |  |  |  |  |  |  |  |  |  |  |  |  |  |  |  |  |  |  | #REF! | U9.1 Staub und Nebel |  | F9.2 leichte Erkrankungen
 |  |  |  |  |  |  |  |  |  |  |  |  |  |  |  |  |  |  |  |  |  |  |  | #REF! | U9.2 elektromagnetische Störungen |  | F9.3 Ausrutschen, Stürzen
 |  |  |  |  |  |  |  |  |  |  |  |  |  |  |  |  |  |  |  |  |  |  |  | #REF! | U9.3 Blitzschlag |  | F9.4 Ersticken
 |  |  |  |  |  |  |  |  |  |  |  |  |  |  |  |  |  |  |  |  |  |  |  | #REF! | U9.4 Feuchtigkeit |  | F9.5 alle weiteren Probleme, die als Folge der Auswirkungen der Gefährdungsquellen an der Maschine oder an Teilen der Maschine auftreten
 |  |  |  |  |  |  |  |  |  |  |  |  |  |  |  |  |  |  |  |  |  |  |  | #REF! | U9.5 Verunreinigungen |  | ./.
 |  |  |  |  |  |  |  |  |  |  |  |  |  |  |  |  |  |  |  |  |  |  |  | #REF! | U9.6 Schnee |  | ./.
 |  |  |  |  |  |  |  |  |  |  |  |  |  |  |  |  |  |  |  |  |  |  |  | #REF! | U9.7 Temperatur |  | ./.
 |  |  |  |  |  |  |  |  |  |  |  |  |  |  |  |  |  |  |  |  |  |  |  | #REF! | U9.8 Wasser |  | ./.
 |  |  |  |  |  |  |  |  |  |  |  |  |  |  |  |  |  |  |  |  |  |  |  | #REF! | U9.9 Wind |  | ./.
 |  |  |  |  |  |  |  |  |  |  |  |  |  |  |  |  |  |  |  |  |  |  |  | #REF! | U9.10 Sauerstoffmangel |  | F10 Kombination von Gefährdungen
 |  |  |  |  |  |  |  |  |  |  |  |  |  |  |  |  |  |  |  |  |  |  |  | #REF! | U10 Kombination von Gefährdungen |  | F10.1 z.B. Dehydrierung, Bewusstseinsverlust, Hitzeschock
 |  |  |  |  |  |  |  |  |  |  |  |  |  |  |  |  |  |  |  |  |  |  |  | #REF! | U10.1 z.B. sich wiederholende Tätigkeit + Anstrengung + hohe Umgebungstemperatur
 |  |  |  |  |  |  |  |  |  |  |  |  |  |  |  |  |  |  |  |  |  |  |  | #REF!
 |  |  |  |  |  |  |  |  |  |  |  |  |  |  |  |  |  |  |  |  |  |  |  | #REF!
 |  |  |  |  |  |  |  |  |  |  |  |  |  |  |  |  |  |  |  |  |  |  |  | #REF!
 |  |  |  |  |  |  |  |  |  |  |  |  |  |  |  |  |  |  |  |  |  |  |  | #REF!
 |  |  |  |  |  |  |  |  |  |  |  |  |  |  |  |  |  |  |  |  |  |  |  | #REF!
 |  |  |  |  |  |  |  |  |  |  |  |  |  |  |  |  |  |  |  |  |  |  |  | #REF!
 |  |  |  |  |  |  |  |  |  |  |  |  |  |  |  |  |  |  |  |  |  |  |  | #REF!
 |  |  |  |  |  |  |  |  |  |  |  |  |  |  |  |  |  |  |  |  |  |  |  | #REF!
 |  |  |  |  |  |  |  |  |  |  |  |  |  |  |  |  |  |  |  |  |  |  |  | #REF!
 |  |  |  |  |  |  |  |  |  |  |  |  |  |  |  |  |  |  |  |  |  |  |  | #REF!
 |  |  |  |  |  |  |  |  |  |  |  |  |  |  |  |  |  |  |  |  |  |  |  | #REF!
 |  |  |  |  |  |  |  |  |  |  |  |  |  |  |  |  |  |  |  |  |  |  |  | #REF!
 |  |  |  |  |  |  |  |  |  |  |  |  |  |  |  |  |  |  |  |  |  |  |  | #REF!
 |  |  |  |  |  |  |  |  |  |  |  |  |  |  |  |  |  |  |  |  |  |  |  | #REF!
 |  |  |  |  |  |  |  |  |  |  |  |  |  |  |  |  |  |  |  |  |  |  |  | #REF!
 |  |  |  |  |  |  |  |  |  |  |  |  |  |  |  |  |  |  |  |  |  |  |  | #REF!
 |  |  |  |  |  |  |  |  |  |  |  |  |  |  |  |  |  |  |  |  |  |  |  | #REF!
 |  |  |  |  |  |  |  |  |  |  |  |  |  |  |  |  |  |  |  |  |  |  |  | #REF!
 |  |  |  |  |  |  |  |  |  |  |  |  |  |  |  |  |  |  |  |  |  |  |  | #REF!
 |  |  |  |  |  |  |  |  |  |  |  |  |  |  |  |  |  |  |  |  |  |  |  | #REF!
 |  |  |  |  |  |  |  |  |  |  |  |  |  |  |  |  |  |  |  |  |  |  |  | #REF!
 |  |  |  |  |  |  |  |  |  |  |  |  |  |  |  |  |  |  |  |  |  |  |  | #REF!
 |  |  |  |  |  |  |  |  |  |  |  |  |  |  |  |  |  |  |  |  |  |  |  | #REF!
 |  |  |  |  |  |  |  |  |  |  |  |  |  |  |  |  |  |  |  |  |  |  |  | #REF!
 |  |  |  |  |  |  |  |  |  |  |  |  |  |  |  |  |  |  |  |  |  |  |  | #REF!
 |  |  |  |  |  |  |  |  |  |  |  |  |  |  |  |  |  |  |  |  |  |  |  | #REF!
 |  |  |  |  |  |  |  |  |  |  |  |  |  |  |  |  |  |  |  |  |  |  |  | #REF!
 |  |  |  |  |  |  |  |  |  |  |  |  |  |  |  |  |  |  |  |  |  |  |  | #REF!
 |  |  |  |  |  |  |  |  |  |  |  |  |  |  |  |  |  |  |  |  |  |  |  | #REF!
 |  |  |  |  |  |  |  |  |  |  |  |  |  |  |  |  |  |  |  |  |  |  |  | #REF!
 |  |  |  |  |  |  |  |  |  |  |  |  |  |  |  |  |  |  |  |  |  |  |  | #REF!
 |  |  |  |  |  |  |  |  |  |  |  |  |  |  |  |  |  |  |  |  |  |  |  | #REF!
 |  |  |  |  |  |  |  |  |  |  |  |  |  |  |  |  |  |  |  |  |  |  |  | #REF!
 |  |  |  |  |  |  |  |  |  |  |  |  |  |  |  |  |  |  |  |  |  |  |  | #REF!
 |  |  |  |  |  |  |  |  |  |  |  |  |  |  |  |  |  |  |  |  |  |  |  | #REF!
 |  |  |  |  |  |  |  |  |  |  |  |  |  |  |  |  |  |  |  |  |  |  |  | #REF!
 |  |  |  |  |  |  |  |  |  |  |  |  |  |  |  |  |  |  |  |  |  |  |  | #REF!
 |  |  |  |  |  |  |  |  |  |  |  |  |  |  |  |  |  |  |  |  |  |  |  | #REF!
 |  |  |  |  |  |  |  |  |  |  |  |  |  |  |  |  |  |  |  |  |  |  |  | #REF!
 |  |  |  |  |  |  |  |  |  |  |  |  |  |  |  |  |  |  |  |  |  |  |  | #REF!
 |  |  |  |  |  |  |  |  |  |  |  |  |  |  |  |  |  |  |  |  |  |  |  | #REF!
 |  |  |  |  |  |  |  |  |  |  |  |  |  |  |  |  |  |  |  |  |  |  |  | #REF!

Sheet: SIL
Anhang: Ermittlung des SIL (Safety Integrity Level/Sicherheits-Integritätslevel) nach EN 62061:2005 |  |  |  |  |  |  |  | Ergänzende Information |  |  |  | Automatische Ausgabe des Ergebnisses |  |  |  | Liste für Drop-Down-Menü Spalte D "Risikoeinschätzung und Bewertung"
Schwere der Verletzungen |  |  | Klasse K (F+W+P) |  |  |  |  | SIL1) | StK2) | pl3) | Wahrscheinlichkeit eines gefahrbringenden Ausfalls pro Stunde | Schwere | Klasse | Kombination | Ergebnise | X | Gefährdung für neuentwickeltes Produkt relevant
 |  |  |  |  |  |  |  | AM | B | a | ≥ 10-5 bis < 10-4 | 1 | 1 | 11 | - | - | Gefährdung für neuentwickeltes Produkt nicht relevant
 |  |  | 3-4 | 5-7 | 8-10 | 11-13 | 14-15 | 1* | 1 | b | ≥ 3 x 10-6 bis < 10-5 * | 1 | 2 | 12 | -
 | 1 Person betroffen | 2 oder mehr Personen betroffen |  |  |  |  |  |  | 2 | c | ≥ 10-6 bis < 3 x 10-6 | 1 | 3 | 13 | -
5 | - | Irreversibel: Tod, Verlust eines Auges oder Arms | SIL 2 | SIL 3 | SIL 3 | SIL 3 | SIL 3 | 2 | 3 | d | ≥ 10-7 bis < 10-6 | 1 | 4 | 14 | AM
4 | Irreversibel: Tod, Verlust eines Auges oder Arms | Irreversibel: gebrochene Gliedmaßen, Verluste (eines) mehrerer Finger(s) | SIL 2 | SIL 2 | SIL 2 | SIL 3 | SIL 3 | 3 | 4 | e | ≥ 10-8 bis < 10-7 | 1 | 5 | 15 | SIL1
3 | Irreversibel: gebrochene Gliedmaßen, Verluste (eines) mehrerer Finger(s) | Reversibel: Behandlung durch einen Mediziner erforderlich |  | AM | SIL 1 | SIL 2 | SIL 3 |  |  |  |  | 2 | 1 | 21 | -
2 | Reversibel: Behandlung durch einen Mediziner erforderlich | Reversibel: erste Hilfe erforderlich |  |  | AM | SIL 1 | SIL 2 | Die Übereinstimmung zwischen SIL und StK ist nicht genormt, sondern auf Basis der Neufassung von EN ISO 13849-1 angenommen. EN 62061 und EN ISO 13849-1 verfolgen einen mathematischen Ansatz, der auf der Ausfallwahrscheinlichkeit beruht. Dieser Ansatz fehlt in EN 954-1. Diese basiert auf dem Prinzip der „zuverlässigen Bauteile und Architekturen“. Zuverlässige Bauteile und Architekturen sind beschrieben in EN ISO 13849-2. |  |  |  | 2 | 2 | 22 | -
1 | Reversibel: erste Hilfe erforderlich | - |  |  |  | AM | SIL 1 |  |  |  |  | 2 | 3 | 23 | AM
AM |  |  |  |  |  |  |  |  |  |  |  | 2 | 4 | 24 | SIL1
 |  | Häufigkeit und Dauer der Exposition (F), bezogen auf die Lebensdauer der Maschine |  |  |  |  |  |  |  |  |  | 2 | 5 | 25 | SIL2
Wahrscheinlichkeit des Auftretens (W) |  | Dauer/Häufigkeit | > 1x pro h | 1-5x pro Tag | 1-2x pro Woche | 1-10x pro Jahr | << 1x pro Jahr |  |  |  |  | 3 | 1 | 31 | -
5 | sehr hoch | < 10 min | 5 | 4 | 3 | 2 | 1 | *SIL 1 umfasst die Wahrscheinlichkeit zwischen ≥ 10-6 bis < 10-5 |  |  |  | 3 | 2 | 32 | AM
4 | wahrscheinlich | > 10 min | 5 | 5 | 4 | 3 | 2 |  |  |  |  | 3 | 3 | 33 | SIL1
3 | möglich |  |  |  |  |  |  | 1) SIL = Sicherheitsintegritäts-Level nach EN 62061 |  |  |  | 3 | 4 | 34 | SIL2
2 | selten | Es wird nicht betrachtet wie häufig ein Fehler auftreten kann, sondern wie häufig ein Fehler tatsächlich auftritt. Referenz: EN 62061: 2005 A.2.4.1 Die Dauer steht in Bezug zur Verrichtung von Tätigkeiten, die unter dem Schutz der Safety-Related-Control-Functions (SRCF- Sicherheits- Steuerungsfunktion) ausgeführt werden. Die Dauer UND die Häufigkeit bezieht sich somit auf die gesamte Lebensdauer der Maschine und nicht nur auf die Zeitspanne während des Auftretens eines Fehlers. *Die Werte gelten für eine Aufenthaltsdauer in der Gefährdungssituation von 10 Minuten oder länger. Ist die Dauer < 10 Minuten, kann der Wert auf die nächste Stufe herabgestuft werden. Dies trifft nicht zu, wenn die Häufigkeit der Exposition ≤ 1 h ist. Nach DIN EN ISO 12100:2010 Kapitel 3. Bild 1 S.24 ist keine erneute Einschätzung erforderlich, wenn das Risiko hinreichend vermindert wurde. |  |  |  |  |  | 2) StK = Steuerungskategorie nach EN 954-1 |  |  |  | 3 | 5 | 35 | SIL3
1 | vernachlässigbar |  |  |  |  |  |  | 3) pl = Performance Level nach EN ISO 13849-1 |  |  |  | 4 | 1 | 41 | SIL2
 |  |  |  |  |  |  |  |  |  |  |  | 4 | 2 | 42 | SIL2
Möglichkeit der Vermeidung oder Begrenzung des Schadens (P) |  |  |  |  |  |  |  |  |  |  |  | 4 | 3 | 43 | SIL2
5 | unmöglich |  |  |  |  |  |  |  |  |  |  | 4 | 4 | 44 | SIL3
3 | selten |  |  |  |  |  |  |  |  |  |  | 4 | 5 | 45 | SIL3
1 | wahrscheinlich |  |  |  |  |  |  |  |  |  |  | 5 | 1 | 51 | SIL2
 |  |  |  |  |  |  |  |  |  |  |  | 5 | 2 | 52 | SIL3
Ausführung des SIL in Anlehnung an EN 62061:2005 |  |  |  |  |  |  |  |  |  |  |  | 5 | 3 | 53 | SIL3
 | Steuerungstechnik | Mechanik / Pneumatik / Hydraulik | Durchführung der Tätigkeiten durch bestimmtes Personal |  |  |  |  |  |  |  |  | 5 | 4 | 54 | SIL3
AM | Bauteile müssen den erwarteten Betriebsbeanspruchungen (z.B. Verschmutzung, Schaltleistung, mechanische Schwingungen, o.ä.) für die zu erwartende Lebensdauer der Maschine standhalten. Ein Fehler darf zum Verlust der Sicherheitsfunktion führen. | Bauteile müssen den erwarteten Betriebsbeanspruchungen (z.B. Verschmutzung, Kräfte, Abrieb, mechanische Schwingungen, o.ä.) für die zu erwartende Lebensdauer der Maschine standhalten (z.B. keine Unterdimensionierung, Betriebsfestigkeit). Ein Fehler darf zum Verlust der Sicherheitsfunktion führen. |  |  |  |  |  |  |  |  |  | 5 | 5 | 55 | SIL3
SIL 1 | Wie AM, zusätzlich werden bewährte Bauteile (z.B. nach EN 60947-5-1:2005) und bewährte Sicherheitsprinzipien eingesetzt (vgl. Definition unter DIN ISO 13849-1:2006 6.2.4 a) und b) ). Das Auftreten eines Fehlers zwischen der Testung darf zum Verlust der Sicherheitsfunktion führen. Fehlererkennung durch Prüfung auf Funktion in geeigneten Zeitabständen (z.B. Testung bei Power-ON). | Wie AM, zusätzlich: Es werden dauerfeste Bauteile, die sich in ähnlichem Einsatz bewährt haben (z.B. renommierte Hersteller, Qualität) und bewährte Sicherheitsprinzipien (z.B. Überdimensionierung, Formschluss) eingesetzt (vgl. Definition unter DIN ISO 13849-1:2006 6.2.4 a) und b) ). Das Auftreten eines Fehlers zwischen der Testung darf zum Verlust der Sicherheitsfunktion führen. Fehlererkennung durch Prüfung auf Funktion in geeigneten Zeitabständen (z.B. bei Power-On oder in regelmäßigen Zeitabständen (min 1x / Monat), Testung der Haltebremse, der Auslösemechanismen, der Schaltstange, der Zylinderendanschläge, Verschleißüberwachung). | Diese Tätigkeit muss durch geschultes Personal durchgeführt werden. Geschultes Personal kennt die Vorgehensweise dieses Arbeitsschrittes und die daraus entstehenden Gefahren. Definition geschultes Personal: Diese Personen müssen beim Hersteller eine maschinenspezifische Inbetriebnahmeeinweisung erfolgreich absolviert haben. |  |  |  |  | Bemerkung: Nach EN 62061 gibt es keine Unterteilung bei SIL 1 in einen niederen SIL1 bei reversiblen Verletzungen und einen hohen SIL1 bei nicht reversiblen Verletzungen. EN 954-1 und EN13849 kennen diesen Unterschied über Kat 1 PL b ohne Testung und Kat 2 PL c mit Testung.
SIL 2 | Wie AM + SIL 1, zusätzlich: Ein einzelner Fehler führt nicht zum Verlust der Sicherheitsfunktion. Dies kann sichergestellt werden durch: 1. Ein redundantes Bauteil übernimmt Funktion (z.B. Zweikanaligkeit) oder 2. Ein anderes Bauteil verhindert eine Gefährdung (z.B. Sicherheits-Abschaltung) oder 3. Das Bauteil ist nachweislich dauerfest und ausfallsicher (z.B. Bauteil ist mehrfach überdimensioniert und getestet). Ein Fehler muß bei der nächsten Anforderung der Sicherheitsfunktion erkannt werden. Der Nachweis von SIL2 1. bis 3. hat über die DIN EN ISO 13849-2:2003 Anhang D (Validierungsverfahren) zu erfolgen. | Wie AM + SIL 1, zusätzlich: Ein einzelner Fehler führt nicht zum Verlust der Sicherheitsfunktion. Dies kann sichergestellt werden durch: 1. Ein redundantes Bauteil übernimmt Funktion (z.B. Sicherungsseil) oder 2. Ein anderes Bauteil verhindert eine Gefährdung (z.B. Sicherheits-Abschaltung) oder 3. Das Bauteil ist nachweislich dauerfest und ausfallsicher (z.B. Bauteil ist mehrfach überdimensioniert und getestet) Ein Fehler muß bei der nächsten Anforderung der Sicherheitsfunktion erkannt werden. Der Nachweis hat über die DIN EN ISO 13849-2:2003 Anhang A-C (Validierungsverfahren) zu erfolgen. | Diese Tätigkeiten müssen durch qualifiziertes Fachpersonal durchgeführt werden. Definition Fachpersonal: Qualifiziertes Fachpersonal kennt die Vorgehensweise dieses Arbeitsschrittes und hat eine Fachausbildung in diesem Fachbereich. Z.B. ein Elektriker, der die Maschine in Betrieb nimmt oder ein Montage Mitarbeiter hat eine Fachausbildung zum Industriemechaniker. Der Bediener muss eine maschinenspezifische Inbetriebnahmeeinweisung beim Hersteller erfolgreich absolviert haben.
SIL 3 | Wie SIL2, zusätzlich: Der Fehler wird bei oder vor der nächsten Anforderung erkannt. Das Auftreten eines einzelnen Fehlers darf nicht zum Ausfall der Sicherheitsfunktion führen. Nur die Anhäufung von Fehlern darf zum Verlust der Sicherheitsfunktion führen. | Wie SIL2, zusätzlich: Der Fehler wird bei oder vor der nächsten Anforderung erkannt (Bsp. Kraftaufnehmer- Verformungsüberwachung). Das Auftreten eines einzelnen Fehlers darf nicht zum Ausfall der Sicherheitsfunktion führen. Nur die Anhäufung von Fehlern darf zum Verlust der Sicherheitsfunktion führen.

Sheet: Ursprung-Folgen nach ISO 12100
Liste der Gefährdungen
basierend auf DIN EN ISO 12100:2010 (Tabelle B.1)
 | Stand: | 2014-04-28
 | Anmerkungen: | Diese Liste enthätl lediglich Beispiele in der Risikoeurteilung könen weitere Ereignisse hinzugefügt werden.
 |  | 1 Eine Ursache kann mehrere Folgen haben
 |  | 2 Die Folgen können auf mehrere Ursachen zurückgehen. Die Nummerierungen in den Spalten Ursache und Mögliche Folgen wurden vom Autor zur Erleichterung von Bezugnahmen hinzugefügt
Nr. | Art der Gruppe | Ursprung 1 | Mögliche Folgen 2 | relevante mögliche Folgen | Einstufung der Schwere nach EN 62061
 |  | Ursprung | Folgen
1 | Mechanische Gefährdung | U1 Mechanische Gefährdung | F1 Mechanische Gefährdung | Mechanische Gefährdung
 |  | U1.1 Beschleunigung/Abbremsung (kinetische Energie) | F1.1 überfahren werden | F1.1 überfahren werden | 4
 |  | U1.2 spitze Teile | F1.2 weggeschleudert werden | F1.2 weggeschleudert werden | 2
 |  | U1.3 Annäherung eines sich bewegenden Teiles | F1.3 Quetschen | F1.3 Quetschen von Arm | 4
 |  | U1.4 schneidende Teile | F1.4 Schneiden oder Abschneiden | F1.3 Quetschen von Finger(n) | 3
 |  | U1.5 elastische Elemente | F1.5 Einziehen oder Fangen | F1.4 Schneiden oder Abschneiden | 4
 |  | U1.6 herabfallende Gegenstände | F1.6 Erfassen | F1.5 Einziehen oder Fangen | 3
 |  | U1.7 Schwerkraft (gespeicherte Energie) | F1.7 Reiben oder Abschürfen | F1.7 Reiben oder Abschürfen | 2
 |  | U1.8 Höhe gegenüber dem Boden | F1.8 Stoß | F1.8 Stoß | 3
 |  | U1.9 Hochdruck | F1.9 Eindringen von unter Druck stehenden Medien | F1.9 Eindringen von unter Druck stehenden Medien | 4
 |  | U1.10 Beweglichkeit der Maschine | F1.10 Scheren | F1.10 Scheren | 4
 |  | U1.11 sich bewegende Teile | F1.11 Ausrutschen, Stolpern oder Stürzen | F1.11 Ausrutschen, Stolpern oder Stürzen | 2
 |  | U1.12 rotierende Teile | F1.12 Durchstich oder Einstich | F1.12 Durchstich oder Einstich | 3
 |  | U1.13 raue, rutschige Oberfläche | F1.13 Ersticken | F1.13 Ersticken | 4
 |  | U1.14 scharfe Kanten | ./. | F1.20 herausschleudern von Proben und Bruchstücken | 4
 |  | U1.15 Standfestigkeit/-sicherheit | ./. | Elektrische Gefährdungen
 |  | U1.16 Vakuum | ./. | F2.1 Verbrennung | 2
 |  | U1.17 Beschleunigung/Abbremsung
 |  | U1.18 Annäherung eines sich bewegenden Teils an ein feststehendes Teil
2 | Elektrische Gefährdungen | U2 Elektrische Gefährdungen | F2 Elektrische Gefährdungen | F2.3 Auswirkungen auf medizinische Implantate | 4
 |  | U2.1 Lichtbogen | F2.1 Verbrennung | F2.4 tödlilcher Stromschlag | 4
 |  | U2.2 elektromagnetische Vorgänge | F2.2 chemische Reaktionen | F2.5 Stürzen, weggeschleudert werden | 2
 |  | U2.3 elektrostatische Vorgänge | F2.3 Auswirkungen auf medizinische Implantate | F2.6 Feuer | 4
 |  | U2.4 spannungsführende Teile | F2.4 tödlilcher Stromschlag | F2.8 (elektrischer) Schlag | 2
 |  | U2.5 unzureichender Abstand zu unter Hochspannung stehenden Teilen | F2.5 Stürzen, weggeschleudert werden | Thermische Gefährdungen
 |  | U2.6 Überlast | F2.6 Feuer | F3.1 Verbrennung | 2
 |  | U2.7 Teile, die im Fehlerzustand spannungsführend geworden sind | F2.7 Herausschleudern von geschmolzenen Teilen | F3.3 Unbehagen | 1
 |  | U2.8 Kurzschluss | F2.8 (elektrischer) Schlag | F3.4 Erfrierung | 2
 |  | U2.9 Wärmestrahlung | ./. | F3.5 Verletzungen durch Strahlung von Wärmequellen | 2
3 | Thermische Gefährdungen | U3 Thermische Gefährdungen | F3 Thermische Gefährdungen | F3.6 Verbrühung | 2
 |  | U3.1 Explosiion | F3.1 Verbrennung | Gefährdung durch Lärm
 |  | U3.2 Flamme | F3.2 Dehydrierung | F4.1 Unbehagen | 1
 |  | U3.3 Objekte oder Materialien hoher oder niedriger Temperatur | F3.3 Unbehagen | F4.4 bleibender Gehörverlust | 3
 |  | U3.4 Strahlung von Wärmequellen | F3.4 Erfrierung | F4.5 Stress | 1
 |  | ./. | F3.5 Verletzungen durch Strahlung von Wärmequellen | F4.6 Tinnitus (Ohrensausen) | 2
 |  | ./. | F3.6 Verbrühung | sonstige Gefährdungen
4 | Gefährdung durch Lärm | U4 Gefährdung durch Lärm | F4 Gefährdung durch Lärm | F4.7 Ermüdung | 1
 |  | U4.1 Kavitationsvorgänge | F4.1 Unbehagen | F7.2 Krebs | 4
 |  | U4.2 Abluftsystem | F4.2 Bewusstseinsverlust | F7.4 Auswirkungen auf die Fortpflanzungsfähigkeit | 3
 |  | U4.3 mit hoher Geschwindigkeit austretendes Gas | F4.3 Gleichgewichtsstörung | F7.9 Vergiftung | 4
 |  | U4.4 Herstellungsprozess (Stanzen, Schneiden usw.) | F4.4 bleibender Gehörverlust | F7.10 Sensibilisierung | 2
 |  | U4.5 bewegliche Teile | F4.5 Stress | F6 Gefährdung durch Strahlung | 3
 |  | U4.6 reibende Flächen | F4.6 Tinnitus (Ohrensausen)
 |  | U4.7 mit Unwucht rotierende Teile | F4.7 Ermüdung
 |  | U4.8 pfeifende Pneumatik-Einrichtungen | F4.8 alle weiteren (z.B. mechanischen, elektrischen) Probleme als Folge einer Störung der Sprachkommunikation oder einer Störung akustischer Signale
 |  | U4.9 verschlissene Teile | ./.
5 | Gefährdung durch Schwingungen | U5 Gefährdung durch Schwingungen | F5 Gefährdung durch Schwingungen
 |  | U5.1 Kavitationsvorgänge | F5.1 Unbehagen
 |  | U5.2 Fehlausrichtung sich bewegender Teile | F5.2 Erkrankungen der unteren Wirbelsäule
 |  | U5.3 bewegliche Ausrüstung | F5.3 neurologische Erkrankung
 |  | U5.4 reibende Flächen | F5.4 Knochengelenkschaden
 |  | U5.5 mit Unwucht rotierende Teile | F5.5 Wirbelsäulenverletzung
 |  | U5.6 schwingende Ausrüstung | F5.6 Gefäßerkrankungen
 |  | U5.7 verschlissene Teile | ./.
6 | Gefährdung durch Strahlung | U6 Gefährdung durch Strahlung | F6 Gefährdung durch Strahlung
 |  | U6.1 ionisierende Strahlungsquelle | F6.1 Verbrennung
 |  | U6.2 niederfrequente elektromagnetische Strahlung | F6.2 Augen- und Hautschädigung
 |  | U6.3 optische Strahlung (infrarot, sichtbar und ultraviolett) einschließlich Laserstrahlen | F6.3 Auswirkungen auf die Fortpflanzungsfähigkeit
 |  | U6.4 hochfrequente elektromagnetische Strahlung | F6.4 genetische Veränderung
 |  | ./. | F6.5 Kopfschmerzen, Schlaflosigkeit usw.
7 | Gefährdungen durch Materialien und Stoffe | U7 Gefährdungen durch Materialien und Stoffe | F7 Gefährdungen durch Materialien und Stoffe
 |  | U7.1 Aerosole | F7.1 Atembeschwerden, Ersticken
 |  | U7.2 biologische und mikrobiologische (Viren, Bakterien, Pilze) | F7.2 Krebs
 |  | U7.3 Brennstoffe | F7.3 Korrosion
 |  | U7.4 Stäube | F7.4 Auswirkungen auf die Fortpflanzungsfähigkeit
 |  | U7.5 Explosivstoffe | F7.5 Explosion
 |  | U7.6 Fasern | F7.6 Feuer
 |  | U7.7 feuergefährliches Material | F7.7 Infektion
 |  | U7.8 Flüssigkeiten | F7.8 Veränderungen des Erbguts
 |  | U7.9 Dämpfe | F7.9 Vergiftung
 |  | U7.10 Gase | F7.10 Sensibilisierung
 |  | U7.11 Nebel | ./.
 |  | U7.12 Oxidationsmittel | ./.
 | Gefährung durch unergonomische Gestaltung | U8 Gefährdung durch unergonomische Gestaltung | F8 Gefährdung durch unergonomische Gestaltung
8 |  | U8.1 Zugang | F8.1 Unbehagen
 |  | U8.2 Gestaltung oder Anordnung von Anzeigen | F8.2 Ermüdung
 |  | U8.3 Gestaltung, Anordnung oder Erkennung | F8.3 Störungen des Bewegungsapparates
 |  | U8.4 Anstrengung | F8.4 Stress
 |  | U8.5 Flackern, Blenden, Schattenbildung und stroboskopische Effekte | F8.5 alle weiteren (z.B. mechanischen, elektrischen) Probleme als Folge menschlichen Fehlverhaltens
 |  | U8.6 örtliche Beleuchtung | ./.
 |  | U8.7 psychische Überbelastung/Unterforderung | ./.
 |  | U8.8 Körperhaltung | ./.
 |  | U8.9 sich wiederholende Tätigkeiten | ./.
 |  | U8.10 Sichtbarkeit | ./.
9 | Gefährdungen im Zusammenhang mit der Einsatzumgebung der Maschine | U9 Gefährdungen im Zusammenhang mit der Einsatzumgebung der Maschine | F9 Gefährdungen im Zusammenhang mit der Einsatzumgebung der Maschine
 |  | U9.1 Staub und Nebel | F9.1 Verbrennungen
 |  | U9.2 elektromagnetische Störungen | F9.2 leichte Erkrankungen
 |  | U9.3 Blitzschlag | F9.3 Ausrutschen, Stürzen
 |  | U9.4 Feuchtigkeit | F9.4 Ersticken
 |  | U9.5 Verunreinigungen | F9.5 alle weiteren Probleme, die als Folge der Auswirkungen der Gefährdungsquellen an der Maschine oder an Teilen der Maschine auftreten
 |  | U9.6 Schnee | ./.
 |  | U9.7 Temperatur | ./.
 |  | U9.8 Wasser | ./.
 |  | U9.9 Wind | ./.
 |  | U9.10 Sauerstoffmangel | ./.
10 | Kombination von Gefährdungen | U10 Kombination von Gefährdungen | F10 Kombination von Gefährdungen
 |  | U10.1 z.B. sich wiederholende Tätigkeit + Anstrengung + hohe Umgebungstemperatur | F10.1 z.B. Dehydrierung, Bewusstseinsverlust, Hitzeschock

Sheet: Ereignisse nach ISO 12100
Liste der Gefährdungsereignisse
basierend auf DIN EN ISO 12100:2010 (Tabelle B.4)
Stand: | 2014-04-28
Anmerkungen: | Diese Liste enthätl lediglich Beispiele in der Risikoeurteilung könen weitere Ereignisse hinzugefügt werden.
Ursprung in Zusammenhang stehend mit … | Gefährungsereignissse (Beispiele)
der Form und/oder der Oberflächenbeschaffenheit der zugänglichen Maschinenteile | Kontakt mit rauen Oberflächen
 | Kontakt mit scharfen Kanten und Ecken, vorstehenden Teilen
den beweglichen Teilen der Maschine | Zugang zu/Kontakt mit beweglichen Teilen
 | Kontakt mit rotierenden offenen Enden
der kinetischen Energie und/oder potentiellen Energie (Schwerkraft) der Maschine, der Maschinenteile, der eingesetzten, verarbeiteten, gehandhabten Werkzeuge und Materialien | Herabfallen oder Ausstoß von Objekten
der Standfestigkeit/-sicherheit der Maschine und/oder von Maschinenteilen | Verlust der Standfestigkeit/-sicherheit
der mech. Festigkeit von Maschinenteilen, Werkzeugen usw. | Bruch während des Betriebs
der pneumatischen/hydraulischen Ausrüstung | Verschieben sich bewegender Teile
 | Herausspritzen von Flüssigkeiten unter hohem Druck
 | ungesteuerte Bewegungen
der elektrischen Ausrüstung | direkter Kontakt
 | Durchschlag
 | Lichtbogen
 | Feuer
 | indirekter Kontakt
 | Kurzschluss
Steuerung | Herabfallen oder Herausschleudern eines sich bewegenden Maschinenteils oder eines in der Maschine festgeklemmten Werkstückes
 | Ausfall von Einrichtungen zum Anhalten von sich bewegenden Teilen
 | Maschinentätigkeit als Ergebnis der Wirkungslosigkeit (Umgehen oder Ausfall) von Schutzeinrichtungen
 | ungesteuerte Bewegungen (einschließlich Geschwindigkeitsänderung)
 | unbeabsichtigter/unerwarteter Anlauf
 | weitere Gefährdungsereignisse durch Ausfälle oder unzureichende Konstruktion der Steuerung
Materialien und Stoffen oder physikalischen Faktoren (Temperatur, Lärm, Vibration, Strahlung und Umgebung) | Kontakt mit Objekten hoher oder geringer Temperatur
 | Emission eines Stoffes, der gefährdend sein kann
 | Emission eines Geräuschpegels, der gefährdend sein kann
 | Emission eines Geräuschpegels, der zu Störungen der Sprachkommunikation oder zu Störungen akustischer Signale führen kann
 | Emission eines Schwingungspegels, der gefährdend sein kann
 | Emission von Strahlungsfeldern, die gefährdend sein können
 | raue Umgebungsbedingungen
der Beschaffenheit des Arbeitsplatzes und/oder des Arbeitsprozesses | übermäßige Anstrengung
 | menschliche Fehler/ menschliches Fehlverhalten (unbeabsichtigt und/oder vorsätzlich durch die Konstruktion hervorgerufen)
 | Verlust der direkten Sichtbarkeit des Arbeitsbereiches
 | schmerzhafte und ermüdende Körperhaltungen
 | sich in hoher Frequenz wiederholende Tätigkeiten

Sheet: Vorgehen Risikoeinschätzung
Vorgehen Risikoeinschätzung
erste Einschätzung der Gefährdung nach EN 62061 |  | risikomindernde Maßnahmen | Beispiele |  | Risikoidentifizierung unter Berücksichtigung der risikomindernden Maßnahmen |  |  |  | zweiten Einschätzung der Gefährdung nach EN 62061
 |  | Veränderung am System der Maschine | - trennende Schutzeinrichtung | ² |  |  | Gefährdung nicht mehr gegeben | ² | keine erneute Einschätzung notwendig | Häufigkeit (F) | -
 |  |  | - mobile Schutzeinrichtung in Montage |  |  |  |  |  |  | Wahrscheinlichkeit (W) | -
 |  |  | - konstruktive Maßnahme/ Verbesserung |  |  |  |  |  |  | Vermeidung (P) | -
 |  |  |  |  |  |  |  |  |  | Schwere | -
Häufigkeit (F) | X |  |  |  |  |  |  |  |  | SIL (Ergebnis) | -
Wahrscheinlichkeit (W) | X
Vermeidung (P) | X | risikomindernde Maßnahmen |  | ² | Gefährdung noch vorhanden? | ² | Gefährdung vernünftigerweise nicht mehr vorhersehbar | ² | keine erneute Einschätzung notwendig | Häufigkeit (F) | -
Schwere | X |  | - konstruktive Maßnahme/ Verbesserung |  |  |  |  |  |  | Wahrscheinlichkeit (W) | -
SIL (Ergebnis) | X |  | - Warnhinweise an Maschine |  |  |  |  |  |  | Vermeidung (P) | -
Durch das Ergebnis der Einschätzung der Gefährdung sind risikomindernde Maßnahmen an der Maschine notwendig. |  |  | - Schutzmaßnahmen (PSA, Schutzleiter,…) |  |  |  |  |  |  | Schwere | -
 |  |  | - Inbetriebnahmecheckliste |  |  |  |  |  |  | SIL (Ergebnis) | -
 |  |  | - Inbetriebnahmeschulung
 |  |  | - Arbeitsanweisung für Montage und/oder Fertigung |  |  | ² | Gefährdung noch vorhanden | ² | erneute Einschätzung nach EN 62061 | Häufigkeit (F) | x
 |  |  | - Hinweis auf Vertriebsdokumentation |  |  |  |  |  |  | Wahrscheinlichkeit (W) | x
 |  |  | - Warnhinweis auf Restrisiko in der Bedienungsanleitung |  |  |  |  |  |  | Vermeidung (P) | x
 |  |  | - geschultes Personal oder Fachpersonal |  |  |  |  |  |  | Schwere | x
 |  |  |  |  |  |  |  |  |  | SIL (Ergebnis) | x
