MattdewT/KE3/Finale/CD/9+10 +11Schnittgrößen, Wellenberechnung und Smith-Diagramm/Gedrehter Motor_Wellenberechnung 42CrMo4.xlsm

Sheet: Tabelle1
Berechnung des Biegemomentenverlaufes |  |  |  |  | für 4 Abschnitte
Eingabewerte: |  |  | Vorzeichenrichtig nach Skizze!!!
l0= | 20 | mm | Im Angriffspunkt A | FAy | 2086.56 | N | FAz | -340.44 | N
l1= | 65 | mm | Im Angriffspunkt B | FBy | 4758.04 | N | FBz | 2331.04 | N
l2= | 160 | mm | Im Angriffspunkt C | FZug1y | -2500 | N | FZug1z bzw. FG1 | -73 | N
l3= | 65 | mm | Im Angriffspunkt D | FZug1y | -2500 | N | FZug2z bzw. FG2 | -73 | N
l4= | 65 | mm | Im Angriffspunkt E | FKy | -1844.6 | N | FKz | -1844.6 | N
l5= | 20 | mm | In E eingeleitetes Torsionsmoment |  | 240 | Nm
 |  |  |  | 0
 |  |  |  | 0
 |  |  |  | 0
Ergebnisse:
Maximales Biegemoment |  |  |  | Mbmax | 169.56 | Nm | Stelle s= | 290
Lagerkraft in Lager A |  |  |  | FA | 2114.15 | N
Lagerkraft in Lager B |  |  |  | FB | 5298.37 | N

Sheet: Smith-Diagramm
Werkstoff | 42CrMo4 |  | Werkstoffkennwerte für Durchmesser 40mm…60mm
Re | 650 | N/mm^2
Rm | 900 | N/mm^2
Sigma W | 405 | N/mm^2
Mittelspannung | 80 |  | Ertragbare Amplitude | 381.7741935 | N/mm^2
 |  |  | Obere ertragbare Spannung | 461.7741935 | N/mm^2

Sheet: Q1
Berechnung kritischer Querschnitt 1
Position s auf der Welle, vom Lager A aus in mm |  | mm | -7.5
(kleinster) Durchmesser an der Stelle s in mm |  | mm | 37.5
Formzahl für Biegung αkb |  |  | 4.03
Formzahl für Torsion αkt |  |  | 2.68 | Zellen E3 bis E8 ausfüllen und auf "Spannungen berechnen" klicken
Kerbwirkungszahl für Biegung βkb |  |  | 3.25
Kerbwirkungszahl für Torsion βkt |  |  | 2.25
Momente
Torsionsmoment statischer Anteil |  | Nm | 0 | aus Tabelle 2
Torsionsmoment dynamischer Anteil |  | Nm | 0 | aus Tabelle 2
Biegemoment statischer Anteil |  | Nm | 0 | aus Tabelle 2
Biegemoment dynamischer Anteil |  | Nm | 0 | aus Tabelle 2
Nennspannungen (ohne Kerbwirkung)
Nenntorsionsspannung statischer Anteil |  | N/mm^2 | 0 | Formel Decker 15.7, mit Anwendungsfaktor KA=1,1 nach Decker Tab. 4.5
Nenntorsionsspannung dynamischer Anteil |  | N/mm^2 | 0 | Formel Decker 15.7, mit Anwendungsfaktor KA=1,1 nach Decker Tab. 4.5
Nennbiegespannung statischer Anteil |  | N/mm^2 | 0 | Formel Decker 15.5, mit Anwendungsfaktor KA=1,1 nach Decker Tab. 4.5
Nennbiegespannung dynamischer Anteil |  | N/mm^2 | 0 | Formel Decker 15.5, mit Anwendungsfaktor KA=1,1 nach Decker Tab. 4.5
Vergleichsmittelspannung --> hier nur aus Torsion |  | N/mm^2 | 0 | Formel Decker 15.16
Vergleichsausschlagsspannung --> hier nur aus Biegung |  | N/mm^2 | 0 | Formel Decker 15.16
Obere Vergleichsausschlagsspannung |  | N/mm^2 | 0 | Formel Decker 15.17
Dauerfestigkeit (aus dem Smith-Diagramm mit der errechneten Vergleichsmittelspannung) |  | N/mm^2 | 405 | Zellen E31 bis E32 ausfüllen, falls gewünscht und auf "Festigkeitsnachweis durchführen" klicken
Re |  | N/mm^2 | 650
Rm |  | N/mm^2 | 900
Oberflächenbeiwert b1 |  |  | 0.77 | aus Decker Bild 15.14
Größenbeiwert b2 |  |  | 1 | Das Smithdiagramm ist bereits für einen Durchmesser von 40mm bis 60mm gezeichnet.
Zulässige obere Vergleichsspannung |  | N/mm^2 | 155.93 | Formel Decker 15.18
Zulässige Vergleichsausschlagsspannung |  | N/mm^2 | 155.93 | Formel Decker 15.19
Festigkeitsnachweis |  |  |  | Felder bleiben rot, solange der Festigkeitswert nicht zu den obigen Spannungen passt, weil noch nicht aktualisiert wurde
dynamisch | Dauerbruch aufgrund oberer V.spannung | ausreichend | Divison durch 0 nicht möglich | Formel Decker 15.19, notwendige Sicherheiten nach Decker Kap.15
dynamisch | Dauerbruch aufgrund Schwingamplitude | ausreichend | Division durch 0 nicht möglich | Formel Decker 15.18, notwendige Sicherheiten nach Decker Kap.15
Der Festigkeitsnachweis ist nicht nötig, da keine Kräfte oder Momente auf den Querschnitt wirken.

Sheet: Q2
Berechnung kritischer Querschnitt 2
Position s auf der Welle, vom Lager A aus in mm |  | mm | 7.5
(kleinster) Durchmesser an der Stelle s in mm |  | mm | 40
Formzahl für Biegung αkb |  |  | 2.65
Formzahl für Torsion αkt |  |  | 2.2 | Zellen E3 bis E8 ausfüllen und auf "Spannungen berechnen" klicken
Kerbwirkungszahl für Biegung βkb |  |  | 2.3
Kerbwirkungszahl für Torsion βkt |  |  | 1.69
Momente
Torsionsmoment statischer Anteil |  | Nm | 0 | aus Tabelle 2
Torsionsmoment dynamischer Anteil |  | Nm | 0 | aus Tabelle 2
Biegemoment statischer Anteil |  | Nm | 0 | aus Tabelle 2
Biegemoment dynamischer Anteil |  | Nm | 15.86 | aus Tabelle 2
Nennspannungen (ohne Kerbwirkung)
Nenntorsionsspannung statischer Anteil |  | N/mm^2 | 0 | Formel Decker 15.7, mit Anwendungsfaktor KA=1,1 nach Decker Tab. 4.5
Nenntorsionsspannung dynamischer Anteil |  | N/mm^2 | 0 | Formel Decker 15.7, mit Anwendungsfaktor KA=1,1 nach Decker Tab. 4.5
Nennbiegespannung statischer Anteil |  | N/mm^2 | 0 | Formel Decker 15.5, mit Anwendungsfaktor KA=1,1 nach Decker Tab. 4.5
Nennbiegespannung dynamischer Anteil |  | N/mm^2 | 2.78 | Formel Decker 15.5, mit Anwendungsfaktor KA=1,1 nach Decker Tab. 4.5
Vergleichsmittelspannung --> hier nur aus Torsion |  | N/mm^2 | 0 | Formel Decker 15.16
Vergleichsausschlagsspannung --> hier nur aus Biegung |  | N/mm^2 | 6.39 | Formel Decker 15.16
Obere Vergleichsausschlagsspannung |  | N/mm^2 | 6.39 | Formel Decker 15.17
Dauerfestigkeit (aus dem Smith-Diagramm abgelesen mit der errechneten Vergleichsmittelspannung) |  | N/mm^2 | 405 | Zellen E31 bis E32 ausfüllen, falls gewünscht und auf "Festigkeitsnachweis durchführen" klicken
Re |  | N/mm^2 | 650
Rm |  | N/mm^2 | 900
Oberflächenbeiwert b1 |  |  | 0.77 | aus Decker Bild 15.14
Größenbeiwert b2 |  |  | 1 | Das Smithdiagramm ist bereits für einen Durchmesser von 40mm bis 60mm gezeichnet.
Zulässige obere Vergleichsspannung |  | N/mm^2 | 155.93 | Formel Decker 15.18
Zulässige Vergleichsausschlagsspannung |  | N/mm^2 | 155.93 | Formel Decker 15.19
Festigkeitsnachweis |  |  |  | Felder bleiben rot, solange der Festigkeitswert nicht zu den obigen Spannungen passt, weil noch nicht aktualisiert wurde
dynamisch | Dauerbruch aufgrund oberer V.spannung | ausreichend | 48.8 | Formel Decker 15.19, notwendige Sicherheiten nach Decker Kap.15
dynamisch | Dauerbruch aufgrund Schwingamplitude | ausreichend | 48.8 | Formel Decker 15.18, notwendige Sicherheiten nach Decker Kap.15

Sheet: Q3
Berechnung kritischer Querschnitt 3
Position s auf der Welle, vom Lager A aus in mm |  | mm | 65
(kleinster) Durchmesser an der Stelle s in mm |  | mm | 45
Formzahl für Biegung αkb |  |  | 3.6
Formzahl für Torsion αkt |  |  | 2.25 | Zellen E3 bis E8 ausfüllen und auf "Spannungen berechnen" klicken
Kerbwirkungszahl für Biegung βkb |  |  | 2.96
Kerbwirkungszahl für Torsion βkt |  |  | 1.96
Momente
Torsionsmoment statischer Anteil |  | Nm | 120 | aus Tabelle 2
Torsionsmoment dynamischer Anteil |  | Nm | 0 | aus Tabelle 2
Biegemoment statischer Anteil |  | Nm | 0 | aus Tabelle 2
Biegemoment dynamischer Anteil |  | Nm | 137.42 | aus Tabelle 2
Nennspannungen (ohne Kerbwirkung)
Nenntorsionsspannung statischer Anteil |  | N/mm^2 | 7.38 | Formel Decker 15.7, mit Anwendungsfaktor KA=1,1 nach Decker Tab. 4.5
Nenntorsionsspannung dynamischer Anteil |  | N/mm^2 | 0 | Formel Decker 15.7, mit Anwendungsfaktor KA=1,1 nach Decker Tab. 4.5
Nennbiegespannung statischer Anteil |  | N/mm^2 | 0 | Formel Decker 15.5, mit Anwendungsfaktor KA=1,1 nach Decker Tab. 4.5
Nennbiegespannung dynamischer Anteil |  | N/mm^2 | 16.91 | Formel Decker 15.5, mit Anwendungsfaktor KA=1,1 nach Decker Tab. 4.5
Vergleichsmittelspannung --> hier nur aus Torsion |  | N/mm^2 | 28.77 | Formel Decker 15.16
Vergleichsausschlagsspannung --> hier nur aus Biegung |  | N/mm^2 | 50.04 | Formel Decker 15.16
Obere Vergleichsausschlagsspannung |  | N/mm^2 | 78.81 | Formel Decker 15.17
Dauerfestigkeit (aus dem Smith-Diagramm abgelesen mit der errechneten Vergleichsmittelspannung) |  | N/mm^2 | 396.65 | Zellen E31 bis E32 ausfüllen, falls gewünscht und auf "Festigkeitsnachweis durchführen" klicken
Re |  | N/mm^2 | 650
Rm |  | N/mm^2 | 900
Oberflächenbeiwert b1 |  |  | 0.77 | aus Decker Bild 15.14
Größenbeiwert b2 |  |  | 1 | Das Smithdiagramm ist bereits für einen Durchmesser von 40mm bis 60mm gezeichnet.
Zulässige obere Vergleichsspannung |  | N/mm^2 | 163.79 | Formel Decker 15.18
Zulässige Vergleichsausschlagsspannung |  | N/mm^2 | 152.71 | Formel Decker 15.19
Festigkeitsnachweis |  |  |  | Felder bleiben rot, solange der Festigkeitswert nicht zu den obigen Spannungen passt, weil noch nicht aktualisiert wurde
dynamisch | Dauerbruch aufgrund oberer V.spannung | ausreichend | 4.16 | Formel Decker 15.19, notwendige Sicherheiten nach Decker Kap.15
dynamisch | Dauerbruch aufgrund Schwingamplitude | ausreichend | 6.1 | Formel Decker 15.18, notwendige Sicherheiten nach Decker Kap.15

Sheet: Q4
Berechnung kritischer Querschnitt 4
Position s auf der Welle, vom Lager A aus in mm |  | mm | 145
(kleinster) Durchmesser an der Stelle s in mm |  | mm | 48
Formzahl für Biegung αkb |  |  | 1
Formzahl für Torsion αkt |  |  | 1 | Zellen E3 bis E8 ausfüllen und auf "Spannungen berechnen" klicken
Kerbwirkungszahl für Biegung βkb |  |  | 1
Kerbwirkungszahl für Torsion βkt |  |  | 1
Momente
Torsionsmoment statischer Anteil |  | Nm | 120 | aus Tabelle 2
Torsionsmoment dynamischer Anteil |  | Nm | 0 | aus Tabelle 2
Biegemoment statischer Anteil |  | Nm | 0 | aus Tabelle 2
Biegemoment dynamischer Anteil |  | Nm | 116.47 | aus Tabelle 2
Nennspannungen (ohne Kerbwirkung)
Nenntorsionsspannung statischer Anteil |  | N/mm^2 | 6.08 | Formel Decker 15.7, mit Anwendungsfaktor KA=1,1 nach Decker Tab. 4.5
Nenntorsionsspannung dynamischer Anteil |  | N/mm^2 | 0 | Formel Decker 15.7, mit Anwendungsfaktor KA=1,1 nach Decker Tab. 4.5
Nennbiegespannung statischer Anteil |  | N/mm^2 | 0 | Formel Decker 15.5, mit Anwendungsfaktor KA=1,1 nach Decker Tab. 4.5
Nennbiegespannung dynamischer Anteil |  | N/mm^2 | 11.81 | Formel Decker 15.5, mit Anwendungsfaktor KA=1,1 nach Decker Tab. 4.5
Vergleichsmittelspannung --> hier nur aus Torsion |  | N/mm^2 | 10.53 | Formel Decker 15.16
Vergleichsausschlagsspannung --> hier nur aus Biegung |  | N/mm^2 | 11.81 | Formel Decker 15.16
Obere Vergleichsausschlagsspannung |  | N/mm^2 | 22.34 | Formel Decker 15.17
Dauerfestigkeit (aus dem Smith-Diagramm abgelesen mit der errechneten Vergleichsmittelspannung) |  | N/mm^2 | 401.94 | Zellen E31 bis E32 ausfüllen, falls gewünscht und auf "Festigkeitsnachweis durchführen" klicken
Re |  | N/mm^2 | 650
Rm |  | N/mm^2 | 900
Oberflächenbeiwert b1 |  |  | 0.77 | aus Decker Bild 15.14
Größenbeiwert b2 |  |  | 1 | Das Smithdiagramm ist bereits für einen Durchmesser von 40mm bis 60mm gezeichnet.
Zulässige obere Vergleichsspannung |  | N/mm^2 | 158.8 | Formel Decker 15.18
Zulässige Vergleichsausschlagsspannung |  | N/mm^2 | 154.75 | Formel Decker 15.19
Festigkeitsnachweis |  |  |  | Felder bleiben rot, solange der Festigkeitswert nicht zu den obigen Spannungen passt, weil noch nicht aktualisiert wurde
dynamisch | Dauerbruch aufgrund oberer V.spannung | ausreichend | 14.22 | Formel Decker 15.19, notwendige Sicherheiten nach Decker Kap.15
dynamisch | Dauerbruch aufgrund Schwingamplitude | ausreichend | 26.21 | Formel Decker 15.18, notwendige Sicherheiten nach Decker Kap.15

Sheet: Q5
Berechnung kritischer Querschnitt 5
Position s auf der Welle, vom Lager A aus in mm |  | mm | 225
(kleinster) Durchmesser an der Stelle s in mm |  | mm | 45
Formzahl für Biegung αkb |  |  | 3.6
Formzahl für Torsion αkt |  |  | 2.25 | Zellen E3 bis E8 ausfüllen und auf "Spannungen berechnen" klicken
Kerbwirkungszahl für Biegung βkb |  |  | 2.96
Kerbwirkungszahl für Torsion βkt |  |  | 1.96
Momente
Torsionsmoment statischer Anteil |  | Nm | 240 | aus Tabelle 2
Torsionsmoment dynamischer Anteil |  | Nm | 0 | aus Tabelle 2
Biegemoment statischer Anteil |  | Nm | 0 | aus Tabelle 2
Biegemoment dynamischer Anteil |  | Nm | 112.34 | aus Tabelle 2
Nennspannungen (ohne Kerbwirkung)
Nenntorsionsspannung statischer Anteil |  | N/mm^2 | 14.76 | Formel Decker 15.7, mit Anwendungsfaktor KA=1,1 nach Decker Tab. 4.5
Nenntorsionsspannung dynamischer Anteil |  | N/mm^2 | 0 | Formel Decker 15.7, mit Anwendungsfaktor KA=1,1 nach Decker Tab. 4.5
Nennbiegespannung statischer Anteil |  | N/mm^2 | 0 | Formel Decker 15.5, mit Anwendungsfaktor KA=1,1 nach Decker Tab. 4.5
Nennbiegespannung dynamischer Anteil |  | N/mm^2 | 13.82 | Formel Decker 15.5, mit Anwendungsfaktor KA=1,1 nach Decker Tab. 4.5
Vergleichsmittelspannung --> hier nur aus Torsion |  | N/mm^2 | 57.53 | Formel Decker 15.16
Vergleichsausschlagsspannung --> hier nur aus Biegung |  | N/mm^2 | 40.91 | Formel Decker 15.16
Obere Vergleichsausschlagsspannung |  | N/mm^2 | 98.44 | Formel Decker 15.17
Dauerfestigkeit (aus dem Smith-Diagramm abgelesen mit der errechneten Vergleichsmittelspannung) |  | N/mm^2 | 388.3 | Zellen E31 bis E32 ausfüllen, falls gewünscht und auf "Festigkeitsnachweis durchführen" klicken
Re |  | N/mm^2 | 650
Rm |  | N/mm^2 | 900
Oberflächenbeiwert b1 |  |  | 0.77 | aus Decker Bild 15.14
Größenbeiwert b2 |  |  | 1 | Das Smithdiagramm ist bereits für einen Durchmesser von 40mm bis 60mm gezeichnet.
Zulässige obere Vergleichsspannung |  | N/mm^2 | 171.64 | Formel Decker 15.18
Zulässige Vergleichsausschlagsspannung |  | N/mm^2 | 149.49 | Formel Decker 15.19
Festigkeitsnachweis |  |  |  | Felder bleiben rot, solange der Festigkeitswert nicht zu den obigen Spannungen passt, weil noch nicht aktualisiert wurde
dynamisch | Dauerbruch aufgrund oberer V.spannung | ausreichend | 3.49 | Formel Decker 15.19, notwendige Sicherheiten nach Decker Kap.15
dynamisch | Dauerbruch aufgrund Schwingamplitude | ausreichend | 7.31 | Formel Decker 15.18, notwendige Sicherheiten nach Decker Kap.15

Sheet: Q6
Berechnung kritischer Querschnitt 6
Position s auf der Welle, vom Lager A aus in mm |  | mm | 282.5
(kleinster) Durchmesser an der Stelle s in mm |  | mm | 40
Formzahl für Biegung αkb |  |  | 2.65
Formzahl für Torsion αkt |  |  | 2.2 | Zellen E3 bis E8 ausfüllen und auf "Spannungen berechnen" klicken
Kerbwirkungszahl für Biegung βkb |  |  | 2.3
Kerbwirkungszahl für Torsion βkt |  |  | 1.69
Momente
Torsionsmoment statischer Anteil |  | Nm | 240 | aus Tabelle 2
Torsionsmoment dynamischer Anteil |  | Nm | 0 | aus Tabelle 2
Biegemoment statischer Anteil |  | Nm | 0 | aus Tabelle 2
Biegemoment dynamischer Anteil |  | Nm | 152.08 | aus Tabelle 2
Nennspannungen (ohne Kerbwirkung)
Nenntorsionsspannung statischer Anteil |  | N/mm^2 | 21.02 | Formel Decker 15.7, mit Anwendungsfaktor KA=1,1 nach Decker Tab. 4.5
Nenntorsionsspannung dynamischer Anteil |  | N/mm^2 | 0 | Formel Decker 15.7, mit Anwendungsfaktor KA=1,1 nach Decker Tab. 4.5
Nennbiegespannung statischer Anteil |  | N/mm^2 | 0 | Formel Decker 15.5, mit Anwendungsfaktor KA=1,1 nach Decker Tab. 4.5
Nennbiegespannung dynamischer Anteil |  | N/mm^2 | 26.64 | Formel Decker 15.5, mit Anwendungsfaktor KA=1,1 nach Decker Tab. 4.5
Vergleichsmittelspannung --> hier nur aus Torsion |  | N/mm^2 | 80.09 | Formel Decker 15.16
Vergleichsausschlagsspannung --> hier nur aus Biegung |  | N/mm^2 | 61.27 | Formel Decker 15.16
Obere Vergleichsausschlagsspannung |  | N/mm^2 | 141.36 | Formel Decker 15.17
Dauerfestigkeit (aus dem Smith-Diagramm abgelesen mit der errechneten Vergleichsmittelspannung) |  | N/mm^2 | 381.75 | Zellen E31 bis E32 ausfüllen, falls gewünscht und auf "Festigkeitsnachweis durchführen" klicken
Re |  | N/mm^2 | 650
Rm |  | N/mm^2 | 900
Oberflächenbeiwert b1 |  |  | 0.77 | aus Decker Bild 15.14
Größenbeiwert b2 |  |  | 1 | Das Smithdiagramm ist bereits für einen Durchmesser von 40mm bis 60mm gezeichnet.
Zulässige obere Vergleichsspannung |  | N/mm^2 | 177.81 | Formel Decker 15.18
Zulässige Vergleichsausschlagsspannung |  | N/mm^2 | 146.97 | Formel Decker 15.19
Festigkeitsnachweis |  |  |  | Felder bleiben rot, solange der Festigkeitswert nicht zu den obigen Spannungen passt, weil noch nicht aktualisiert wurde
dynamisch | Dauerbruch aufgrund oberer V.spannung | ausreichend | 2.52 | Formel Decker 15.19, notwendige Sicherheiten nach Decker Kap.15
dynamisch | Dauerbruch aufgrund Schwingamplitude | ausreichend | 4.8 | Formel Decker 15.18, notwendige Sicherheiten nach Decker Kap.15

Sheet: Q7
Berechnung kritischer Querschnitt 7
Position s auf der Welle, vom Lager A aus in mm |  | mm | 302.5
(kleinster) Durchmesser an der Stelle s in mm |  | mm | 36
Formzahl für Biegung αkb |  |  | 1.55
Formzahl für Torsion αkt |  |  | 1.1 | Zellen E3 bis E8 ausfüllen und auf "Spannungen berechnen" klicken
Kerbwirkungszahl für Biegung βkb |  |  | 1.46
Kerbwirkungszahl für Torsion βkt |  |  | 1.05
Momente
Torsionsmoment statischer Anteil |  | Nm | 240 | aus Tabelle 2
Torsionsmoment dynamischer Anteil |  | Nm | 0 | aus Tabelle 2
Biegemoment statischer Anteil |  | Nm | 0 | aus Tabelle 2
Biegemoment dynamischer Anteil |  | Nm | 136.95 | aus Tabelle 2
Nennspannungen (ohne Kerbwirkung)
Nenntorsionsspannung statischer Anteil |  | N/mm^2 | 28.83 | Formel Decker 15.7, mit Anwendungsfaktor KA=1,1 nach Decker Tab. 4.5
Nenntorsionsspannung dynamischer Anteil |  | N/mm^2 | 0 | Formel Decker 15.7, mit Anwendungsfaktor KA=1,1 nach Decker Tab. 4.5
Nennbiegespannung statischer Anteil |  | N/mm^2 | 0 | Formel Decker 15.5, mit Anwendungsfaktor KA=1,1 nach Decker Tab. 4.5
Nennbiegespannung dynamischer Anteil |  | N/mm^2 | 32.91 | Formel Decker 15.5, mit Anwendungsfaktor KA=1,1 nach Decker Tab. 4.5
Vergleichsmittelspannung --> hier nur aus Torsion |  | N/mm^2 | 54.93 | Formel Decker 15.16
Vergleichsausschlagsspannung --> hier nur aus Biegung |  | N/mm^2 | 48.04 | Formel Decker 15.16
Obere Vergleichsausschlagsspannung |  | N/mm^2 | 102.98 | Formel Decker 15.17
Dauerfestigkeit (aus dem Smith-Diagramm abgelesen mit der errechneten Vergleichsmittelspannung) |  | N/mm^2 | 389.05 | Zellen E31 bis E32 ausfüllen, falls gewünscht und auf "Festigkeitsnachweis durchführen" klicken
Re |  | N/mm^2 | 650
Rm |  | N/mm^2 | 900
Oberflächenbeiwert b1 |  |  | 0.77 | aus Decker Bild 15.14
Größenbeiwert b2 |  |  | 1 | Das Smithdiagramm ist bereits für einen Durchmesser von 40mm bis 60mm gezeichnet.
Zulässige obere Vergleichsspannung |  | N/mm^2 | 170.93 | Formel Decker 15.18
Zulässige Vergleichsausschlagsspannung |  | N/mm^2 | 149.79 | Formel Decker 15.19
Festigkeitsnachweis |  |  |  | Felder bleiben rot, solange der Festigkeitswert nicht zu den obigen Spannungen passt, weil noch nicht aktualisiert wurde
dynamisch | Dauerbruch aufgrund oberer V.spannung | ausreichend | 3.32 | Formel Decker 15.19, notwendige Sicherheiten nach Decker Kap.15
dynamisch | Dauerbruch aufgrund Schwingamplitude | ausreichend | 6.24 | Formel Decker 15.18, notwendige Sicherheiten nach Decker Kap.15
Der Festigkeitsnachweis ist nicht nötig, da keine Kräfte oder Momente auf den Querschnitt wirken

Sheet: Q8
Berechnung kritischer Querschnitt 8
Position s auf der Welle, vom Lager A aus in mm |  | mm | 332.5
(kleinster) Durchmesser an der Stelle s in mm |  | mm | 32 |  |  | 36
Formzahl für Biegung αkb |  |  | 4.2
Formzahl für Torsion αkt |  |  | 3.6 |  | Zellen E3 bis E8 ausfüllen und auf "Spannungen berechnen" klicken
Kerbwirkungszahl für Biegung βkb |  |  | 3.85
Kerbwirkungszahl für Torsion βkt |  |  | 3.33
Momente
Torsionsmoment statischer Anteil |  | Nm | 240 |  | aus Tabelle 2
Torsionsmoment dynamischer Anteil |  | Nm | 0 |  | aus Tabelle 2
Biegemoment statischer Anteil |  | Nm | 0 |  | aus Tabelle 2
Biegemoment dynamischer Anteil |  | Nm | 58.69 |  | aus Tabelle 2
Nennspannungen (ohne Kerbwirkung)
Nenntorsionsspannung statischer Anteil |  | N/mm^2 | 34.98 |  | Formel Decker 15.7, mit Anwendungsfaktor KA=1,1 nach Decker Tab. 4.5
Nenntorsionsspannung dynamischer Anteil |  | N/mm^2 | 0 |  | Formel Decker 15.7, mit Anwendungsfaktor KA=1,1 nach Decker Tab. 4.5
Nennbiegespannung statischer Anteil |  | N/mm^2 | 0 |  | Formel Decker 15.5, mit Anwendungsfaktor KA=1,1 nach Decker Tab. 4.5
Nennbiegespannung dynamischer Anteil |  | N/mm^2 | 17.11 |  | Formel Decker 15.5, mit Anwendungsfaktor KA=1,1 nach Decker Tab. 4.5
Vergleichsmittelspannung --> hier nur aus Torsion |  | N/mm^2 | 218.14 |  | Formel Decker 15.16
Vergleichsausschlagsspannung --> hier nur aus Biegung |  | N/mm^2 | 65.87 |  | Formel Decker 15.16
Obere Vergleichsausschlagsspannung |  | N/mm^2 | 284.01 |  | Formel Decker 15.17
Dauerfestigkeit (aus dem Smith-Diagramm abgelesen mit der errechneten Vergleichsmittelspannung) |  | N/mm^2 | 341.67 |  | Zellen E31 bis E32 ausfüllen, falls gewünscht und auf "Festigkeitsnachweis durchführen" klicken
Re |  | N/mm^2 | 650
Rm |  | N/mm^2 | 900
Oberflächenbeiwert b1 |  |  | 0.88 | Rz4 | aus Decker Bild 15.14
Größenbeiwert b2 |  |  | 1 |  | Das Smithdiagramm ist bereits für einen Durchmesser von 40mm bis 60mm gezeichnet.
Zulässige obere Vergleichsspannung (Sicherheit 1,7) |  | N/mm^2 | 246.32 |  | Formel Decker 15.18
Zulässige Vergleichsausschlagsspannung (Sicherheit 1,7) |  | N/mm^2 | 150.33 |  | Formel Decker 15.19
Festigkeitsnachweis |  |  |  |  | Felder bleiben rot, solange der Festigkeitswert nicht zu den obigen Spannungen passt, weil noch nicht aktualisiert wurde
dynamisch | Dauerbruch aufgrund oberer V.spannung | ausreichend | 1.73 |  | Formel Decker 15.19, notwendige Sicherheiten nach Decker Kap.15
dynamisch | Dauerbruch aufgrund Schwingamplitude | ausreichend | 4.56 |  | Formel Decker 15.18, notwendige Sicherheiten nach Decker Kap.15

Sheet: Q9
Berechnung kritischer Querschnitt 9
Position s auf der Welle, vom Lager A aus in mm |  | mm | 371.5
(kleinster) Durchmesser an der Stelle s in mm |  | mm | 24
Formzahl für Biegung αkb |  |  | -
Formzahl für Torsion αkt |  |  | - | Zellen E3 bis E8 ausfüllen und auf "Spannungen berechnen" klicken
Kerbwirkungszahl für Biegung βkb |  |  | -
Kerbwirkungszahl für Torsion βkt |  |  | -
Momente
Torsionsmoment statischer Anteil |  | Nm | 0 | aus Tabelle 2
Torsionsmoment dynamischer Anteil |  | Nm | 0 | aus Tabelle 2
Biegemoment statischer Anteil |  | Nm | 0 | aus Tabelle 2
Biegemoment dynamischer Anteil |  | Nm | 0 | aus Tabelle 2
Nennspannungen (ohne Kerbwirkung)
Nenntorsionsspannung statischer Anteil |  | N/mm^2 | 0 | Formel Decker 15.7, mit Anwendungsfaktor KA=1,1 nach Decker Tab. 4.5
Nenntorsionsspannung dynamischer Anteil |  | N/mm^2 | 0 | Formel Decker 15.7, mit Anwendungsfaktor KA=1,1 nach Decker Tab. 4.5
Nennbiegespannung statischer Anteil |  | N/mm^2 | 0 | Formel Decker 15.5, mit Anwendungsfaktor KA=1,1 nach Decker Tab. 4.5
Nennbiegespannung dynamischer Anteil |  | N/mm^2 | 0 | Formel Decker 15.5, mit Anwendungsfaktor KA=1,1 nach Decker Tab. 4.5
Vergleichsmittelspannung --> hier nur aus Torsion |  | N/mm^2 | 0 | Formel Decker 15.16
Vergleichsausschlagsspannung --> hier nur aus Biegung |  | N/mm^2 | 0 | Formel Decker 15.16
Obere Vergleichsausschlagsspannung |  | N/mm^2 | 0 | Formel Decker 15.17
Dauerfestigkeit (aus dem Smith-Diagramm abgelesen mit der errechneten Vergleichsmittelspannung) |  | N/mm^2 | - | Zellen E31 bis E32 ausfüllen, falls gewünscht und auf "Festigkeitsnachweis durchführen" klicken
Re |  | N/mm^2 | -
Rm |  | N/mm^2 | -
Oberflächenbeiwert b1 |  |  | - | aus Decker Bild 15.14
Größenbeiwert b2 |  |  | - | Das Smithdiagramm ist bereits für einen Durchmesser von 40mm bis 60mm gezeichnet.
Zulässige obere Vergleichsspannung |  | N/mm^2 | 175 | Formel Decker 15.18
Zulässige Vergleichsausschlagsspannung |  | N/mm^2 | 175 | Formel Decker 15.19
Festigkeitsnachweis |  |  |  | Felder bleiben rot, solange der Festigkeitswert nicht zu den obigen Spannungen passt, weil noch nicht aktualisiert wurde
dynamisch | Dauerbruch aufgrund oberer V.spannung | ausreichend | Divison durch 0 nicht möglich | Formel Decker 15.19, notwendige Sicherheiten nach Decker Kap.15
dynamisch | Dauerbruch aufgrund Schwingamplitude | ausreichend | Division durch 0 nicht möglich | Formel Decker 15.18, notwendige Sicherheiten nach Decker Kap.15
Der Festigkeitsnachweis ist nicht nötig, da keine Kräfte oder Momente auf den Querschnitt wirken.

Sheet: Q10
Stelle mit dem größten Biegemoment
Position s auf der Welle, vom Lager A aus in mm |  | mm | 290
(kleinster) Durchmesser an der Stelle s in mm |  | mm | 45
Formzahl für Biegung αkb |  |  | 1
Formzahl für Torsion αkt |  |  | 1 | Zellen E3 bis E8 ausfüllen und auf "Spannungen berechnen" klicken
Kerbwirkungszahl für Biegung βkb |  |  | 1
Kerbwirkungszahl für Torsion βkt |  |  | 1
Momente
Torsionsmoment statischer Anteil |  | Nm | 240 | aus Tabelle 2
Torsionsmoment dynamischer Anteil |  | Nm | 0 | aus Tabelle 2
Biegemoment statischer Anteil |  | Nm | 0 | aus Tabelle 2
Biegemoment dynamischer Anteil |  | Nm | 169.56 | aus Tabelle 2
Nennspannungen (ohne Kerbwirkung)
Nenntorsionsspannung statischer Anteil |  | N/mm^2 | 14.76 | Formel Decker 15.7, mit Anwendungsfaktor KA=1,1 nach Decker Tab. 4.5
Nenntorsionsspannung dynamischer Anteil |  | N/mm^2 | 0 | Formel Decker 15.7, mit Anwendungsfaktor KA=1,1 nach Decker Tab. 4.5
Nennbiegespannung statischer Anteil |  | N/mm^2 | 0 | Formel Decker 15.5, mit Anwendungsfaktor KA=1,1 nach Decker Tab. 4.5
Nennbiegespannung dynamischer Anteil |  | N/mm^2 | 20.86 | Formel Decker 15.5, mit Anwendungsfaktor KA=1,1 nach Decker Tab. 4.5
Vergleichsmittelspannung --> hier nur aus Torsion |  | N/mm^2 | 25.57 | Formel Decker 15.16
Vergleichsausschlagsspannung --> hier nur aus Biegung |  | N/mm^2 | 20.86 | Formel Decker 15.16
Obere Vergleichsausschlagsspannung |  | N/mm^2 | 46.43 | Formel Decker 15.17
Dauerfestigkeit (aus dem Smith-Diagramm mit der errechneten Vergleichsmittelspannung) |  | N/mm^2 | 397.58 | Zellen E31 bis E32 ausfüllen, falls gewünscht und auf "Festigkeitsnachweis durchführen" klicken
Re |  | N/mm^2 | 650
Rm |  | N/mm^2 | 900
Oberflächenbeiwert b1 |  |  | 0.77 | aus Decker Bild 15.14
Größenbeiwert b2 |  |  | 1 | Das Smithdiagramm ist bereits für einen Durchmesser von 40mm bis 60mm gezeichnet.
Zulässige obere Vergleichsspannung |  | N/mm^2 | 162.91 | Formel Decker 15.18
Zulässige Vergleichsausschlagsspannung |  | N/mm^2 | 153.07 | Formel Decker 15.19
Festigkeitsnachweis |  |  |  | Felder bleiben rot, solange der Festigkeitswert nicht zu den obigen Spannungen passt, weil noch nicht aktualisiert wurde
dynamisch | Dauerbruch aufgrund oberer V.spannung | ausreichend | 7.02 | Formel Decker 15.19, notwendige Sicherheiten nach Decker Kap.15
dynamisch | Dauerbruch aufgrund Schwingamplitude | ausreichend | 14.68 | Formel Decker 15.18, notwendige Sicherheiten nach Decker Kap.15
Der Festigkeitsnachweis ist nicht nötig, da keine Kräfte oder Momente auf den Querschnitt wirken.

Sheet: Werte_Smith
0 | 405
0.1 | 405.0709677
0.2 | 405.1419355
0.3 | 405.2129032
0.4 | 405.283871
0.5 | 405.3548387
0.6 | 405.4258065
0.7 | 405.4967742
0.8 | 405.5677419
0.9 | 405.6387097
1 | 405.7096774
1.1 | 405.7806452
1.2 | 405.8516129
1.3 | 405.9225806
1.4 | 405.9935484
1.5 | 406.0645161
1.6 | 406.1354839
1.7 | 406.2064516
1.8 | 406.2774194
1.9 | 406.3483871
2 | 406.4193548
2.1 | 406.4903226
2.2 | 406.5612903
2.3 | 406.6322581
2.4 | 406.7032258
2.5 | 406.7741935
2.6 | 406.8451613
2.7 | 406.916129
2.8 | 406.9870968
2.9 | 407.0580645
3 | 407.1290323
3.1 | 407.2
3.2 | 407.2709677
3.3 | 407.3419355
3.4 | 407.4129032
3.5 | 407.483871
3.6 | 407.5548387
3.7 | 407.6258065
3.8 | 407.6967742
3.9 | 407.7677419
4 | 407.8387097
4.1 | 407.9096774
4.2 | 407.9806452
4.3 | 408.0516129
4.4 | 408.1225806
4.5 | 408.1935484
4.6 | 408.2645161
4.7 | 408.3354839
4.8 | 408.4064516
4.9 | 408.4774194
5 | 408.5483871
5.1 | 408.6193548
5.2 | 408.6903226
5.3 | 408.7612903
5.4 | 408.8322581
5.5 | 408.9032258
5.6 | 408.9741935
5.7 | 409.0451613
5.8 | 409.116129
5.9 | 409.1870968
6 | 409.2580645
6.1 | 409.3290323
6.2 | 409.4
6.3 | 409.4709677
6.4 | 409.5419355
6.5 | 409.6129032
6.6 | 409.683871
6.7 | 409.7548387
6.8 | 409.8258065
6.9 | 409.8967742
7 | 409.9677419
7.1 | 410.0387097
7.2 | 410.1096774
7.3 | 410.1806452
7.4 | 410.2516129
7.5 | 410.3225806
7.6 | 410.3935484
7.7 | 410.4645161
7.8 | 410.5354839
7.9 | 410.6064516
8 | 410.6774194
8.1 | 410.7483871
8.2 | 410.8193548
8.3 | 410.8903226
8.4 | 410.9612903
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
215.5 | 557.9354839
215.6 | 558.0064516
215.7 | 558.0774194
215.8 | 558.1483871
215.9 | 558.2193548
216 | 558.2903226
216.1 | 558.3612903
216.2 | 558.4322581
216.3 | 558.5032258
216.4 | 558.5741935
216.5 | 558.6451613
216.6 | 558.716129
216.7 | 558.7870968
216.8 | 558.8580645
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
