MattdewT/KE3/Finale/CD/CAD/Kaufteile/FAZ_II_10_10_94981_1.stp

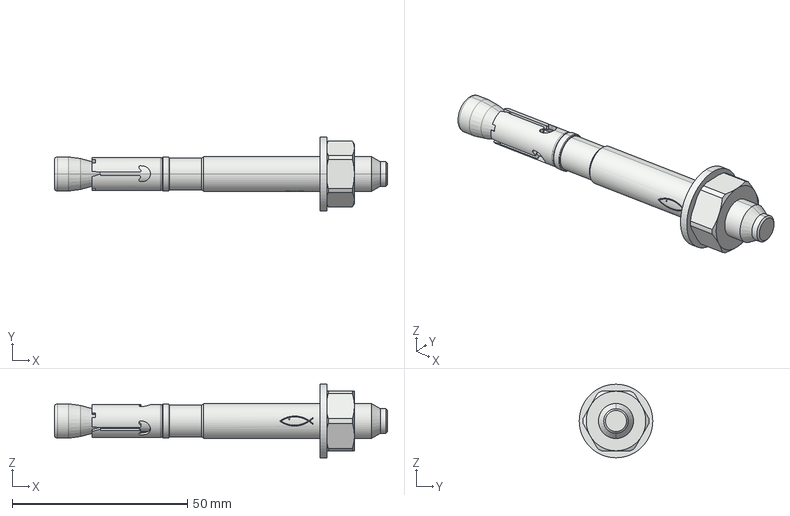
[picture p151: CAD file, 2019-11-06]
Finale/CD/CAD/Kaufteile/FAZ_II_10_10_94981_1.stp
95.0 x 21.0 x 21.0 mm
FAZ II 10/10_94981 x 3
