MattdewT/KE3/Finale/CD/CAD/Kaufteile/Spannsatz.stp

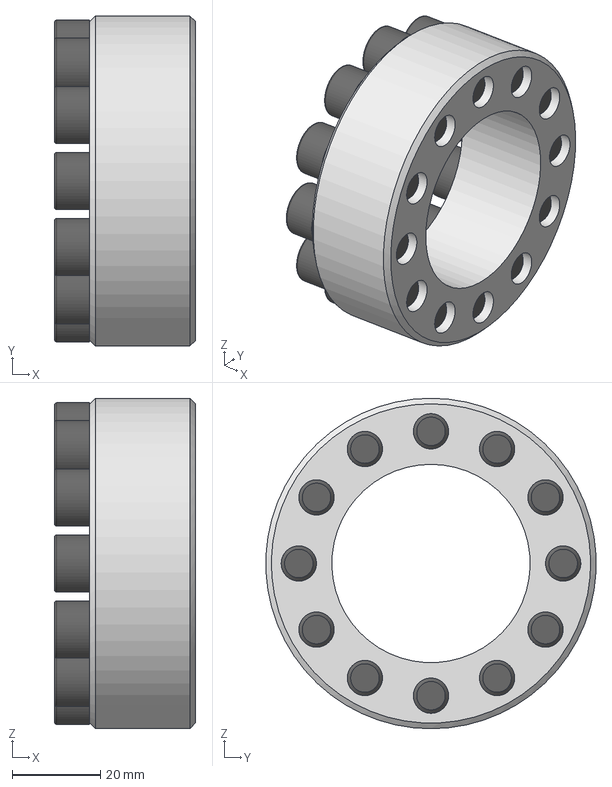
[picture p152: CAD file, 2019-10-29]
Finale/CD/CAD/Kaufteile/Spannsatz.stp
32.0 x 74.9 x 75.0 mm
_dummy_com_ausf_a_61554500_45
_ring_com_ausf_a_61554500_45
_schr_com_ausf_a_M8x22 x 12
