MattdewT/KE3/Finale/CD/CAD/Kaufteile/Motor NORD.stp

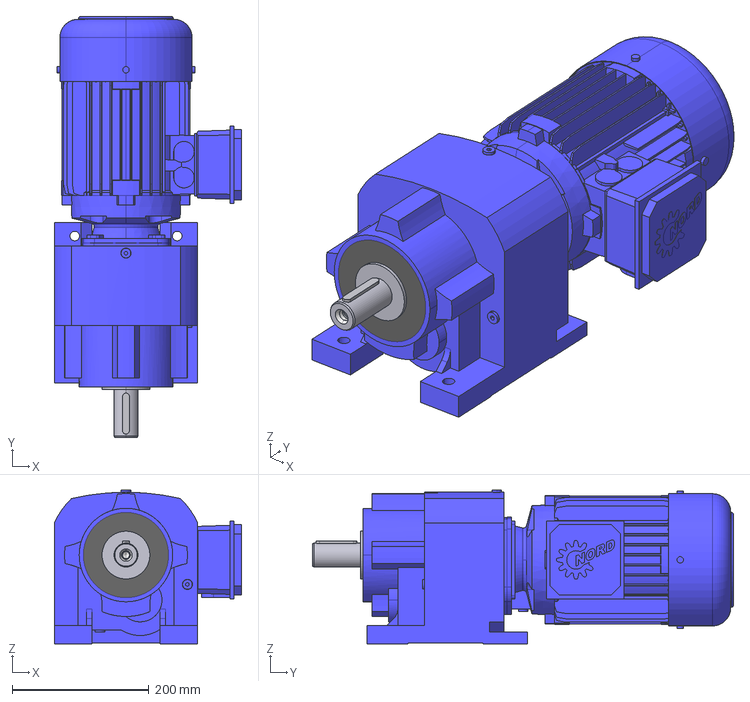
[picture p153: CAD file, 2019-10-16]
Finale/CD/CAD/Kaufteile/Motor NORD.stp
274.5 x 616.5 x 225.0 mm
