MattdewT/KE3/(list of files, cad)

Other CAD files:
CAD/Antriebstrommel_BG.prt
Finale/CD/CAD/714125110060000 DIN 71412 A AM6SW7 Kegelschmiernippel.prt
Finale/CD/CAD/D0912620.prt
Finale/CD/CAD/Distanzhuelse.prt
Finale/CD/CAD/Explosion.prt
Finale/CD/CAD/Explusion.prt
Finale/CD/CAD/Gesamt_Motor_BG.prt
Finale/CD/CAD/Gesamt_Motor_BG_2.prt
Finale/CD/CAD/Gesamt_Motor_BG_dwg.prt
Finale/CD/CAD/Gesamtzeichnung_dwg.prt
Finale/CD/CAD/Kaufteile/1.prt
Finale/CD/CAD/Kaufteile/10.prt
Finale/CD/CAD/Kaufteile/11.prt
Finale/CD/CAD/Kaufteile/12.prt
Finale/CD/CAD/Kaufteile/13.prt
Finale/CD/CAD/Kaufteile/14.prt
Finale/CD/CAD/Kaufteile/15.prt
Finale/CD/CAD/Kaufteile/16.prt
Finale/CD/CAD/Kaufteile/17.prt
Finale/CD/CAD/Kaufteile/18.prt
Finale/CD/CAD/Kaufteile/19.prt
Finale/CD/CAD/Kaufteile/2.prt
Finale/CD/CAD/Kaufteile/3.prt
Finale/CD/CAD/Kaufteile/4.prt
Finale/CD/CAD/Kaufteile/5.prt
Finale/CD/CAD/Kaufteile/6.prt
Finale/CD/CAD/Kaufteile/7.prt
Finale/CD/CAD/Kaufteile/8.prt
Finale/CD/CAD/Kaufteile/9.prt
Finale/CD/CAD/Kaufteile/Bolzenanker.prt
Finale/CD/CAD/Kaufteile/Kettenrad.prt
Finale/CD/CAD/Kaufteile/Kettenrad_Motor.prt
Finale/CD/CAD/Kaufteile/S-Ring_DIN471_61744000_Federstahl.prt
Finale/CD/CAD/Kaufteile/Schraube_M6x16.prt
Finale/CD/CAD/Kaufteile/Spannsatz_stp.prt
Finale/CD/CAD/Kaufteile/WUERTH 025506 5 Gewindestift DIN 913 M6x5 45H A2K_ST.prt
Finale/CD/CAD/Kaufteile/WUERTH 036924 Sechskantmutter DIN 980 V M24 8 A2K_ST.prt
Finale/CD/CAD/Kaufteile/_dummy_com_ausf_a_61554500_45.prt
Finale/CD/CAD/Kaufteile/_ring_com_ausf_a_61554500_45.prt
Finale/CD/CAD/Kaufteile/_schr_com_ausf_a_M8x22.prt
Finale/CD/CAD/Lager.prt
Finale/CD/CAD/Lagerbock_BGR.prt
Finale/CD/CAD/Lagerbock_Oberteil.prt
Finale/CD/CAD/Lagerbock_Unterteil.prt
Finale/CD/CAD/Lagerdeckel.prt
Finale/CD/CAD/Lagerdeckel_A.prt
Finale/CD/CAD/Lagerdeckel_B.prt
Finale/CD/CAD/Lagergehaeuse-Befestigung_Oberteil.prt
Finale/CD/CAD/Lagergehaeuse_A_BG.prt
Finale/CD/CAD/Lagergehaeuse_BG.prt
Finale/CD/CAD/Lagergehaeuse_B_BG.prt
Finale/CD/CAD/Motor.prt
Finale/CD/CAD/O-Ring Huelse.prt
Finale/CD/CAD/O-Ring Lagerdeckel.prt
Finale/CD/CAD/Radial-Wellendichtring DIN 3760 AS 45x60x8.prt
Finale/CD/CAD/Trommel-WelleBGR.prt
Finale/CD/CAD/Trommel_Rohr.prt
Finale/CD/CAD/Trommel_Seitenwand_Variante A.prt
Finale/CD/CAD/Trommel_Variante B/Trommel-Welle_BGR_Variante B (neu).prt
Finale/CD/CAD/Trommel_Variante B/Trommel_Seitenwand_Variante B.prt
Finale/CD/CAD/Trommel_Variante B/Trommel_Zusatzrohr_Variante B.prt
Finale/CD/CAD/Welle_2.prt
Finale/CD/CAD/lagergehaeuse.prt
