MattdewT/KE3/Montageanleitung.docx

# Montageanleitung – Variante B (Spannpressverband)

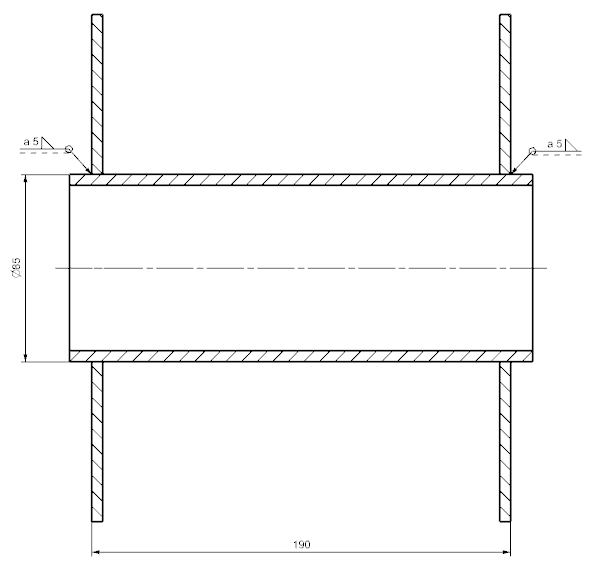
[picture p154: figure]

1. Überprüfen Sie den Lieferumfang mit Hilfe der Stückliste. 2. Schweißen Sie mit einer umlaufenden Kehlnaht (einseitig, von außen, a = 5 mm) die beiden Seitenwände auf das Rohr mit Außendurchmesser 85 mm. Die äußeren Kanten der Seitenwände sollen einen Abstand von 190 mm haben. Es ist auf die Rechtwinkligkeit von Rohr und Seitenwänden zu achten.

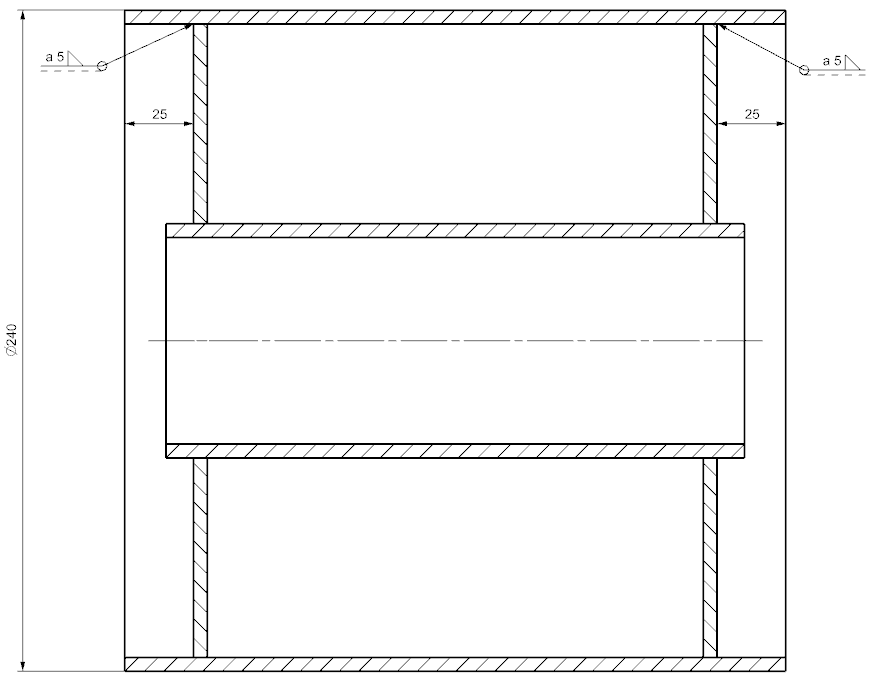
[picture p155: figure]

3. Verschweißen Sie das Rohr mit Außendurchmesser 240 mm mit den in der in Schritt 2 hergestellten Baugruppe. Dabei ist darauf zu achten, dass auf beiden Seiten der gleiche Abstand 25 mm von Rohrende zu Seitenwand eingehalten wird.

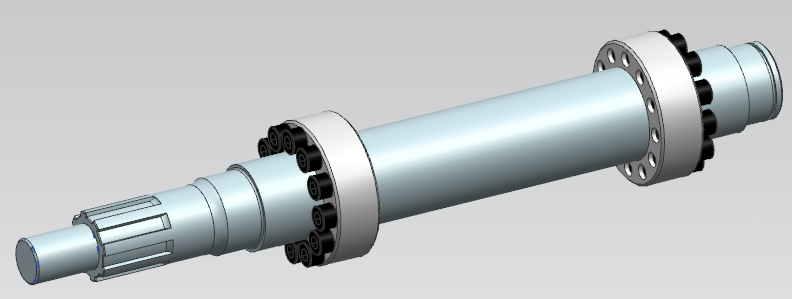
[picture p156: figure]
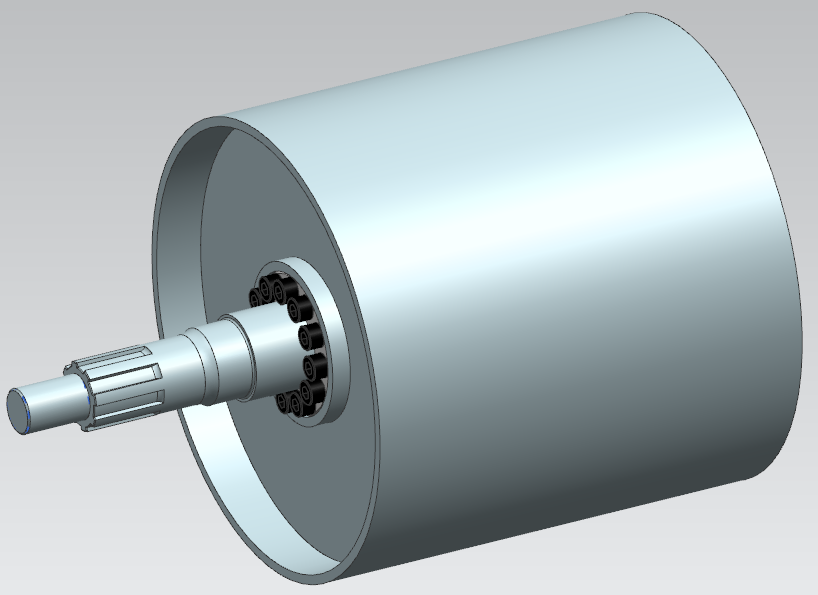
[picture p157: figure]

4. Stecken Sie die Spannpressverbände auf beiden Seiten auf die Welle und schieben Sie sie bis zum Anschlag. Anschließend führen Sie das eben verschweißten Teil über die Spannpressverbände und richten es mittig aus.
5. Ziehen Sie die Schrauben der Spannsätze mit 37 Nm an.

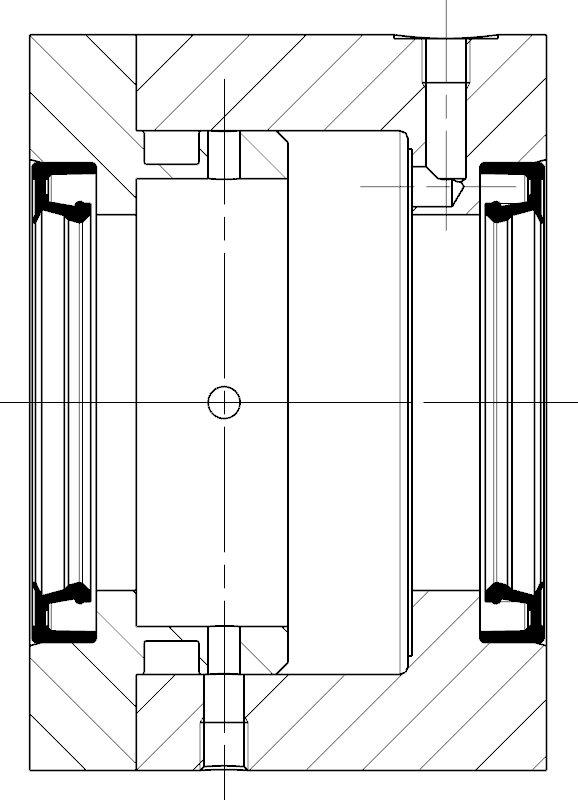
[picture p158: figure]
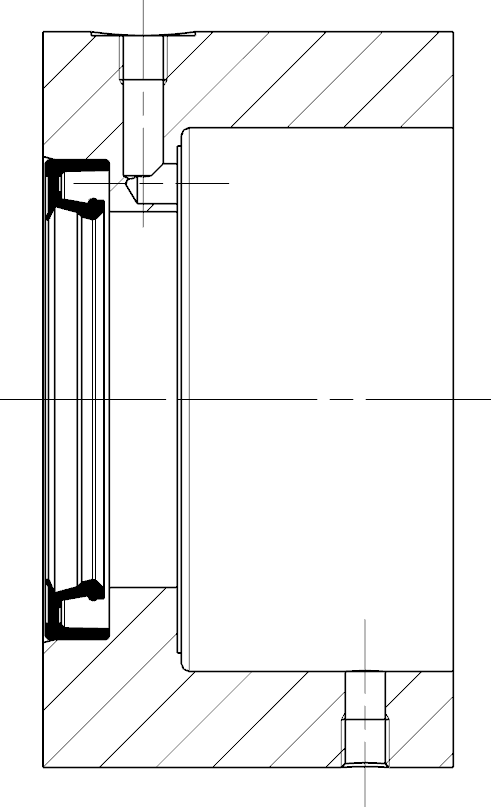
[picture p159: figure]

6. Montieren Sie die Radialwellendichtringe in die beiden Gehäuse und in den Deckel mit Durchgangsloch. Achten Sie darauf, die Ringe nicht zu beschädigen. Für die richtige Orientierung beachten Sie das nebenstehende Bild.

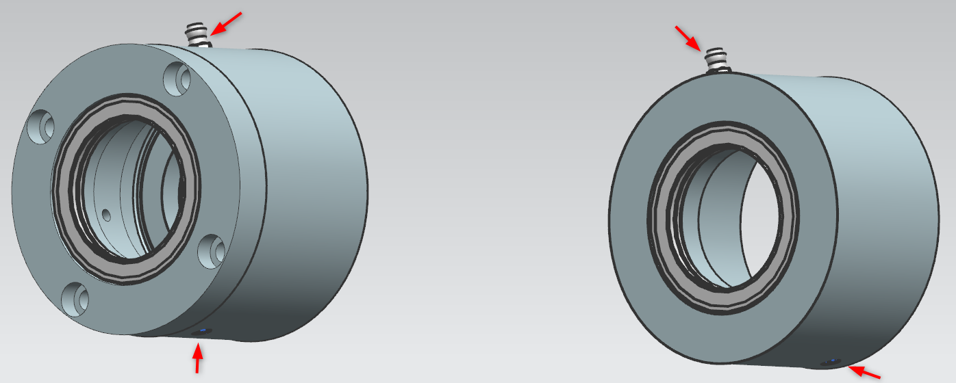
[picture p160: figure]

7. Schrauben Sie in beide Gehäuse den Schmiernippel in die dafür vorgesehenen Bohrungen. Montieren Sie auf der gegenüberliegenden Seite in die beiden Gehäuse die Stopfen.

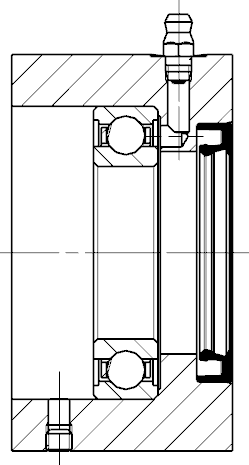
[picture p161: figure]
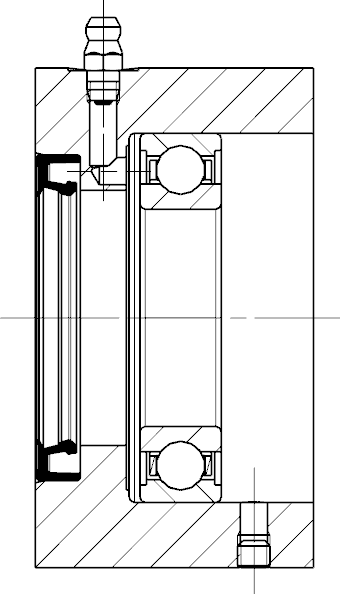
[picture p162: figure]

8. Platzieren Sie die beiden Kugellager mit Hilfe einer geeigneten Vorrichtung in den Gehäusen.

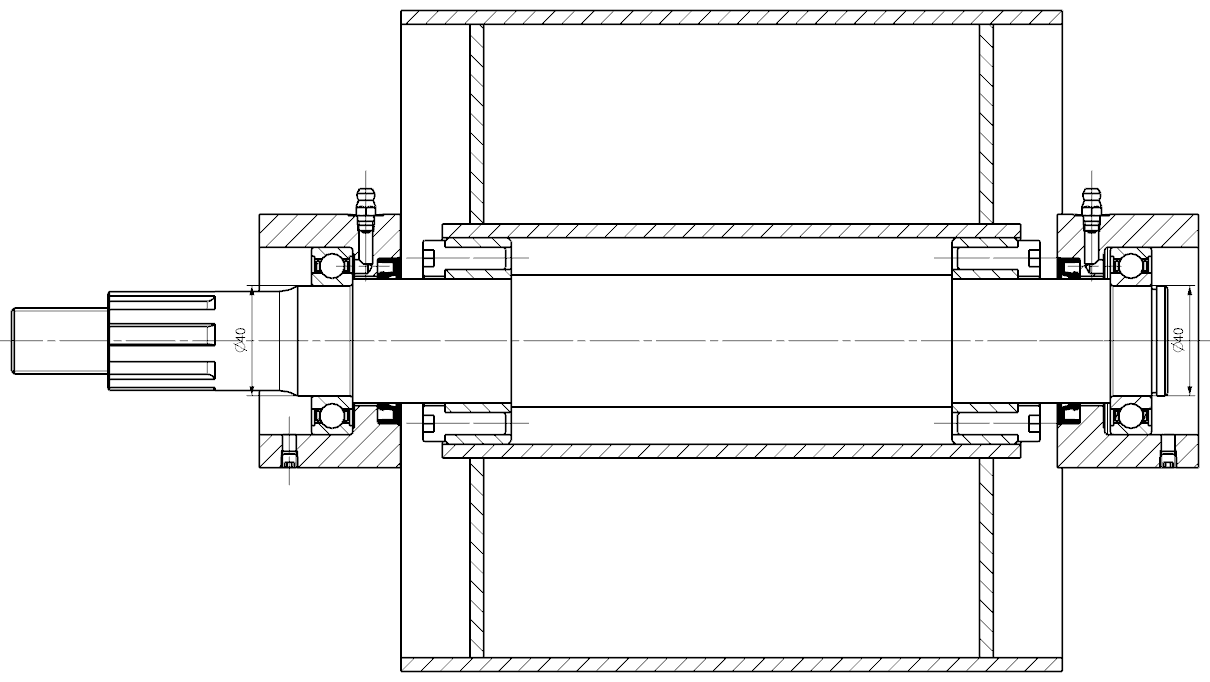
[picture p163: figure]

9. Stecken Sie die beiden Gehäuse mit Radialwellendichtring, Schmiernippel, Stopfen und Kugellager auf beide Seiten der Welle. Pressen Sie dabei das Kugellager auf den Wellendurchmesser 40 mm.

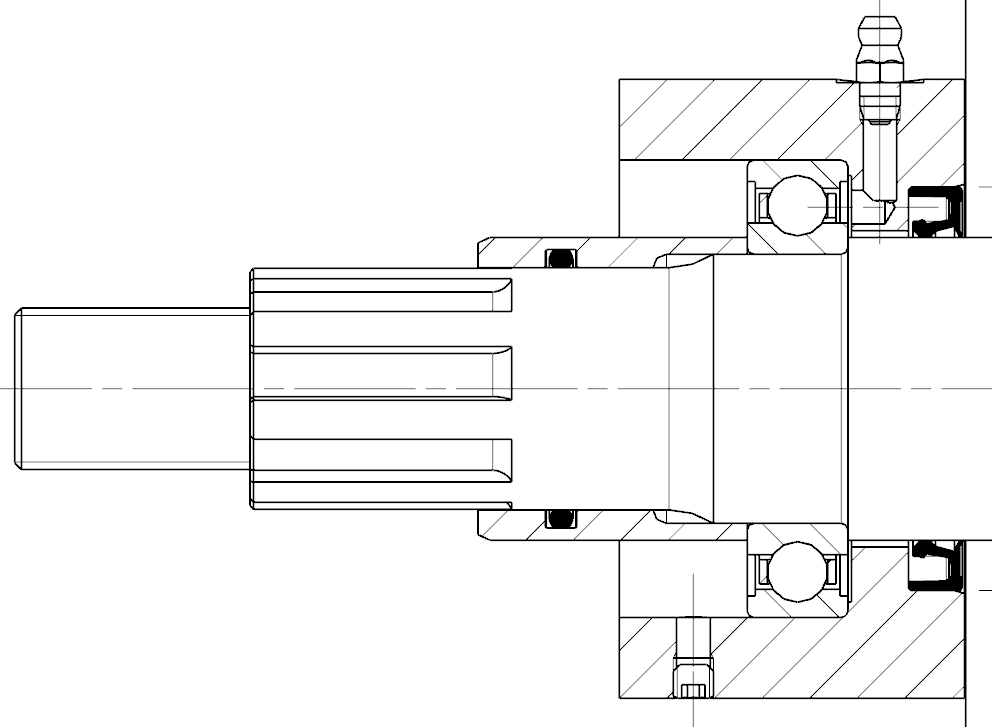
[picture p164: figure]

10. Führen Sie die Distanzhülse mit dem O-Ring (Ø 33,1 x 3,53) auf das Wellenende mit der Keilwelle mit der Seite des größeren Innendurchmessers zuerst.
11. Montieren Sie die großen O-Ringe (Ø 62,9 x 5,33) in die Deckelnuten.

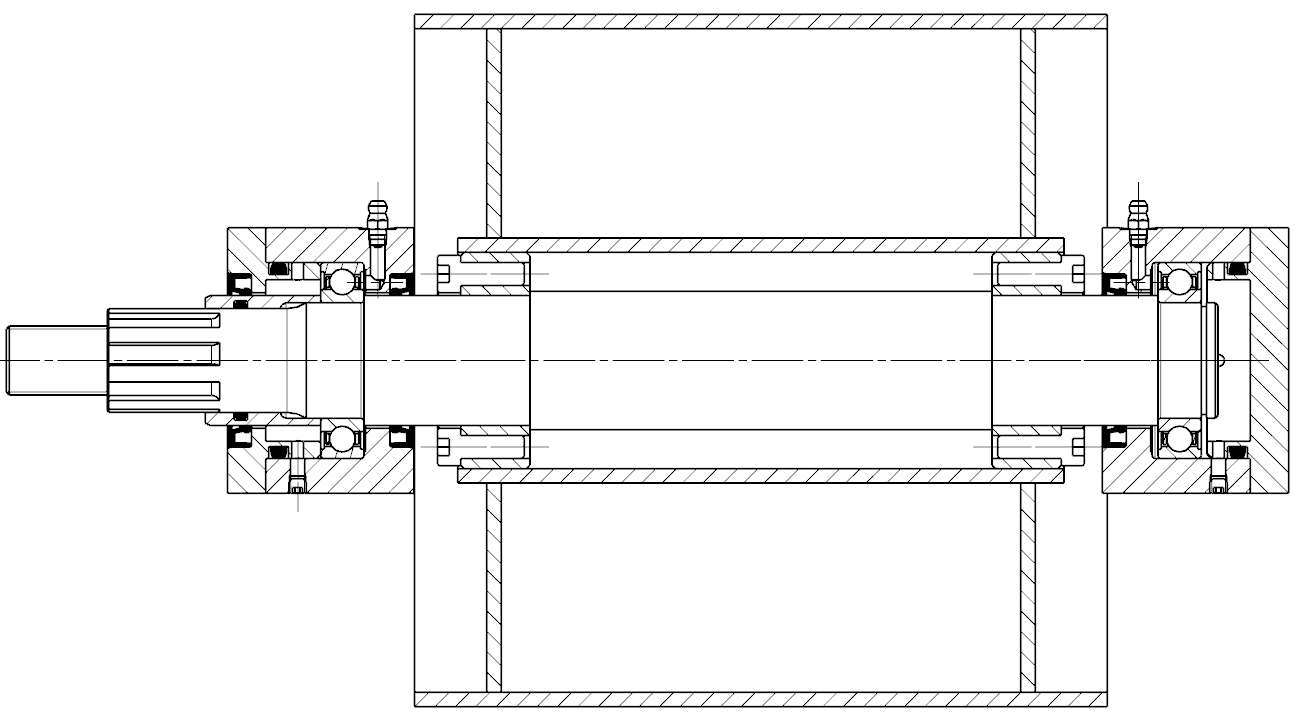
[picture p165: figure]

12. Stecken Sie die Deckel auf die beiden Enden der Welle und schrauben Sie diesen mit einem Anziehmoment von 11,2 Nm fest.

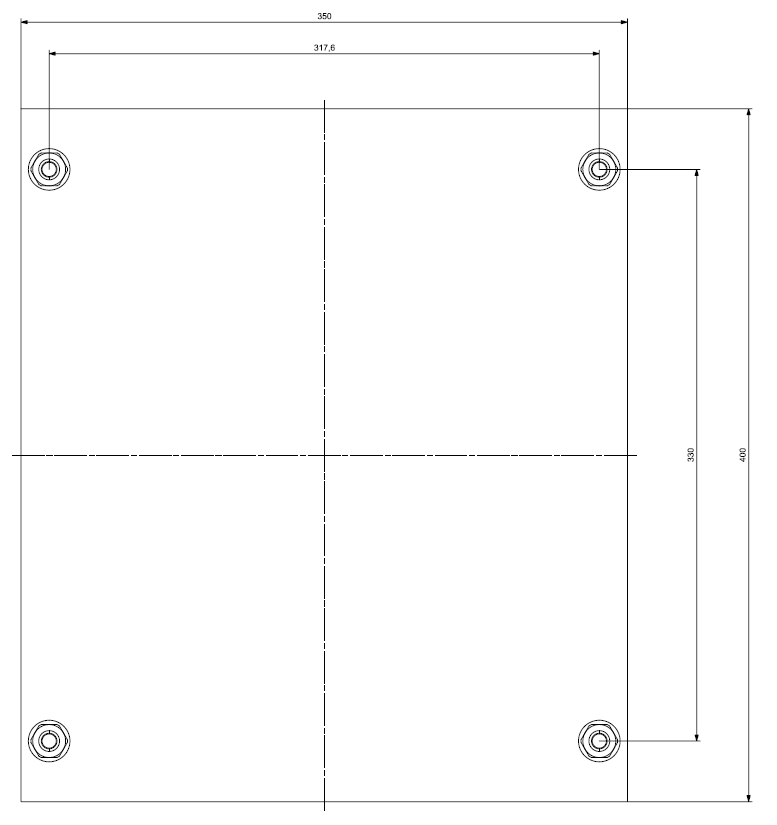
[picture p166: figure]

13. Bohren Sie in den Betonklotz vier Löcher (Ø 12 mm, Tiefe: 105 mm) für die Bolzenanker nach nebenstehender Skizze. 14. Reinigen Sie die Bohrlöcher.


15. Positionieren Sie die Unterteile der Lagerböcke wie im nebenstehenden Bild auf dem Betonklotz. 16. Nehmen Sie die Bolzenanker und schlagen Sie die Anker mit Hilfe eines Hammers in die Löcher ein. 17. Ziehen Sie die Bolzenanker so fest an, sodass die Lagerböcke im Bereich der Langlöcher noch verschoben werden können. 18. Achten Sie auf die Parallelität der Lagerböcke.

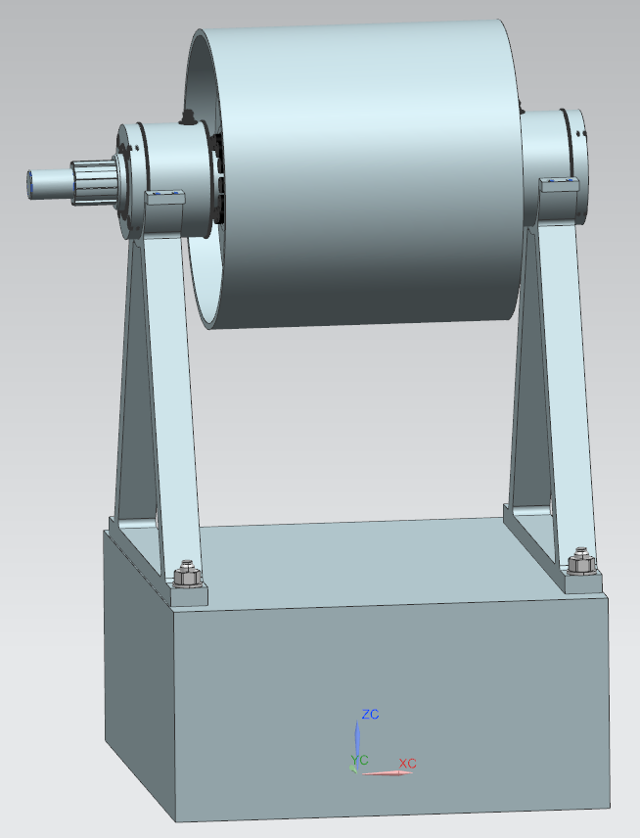
[picture p167: figure]

19. Legen Sie die vormontierte Wellen-Baugruppe in die Lagerböcke. Achten Sie darauf, dass die axiale Ausrichtung zu keinerlei Kollisionen führt.

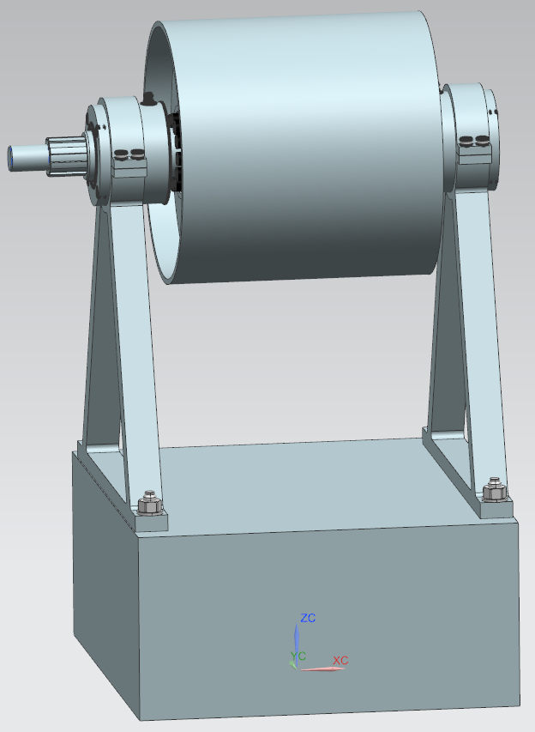
[picture p168: figure]

20. Setzen Sie die Oberteile der Lagerböcke auf die Lager. 21. Verschrauben Sie die Oberteile der Lagerböcke mit den Unterteilen der Lagerböcke mit acht Innensechskantschrauben (M6 x 16) 22. Ziehen Sie die Schrauben mit einem Anziehmoment von T=11,2Nm an.
23. Ziehen Sie die Bolzenanker nach genauem Ausrichten der Baugruppe mit einem Anziehmoment von 60 Nm an.

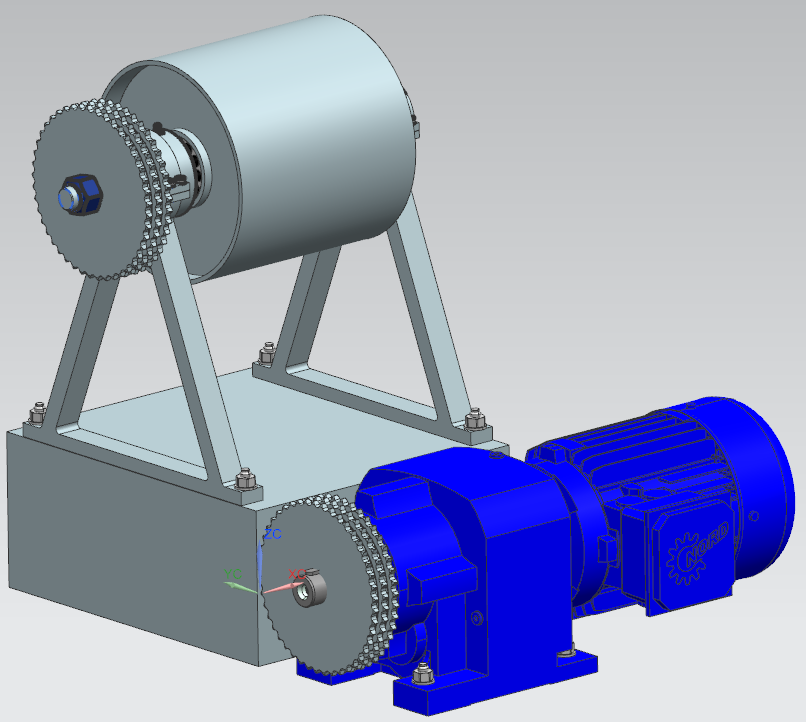
[picture p169: figure]
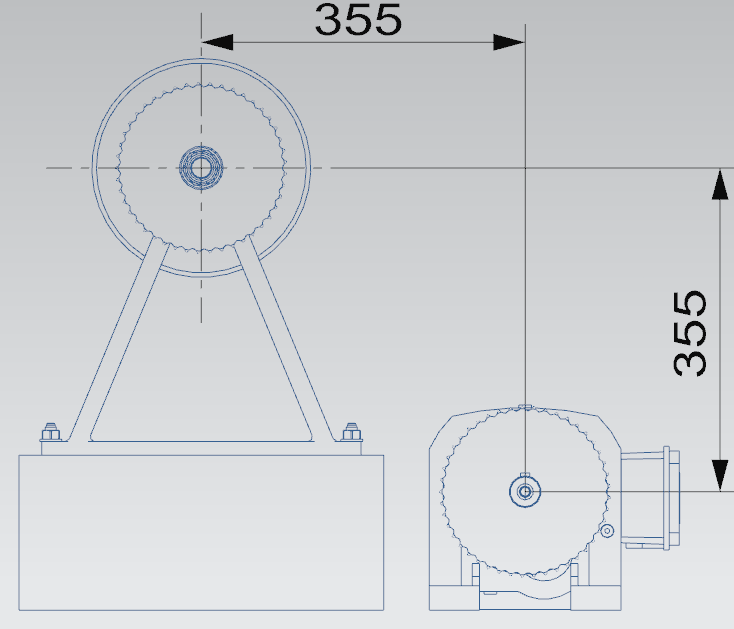
[picture p170: figure]

24. Stecken Sie das Kettenrad mit Keilfedernabe auf den Wellenabschnitt mit der Keilwelle. 25. Positionieren Sie den Motor wie im nebenstehenden Bild und befestigen Sie ihn ebenso mit vier Betonankern. 26. Stecken Sie das Kettenrad mit Passfedernabe auf die Antriebswelle des Motors.

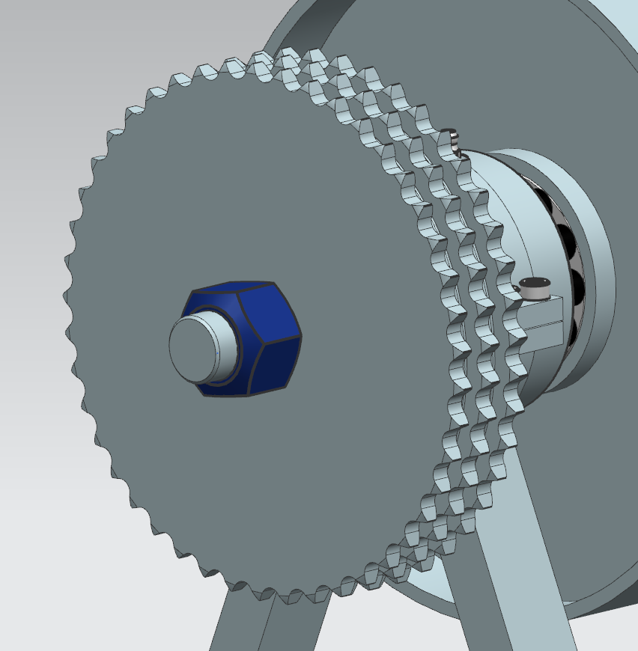
[picture p171: figure]

27. Montieren Sie Sechskantmutter mit Klemmteil (M24) auf die Welle der Antriebstrommel und ziehen Sie diese mit einem Anziehmoment von 800 Nm fest.
28. Montieren Sie die Dreifachrollenkette auf die beiden Kettenräder und schließen Sie diese mit dem Verschlussglied. | Bild

# Montageanleitung – Variante A (Schweißverband)

Die Montageanleitung für die Variante A weicht von der der Variante B nur in wenigen Punkten ab, die nachfolgend erläutert werden.

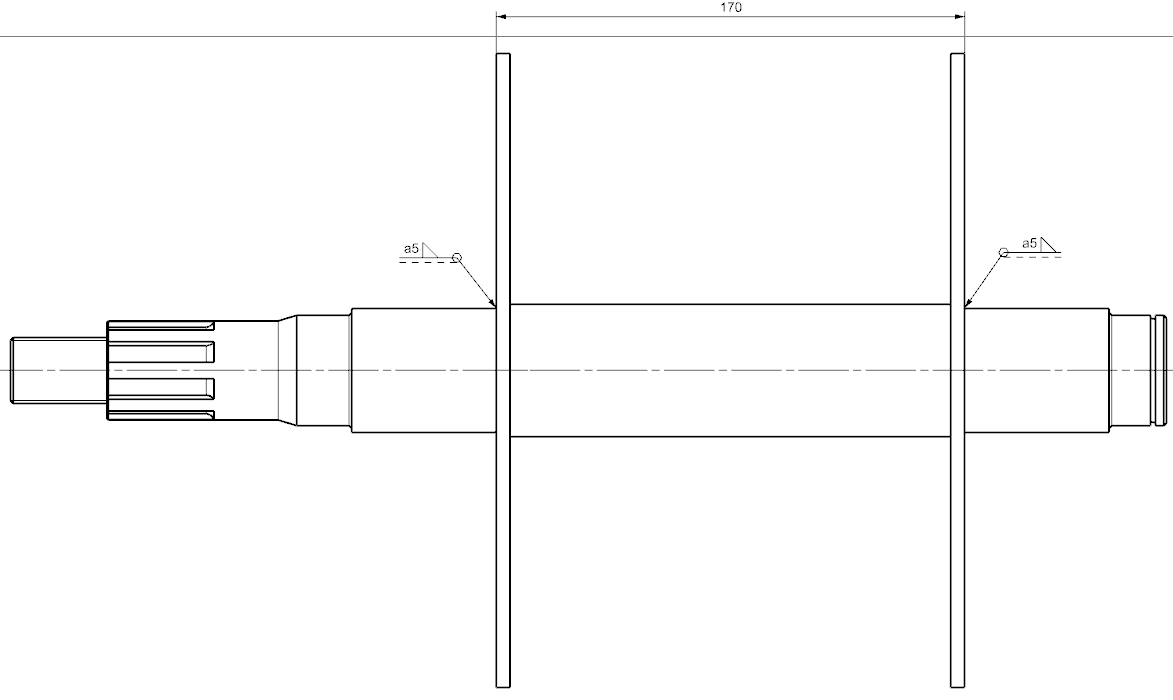
[picture p172: figure]

1. Überprüfen Sie den Lieferumfang mit Hilfe der Stückliste. 2. Schweißen Sie mit einer umlaufenden Kehlnaht (einseitig, von außen, a = 5 mm) die beiden Seitenwände auf die Welle. Die äußeren Kanten der Seitenwände sollen einen Abstand von 170 mm haben. Es ist auf die Rechtwinkligkeit von Welle und Seitenwänden zu achten.

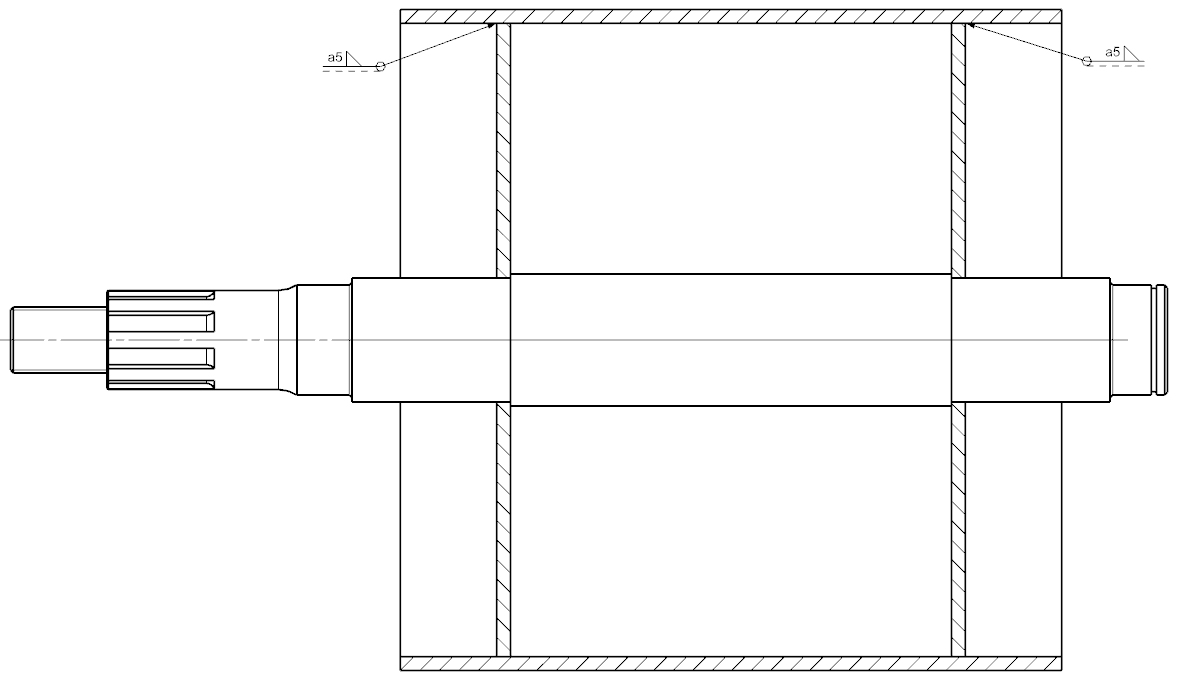
[picture p173: figure]

3. Schieben Sie die Trommel über die Seitenwände. 4. Schweißen Sie mit einer umlaufenden Kehlnaht (einseitig, von außen, a = 5 mm) die Trommel auf die Seitenwände. Es ist auf die Rechtwinkligkeit von Seitenwänden und Trommel zu achten.

Die weitere Montage erfolgt wie bei der Spannpressverband-Variante (ab Punkt 6).

# Demontage

Die Demontage erfolgt in umgekehrter Reihenfolge zur Montageanleitung. Verwenden Sie zur Demontage der Kugellager eine geeignete Demontagevorrichtung.
