MattdewT/KE3/RB-Blessing/FMEA/Strukturanalyse.docx

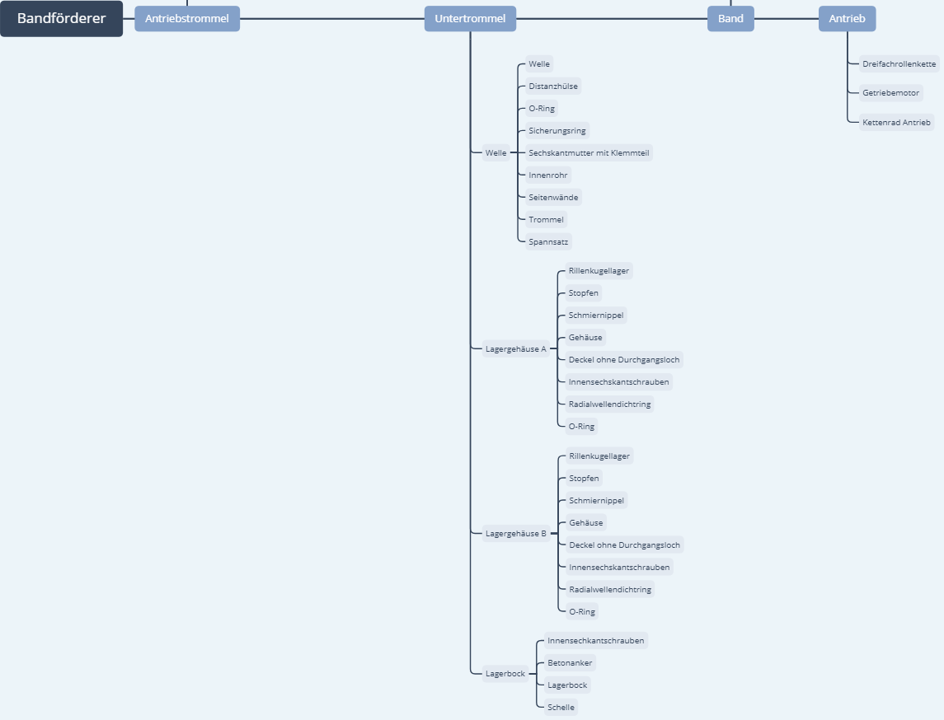
[picture p174: figure]
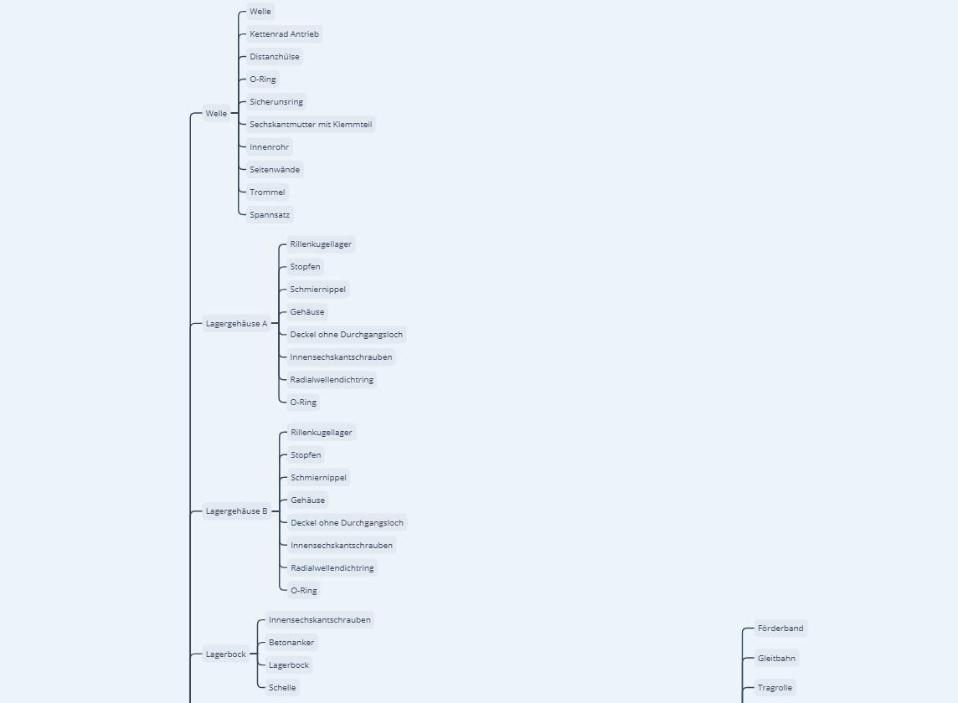
[picture p175: figure]
