MattdewT/KE3/RB-Blessing/FMEA/Funktionen_Fehler_Strukturanalyse.png

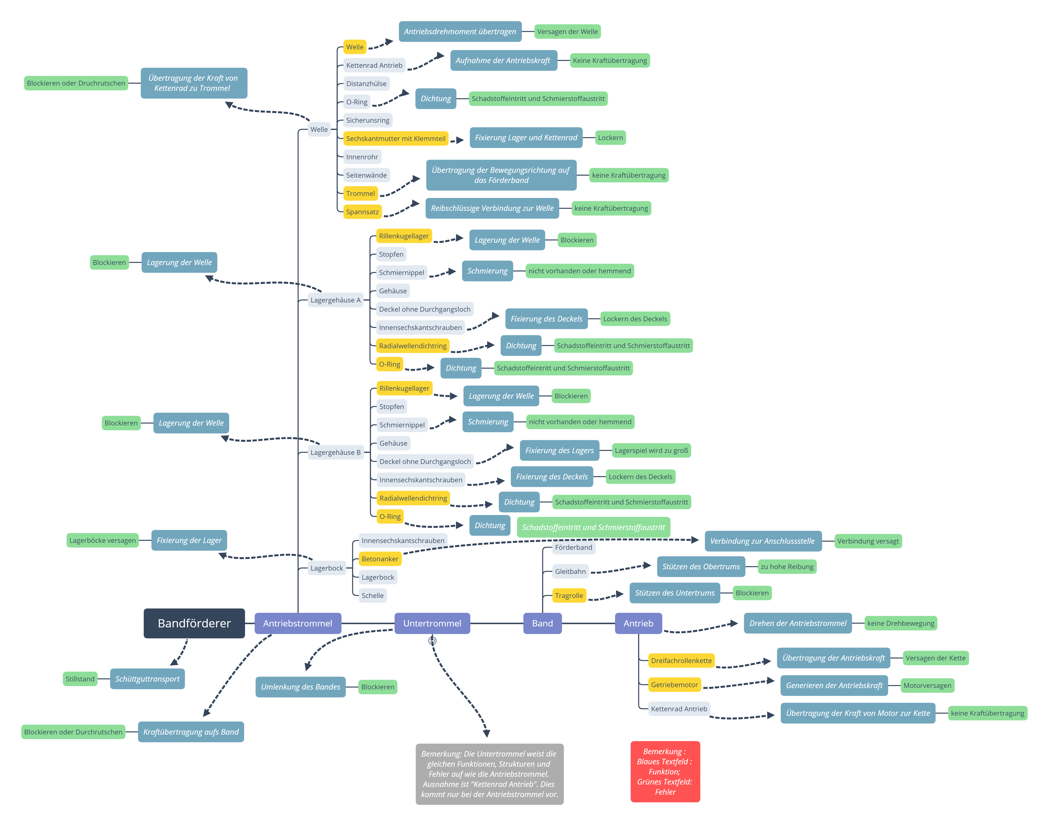
RB-Blessing/FMEA/Funktionen_Fehler_Strukturanalyse.png
