MattdewT/KE3/CAD_für Montageanleitung abgeändert/Kaufteile/Moter NORD Abmessungen.pdf

T

70

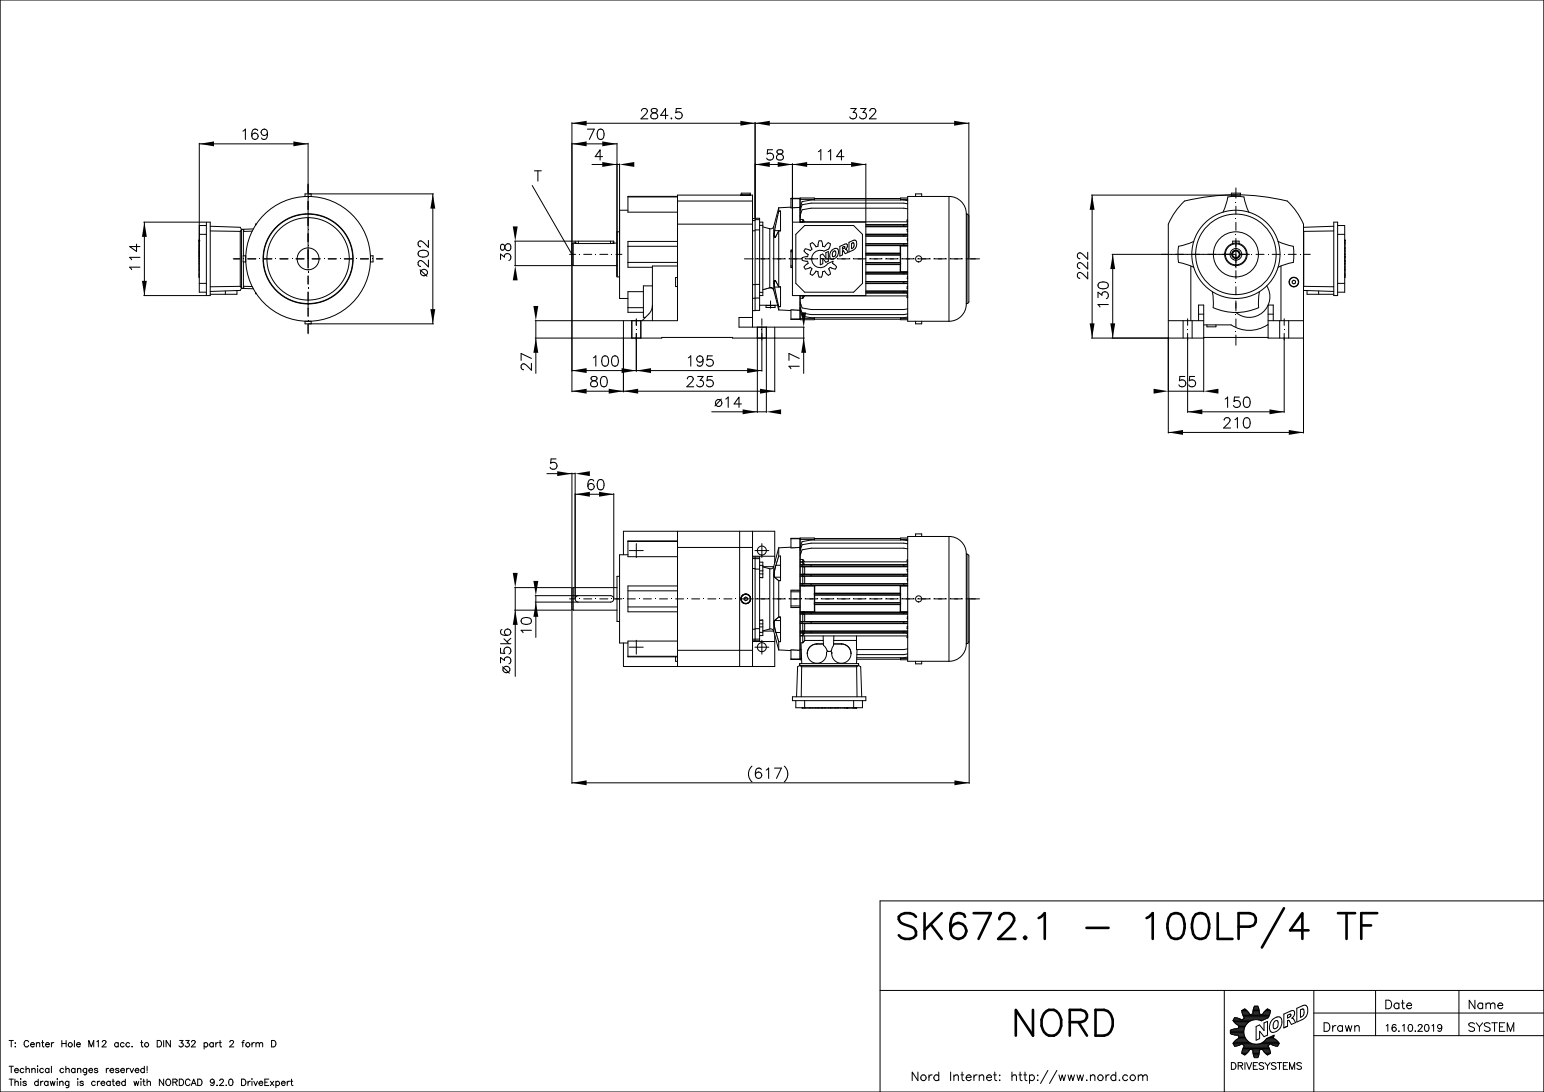
[picture p177: page 1]
NORD; Nord Internet: http://www.nord.com; DRIVESYSTEMS; Date; Name; Drawn; SYSTEM

T: Center Hole M12 acc. to DIN 332 part 2 form D

Technical changes reserved!
This drawing is created with NORDCAD 9.2.0 DriveExpert
