MattdewT/KE3/RB-Blessing/h.pdf

Antriebstrommellagerung eines Bandförderes | Paarweiser Vergleich von (Kunden-) Anforderungen

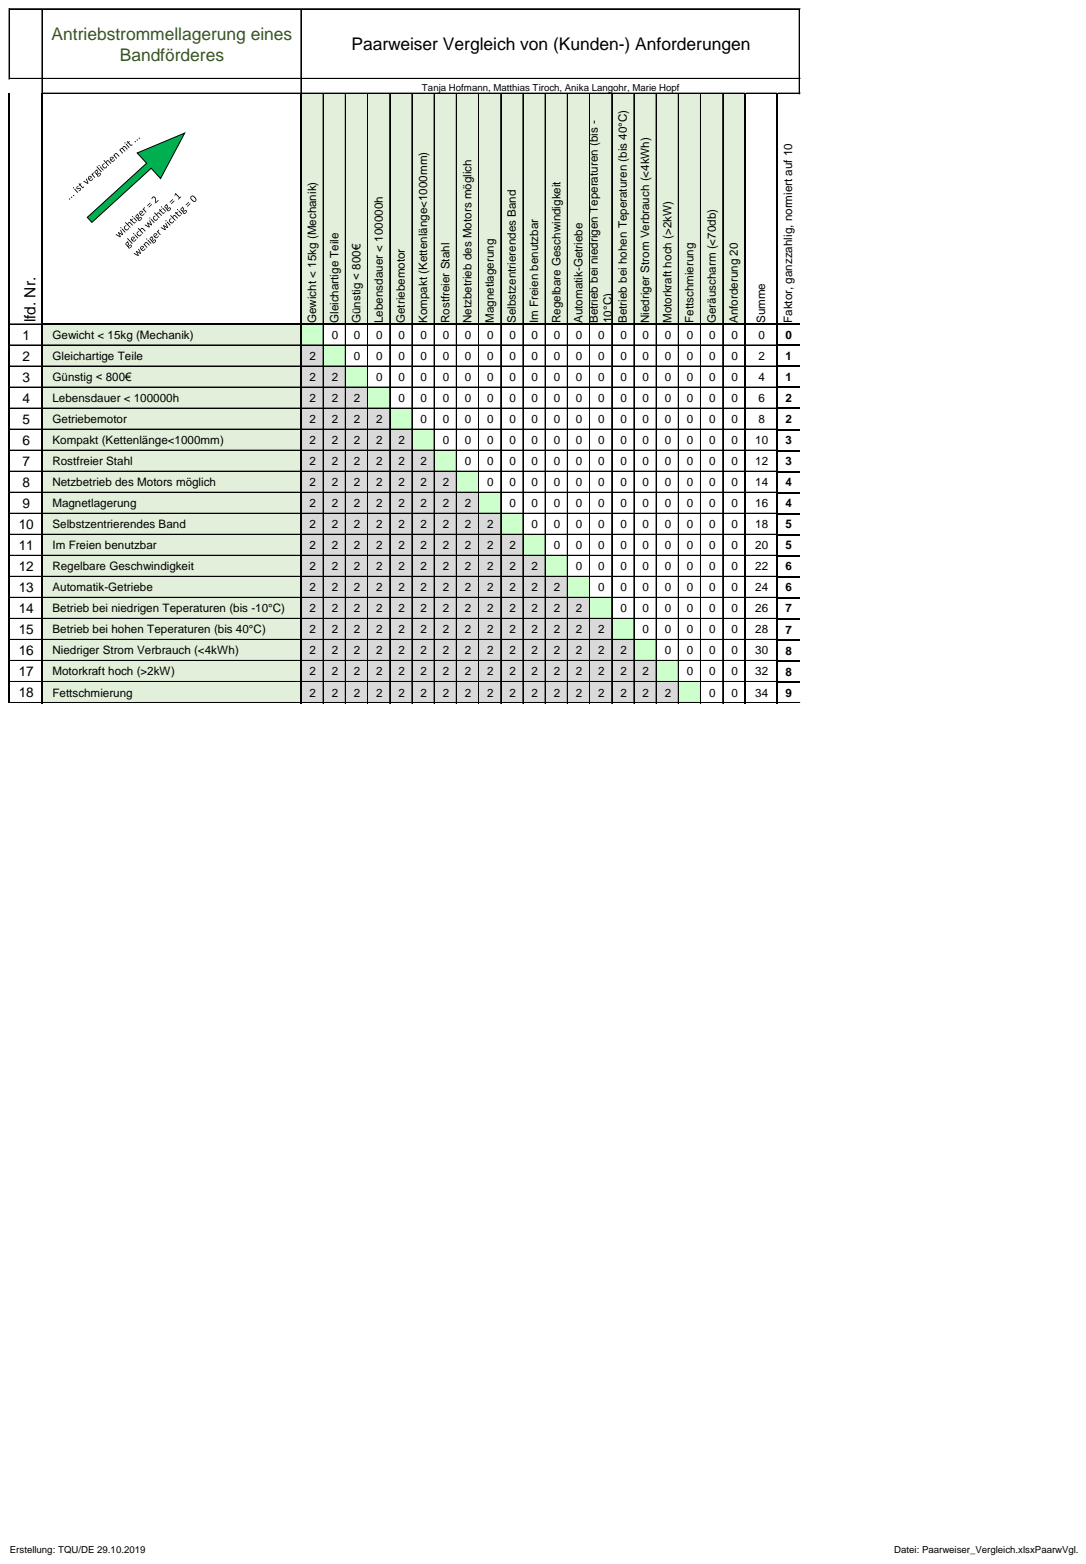
[picture p179: page 1]
lfd. Nr.; Gewicht < 15kg (Mechanik); Gleichartige Teile; Günstig < 800€; Lebensdauer < 100000h; Getriebemotor; Kompakt (Kettenlänge<1000mm); Rostfreier Stahl; Magnetlagerung; Selbstzentrierendes Band; Regelbare Geschwindigkeit; Automatik-Getriebe; Motorkraft hoch (>2kW); Fettschmierung; Geräuscharm (<70db); Anforderung 20; Summe; Netzbetrieb des Motors möglich; Im Freien benutzbar; Betrieb bei niedrigen Teperaturen (bis -10°C); Betrieb bei hohen Teperaturen (bis 40°C)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

Tanja Hofmann, Matthias Tiroch, Anika Langohr, Marie Hopf

Betrieb bei hohen Teperaturen (bis 40°C)

Betrieb bei niedrigen Teperaturen (bis -

Niedriger Strom Verbrauch (<4kWh)

Faktor, ganzzahlig, normiert auf 10

Netzbetrieb des Motors möglich

Im Freien benutzbar
