MattdewT/KE3/RB-Blessing/FMEA/Strukturanalyse.pdf

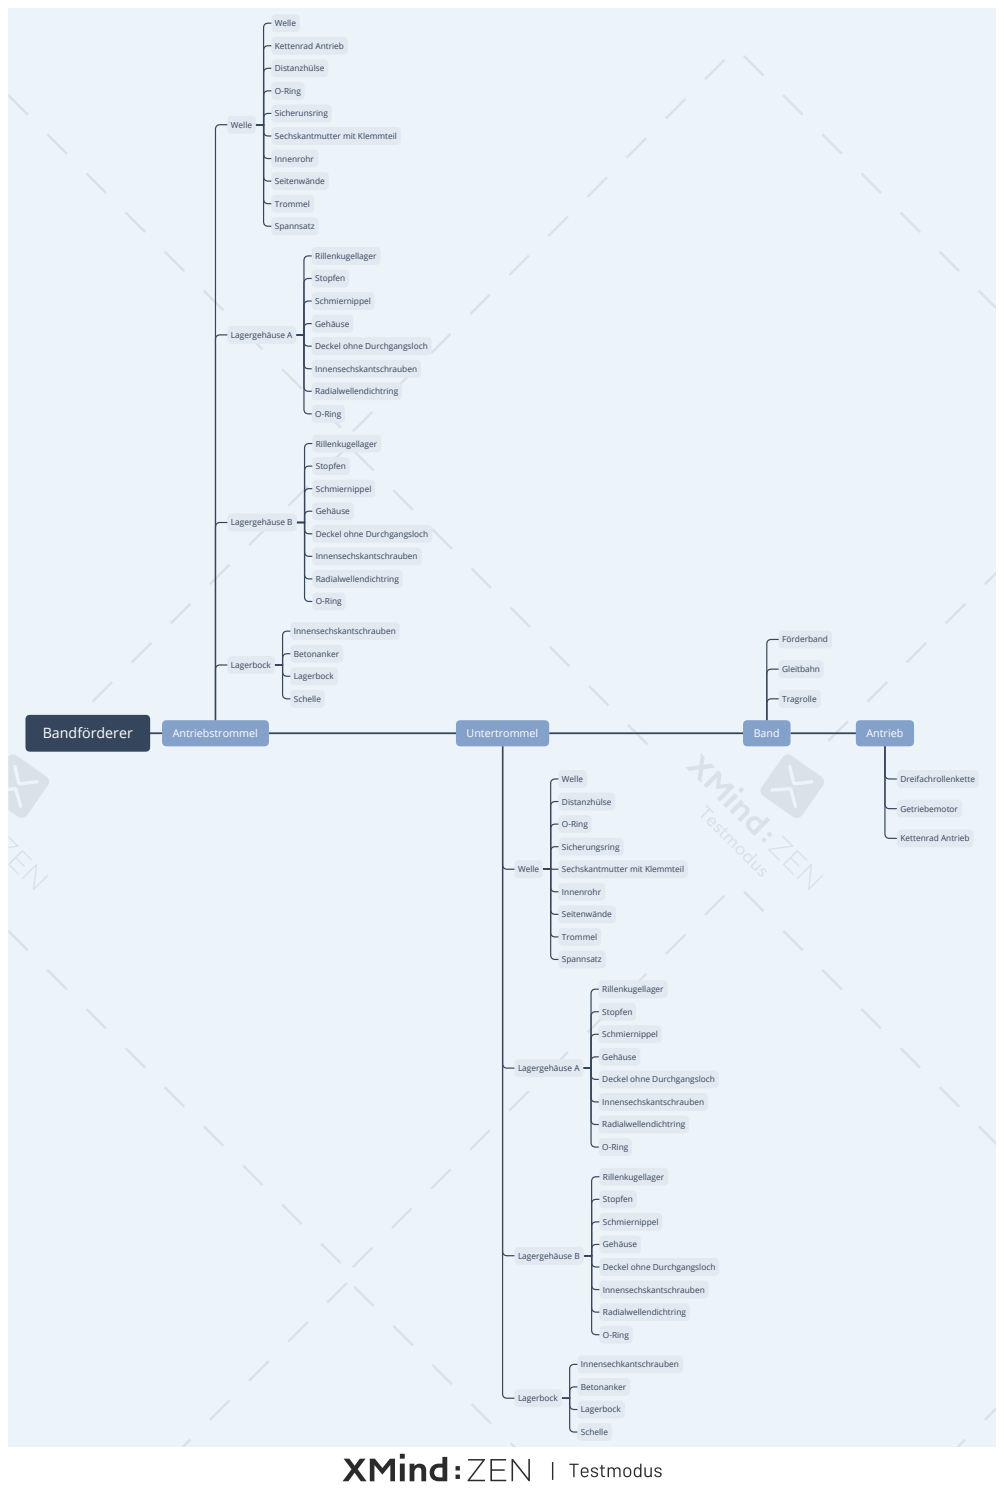
[picture p181: page 1]
Bandförderer; Antriebstrommel; Untertrommel; Band; Antrieb; Welle; Lagergehäuse A; Lagergehäuse B; Lagerbock; Kettenrad Antrieb; Distanzhülse; O-Ring; Sicherunsring; Innenrohr; Seitenwände; Trommel; Spannsatz; Rillenkugellager; Stopfen; Schmiernippel; Gehäuse; Innensechskantschrauben; Radialwellendichtring; Betonanker; Schelle; Sicherungsring; Innensechkantschrauben; Förderband; Gleitbahn; Tragrolle; Dreifachrollenkette; Getriebemotor

Sechskantmutter mit Klemmteil

Deckel ohne Durchgangsloch
