MattdewT/KE3/test.pdf

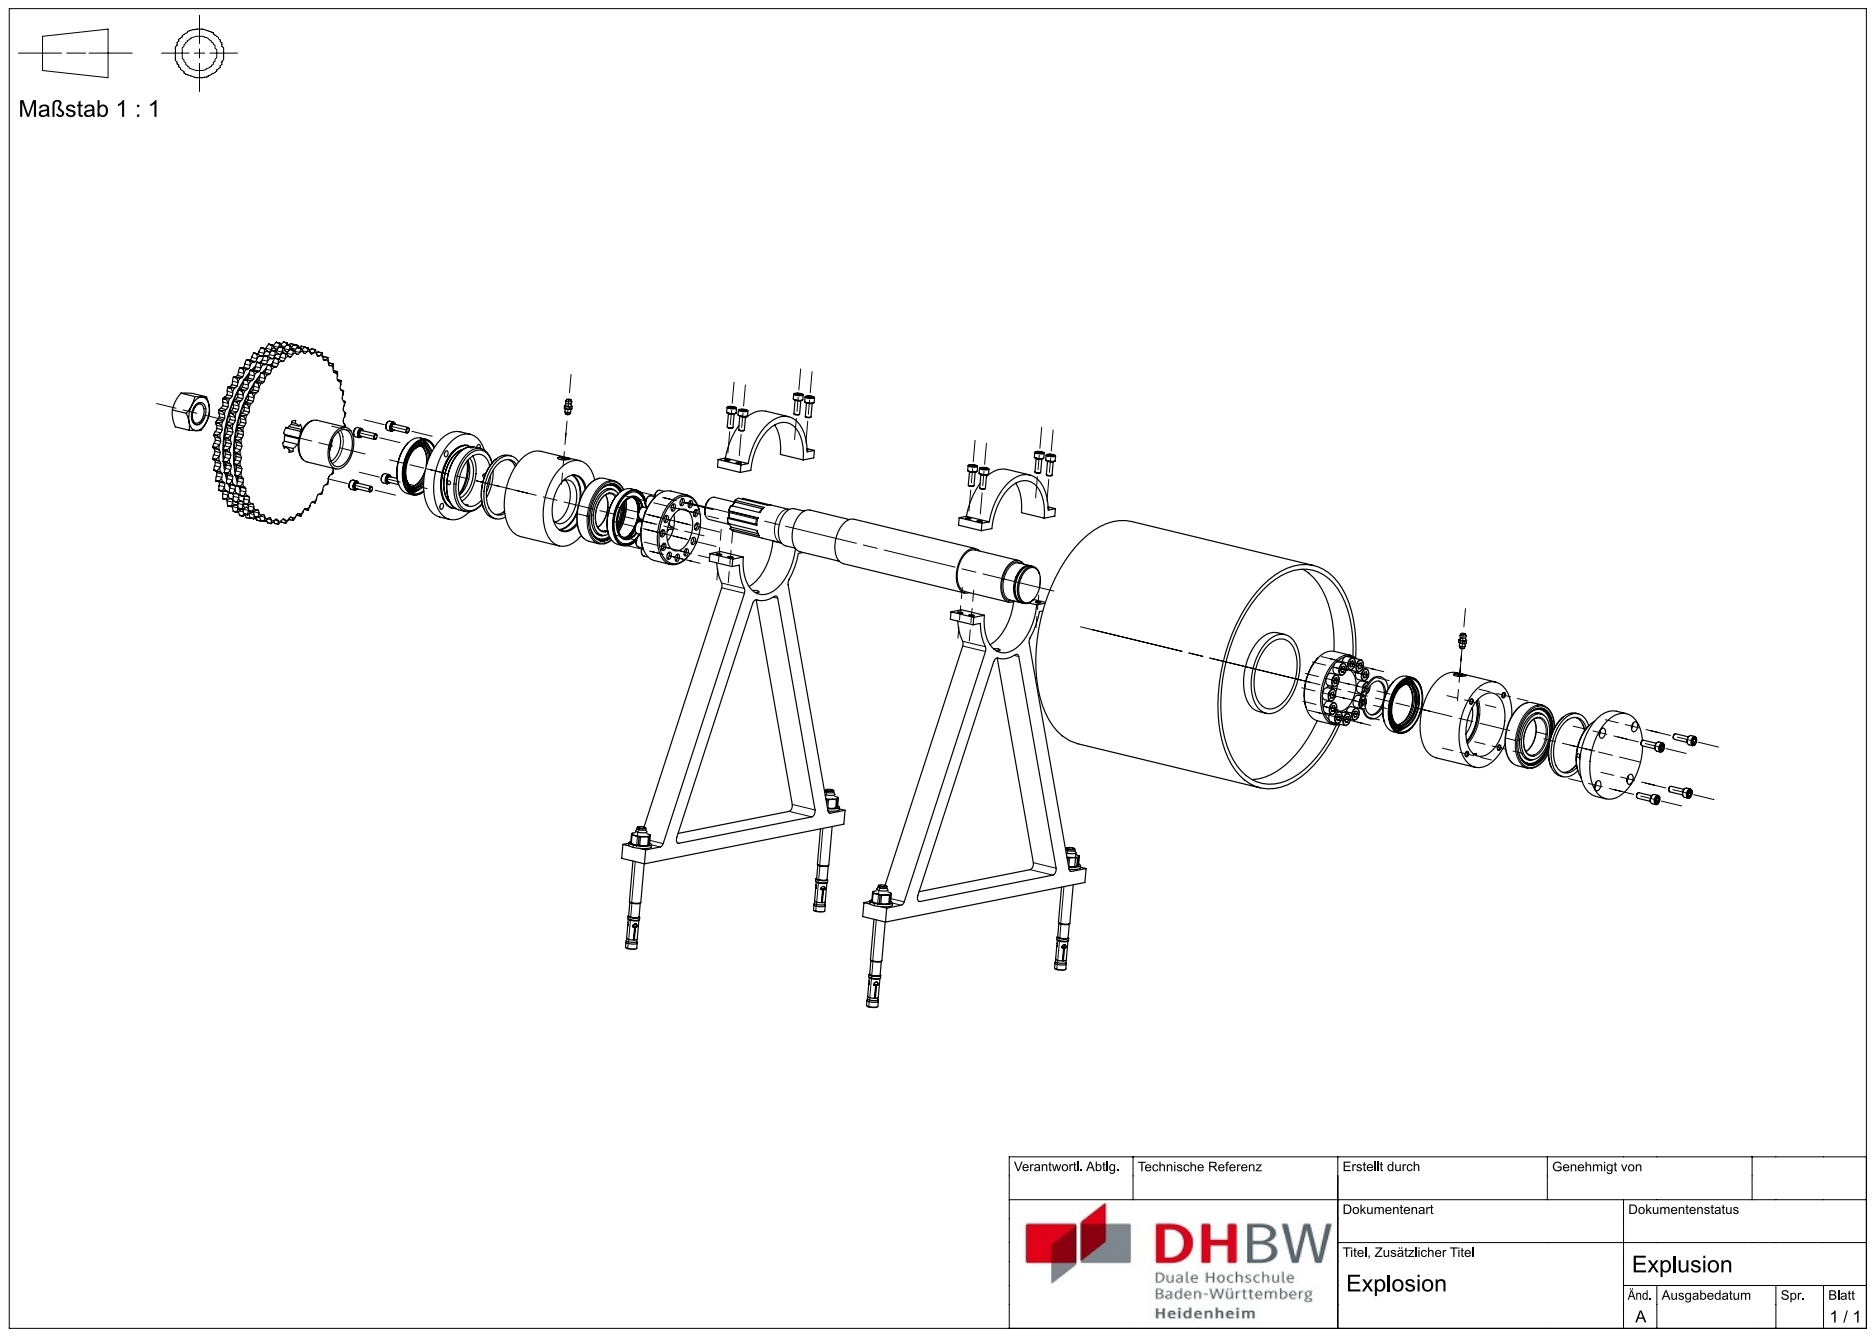
[picture p182: page 1]
