MattdewT/KE3/tirochm.tmb18_Antriebstrommel_BG.pdf

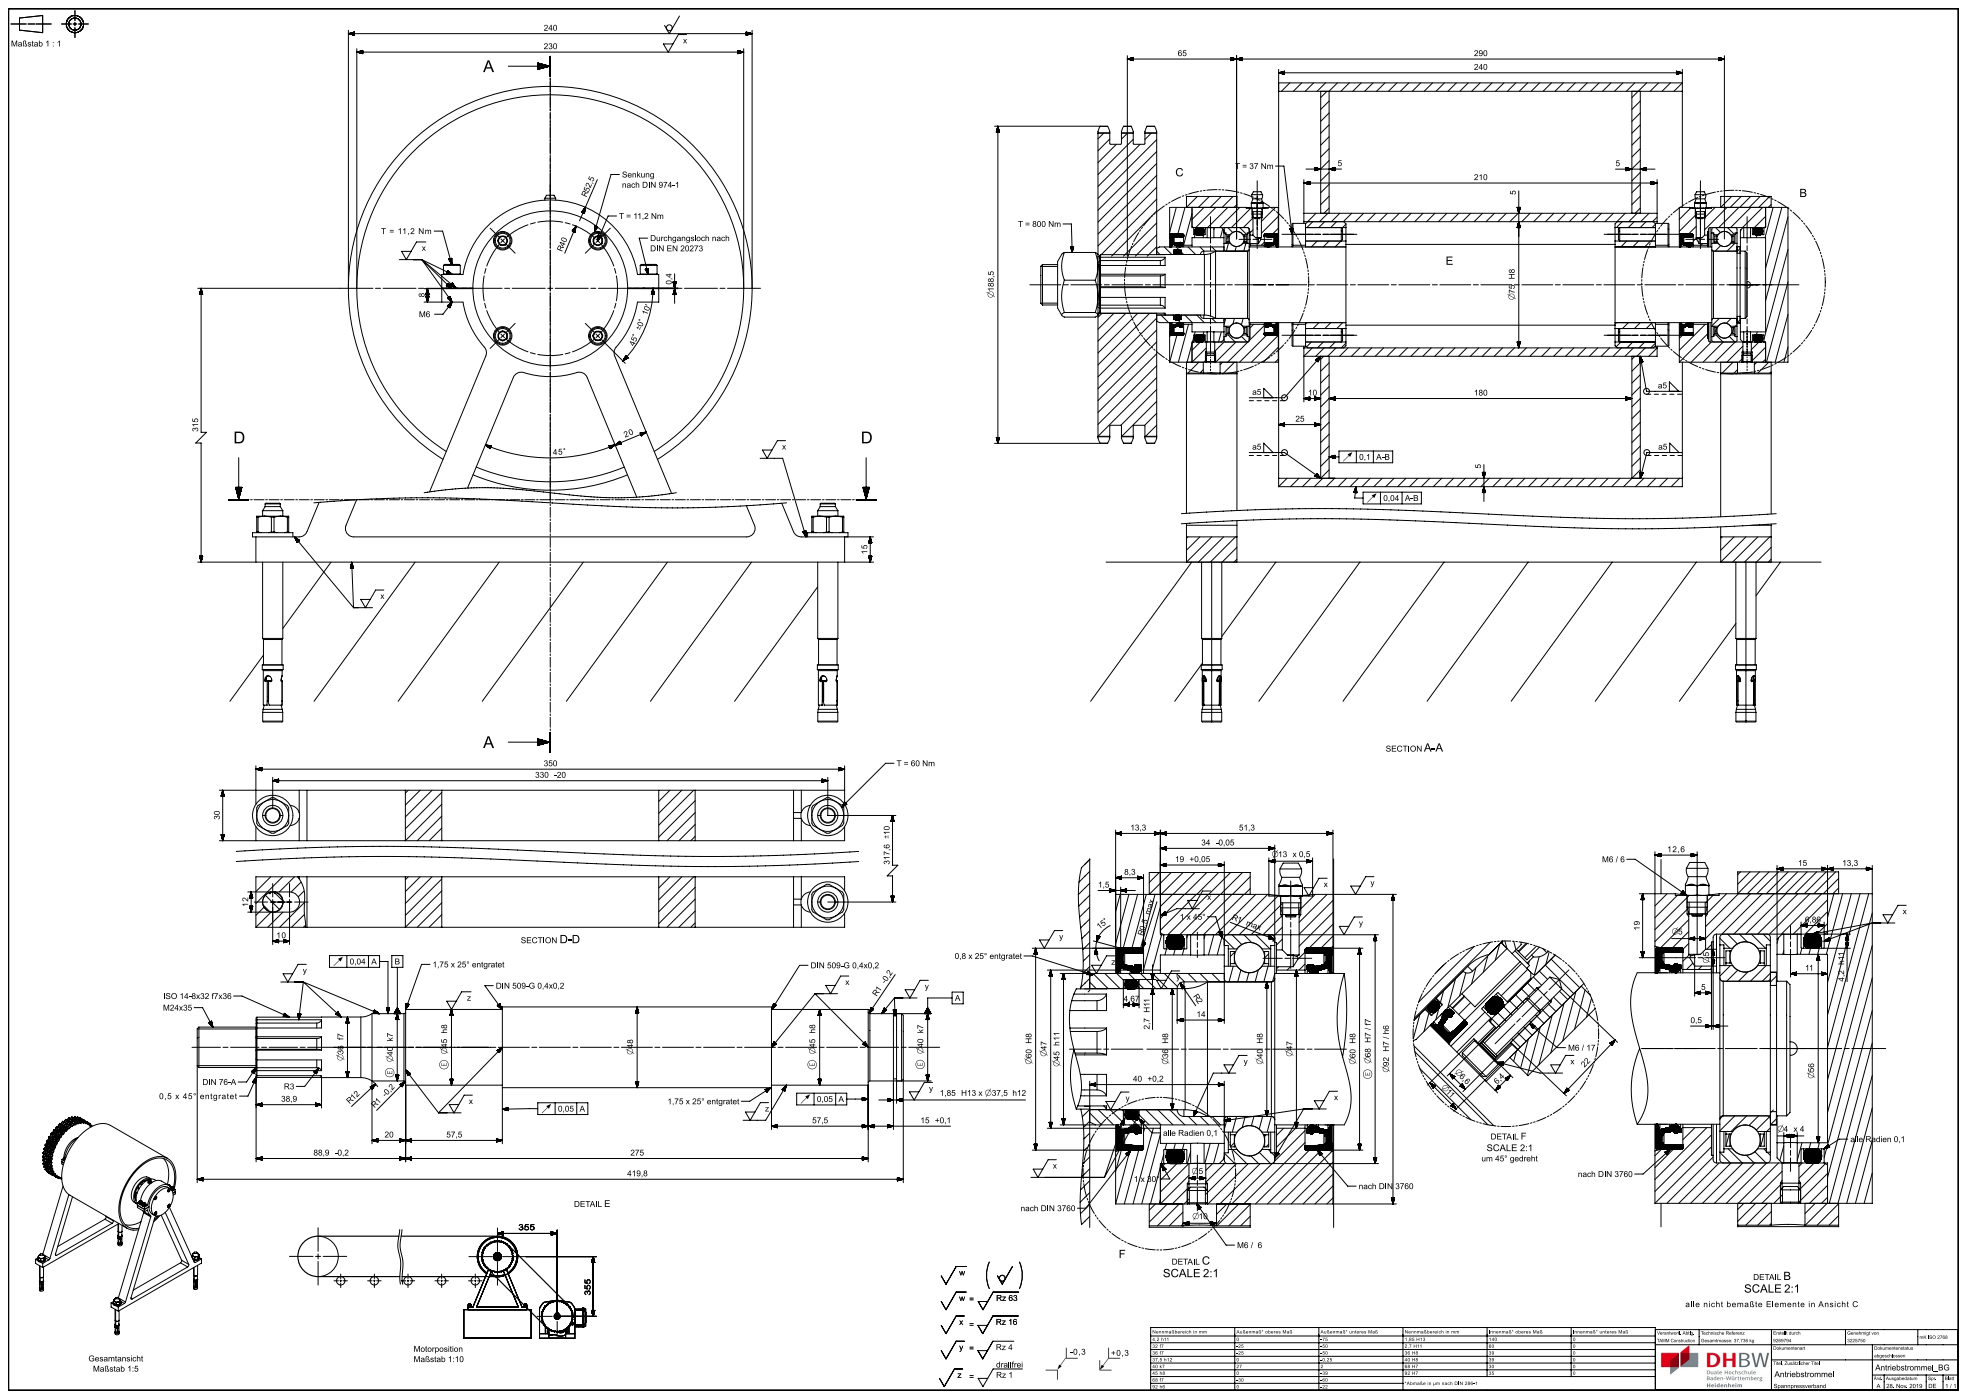
[picture p183: page 1]
