MattdewT/KE3/Finale/CD/7Schweißkonstruktion_Änderungen.pdf

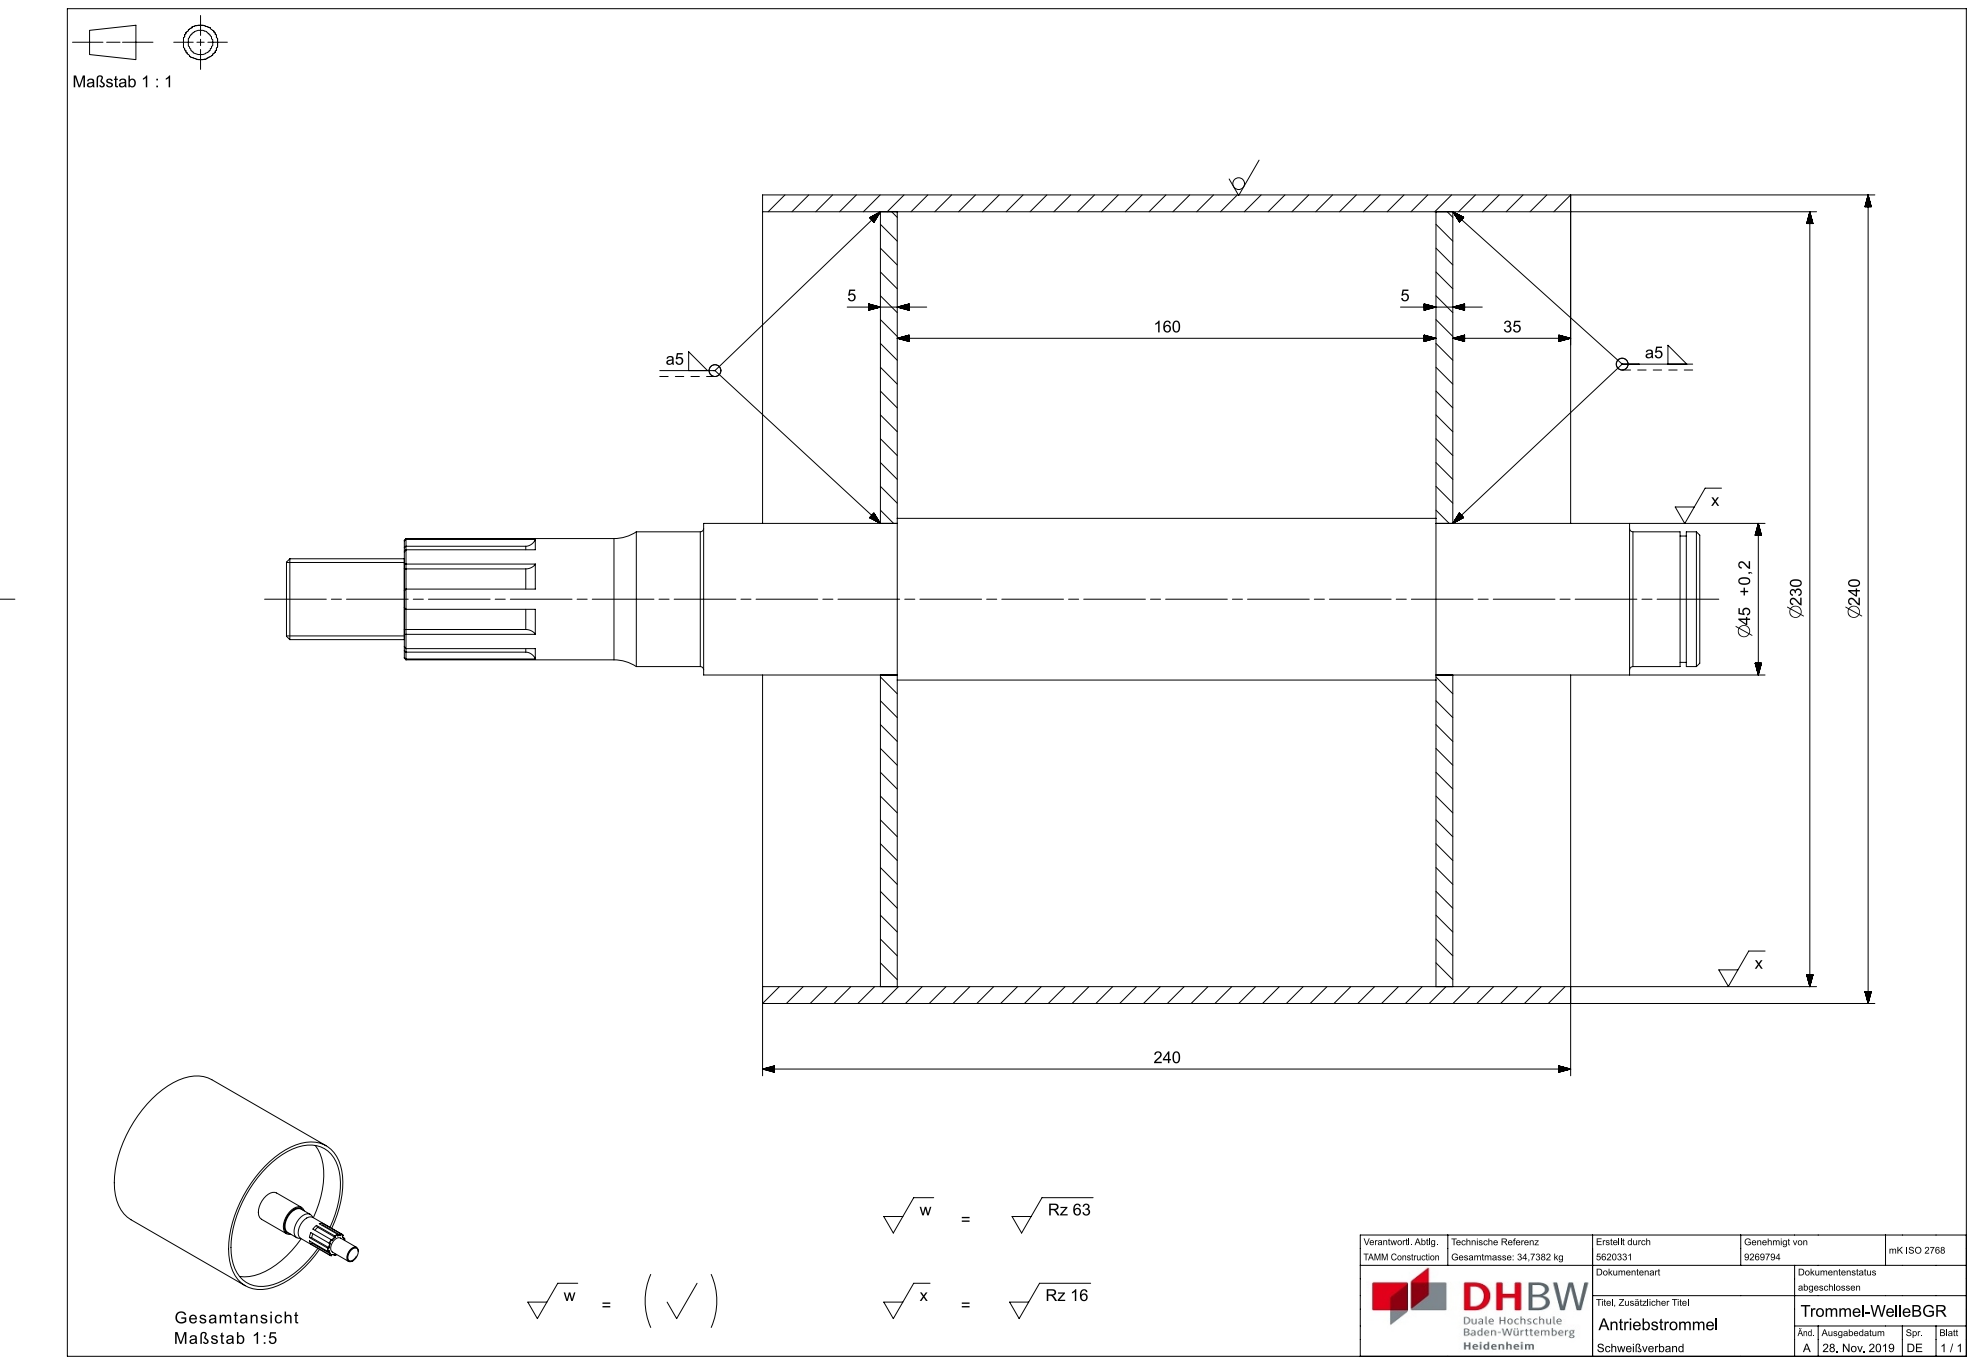
[picture p184: page 1]
