MattdewT/KE3/Finale/CD/7Explosionszeichnung.pdf

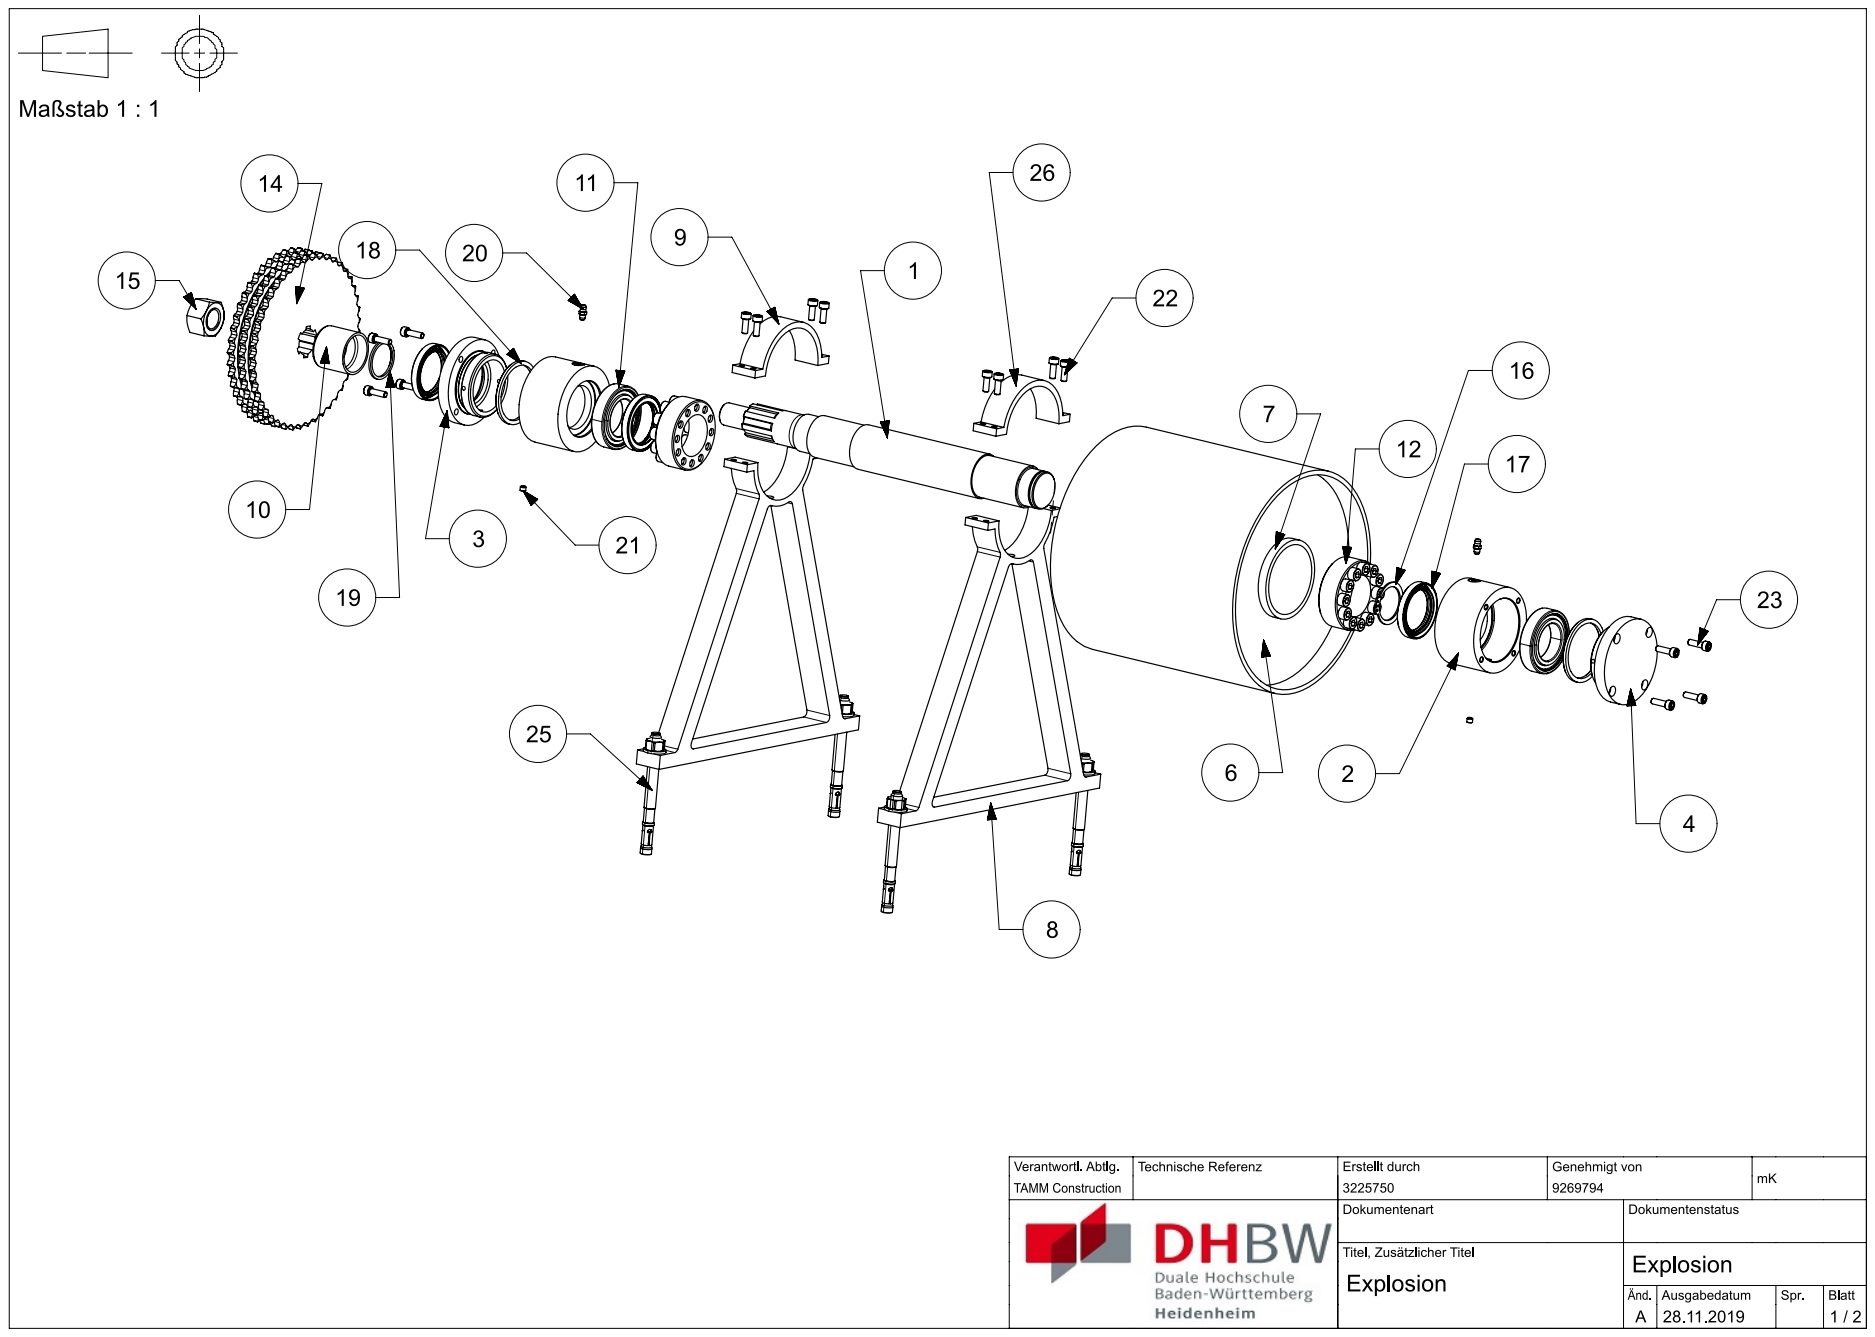
[picture p185: page 1]
