MattdewT/KE3/Finale/CD/7CAD-Gesamtzeichnung-Spannpressverband.pdf

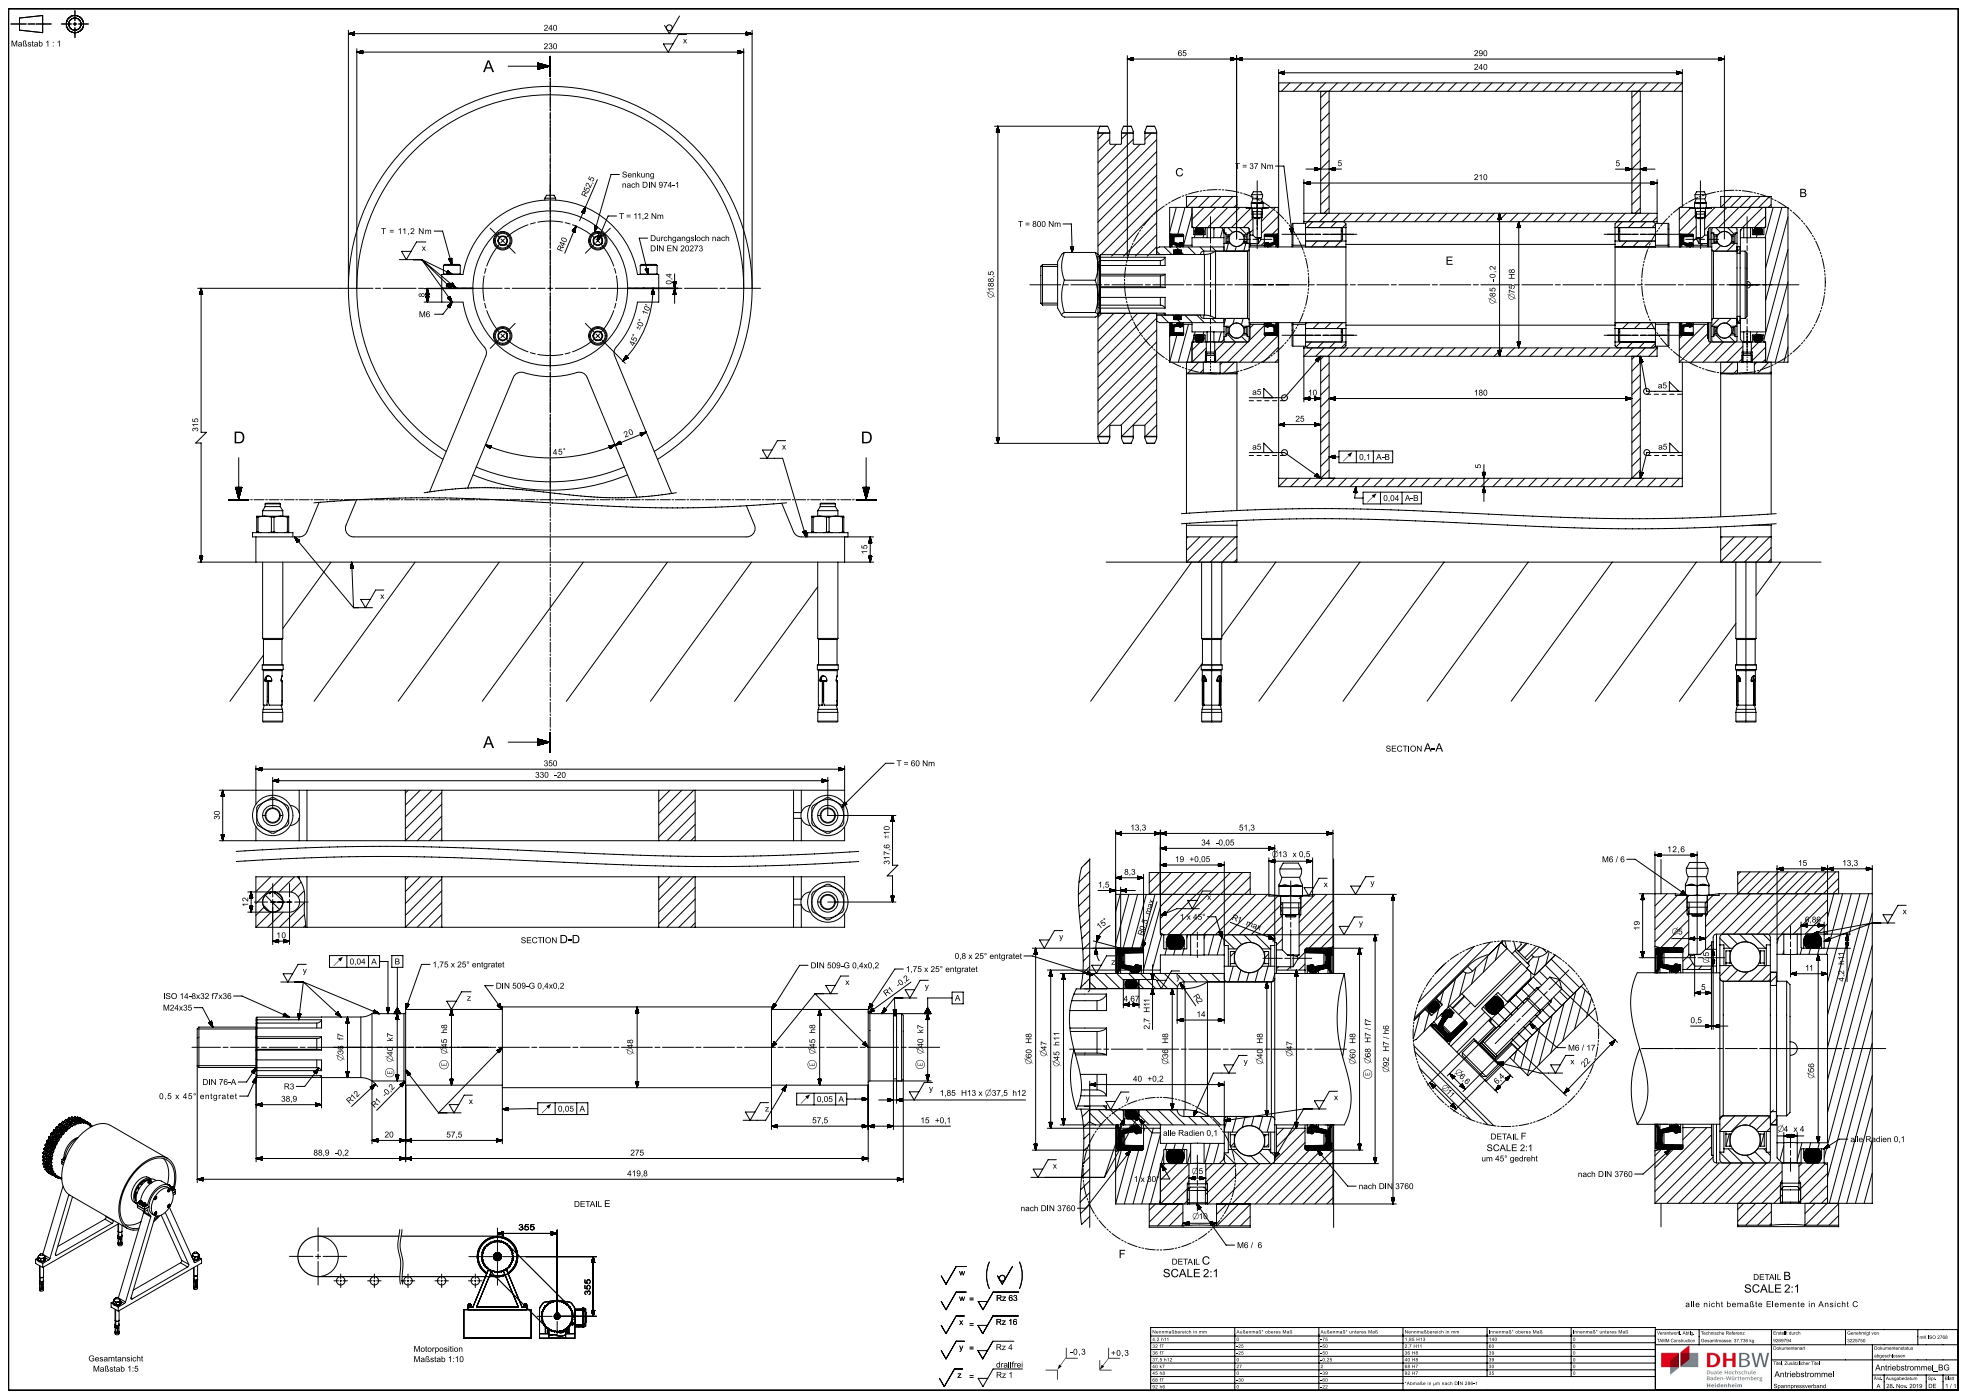
[picture p186: page 1]
