MattdewT/KE3/(commit log)

2019-10-10 Word-Dokument hochgeladen (Vorschlag Gliederung)
    Das hatte ich letzte Woche gemacht, bevor ich all die anderen Sachen gesehen hatte, könnt ja mal reingucken und sagen ob ihr Anforderungen - Berechnungen - Erläuterungen oder diese Variante als Gliederung besser findet.
2019-10-11 Berechnung Lager und Keilwelle hochgeladen
2019-10-15 Auslegung des Kettentriebs hochgeladen
2019-10-16 Elektromotor CAD-Daten + Datenblätter hochgeladen
    [Elektromotor SEW.stp, Motor NORD.stp]
2019-10-16 CAD Welle und Zeitplan
    [Projektplan_Wochentage.xlsx, Welle_1.prt]
2019-10-16 Keilwellengröße geändert und Gliederung aktualisiert
2019-10-19 Anforderungsliste angelegt und Zusammenfassung der Berechnungsergebnisse
    [Anforderungsliste.xlsx]
2019-10-21 Korrektur Durchmesser 43mm auf 45mm
2019-10-22 Berechnung des Durchmessers
2019-10-22 Anforderungsliste aktualisiert
    [Anforderungsliste.xlsx]
2019-10-24 Lagerkraftberechnung eingefügt und Grafiken
2019-10-24 Neue Welle
    [Welle_1.prt, Welle_2.prt]
2019-10-25 Lager CAD Teile
    [Lager.prt, lagergehaeuse.prt]
2019-10-25 Kugellager 6008 hinzugefügt
    [Lager.prt]
2019-10-25 grober Entwurf des Lagers fertig
    [Lagerdeckel.prt, Lagergehaeuse_BG.prt, Radial-Wellendichtring DIN 3760 AS 40x55x8.prt, lagergehaeuse.prt]
2019-10-25 Lagergehäuse
    Radialdichtring Fasen und Verrundungen
    Fettschmierung (Zu und Ablauf)
    [714125110060000 DIN 71412 A AM6SW7 Kegelschmiernippel.prt, Lagerdeckel.prt, Lagergehaeuse_BG.prt, lagergehaeuse.prt]
2019-10-28 Vorzeichenfehler bei der Lagerberechung behoben
2019-10-29 Teile erstellt
    [Trommel_Rohr.prt, Trommel_Seitenwand_Variante A.prt]
2019-10-29 Grafiken Powerpoint hochgeladen
2019-10-29 Massenanalyse durchgeführt
    [Trommel-WelleBGR.prt, Trommel_Rohr.prt, Trommel_Seitenwand_Variante A.prt, Welle_2.prt]
2019-10-29 Projektzeiplan erstellen
    [Projektzeitplan.xlsx]
2019-10-29 Biegemoment VZ korrigiert und Torsionsmomentenverlauf erstellt
2019-10-29 Lagergehäuse
    O-Ring Nut hinzugefügt
    verschraubungen
    [D0912620.prt, Lagerdeckel.prt, Lagergehaeuse_BG.prt, lagergehaeuse.prt]
2019-10-29 Welle vervollständigt
    [Trommel-WelleBGR.prt, Welle_2.prt]
2019-10-29 minor tweaks
    [Lagergehaeuse_BG.prt]
2019-10-29 Lager und Antriebsrolle
    Gesamtbaugruppe erstellt
    Radialdichtringe vergrößert
    [Antriebstrommel_BG.prt, Lagerdeckel.prt, Lagergehaeuse_BG.prt, Radial-Wellendichtring DIN 3760 A 45x60x8.prt, lagergehaeuse.prt]
2019-10-29 verschieden Konstruktionsanpassungen
    Lagerdeckeldurchlassradius vergrößert
    Dichtringart gewechselt
    [Antriebstrommel_BG.prt, Lagerdeckel.prt, Lagergehaeuse_BG.prt, Radial-Wellendichtring DIN 3760 A 45x60x8.prt, Radial-Wellendichtring DIN 3760 AS 40x55x8.prt, Radial-Wellendichtring DIN 3760 AS 45x60x8.prt, lagergehaeuse.prt]
2019-10-29 Trommel-Seitenwand, Trommel-Zusatzrohr und Baugruppe Variante B
    [Trommel-Welle_B_BGR.prt, Trommel_Seitenwand_Variante B.prt, Trommel_Zusatzrohr_Variante B.prt]
2019-10-29 Welle_2
    160mm
    [Welle_2.prt]
2019-10-29 Trommel-Welle Baugruppe Variante B, Zusatzrohr 20 mm kürzer
    [Trommel-Welle_BGR_Variante B (neu).prt, Trommel_Zusatzrohr_Variante B.prt]
2019-10-29 Variante B und Kaufteil Spannsatz
    [1.prt, 10.prt, 11.prt, 12.prt, 13.prt, 14.prt, 15.prt, 16.prt]
2019-10-29 Paarweiser Vergleich
    [Anforderungsliste.xlsx, Paarweiser_Vergleich.xlsx]
2019-10-29 Erläuterungen ergänzt und gedrehter Motor
2019-10-29 Lagergehäuse befestigung
    [Antriebstrommel_BG.prt, Lagergehaeuse-Befestigung_Oberteil.prt, Lagergehaeuse_BG.prt]
2019-10-29 zweites Lager hinzugefügt
    [Antriebstrommel_BG.prt, Lagergehaeuse_BG.prt, Trommel-WelleBGR.prt]
2019-10-29 Sehr doofe Fehler im Projektbericht bereinigt und Excel-Berechnung erstellt
    [Lagerkraft und Biegemoment.xlsm]
2019-10-30 Spannungsberechnung programmiert
    [Lagerkraft und Biegemoment.xlsm]
2019-11-03 Kerbzahlberechnung angefangen und Druckversion der Exceldatei erstellt
    [Lagerkraft und Biegemoment.xlsm]
2019-11-04 Farbe hinzugefügt und Kerbzahlen fast abgeschlossen
    [Lagerkraft und Biegemoment.xlsm]
2019-11-05 Loslager - Festlager
    [Antriebstrommel_BG.prt, Lagerdeckel_A.prt, Lagerdeckel_B.prt, Lagergehaeuse_A_BG.prt, Lagergehaeuse_BG.prt, Lagergehaeuse_B_BG.prt, lagergehaeuse.prt]
2019-11-05 Welle B (Spannsatz) verbaut
    Der Spannsatz braucht die meiste größte, deswegen wird alle folgende Teile mit Welle B entwickelt
    [Antriebstrommel_BG.prt, Trommel-Welle_BGR_Variante B (neu).prt]
2019-11-05 Senkung für die Schmiernippel
    [Antriebstrommel_BG.prt, Lagerdeckel_A.prt, Lagerdeckel_B.prt, Lagergehaeuse_A_BG.prt, Lagergehaeuse_B_BG.prt, lagergehaeuse.prt]
2019-11-05 Aufgeräumt, Kaufteile hinzugefügt und Berechnungsdatei
    Falschen Elektromotor rausgeschmissen, Datenblatt und CAD für Kettenrad hinzugefügt, Sicherungsmutter CAD, Projektbericht zur Sicherungsmutter, Dauerbruchberechnung erweitert
    [Elektromotor SEW.stp, Elektromotor SEW_stp.prt, Kettenrad.stp, Lagerkraft und Biegemoment.xlsm, WUERTH 036924 Sechskantmutter DIN 980 V M24 8 A2K_ST.prt]
2019-11-05 Lagerabstand berichtigt
    55 zu 57.5mm
    Lagerabstand vorher: 285mm
    nachher: 290 mm
    [Welle_2.prt]
2019-11-05 Kettenrad .prt und Keilwellenlänge angepasst
    [Kettenrad.prt, Kettenrad.stp, Welle_2.prt]
2019-11-05 Keilnabe in Kettenrad
    [Kettenrad.prt]
2019-11-05 Kettenrad hinzugefügt
    [Antriebstrommel_BG.prt]
2019-11-05 Keilwelle verkürzt
    Keilwelle vorher: 49.9
    nacher 48.9
    um genügend Spiel für die Klemmmutter zu schaffen
    [Welle_2.prt]
2019-11-05 O-Ring erstellt
    [O-Ring Lagerdeckel.prt]
2019-11-05 Deckelerläuterungen, Grafiken auf neue Maße angepasst
    Grafiken im Projektbericht sind noch nicht aktuell!
    [Lagerkraft und Biegemoment.xlsm]
2019-11-05 Distanzhülse hinzugefügt
    Änderung in der Welle revertiert
    [Antriebstrommel_BG.prt, Distanzhuelse.prt, Welle_2.prt]
2019-11-05 Klemmmutter hinzugefügt und Konstruktionelemente ausgeblendet
    [Antriebstrommel_BG.prt, Kettenrad.prt, Lagergehaeuse_A_BG.prt, Lagergehaeuse_B_BG.prt]
2019-11-06 Paarweiser Vergleich und Berechnung mit Excel getestet
    [Lagerkraft und Biegemoment.xlsm, Paarweiser_Vergleich.xlsx]
2019-11-06 Komplette Antriebstrommel gerettet
    [Antriebstrommel_BG.prt]
2019-11-06 Update Exceldatei
    [Lagerkraft und Biegemoment.xlsm]
2019-11-06 Betonanker Zukaufteil
    [FAZ_II_10_10_94981_1.stp]
2019-11-06 Projektbericht neue Maße der Welle in Berechnung übernommen
2019-11-06 CAD Datei Bolzenanker
    [Bolzenanker.prt]
2019-11-06 Lagerbock
    Lagerbock Ober- und Unterteil erstellt und zusammen mit 4 Zylinderschrauben M6x16 und 2 Betonbolzen in der Baugruppe "Lagerbock_BGR" zusammengefügt
    [Antriebstrommel_BG.prt, Lagerbock_BGR.prt, Lagerbock_Oberteil.prt, Lagerbock_Unterteil.prt, Schraube_M6x16.prt]
2019-11-06 Oring Lager A
    [Lagergehaeuse_A_BG.prt, O-Ring Lagerdeckel.prt]
2019-11-06 Oring Lager B
    [Lagergehaeuse_B_BG.prt]
2019-11-06 Oring Distanzhuelse
    [Distanzhuelse.prt, O-Ring Huelse.prt]
2019-11-06 Lagerbock_BGR in Antriebstrommel_BG eingebaut
    [Antriebstrommel_BG.prt, Lagerbock_BGR.prt]
2019-11-06 Sicherungsring in Antriebstrommel_BG eingebaut
    [Antriebstrommel_BG.prt, Lagergehaeuse_B_BG.prt, S-Ring_DIN471_61744000_Federstahl.prt]
2019-11-06 Welle: Keilwellengröße- und Länge geändert
    Auswirkungen auf O-Ring, Distanzhülse
    [Welle_2.prt]
2019-11-06 Kettenrad an neuen Wellendurchmesser angepasst
    [Kettenrad.prt]
2019-11-06 Neues Kettenrad eingebaut und Bedingungen angepasst
    [Antriebstrommel_BG.prt, Lagergehaeuse_B_BG.prt]
2019-11-06 Distanzhuelse an Welle angepasst
    [Distanzhuelse.prt, O-Ring Huelse.prt]
2019-11-06 Einfügen der Bolzenanker
2019-11-06 Zeichnung Anfang B
    [Antriebstrommel_BG.prt]
2019-11-06 Lagerverrundung und Klemmgewinde
    [Lagergehaeuse_A_BG.prt, Lagergehaeuse_B_BG.prt, Welle_2.prt, lagergehaeuse.prt]
2019-11-06 Zeichnung Lager angefangen
    [Antriebstrommel_BG.prt]
2019-11-07 Zeichnung Welle
    [Antriebstrommel_BG.prt, Welle_2.prt]
2019-11-08 Excelprogramm aktualisiert, verbessert
    Wp und Wb waren vertauscht, statische Sicherheiten rausgelöscht
    [Lagerkraft und Biegemoment-Version2.xlsm, Lagerkraft und Biegemoment.xlsm]
2019-11-08 Lagerbock erhöht
    [Lagerbock_Unterteil.prt]
2019-11-08 Lagerbock in Gesamtzeichnung eingefügt
    [Lagerbock_BGR.prt]
2019-11-08 Lagerbock bemaßt und Normteilschnitte entfernt
2019-11-09 Excel-Programm für Smithdiagramm erstellt und Wellenberechnung mit Keilwellenspezifischen Widerstandsmoment versehen
    [Lagerkraft und Biegemoment-Version2.xlsm, Smithdiagramm.xlsm]
2019-11-10 Anwendungsfaktor auf 1,1 runtergesetzt
    Dadurch sinkt die Mittelspannung, und der Werkstoff 42CrMo4 ist ausreichen!!!!
    Ist nach Decker Tabelle zulässig
    [Lagerkraft und Biegemoment-Version2.xlsm, Smithdiagramm.xlsm]
2019-11-11 Wellenberechnung mit Smithdiagramm kombiniert
    [Wellenberechnung 42CrMo4.xlsm, Wellenberechnung E295.xlsm]
2019-11-11 Zeichnung Anbschlussmaße
    [Lagergehaeuse_A_BG.prt, Lagergehaeuse_B_BG.prt, Trommel-Welle_BGR_Variante B (neu).prt]
2019-11-12 Seitenwände weiter nach ihnen gesetzt
    [Trommel-Welle_BGR_Variante B (neu).prt]
2019-11-12 Dichtstopfen und Phase an Distanzhülse
    [Distanzhuelse.prt, lagergehaeuse.prt]
2019-11-12 Seitenwandabstand auf 180
    [Lagergehaeuse_A_BG.prt, Lagergehaeuse_B_BG.prt, Trommel-Welle_BGR_Variante B (neu).prt]
2019-11-12 Baugruppe mit Motor
    [Gesamt_Motor_BG.prt, Kettenrad_Motor.prt, Motor.prt]
2019-11-12 Zeichnung Motor Baugruppe
    [Gesamt_Motor_BG.prt]
2019-11-13 Stückliste erstellt, Konstruktionserläuterungen
    Toleranzerläuterung Deckel, Literaturverzeichnis, Stückliste für Spannpressverband
    [Stückliste Spannpressverband.xls, Wellenberechnung 42CrMo4.xlsm, Wellenberechnung E295.xlsm]
2019-11-14 Für Matthias
    [Gesamt_Motor_BG_2.prt]
2019-11-14 Datenblatt für Kaufteile, CAD Daten Gewindestift
    [WUERTH 025506 5 Gewindestift DIN 913 M6x5 45H A2K_ST.prt]
2019-11-14 Cad Esplosion
    [Explusion.prt]
2019-11-14 zeichnungsanpassung und gesamtzeichnung
    [Gesamt_Motor_BG_2.prt, Gesamtzeichnung_dwg.prt]
2019-11-14 Montageanleitung bearbeitet
    [1.prt, 10.prt, 11.prt, 12.prt, 13.prt, 14.prt, 15.prt, 16.prt]
2019-11-16 Ausbesserung Formzahlen
    Problem: wir haben die Formzahlen nach Din 743 berechnet aber den vereinfachten Rechenweg genommen
    [Wellenberechnung 42CrMo4.xlsm]
2019-11-16 Durchbiegung angefangen
    Noch sehr unvollständig
    [Wellenberechnung 42CrMo4.xlsm]
2019-11-17 Durchbiegung doch mit Decker-Arbeitsblatt realisiert
    [Durchbiegung mit Decker-Blatt.xlsm, Wellenberechnung 42CrMo4.xlsm]
2019-11-17 Anforderungsliste ergänzt, T-Tabelle mit Funktionen befüllt
    [Anforderungsliste.xlsx, Paarweiser_Vergleich.xlsx, T-Tabelle.xlsx]
2019-11-18 Kommentare zur Kettenschmierung und zu zulässigen Biegewinkeln ergänzt
2019-11-18 Formatierung Anforderungsliste und Paarweiser Vergleich
    [Anforderungsliste.xlsx, Paarweiser_Vergleich.xlsx]
2019-11-18 Kerbzahlen für E295 und 16NiCrS5
2019-11-18 Zeichnung korrigiert
    [Gesamt_Motor_BG.prt, Lagergehaeuse_A_BG.prt, Lagergehaeuse_B_BG.prt, lagergehaeuse.prt]
2019-11-18 Motorposition hinzugefügt
2019-11-18 Schriftkopf angepasst und Motorzeichnung hinzugefügt
    [Gesamt_Motor_BG_dwg.prt]
2019-11-19 RB und Datenblätter
    [HoQ.xlsx]
2019-11-20 House of Quality
    [HoQ.xlsx]
2019-11-20 Wellenberechnungen abgeschlossen, Kerbzahlen im Projektbericht
    [Wellenberechnung 16NiCrS5.xlsm, Wellenberechnung 42CrMo4.xlsm, Wellenberechnung E295.xlsm]
2019-11-20 Abmaßtabelle
    [Abmaßtabelle.xlsx]
2019-11-20 Schweißnaht hinzugefügt
    [Trommel-Welle_BGR_Variante B (neu).prt]
2019-11-20 Gewindestifte hinzugefügt
    [Lagergehaeuse_A_BG.prt, Lagergehaeuse_B_BG.prt]
2019-11-20 Vorlagen und Übungsbeispiele für RB
    [01_Vorlage_FMEA-Risikoanalyse.xlsx, 1_Vorlage_Anforderungsliste.xlsx, 2_Vorlage_Paarweiser_Vergleich.xlsx, 3_Vorlage_T-Tabelle.xlsx, 5_Vorlage-CE-Risikobeurteilung_leer.xlsx, 5_Vorlage_CE-Risikobeurteilung_leer.xlsx, 8_Vorlage_QFD_HoQ_PV.xlsx, btg_T_Tabelle.xlsx]
2019-11-20 Schraubenanzahl geändert und Motor hinzugefügt
    [Stückliste Spannpressverband.xls]
2019-11-20 Explosion neue Teile hinzugefügt
    [Explusion.prt]
2019-11-20 Gewindestifte erneut positioniert
    [Lagergehaeuse_A_BG.prt, Lagergehaeuse_B_BG.prt]
2019-11-20 Schweißnähte entfernt und Zeichnungskorrektur
    [Trommel-Welle_BGR_Variante B (neu).prt]
2019-11-20 Eplosion Gewindestift hinzugefügt
    [Explusion.prt]
2019-11-20 Datenblatt und CE
    [CE-Beurteilung.xlsx]
2019-11-20 Montageanleitung vervollständigt
    [Gesamt_Motor_BG_2.prt, Trommel-WelleBGR.prt]
2019-11-20 Materialien gesetzt und Zeichnungskorrektur
    Masse=37,736 kg
    [Distanzhuelse.prt, Lagergehaeuse_A_BG.prt, Lagergehaeuse_B_BG.prt, O-Ring Huelse.prt, O-Ring Lagerdeckel.prt, Radial-Wellendichtring DIN 3760 AS 45x60x8.prt]
2019-11-20 Kaufteildatenblätter reorganisiert und zusammengefügt
2019-11-20 Abmaßtabelle Fertig
    [Abmaßtabelle.xlsx]
2019-11-20 Zeichnung Schweißverbund erstellt
    [Trommel-WelleBGR.prt]
2019-11-20 Wellenberechnung druckfertig gemacht
    [Wellenberechnung 16NiCrS4.xlsm, Wellenberechnung 16NiCrS5.xlsm, Wellenberechnung 42CrMo4.xlsm, Wellenberechnung E295.xlsm]
2019-11-20 Bleck statt Vollmaterial für Seitenwände
    [Stückliste Spannpressverband.xls]
2019-11-20 Dokumentation der Risikobeurteilung
2019-11-20 Zeichnungskorrektur
    Schnitt F angepasst
    [Lagergehaeuse_A_BG.prt, Lagergehaeuse_B_BG.prt, lagergehaeuse.prt]
2019-11-20 Finale-Ordner erstellt, kleinere Änderungen
    [Anforderungsliste.xlsx, Projektzeitplan.xlsx, Stückliste Spannpressverband.xls]
2019-11-21 Kette und Riemen eingzeichnet + Passungstabelle
2019-11-21 Durchmesserangaben zu den Smithdiagrammen hinzugefügt
    [Wellenberechnung 16NiCrS4.xlsm, Wellenberechnung 42CrMo4.xlsm, Wellenberechnung E295.xlsm]
2019-11-22 CE-Bewertung erweitert / bearbeitet
    [CE-Beurteilung.xlsx]
2019-11-23 Dokumentation weitergeschrieben und veraltetes pdf gelöscht
2019-11-24 Nachrechnung Passfederverbindung des Motors
2019-11-24 Sortiert fürs Drucken und die CD
    [12Durchbiegung mit Decker-Blatt.xlsm, Smith-Diagramm_separat.xlsm, Wellenberechnung 16NiCrS4.xlsm, Wellenberechnung 42CrMo4.xlsm, Wellenberechnung E295.xlsm]
2019-11-25 FMEA fertig, Dokumentation weiter und CE-Beurteilung so gut wei abgeschlossen
    [CE-Beurteilung.xlsx, FMEA.xlsx]
2019-11-25 Morphologischer Kasten, Anforderungsliste im Projektbericht eingefügt
    [Anforderungsliste.xlsx, Projektzeitplan.xlsx]
2019-11-26 Anfang Bolzen und Korrektur Datenblatt
    80 1/min
2019-11-26 Temporär Dateien entfernt und Parallel Doku
2019-11-26 Rechtschreibüberprüfung und Firmenlogos eingefügt
    [Gedrehter Motor_Wellenberechnung 42CrMo4.xlsm]
2019-11-27 Explosions pdf
    [Explosion.prt]
2019-11-27 Schweißbaugruppe PDF
    [Trommel-WelleBGR.prt]
2019-11-27 Letzte Ergänzungen zum CD-Ordner
    [1.prt, 10.prt, 11.prt, 12.prt, 13.prt, 14.prt, 15.prt, 16.prt]
2019-11-29 Anforderungliste mit Kano und Doku mit HoQ
2019-11-29 CE Ergänzungen
    [CE-Beurteilung.xlsx]
2019-11-29 FMEA Pareto angpasst
    [FMEA.xlsx]
2019-11-29 T-Tabelle fertig
    [T-Tabelle.xlsx]
2019-11-29 CE fertig gestellt
    [CE-Beurteilung.xlsx]
2019-11-29 Pareto-Erläuterungen
    [FMEA.xlsx]
2019-11-29 FMEA: Rechtschreibfehler korrigiert, Warnsymbole herausgesucht
    [FMEA.xlsx]
2019-12-01 Umformatierungen für Druck
    [HoQ.xlsx, Ischikawa.xlsx, Paarweiser_Vergleich.xlsx, T-Tabelle.xlsx]
2019-12-01 Erste Hälfte Risiken
    [CE-Beurteilung.xlsx]
2019-12-02 CE-Tabelle fertig
    [CE-Beurteilung.xlsx]
2019-12-02 ischikawa neu
    [Ischikawa.xlsx]
2019-12-02 T-Tabellenzeugs eingefügt
    [CE-Beurteilung.xlsx]
2019-12-02 mitnehmer band
    [HoQ.xlsx, T-Tabelle.xlsx]
2019-12-02 an Marie: Draußennutzung eingeschränkt
    [CE-Beurteilung.xlsx]
2019-12-02 Revert "Druckfertig"
    This reverts commit 5e83266fd30f64056630cb4910c642e05f61589b.
    [CE-Beurteilung.xlsx, FMEA.xlsx, HoQ.xlsx, Paarweiser_Vergleich.xlsx, T-Tabelle.xlsx]
2019-12-02 druckhübsch gemacht
    [CE-Beurteilung.xlsx]
2019-12-02 CE druckfertig
    [CE-Beurteilung.xlsx]
2019-12-02 Datenblatt und FMEA-Erläuterungen
2019-12-02 Strukturanalyse erweitert mit Fehlern und Funktionen
2019-12-02 Final Doku
    [CE-Beurteilung.xlsx, T-Tabelle.xlsx]
